eddyem/stm32samples/F0:F030,F042,F072/usbcan_ringbuffer/kicad/stm32.kicad_pcb

## KiCad design F0:F030,F042,F072/usbcan_ringbuffer/kicad/stm32.kicad_pcb (2026-03-06)

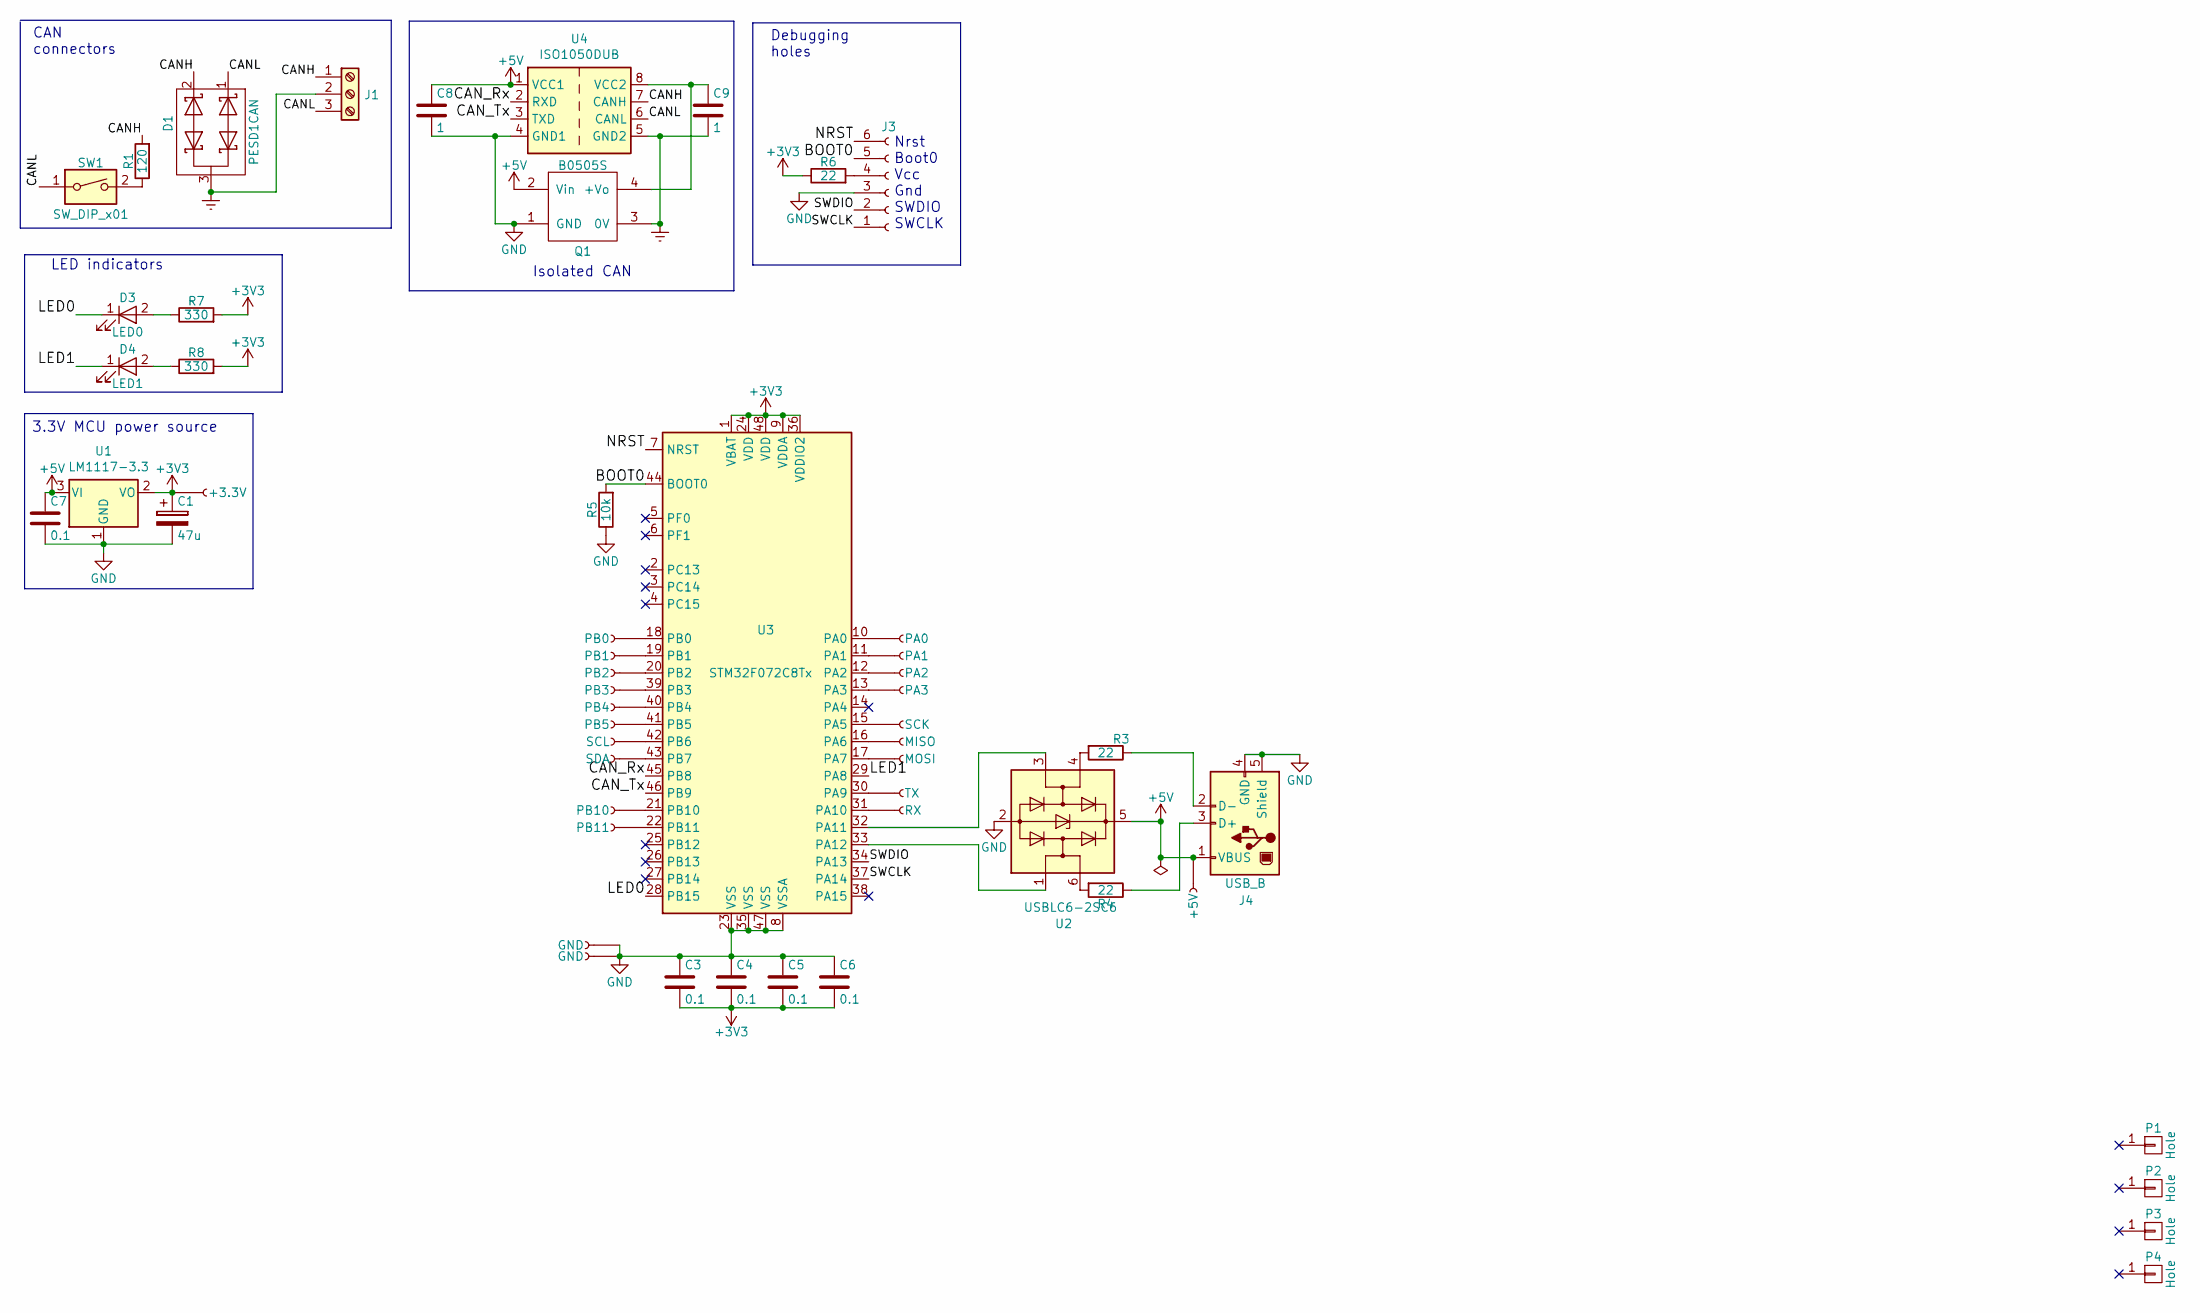
[picture p3: schematic stm32.kicad_sch, STM32F0x2 based USB<>CAN converter (isolated)]

Parts:
C1: 47u; CP_EIA-3216-18_Kemet-A_Pad1.58x1.35mm_HandSolder
C3, C4, C5, C6, C7: 0.1; C_0603_1608Metric_Pad1.05x0.95mm_HandSolder
C8, C9: 1; C_0805_2012Metric_Pad1.15x1.40mm_HandSolder
D1: PESD1CAN; SOT-23
D3: LED0; LED_0805_2012Metric_Pad1.15x1.40mm_HandSolder
D4: LED1; LED_0805_2012Metric_Pad1.15x1.40mm_HandSolder
J1: Screw_Terminal_01x03; TerminalBlock_Phoenix_MKDS-1,5-3_1x03_P5.00mm_Horizontal
J2: SCK; TestPoint_THTPad_1.5x1.5mm_Drill0.7mm
J3: SWDetc; PinHeader_1x06_P1.27mm_Vertical
J4: USB_B; USB_B_Lumberg_2411_02_Horizontal
J5: MISO; TestPoint_THTPad_1.5x1.5mm_Drill0.7mm
J6: MOSI; TestPoint_THTPad_1.5x1.5mm_Drill0.7mm
J7: TX; TestPoint_THTPad_1.5x1.5mm_Drill0.7mm
J8: RX; TestPoint_THTPad_1.5x1.5mm_Drill0.7mm
J9: SCL; TestPoint_THTPad_1.5x1.5mm_Drill0.7mm
J10: SDA; TestPoint_THTPad_1.5x1.5mm_Drill0.7mm
J11: PB0; TestPoint_THTPad_1.5x1.5mm_Drill0.7mm
J12: PB1; TestPoint_THTPad_1.5x1.5mm_Drill0.7mm
J13: PB4; TestPoint_THTPad_1.5x1.5mm_Drill0.7mm
J14: PB5; TestPoint_THTPad_1.5x1.5mm_Drill0.7mm
J15: PB2; TestPoint_THTPad_1.5x1.5mm_Drill0.7mm
J16: PB3; TestPoint_THTPad_1.5x1.5mm_Drill0.7mm
J17, J18: GND; TestPoint_THTPad_1.5x1.5mm_Drill0.7mm
J19: +3.3V; TestPoint_THTPad_1.5x1.5mm_Drill0.7mm
J20: +5V; TestPoint_THTPad_1.5x1.5mm_Drill0.7mm
J21: PA0; TestPoint_THTPad_1.0x1.0mm_Drill0.5mm
J22: PA1; TestPoint_THTPad_1.0x1.0mm_Drill0.5mm
J23: PA2; TestPoint_THTPad_1.0x1.0mm_Drill0.5mm
J24: PA3; TestPoint_THTPad_1.0x1.0mm_Drill0.5mm
J25: PB10; TestPoint_THTPad_1.5x1.5mm_Drill0.7mm
J26: PB11; TestPoint_THTPad_1.5x1.5mm_Drill0.7mm
P1, P2, P3, P4: Hole; Hole_3mm
Q1: B0505S; B0x0xS
R1: 120; R_1210_3225Metric_Pad1.42x2.65mm_HandSolder
R3, R4, R6: 22; R_0603_1608Metric_Pad1.05x0.95mm_HandSolder
R5: 10k; R_0603_1608Metric_Pad1.05x0.95mm_HandSolder
R7, R8: 330; R_0603_1608Metric_Pad1.05x0.95mm_HandSolder
SW1: SW_DIP_x01; SW_DIP_SPSTx01_Slide_6.7x4.1mm_W7.62mm_P2.54mm_LowProfile
U1: LM1117-3.3; SOT-223-3_TabPin2
U2: USBLC6-2SC6; SOT-23-6_Handsoldering
U3: STM32F072C8Tx; LQFP-48_7x7mm_P0.5mm
U4: ISO1050DUB; SOP-8_6.62x9.15mm_P2.54mm

Connections:
+3V3: C1.1, C3.2, C4.2, C5.2, C6.2, J19.1, R6.1, R7.2, R8.2, U1.2 (VO), U3.1 (VBAT), U3.9 (VDDA), U3.24 (VDD), U3.36 (VDDIO2), U3.48 (VDD)
+5V: C7.1, C8.1, J4.1 (VBUS), J20.1, Q1.2 (Vin), U1.3 (VI), U2.5 (VBUS), U4.1 (VCC1)
/BOOT0: J3.5, R5.2, U3.44 (BOOT0)
/CANH: D1.2 (K), J1.1, R1.2, U4.7 (CANH)
/CANL: D1.1 (K), J1.3, SW1.1, U4.6 (CANL)
/CAN_Rx: U3.45 (PB8), U4.2 (RXD)
/CAN_Tx: U3.46 (PB9), U4.3 (TXD)
/LED0: D3.1 (K), U3.28 (PB15)
/LED1: D4.1 (K), U3.29 (PA8)
/NRST: J3.6, U3.7 (NRST)
/SWCLK: J3.1, U3.37 (PA14)
/SWDIO: J3.2, U3.34 (PA13)
Earth: C9.2, D1.3 (O), J1.2, Q1.3 (0V), U4.5 (GND2)
GND: C1.2, C3.1, C4.1, C5.1, C6.1, C7.2, C8.2, J3.3, J4.4 (GND), J4.5 (Shield), J17.1, J18.1, Q1.1 (GND), R5.1, U1.1 (GND), U2.2 (GND), U3.8 (VSSA), U3.23 (VSS), U3.35 (VSS), U3.47 (VSS), U4.4 (GND1)
unnamed: C9.1, Q1.4 (+Vo), U4.8 (VCC2)
unnamed: D3.2 (A), R7.1
unnamed: D4.2 (A), R8.1
unnamed: J2.1, U3.15 (PA5)
unnamed: J3.4, R6.2
unnamed: J4.2 (D-), R3.1
unnamed: J4.3 (D+), R4.1
unnamed: J5.1, U3.16 (PA6)
unnamed: J6.1, U3.17 (PA7)
unnamed: J7.1, U3.30 (PA9)
unnamed: J8.1, U3.31 (PA10)
unnamed: J9.1, U3.42 (PB6)
unnamed: J10.1, U3.43 (PB7)
unnamed: J11.1, U3.18 (PB0)
unnamed: J12.1, U3.19 (PB1)
unnamed: J13.1, U3.40 (PB4)
unnamed: J14.1, U3.41 (PB5)
unnamed: J15.1, U3.20 (PB2)
unnamed: J16.1, U3.39 (PB3)
unnamed: J21.1, U3.10 (PA0)
unnamed: J22.1, U3.11 (PA1)
unnamed: J23.1, U3.12 (PA2)
unnamed: J24.1, U3.13 (PA3)
unnamed: J25.1, U3.21 (PB10)
unnamed: J26.1, U3.22 (PB11)
unnamed: R1.1, SW1.2
unnamed: R3.2, U2.4 (I/O2)
unnamed: R4.2, U2.6 (I/O1)
unnamed: U2.1 (I/O1), U3.33 (PA12)
unnamed: U2.3 (I/O2), U3.32 (PA11)

Notes on the sheet:
LED indicators
Isolated CAN
Debugging holes
3.3V MCU power source
Nrst Boot0 Vcc Gnd SWDIO SWCLK
CAN connectors

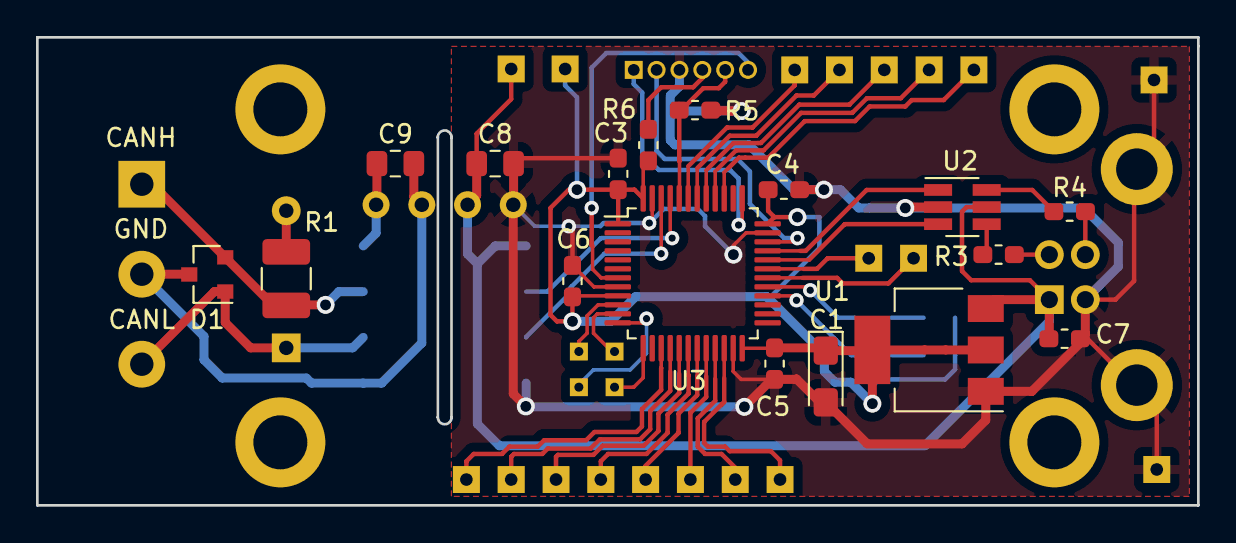
[picture p4: board F0:F030,F042,F072/usbcan_ringbuffer/kicad/stm32.kicad_pcb from above]

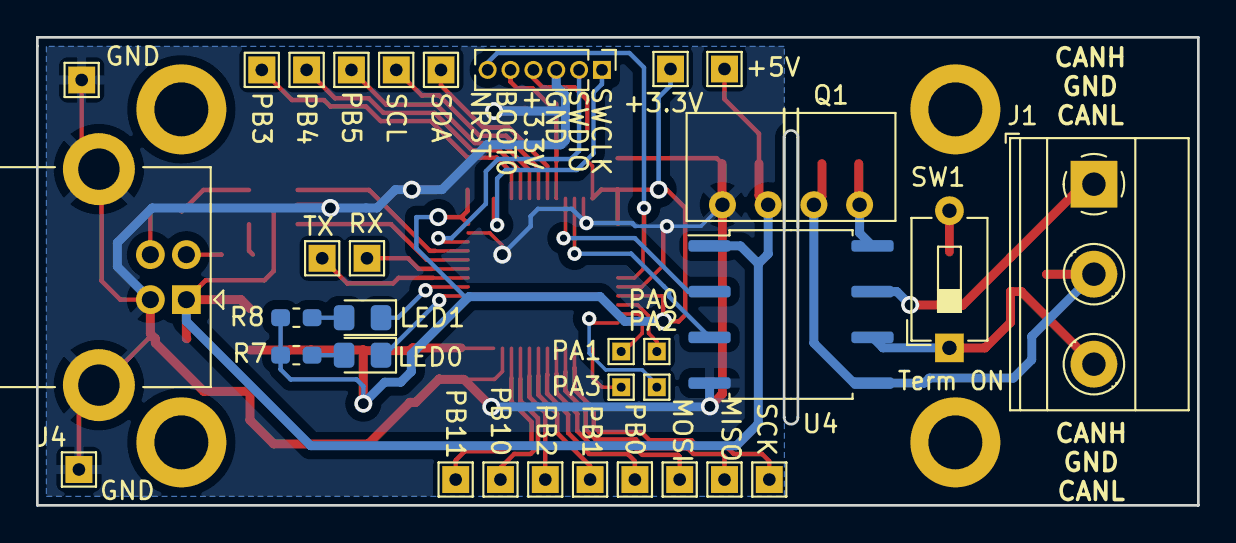
[picture p5: board F0:F030,F042,F072/usbcan_ringbuffer/kicad/stm32.kicad_pcb from below]

Board: 2 copper layers, 64.5 x 26.0 mm, 54 parts (33 on the bottom side), 44 nets.
