eddyem/stm32samples/F3:F303/MLX90640-allsky/kicad/mainboard.kicad_pcb

## KiCad design F3:F303/MLX90640-allsky/kicad/mainboard.kicad_pcb (2025-11-13)

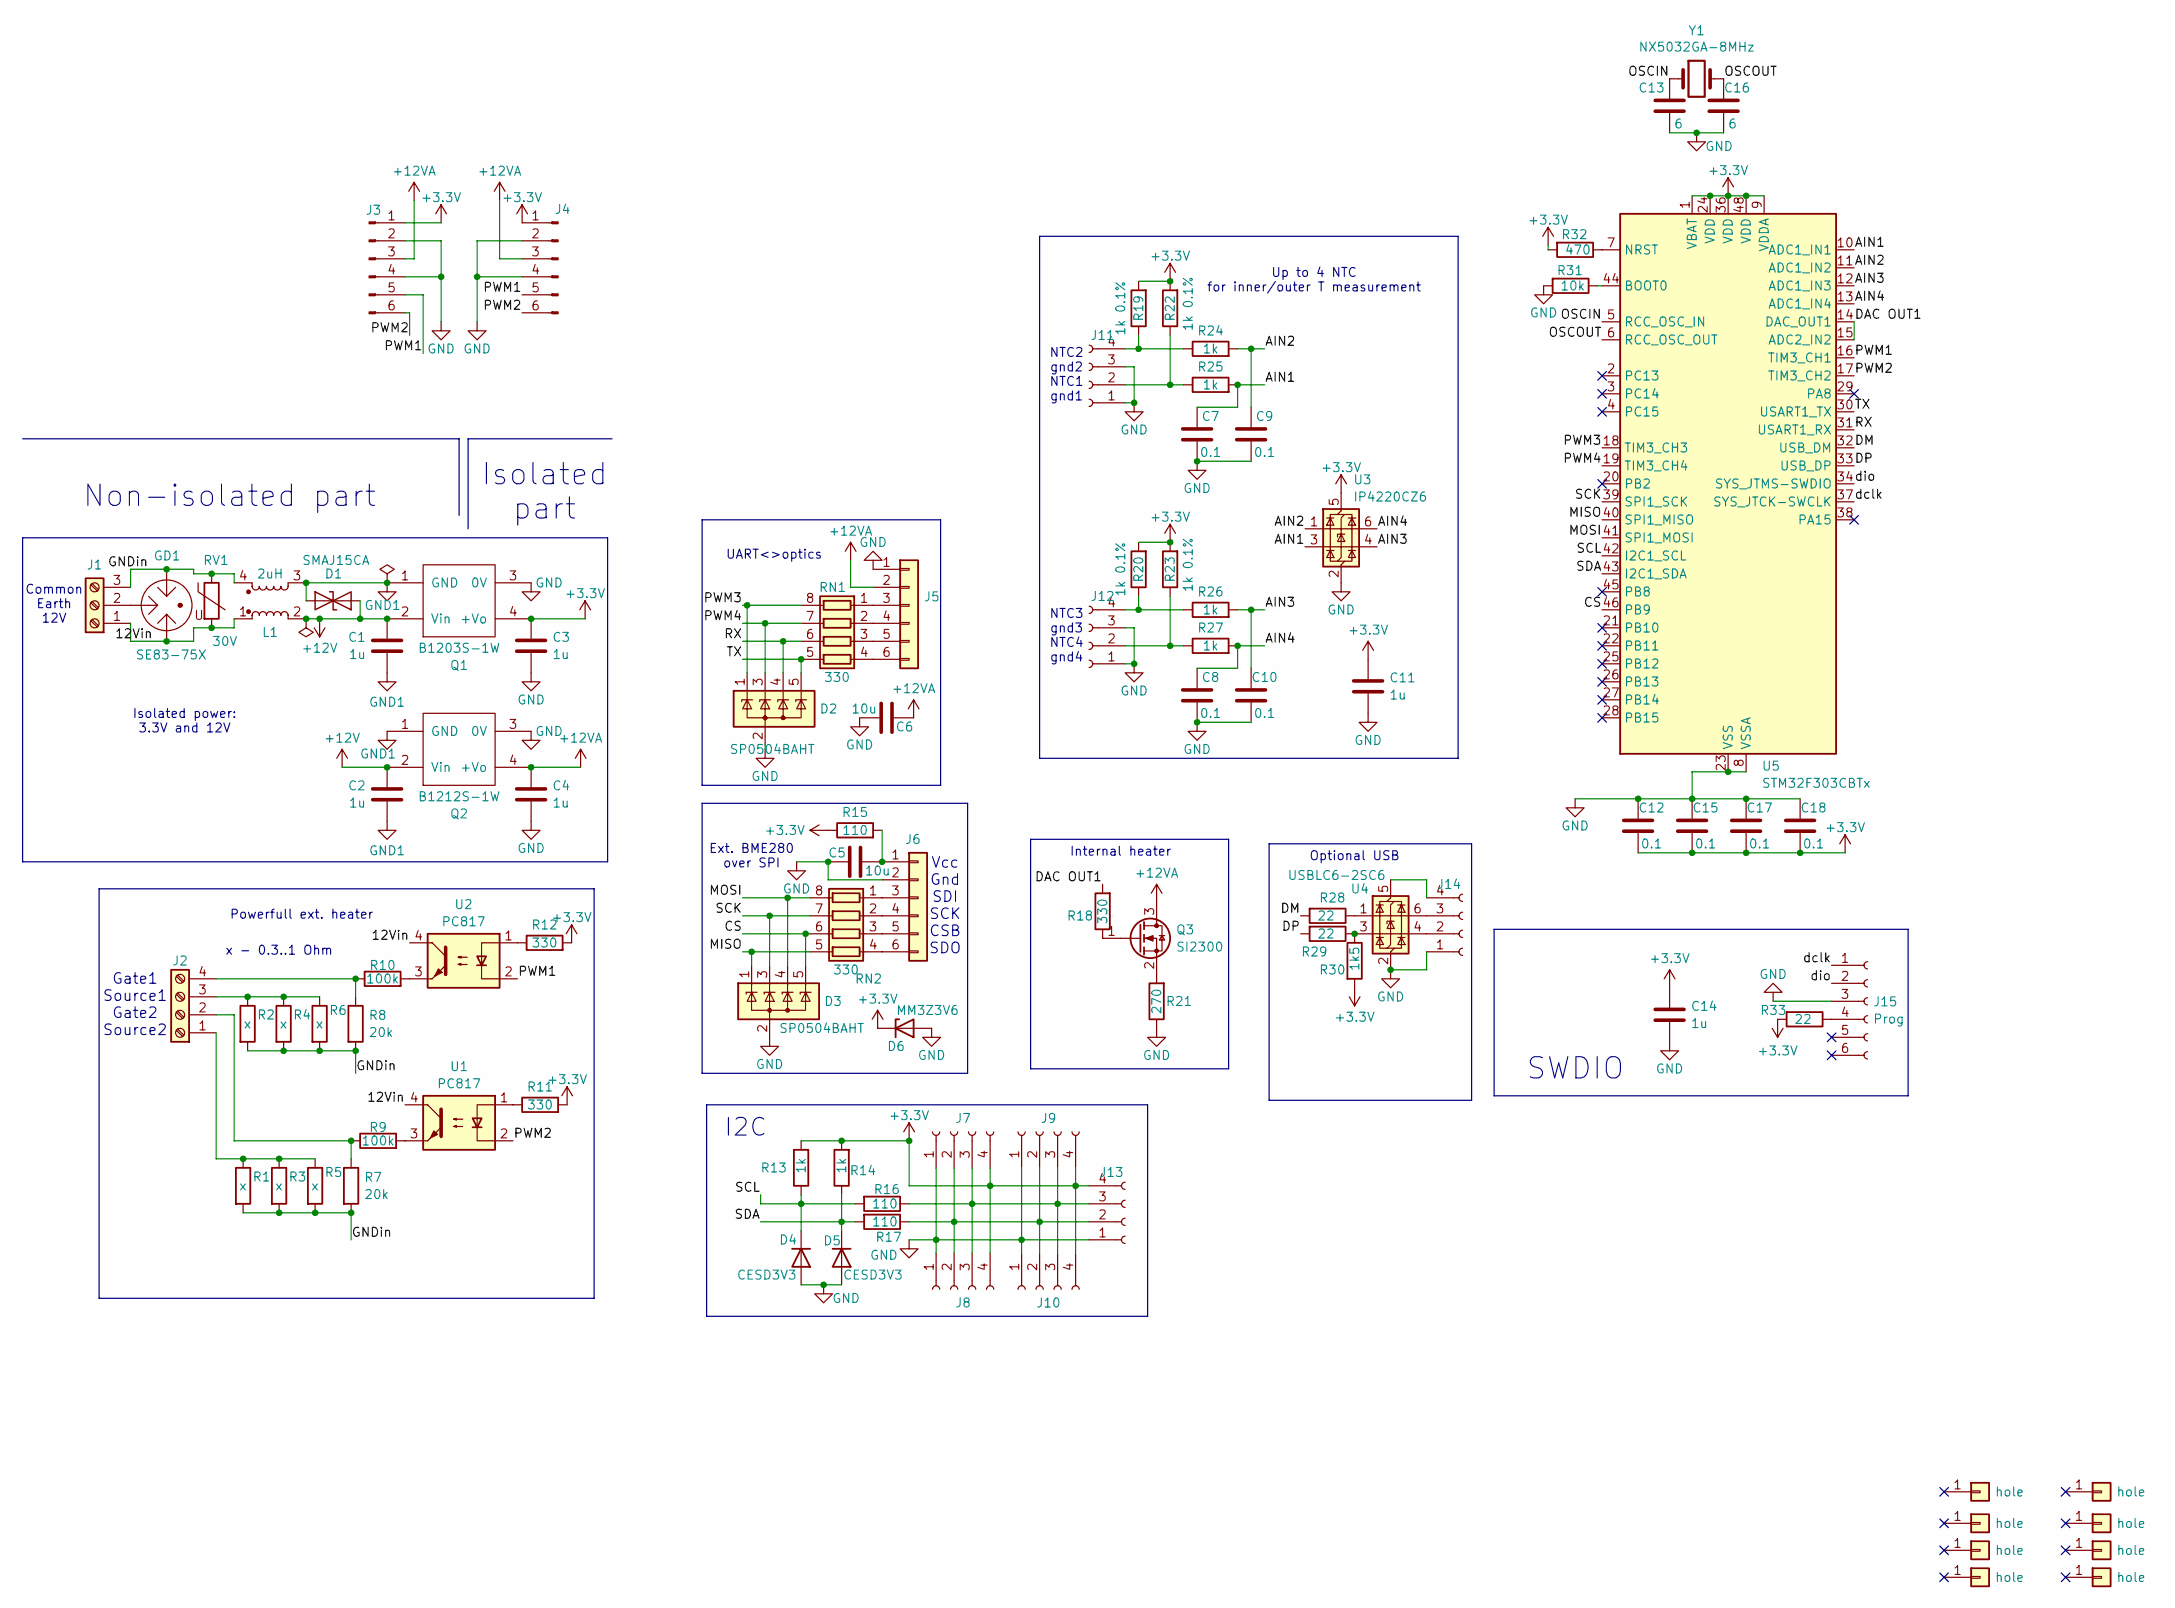
[picture p6: schematic mainboard.kicad_sch]

Parts:
C1, C2, C3, C4, C11, C14: 1u; C_0805_2012Metric_Pad1.18x1.45mm_HandSolder
C5, C6: 10u; C_0805_2012Metric_Pad1.18x1.45mm_HandSolder
C7, C8, C9, C10, C12, C15, C17, C18: 0.1; C_0603_1608Metric_Pad1.08x0.95mm_HandSolder
C13, C16: 6; C_0603_1608Metric_Pad1.08x0.95mm_HandSolder
D1: SMAJ15CA; D_SMA
D2, D3: SP0504BAHT; SOT-23-5
D4, D5: CESD3V3; D_0805_2012Metric_Pad1.15x1.40mm_HandSolder
D6: MM3Z3V6; D_SOD-323F
GD1: SE83-75X; SE83-GDS
J1: Conn_01x03_Pin; TerminalBlock_Phoenix_MKDS-1,5-3_1x03_P5.00mm_Horizontal
J2: Conn_01x03_Pin; TerminalBlock_Phoenix_MKDS-1,5-4_1x04_P5.00mm_Horizontal
J3: Conn_01x04_Pin; PinHeader_1x06_P2.54mm_Vertical
J4: Conn_01x04_Socket; PinHeader_1x06_P2.54mm_Vertical
J5, J6: JST_PH_B6B-PH-K_1x06_P2.00mm_Vertical
J7, J8, J9, J10, J11, J12, J13, J14: Conn_01x04_Socket; JST_PH_B4B-PH-K_1x04_P2.00mm_Vertical
J15: Prog; PinSocket_1x06_P1.27mm_Vertical
J16, J17, J18, J19, J20, J21, J22, J23: hole; MountingHole_3.2mm_M3_ISO14580_Pad_TopBottom
L1: 2uH; L_CommonMode_Wuerth_WE-CMB-S
Q1: B1203S-1W; B0x0xS
Q2: B1212S-1W; B0x0xS
Q3: SI2300; SOT-23_Handsoldering
R1, R2, R3, R4, R5, R6: x; R_2010_5025Metric_Pad1.40x2.65mm_HandSolder
R7, R8: 20k; R_0805_2012Metric_Pad1.20x1.40mm_HandSolder
R9, R10: 100k; R_0805_2012Metric_Pad1.20x1.40mm_HandSolder
R11, R12, R18: 330; R_0603_1608Metric_Pad0.98x0.95mm_HandSolder
R13, R14, R24, R25, R26, R27: 1k; R_0603_1608Metric_Pad0.98x0.95mm_HandSolder
R15, R16, R17: 110; R_0603_1608Metric_Pad0.98x0.95mm_HandSolder
R19, R20, R22, R23: 1k 0.1%; R_0805_2012Metric_Pad1.20x1.40mm_HandSolder
R21: 270; R_0603_1608Metric_Pad0.98x0.95mm_HandSolder
R28, R29, R33: 22; R_0603_1608Metric_Pad0.98x0.95mm_HandSolder
R30: 1k5; R_0603_1608Metric_Pad0.98x0.95mm_HandSolder
R31: 10k; R_0603_1608Metric_Pad0.98x0.95mm_HandSolder
R32: 470; R_0603_1608Metric_Pad0.98x0.95mm_HandSolder
RN1, RN2: 330; R_Array_Convex_4x0603
RV1: 30V; S10K30
U1, U2: PC817; DIP-4_W7.62mm
U3: IP4220CZ6; SOT-23-6
U4: USBLC6-2SC6; SOT-23-6
U5: STM32F303CBTx; LQFP-48_7x7mm_P0.5mm
Y1: NX5032GA-8MHz; Crystal_SMD_5032-2Pin_5.0x3.2mm

Connections:
+3.3V: C3.1, C11.1, C12.1, C14.1, C15.1, C17.1, C18.1, D6.1 (K), J3.1, J4.1, J7.4, J8.4, J9.4, J10.4, J13.4, Q1.4 (+Vo), R11.2, R12.2, R13.2, R14.2, R15.1, R19.2, R20.2, R22.2, R23.2, R30.2, R32.2, R33.2, U3.5 (VBUS), U5.1 (VBAT), U5.9 (VDDA), U5.24 (VDD), U5.36 (VDD), U5.48 (VDD)
+12V: C1.1, C2.1, D1.1 (A1), L1.2, Q1.2 (Vin), Q2.2 (Vin)
+12VA: C4.1, C6.1, J3.3, J4.3, J5.2, Q2.4 (+Vo), Q3.3 (D)
/12Vin: GD1.1, J1.1, L1.1, RV1.2, U1.4, U2.4
/AIN1: C7.2, R25.2, U3.3 (I/O2), U5.10 (ADC1_IN1)
/AIN2: C9.2, R24.2, U3.1 (I/O1), U5.11 (ADC1_IN2)
/AIN3: C10.2, R26.2, U3.4 (I/O2), U5.12 (ADC1_IN3)
/AIN4: C8.2, R27.2, U3.6 (I/O1), U5.13 (ADC1_IN4)
/CS: D3.5 (K), RN2.6 (R3.2), U5.46 (PB9)
/DAC OUT1: R18.2, U5.14 (DAC_OUT1), U5.15 (ADC2_IN2)
/DM: R28.2, U5.32 (USB_DM)
/DP: R29.2, U5.33 (USB_DP)
/GNDin: GD1.3, J1.3, L1.4, R1.2, R2.2, R3.2, R4.2, R5.2, R6.2, R7.2, R8.2, RV1.1
/MISO: D3.1 (K), RN2.5 (R4.2), U5.40 (SPI1_MISO)
/MOSI: D3.4 (K), RN2.8 (R1.2), U5.41 (SPI1_MOSI)
/OSCIN: C13.1, U5.5 (RCC_OSC_IN), Y1.1
/OSCOUT: C16.1, U5.6 (RCC_OSC_OUT), Y1.2
/PWM1: J3.5, J4.5, U2.2, U5.16 (TIM3_CH1)
/PWM2: J3.6, J4.6, U1.2, U5.17 (TIM3_CH2)
/PWM3: D2.1 (K), RN1.8 (R1.2), U5.18 (TIM3_CH3)
/PWM4: D2.3 (K), RN1.7 (R2.2), U5.19 (TIM3_CH4)
/RX: D2.4 (K), RN1.6 (R3.2), U5.31 (USART1_RX)
/SCK: D3.3 (K), RN2.7 (R2.2), U5.39 (SPI1_SCK)
/SCL: D4.1 (K), R13.1, R16.2, U5.42 (I2C1_SCL)
/SDA: D5.1 (K), R14.1, R17.2, U5.43 (I2C1_SDA)
/TX: D2.5 (K), RN1.5 (R4.2), U5.30 (USART1_TX)
/dclk: J15.1, U5.37 (SYS_JTCK-SWCLK)
/dio: J15.2, U5.34 (SYS_JTMS-SWDIO)
GND: C3.2, C4.2, C5.1, C6.2, C7.1, C8.1, C9.1, C10.1, C11.2, C12.2, C13.2, C14.2, C15.2, C16.2, C17.2, C18.2, D2.2 (A), D3.2 (A), D4.2 (A), D5.2 (A), D6.2 (A), J3.2, J3.4, J4.2, J4.4, J5.1, J6.2, J7.1, J8.1, J9.1, J10.1, J11.1, J11.3, J12.1, J12.3, J13.1, J14.1, J15.3, Q1.3 (0V), Q2.3 (0V), R21.1, R31.2, U3.2 (GND), U4.2 (GND), U5.8 (VSSA), U5.23 (VSS), U5.35 (VSS), U5.47 (VSS)
GND1: C1.2, C2.2, D1.2 (A2), L1.3, Q1.1 (GND), Q2.1 (GND)
unnamed: GD1.2, J1.2
unnamed: J2.1, R1.1, R3.1, R5.1
unnamed: J2.2, R7.1, R9.1
unnamed: J2.3, R2.1, R4.1, R6.1
unnamed: J2.4, R8.1, R10.1
unnamed: J5.3, RN1.1 (R1.1)
unnamed: J5.4, RN1.2 (R2.1)
unnamed: J5.5, RN1.3 (R3.1)
unnamed: J5.6, RN1.4 (R4.1)
unnamed: C5.2, J6.1, R15.2
unnamed: J6.3, RN2.1 (R1.1)
unnamed: J6.4, RN2.2 (R2.1)
unnamed: J6.5, RN2.3 (R3.1)
unnamed: J6.6, RN2.4 (R4.1)
unnamed: J7.2, J8.2, J9.2, J10.2, J13.2, R17.1
unnamed: J7.3, J8.3, J9.3, J10.3, J13.3, R16.1
unnamed: J11.2, R22.1, R25.1
unnamed: J11.4, R19.1, R24.1
unnamed: J12.2, R23.1, R27.1
unnamed: J12.4, R20.1, R26.1
unnamed: J14.2, U4.4 (I/O2)
unnamed: J14.3, U4.6 (I/O1)
unnamed: J14.4, U4.5 (VBUS)
unnamed: J15.4, R33.1
unnamed: Q3.1 (G), R18.1
unnamed: Q3.2 (S), R21.2
unnamed: R9.2, U1.3
unnamed: R10.2, U2.3
unnamed: R11.1, U1.1
unnamed: R12.1, U2.1
unnamed: R28.1, U4.1 (I/O1)
unnamed: R29.1, R30.1, U4.3 (I/O2)
unnamed: R31.1, U5.44 (BOOT0)
unnamed: R32.1, U5.7 (NRST)

Notes on the sheet:
Isolated power: 3.3V and 12V
x - 0.3..1 Ohm
NTC2 gnd2 NTC1 gnd1
Ext. BME280 over SPI
Powerfull ext. heater
Optional USB
Up to 4 NTC for inner/outer T measurement
Isolated part
I2C
Non-isolated part
Internal heater
Common Earth 12V
NTC3 gnd3 NTC4 gnd4
SWDIO
UART<>optics
Gate1 Source1 Gate2 Source2
Vcc Gnd SDI SCK CSB SDO

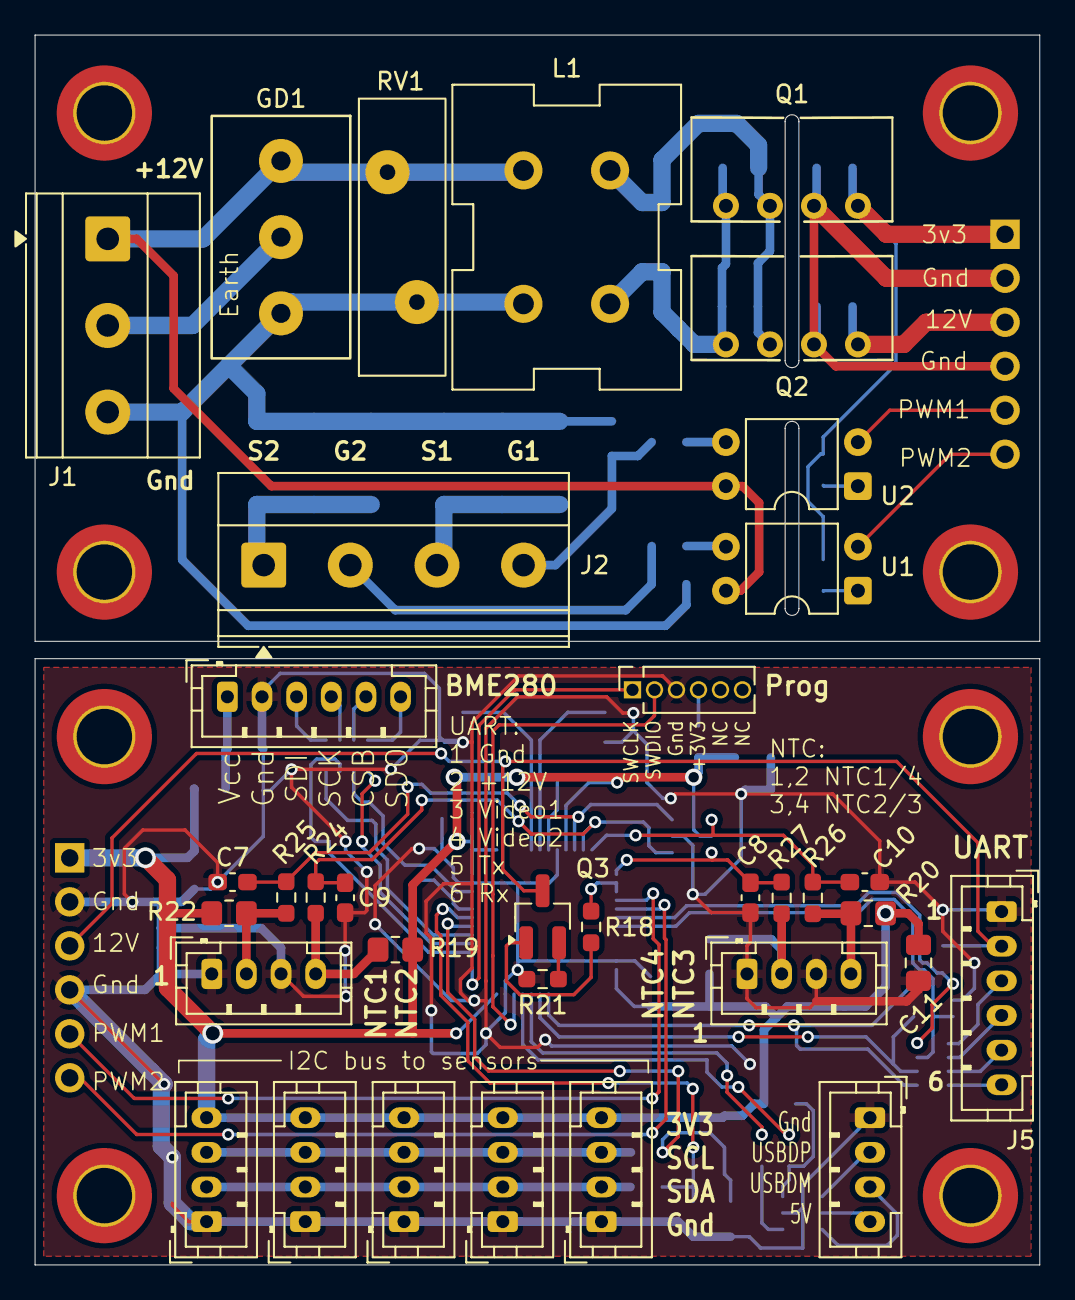
[picture p7: board mainboard.kicad_pcb from above]

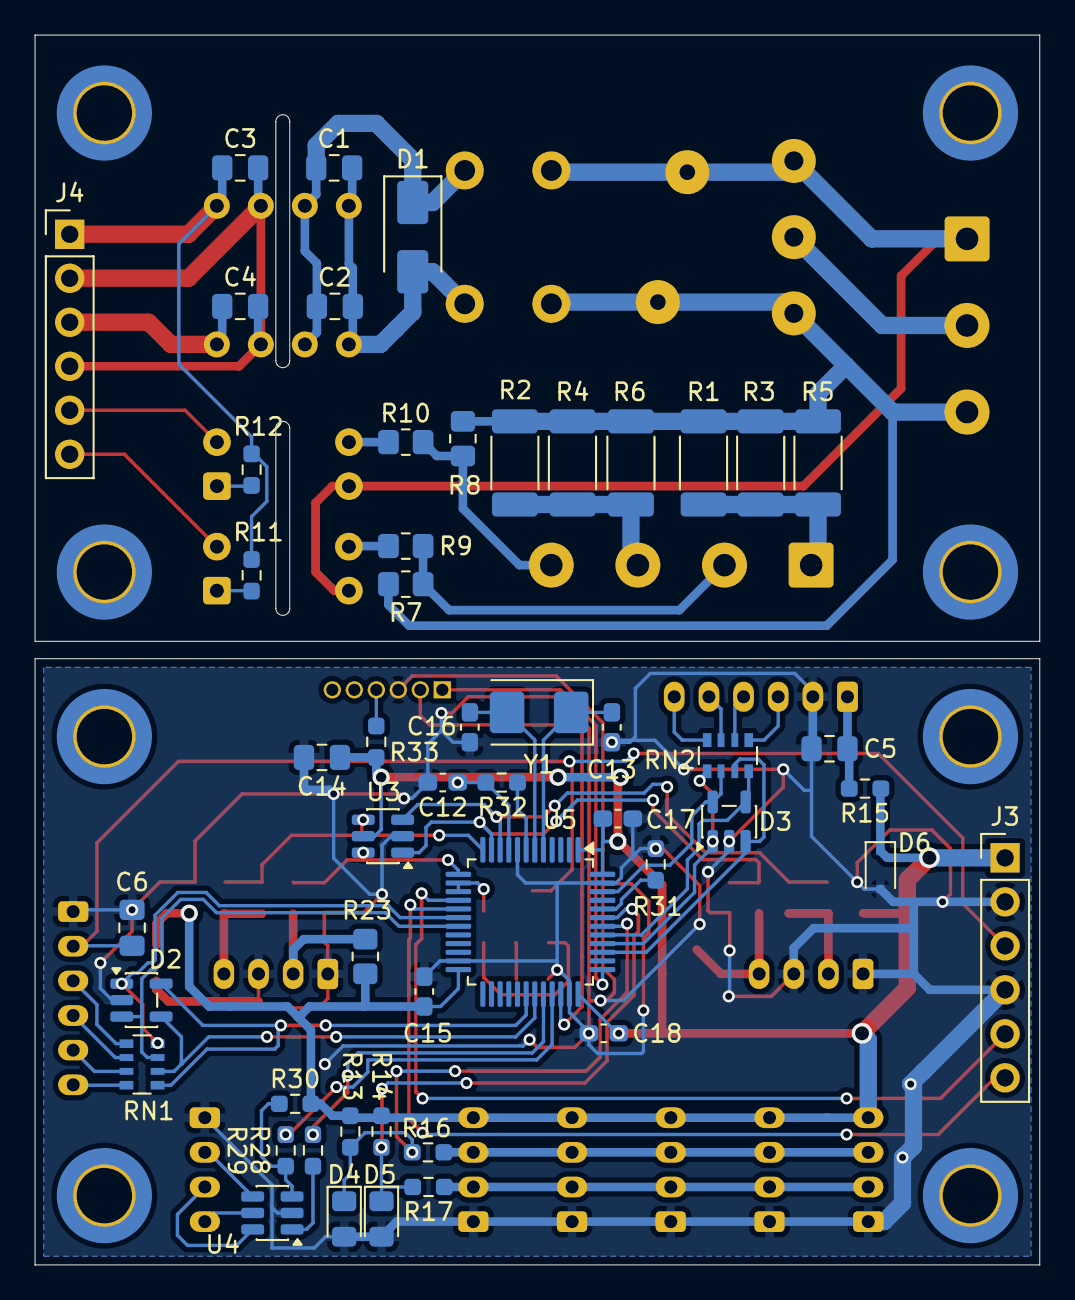
[picture p8: board mainboard.kicad_pcb from below]

Board: 2 copper layers, 58.0 x 71.0 mm, 94 parts (51 on the bottom side), 64 nets.
