eddyem/stm32samples/F1:F103/BISS_C_encoders/kicad/encoder.kicad_pcb

## KiCad design F1:F103/BISS_C_encoders/kicad/encoder.kicad_pcb (2025-04-04)

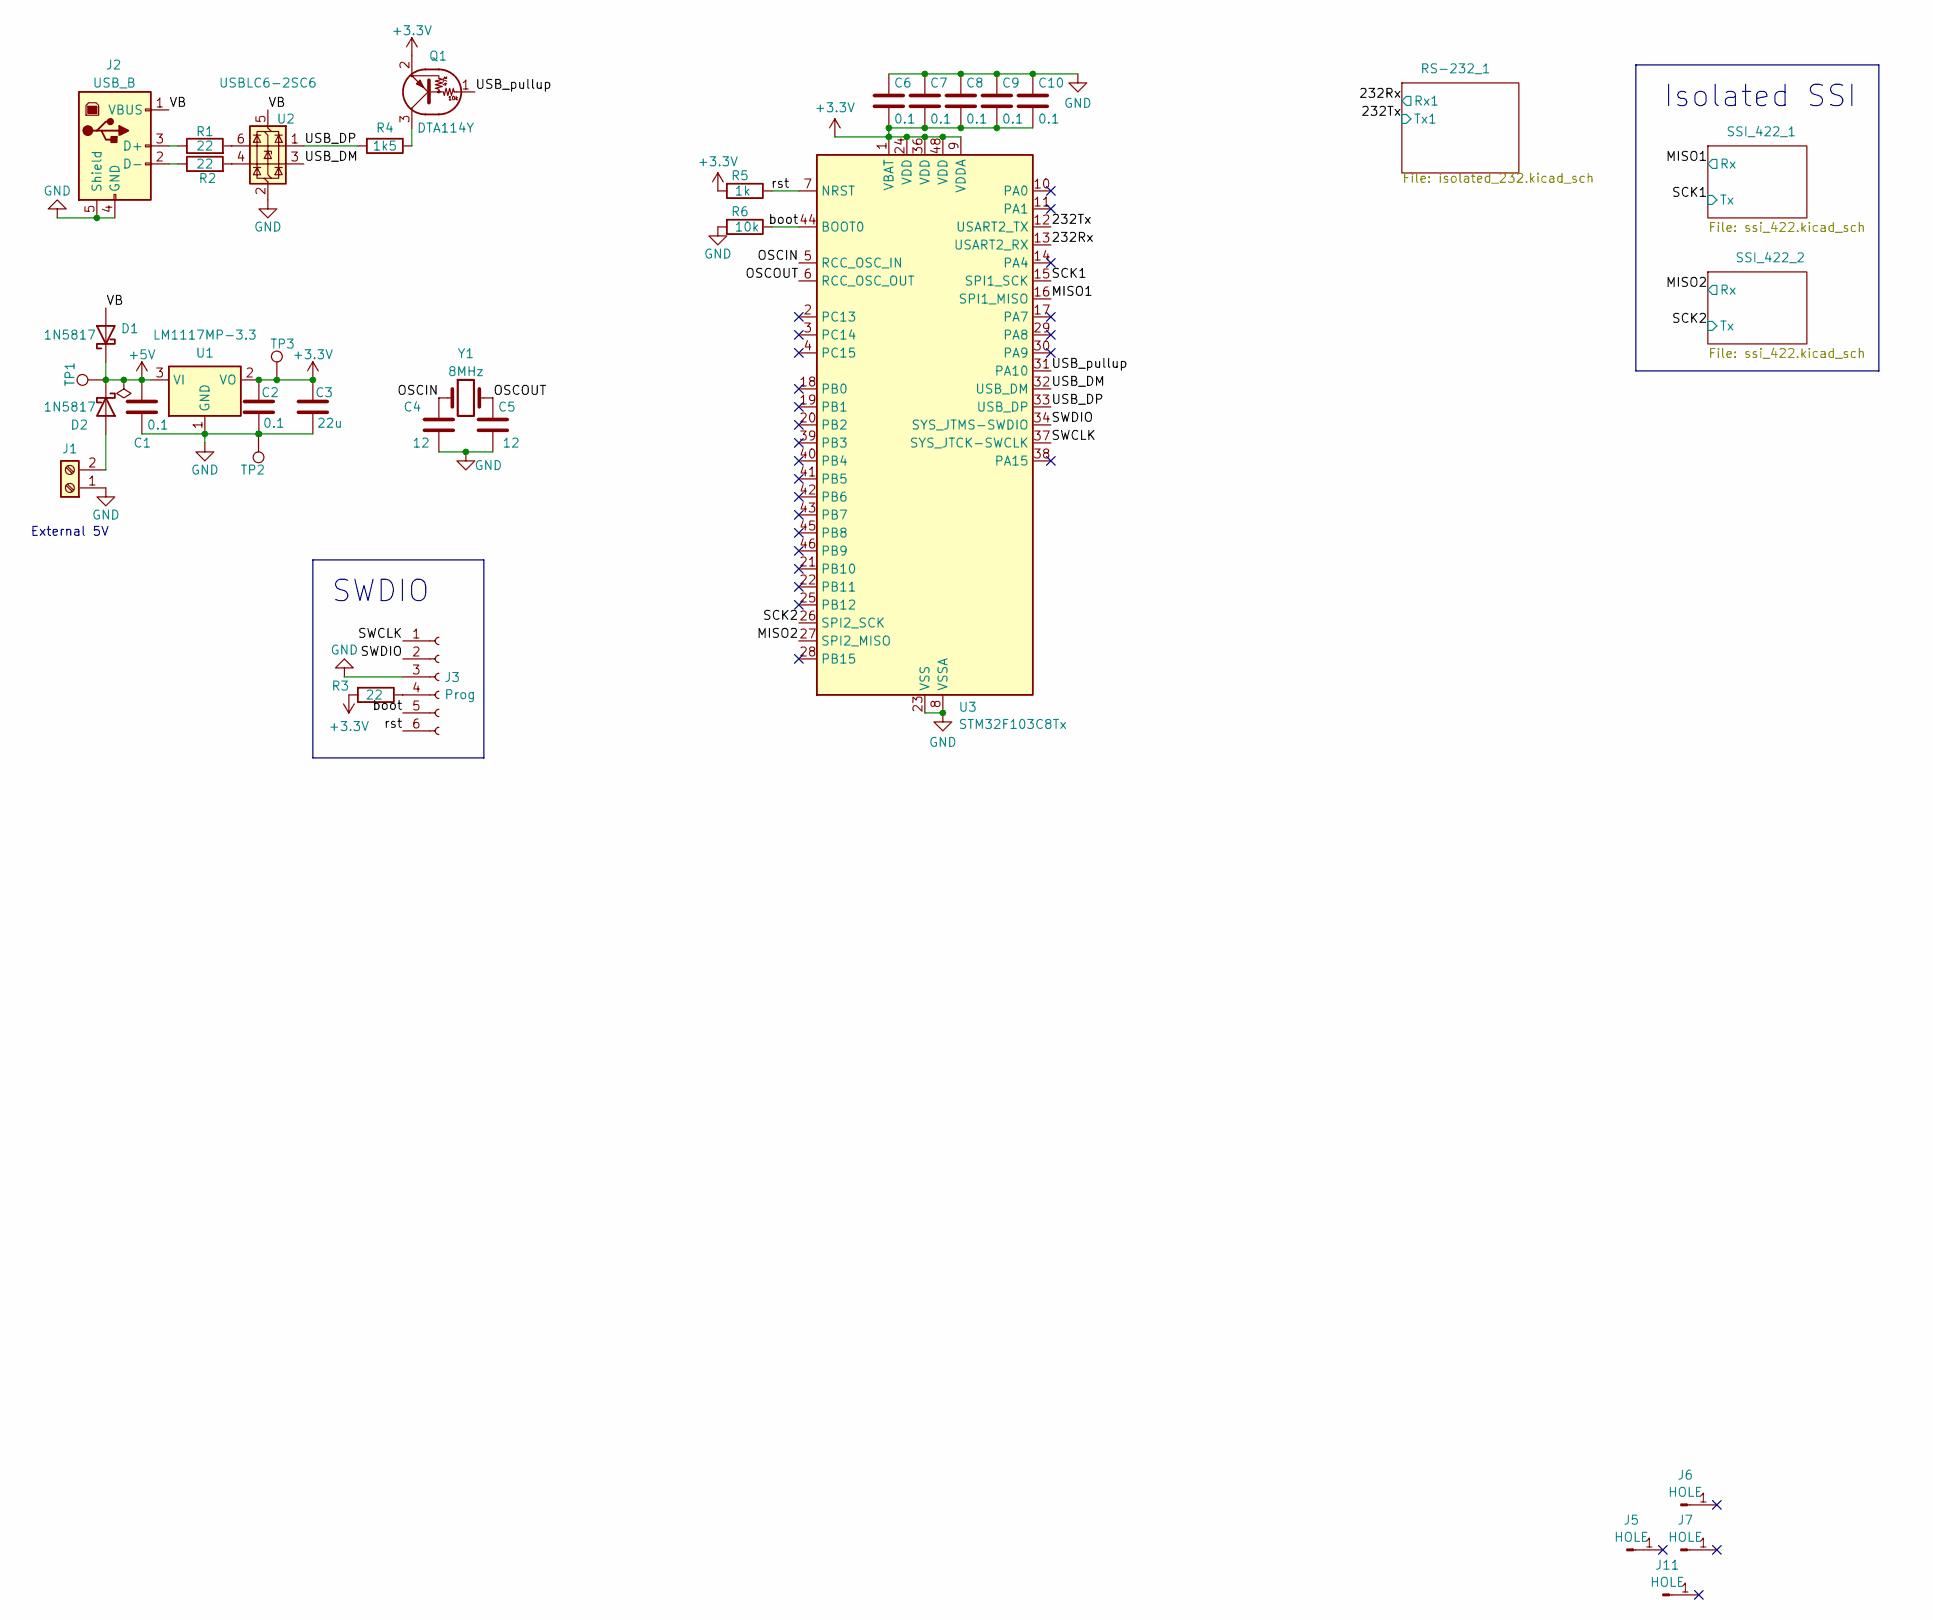
[picture p9: schematic encoder.kicad_sch]

Parts:
C1, C2, C6, C7, C8, C9, C10: 0.1; C_0603_1608Metric_Pad1.08x0.95mm_HandSolder
C3: 22u; C_0805_2012Metric_Pad1.18x1.45mm_HandSolder
C4, C5: 12; C_0603_1608Metric_Pad1.08x0.95mm_HandSolder
D1, D2: 1N5817; D_SMA-SMB_Universal_Handsoldering
J1: Screw_Terminal_01x02; TerminalBlock_Phoenix_MKDS-1,5-2_1x02_P5.00mm_Horizontal
J2: USB_B; USB_B_OST_USB-B1HSxx_Horizontal
J3: Prog; PinSocket_1x06_P1.27mm_Vertical
J5, J6, J7, J11: HOLE; MountingHole_3.2mm_M3
Q1: DTA114Y; SOT-323_SC-70_Handsoldering
R1, R2, R3: 22; R_0603_1608Metric_Pad0.98x0.95mm_HandSolder
R4: 1k5; R_0603_1608Metric_Pad0.98x0.95mm_HandSolder
R5: 1k; R_0603_1608Metric_Pad0.98x0.95mm_HandSolder
R6: 10k; R_0603_1608Metric_Pad0.98x0.95mm_HandSolder
TP1, TP2, TP3: 3.3V; TestPoint_Loop_D2.54mm_Drill1.5mm_Beaded
U1: LM1117MP-3.3; SOT-223-3_TabPin2
U2: USBLC6-2SC6; SOT-23-6
U3: STM32F103C8Tx; LQFP-48_7x7mm_P0.5mm
Y1: 8MHz; Crystal_HC49-U_Vertical

Connections:
+3.3V: C2.1, C3.1, C6.2, C7.2, C8.2, C9.2, C10.2, Q1.2 (E), R3.2, R5.2, TP3.1, U1.2 (VO), U3.1 (VBAT), U3.9 (VDDA), U3.24 (VDD), U3.36 (VDD), U3.48 (VDD)
+5V: C1.1, D1.1 (K), D2.1 (K), TP1.1, U1.3 (VI); also elsewhere on the board
/232Rx: U3.13 (USART2_RX); also elsewhere on the board
/232Tx: U3.12 (USART2_TX); also elsewhere on the board
/MISO1: U3.16 (SPI1_MISO); also elsewhere on the board
/MISO2: U3.27 (SPI2_MISO); also elsewhere on the board
/OSCIN: C4.1, U3.5 (RCC_OSC_IN), Y1.1
/OSCOUT: C5.1, U3.6 (RCC_OSC_OUT), Y1.2
/SCK1: U3.15 (SPI1_SCK); also elsewhere on the board
/SCK2: U3.26 (SPI2_SCK); also elsewhere on the board
/SWCLK: J3.1, U3.37 (SYS_JTCK-SWCLK)
/SWDIO: J3.2, U3.34 (SYS_JTMS-SWDIO)
/USB_DM: U2.3 (I/O2), U3.32 (USB_DM)
/USB_DP: R4.2, U2.1 (I/O1), U3.33 (USB_DP)
/USB_pullup: Q1.1 (B), U3.31 (PA10)
/VB: D1.2 (A), J2.1 (VBUS), U2.5 (VBUS)
/boot: J3.5, R6.1, U3.44 (BOOT0)
/rst: J3.6, R5.1, U3.7 (NRST)
GND: C1.2, C2.2, C3.2, C4.2, C5.2, C6.1, C7.1, C8.1, C9.1, C10.1, J1.1, J2.4 (GND), J2.5 (Shield), J3.3, R6.2, TP2.1, U1.1 (GND), U2.2 (GND), U3.8 (VSSA), U3.23 (VSS), U3.35 (VSS), U3.47 (VSS); also elsewhere on the board
unnamed: D2.2 (A), J1.2
unnamed: J2.3 (D+), R1.1
unnamed: J2.2 (D-), R2.1
unnamed: J3.4, R3.1
unnamed: Q1.3 (C), R4.1
unnamed: R1.2, U2.6 (I/O1)
unnamed: R2.2, U2.4 (I/O2)

Notes on the sheet:
SWDIO
Isolated SSI
External 5V

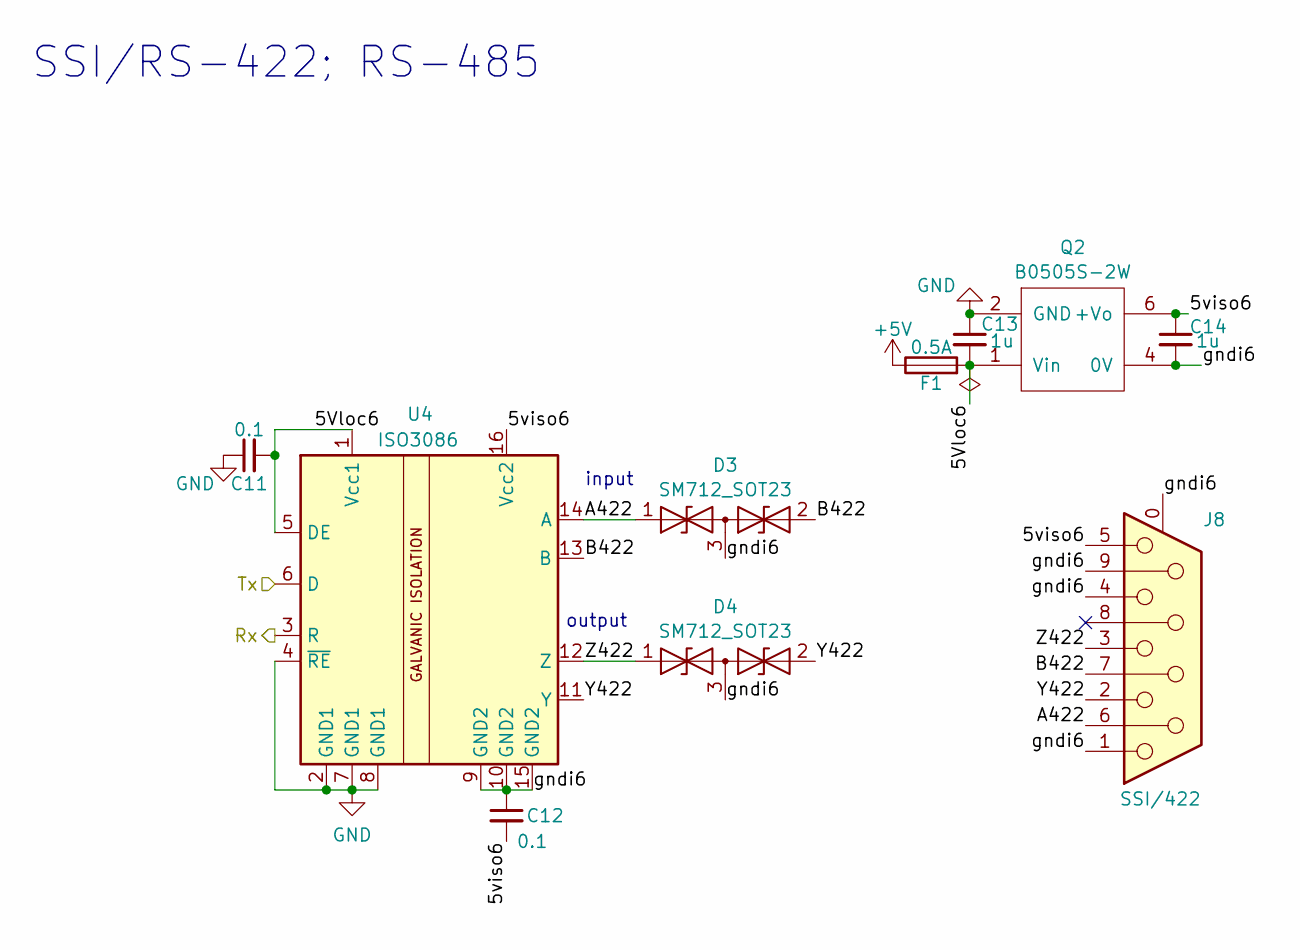
[picture p10: schematic ssi_422.kicad_sch]

Parts:
C11, C12: 0.1; C_0603_1608Metric_Pad1.08x0.95mm_HandSolder
C13, C14: 1u; C_0805_2012Metric_Pad1.18x1.45mm_HandSolder
D3, D4: SM712_SOT23; SOT-23
F1: 0.5A; Fuse_1206_3216Metric
J8: SSI/422; DSUB-9_Female_Horizontal_P2.77x2.84mm_EdgePinOffset4.94mm_H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
Q2: B0505S-2W
U4: ISO3086; SOIC-16W_7.5x10.3mm_P1.27mm

Connections:
+5V: F1.1; also elsewhere on the board
/MISO2: U4.3 (R); also elsewhere on the board
/SCK2: U4.6 (D); also elsewhere on the board
/SSI_422_2/5Vloc6: C11.2, C13.2, F1.2, Q2.1 (Vin), U4.1 (Vcc1), U4.5 (DE)
/SSI_422_2/5viso6: C12.2, C14.1, J8.5, Q2.6 (+Vo), U4.16 (Vcc2)
/SSI_422_2/A422: D3.1 (A1), J8.6, U4.14 (A)
/SSI_422_2/B422: D3.2 (A2), J8.7, U4.13 (B)
/SSI_422_2/Y422: D4.2 (A2), J8.2, U4.11 (Y)
/SSI_422_2/Z422: D4.1 (A1), J8.3, U4.12 (Z)
/SSI_422_2/gndi6: C12.1, C14.2, D3.3 (common), D4.3 (common), J8.0 (PAD), J8.1, J8.4, J8.9, Q2.4 (0V), U4.9 (GND2), U4.10 (GND2), U4.15 (GND2)
GND: C11.1, C13.1, Q2.2 (GND), U4.2 (GND1), U4.4 (~RE), U4.7 (GND1), U4.8 (GND1); also elsewhere on the board

Parts of its further copies:
C20, C21: 0.1; C_0603_1608Metric_Pad1.08x0.95mm_HandSolder
C22, C23: 1u; C_0805_2012Metric_Pad1.18x1.45mm_HandSolder
D8, D9: SM712_SOT23; SOT-23
F2: 0.5A; Fuse_1206_3216Metric
J10: SSI/422; DSUB-9_Female_Horizontal_P2.77x2.84mm_EdgePinOffset4.94mm_H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
Q3: B0505S-2W
U6: ISO3086; SOIC-16W_7.5x10.3mm_P1.27mm

Connections of its further copies:
+5V: F2.1; also elsewhere on the board
/MISO1: U6.3 (R); also elsewhere on the board
/SCK1: U6.6 (D); also elsewhere on the board
/SSI_422_1/5Vloc6: C20.2, C22.2, F2.2, Q3.1 (Vin), U6.1 (Vcc1), U6.5 (DE)
/SSI_422_1/5viso6: C21.2, C23.1, J10.5, Q3.6 (+Vo), U6.16 (Vcc2)
/SSI_422_1/A422: D8.1 (A1), J10.6, U6.14 (A)
/SSI_422_1/B422: D8.2 (A2), J10.7, U6.13 (B)
/SSI_422_1/Y422: D9.2 (A2), J10.2, U6.11 (Y)
/SSI_422_1/Z422: D9.1 (A1), J10.3, U6.12 (Z)
/SSI_422_1/gndi6: C21.1, C23.2, D8.3 (common), D9.3 (common), J10.0 (PAD), J10.1, J10.4, J10.9, Q3.4 (0V), U6.9 (GND2), U6.10 (GND2), U6.15 (GND2)
GND: C20.1, C22.1, Q3.2 (GND), U6.2 (GND1), U6.4 (~RE), U6.7 (GND1), U6.8 (GND1); also elsewhere on the board

Notes on the sheet:
SSI/RS-422; RS-485
input
output

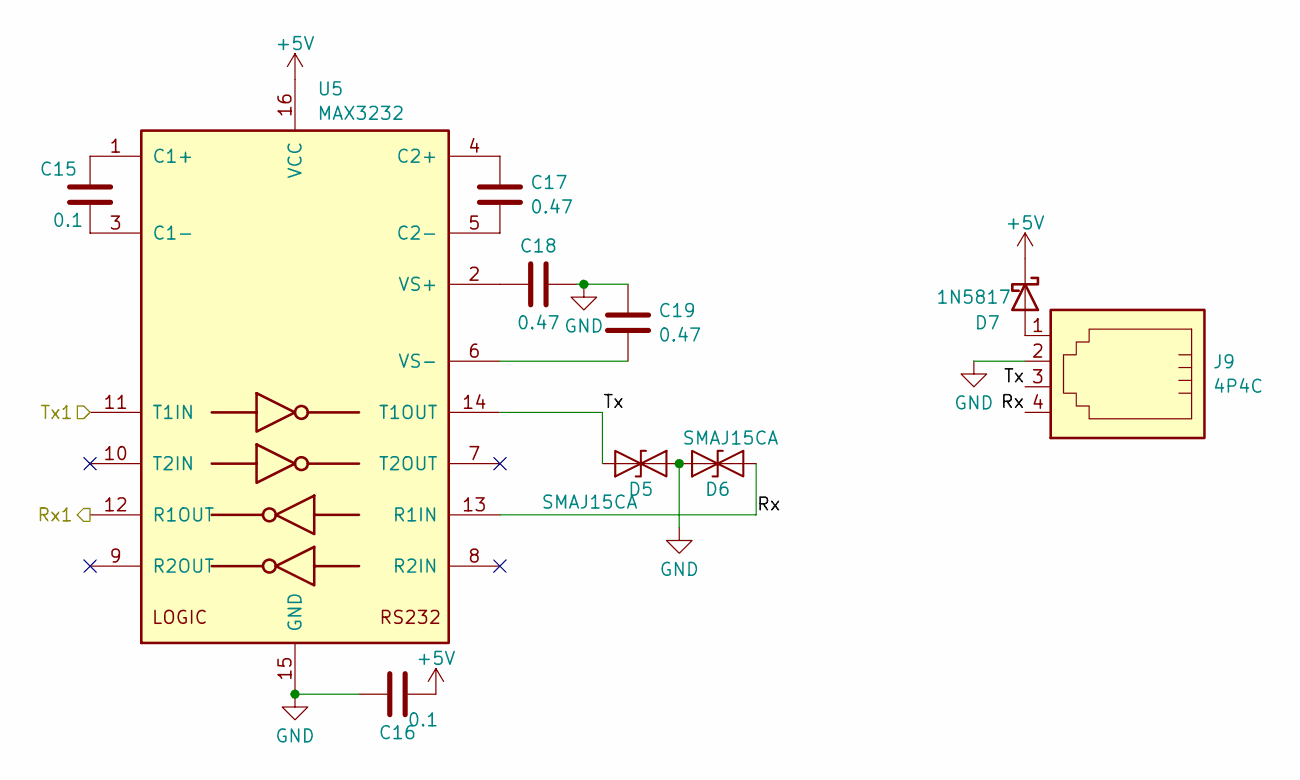
[picture p11: schematic isolated_232.kicad_sch]

Parts:
C15, C16: 0.1; C_0603_1608Metric_Pad1.08x0.95mm_HandSolder
C17, C18, C19: 0.47; C_0805_2012Metric_Pad1.18x1.45mm_HandSolder
D5, D6: SMAJ15CA; D_SMA
D7: 1N5817; D_SMA-SMB_Universal_Handsoldering
J9: 4P4C; RJ9_Evercom_5301-440xxx_Horizontal
U5: MAX3232; SOIC-16_3.9x9.9mm_P1.27mm

Connections:
+5V: C16.1, D7.1 (K), U5.16 (VCC); also elsewhere on the board
/232Rx: U5.12 (R1OUT); also elsewhere on the board
/232Tx: U5.11 (T1IN); also elsewhere on the board
/RS-232_1/Rx: D6.1 (A1), J9.4, U5.13 (R1IN)
/RS-232_1/Tx: D5.2 (A2), J9.3, U5.14 (T1OUT)
GND: C16.2, C18.2, C19.1, D5.1 (A1), D6.2 (A2), J9.2, U5.15 (GND); also elsewhere on the board
unnamed: D7.2 (A), J9.1
unnamed: C15.1, U5.1 (C1+)
unnamed: C15.2, U5.3 (C1-)
unnamed: C17.1, U5.4 (C2+)
unnamed: C17.2, U5.5 (C2-)
unnamed: C18.1, U5.2 (VS+)
unnamed: C19.2, U5.6 (VS-)

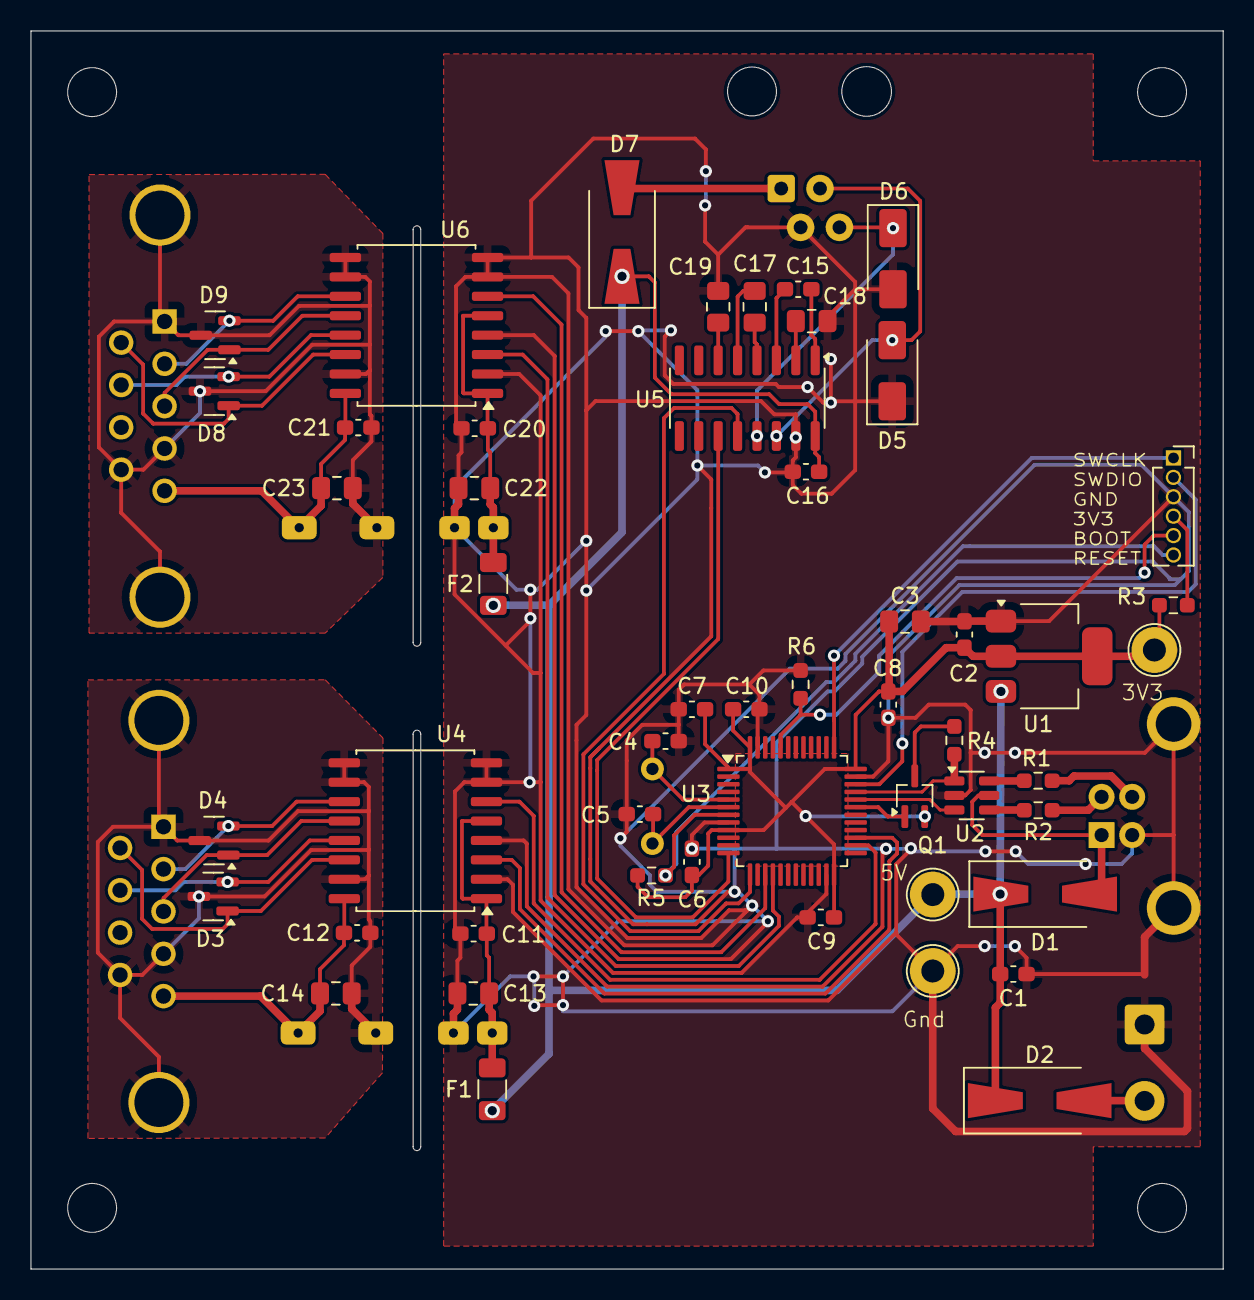
[picture p12: board encoder.kicad_pcb from above]

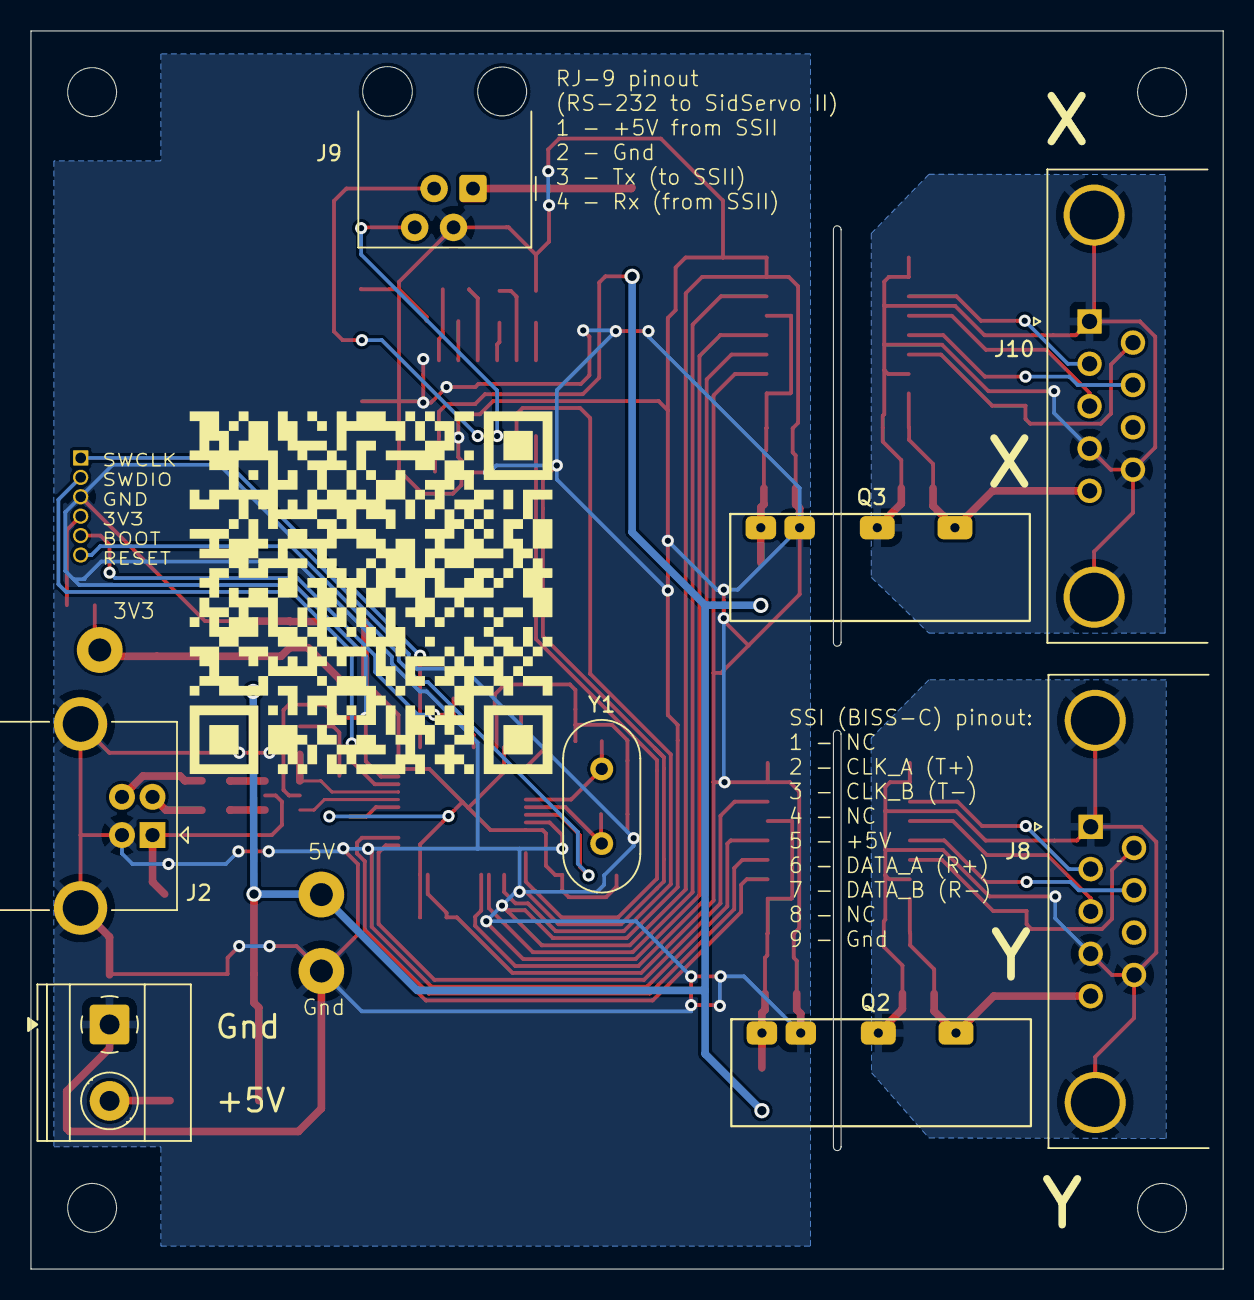
[picture p13: board encoder.kicad_pcb from below]

Board: 2 copper layers, 78.0 x 81.0 mm, 63 parts (8 on the bottom side), 49 nets.
