eddyem/stm32samples/F3:F303/InterfaceBoard/kicad/many485.kicad_pcb

## KiCad design F3:F303/InterfaceBoard/kicad/many485.kicad_pcb (2025-03-21)

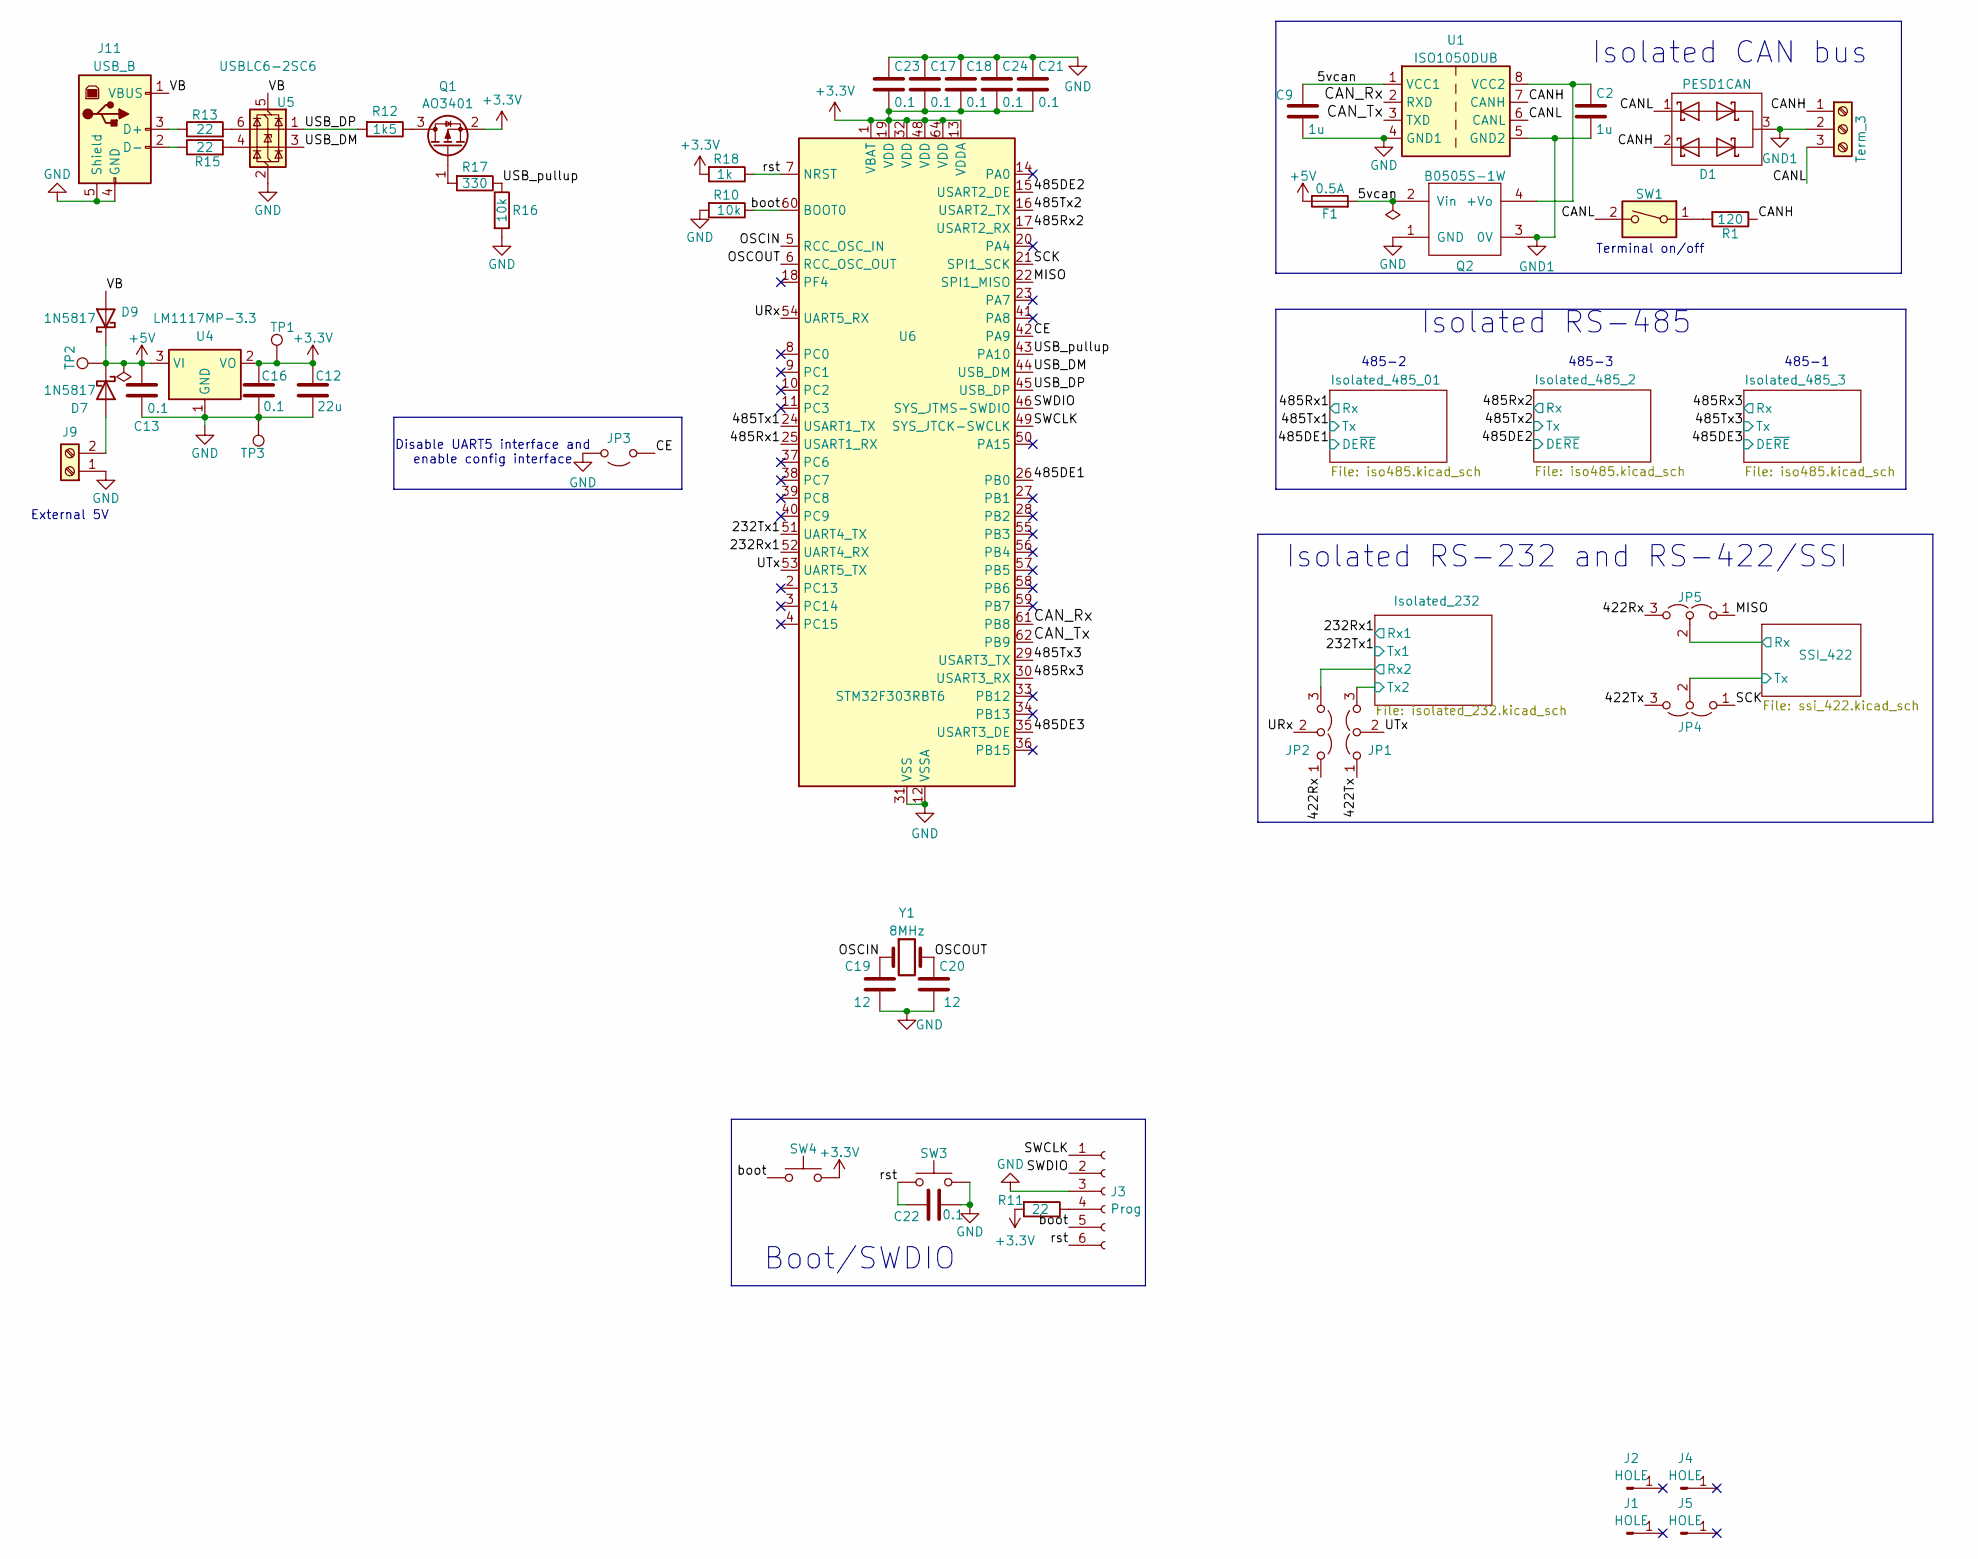
[picture p14: schematic many485.kicad_sch]

Parts:
C2, C9: 1u; C_0805_2012Metric_Pad1.18x1.45mm_HandSolder
C12: 22u; C_0805_2012Metric_Pad1.18x1.45mm_HandSolder
C13, C16, C17, C18, C21, C22, C23, C24: 0.1; C_0603_1608Metric_Pad1.08x0.95mm_HandSolder
C19, C20: 12; C_0603_1608Metric_Pad1.08x0.95mm_HandSolder
D1: PESD1CAN; SOT-23
D7, D9: 1N5817; D_SMA-SMB_Universal_Handsoldering
F1: 0.5A; Fuse_1206_3216Metric
J1, J2, J4, J5: HOLE; MountingHole_3.2mm_M3
J3: Prog; PinSocket_1x06_P1.27mm_Vertical
J8: Term_3; TerminalBlock_Phoenix_MKDS-1,5-3_1x03_P5.00mm_Horizontal
J9: Screw_Terminal_01x02; TerminalBlock_Phoenix_MKDS-1,5-2_1x02_P5.00mm_Horizontal
J11: USB_B; USB_B_OST_USB-B1HSxx_Horizontal
JP1, JP2, JP4, JP5: Jumper_3_Open; PinHeader_1x03_P2.54mm_Vertical
JP3: Jumper_2_Open; PinHeader_1x02_P2.54mm_Vertical
Q1: AO3401; SOT-23_Handsoldering
Q2: B0505S-1W; B0x0xS
R1: 120; R_1210_3225Metric_Pad1.30x2.65mm_HandSolder
R10, R16: 10k; R_0603_1608Metric_Pad0.98x0.95mm_HandSolder
R11, R13, R15: 22; R_0603_1608Metric_Pad0.98x0.95mm_HandSolder
R12: 1k5; R_0603_1608Metric_Pad0.98x0.95mm_HandSolder
R17: 330; R_0603_1608Metric_Pad0.98x0.95mm_HandSolder
R18: 1k; R_0603_1608Metric_Pad0.98x0.95mm_HandSolder
SW1: SW_DIP_x01; SW_DIP_SPSTx01_Slide_6.7x4.1mm_W7.62mm_P2.54mm_LowProfile
SW3, SW4: SW_Push; SW_SPST_FSMSM
TP1, TP2, TP3: 3.3V; TestPoint_Loop_D2.54mm_Drill1.5mm_Beaded
U1: ISO1050DUB; SOP-8_6.62x9.15mm_P2.54mm
U4: LM1117MP-3.3; SOT-223-3_TabPin2
U5: USBLC6-2SC6; SOT-23-6
U6: STM32F303RBT6; LQFP-64_10x10mm_P0.5mm
Y1: 8MHz; Crystal_HC49-U_Vertical

Connections:
+3.3V: C12.1, C16.1, C17.2, C18.2, C21.2, C23.2, C24.2, Q1.2 (S), R11.2, R18.2, SW4.2, TP1.1, U4.2 (VO), U6.1 (VBAT), U6.13 (VDDA), U6.19 (VDD), U6.32 (VDD), U6.48 (VDD), U6.64 (VDD)
+5V: C13.1, D7.1 (K), D9.1 (K), F1.1, TP2.1, U4.3 (VI); also elsewhere on the board
/5vcan: C9.1, F1.2, Q2.2 (Vin), U1.1 (VCC1)
/232Rx1: U6.52 (UART4_RX); also elsewhere on the board
/232Tx1: U6.51 (UART4_TX); also elsewhere on the board
/422Rx: JP2.1 (A), JP5.3 (B)
/422Tx: JP1.1 (A), JP4.3 (B)
/485DE1: U6.26 (PB0); also elsewhere on the board
/485DE2: U6.15 (USART2_DE); also elsewhere on the board
/485DE3: U6.35 (USART3_DE); also elsewhere on the board
/485Rx1: U6.25 (USART1_RX); also elsewhere on the board
/485Rx2: U6.17 (USART2_RX); also elsewhere on the board
/485Rx3: U6.30 (USART3_RX); also elsewhere on the board
/485Tx1: U6.24 (USART1_TX); also elsewhere on the board
/485Tx2: U6.16 (USART2_TX); also elsewhere on the board
/485Tx3: U6.29 (USART3_TX); also elsewhere on the board
/CANH: D1.2 (K), J8.1, R1.1, U1.7 (CANH)
/CANL: D1.1 (K), J8.3, SW1.2, U1.6 (CANL)
/CAN_Rx: U1.2 (RXD), U6.61 (PB8)
/CAN_Tx: U1.3 (TXD), U6.62 (PB9)
/CE: JP3.1 (A), U6.42 (PA9)
/Isolated_232/Rx2: JP2.3 (B); also elsewhere on the board
/Isolated_232/Tx2: JP1.3 (B); also elsewhere on the board
/MISO: JP5.1 (A), U6.22 (SPI1_MISO)
/OSCIN: C19.1, U6.5 (RCC_OSC_IN), Y1.1
/OSCOUT: C20.1, U6.6 (RCC_OSC_OUT), Y1.2
/SCK: JP4.1 (A), U6.21 (SPI1_SCK)
/SSI_422/Rx: JP5.2 (C); also elsewhere on the board
/SSI_422/Tx: JP4.2 (C); also elsewhere on the board
/SWCLK: J3.1, U6.49 (SYS_JTCK-SWCLK)
/SWDIO: J3.2, U6.46 (SYS_JTMS-SWDIO)
/URx: JP2.2 (C), U6.54 (UART5_RX)
/USB_DM: U5.3 (I/O2), U6.44 (USB_DM)
/USB_DP: R12.2, U5.1 (I/O1), U6.45 (USB_DP)
/USB_pullup: R16.1, R17.1, U6.43 (PA10)
/UTx: JP1.2 (C), U6.53 (UART5_TX)
/VB: D9.2 (A), J11.1 (VBUS), U5.5 (VBUS)
/boot: J3.5, R10.1, SW4.1, U6.60 (BOOT0)
/rst: C22.1, J3.6, R18.1, SW3.1, U6.7 (NRST)
GND: C9.2, C12.2, C13.2, C16.2, C17.1, C18.1, C19.2, C20.2, C21.1, C22.2, C23.1, C24.1, J3.3, J9.1, J11.4 (GND), J11.5 (Shield), JP3.2 (B), Q2.1 (GND), R10.2, R16.2, SW3.2, TP3.1, U1.4 (GND1), U4.1 (GND), U5.2 (GND), U6.12 (VSSA), U6.31 (VSS), U6.47 (VSS), U6.63 (VSS); also elsewhere on the board
GND1: C2.2, D1.3 (O), J8.2, Q2.3 (0V), U1.5 (GND2)
unnamed: D7.2 (A), J9.2
unnamed: J3.4, R11.1
unnamed: J11.3 (D+), R13.1
unnamed: J11.2 (D-), R15.1
unnamed: Q1.3 (D), R12.1
unnamed: Q1.1 (G), R17.2
unnamed: C2.1, Q2.4 (+Vo), U1.8 (VCC2)
unnamed: R1.2, SW1.1
unnamed: R13.2, U5.6 (I/O1)
unnamed: R15.2, U5.4 (I/O2)

Notes on the sheet:
Isolated RS-485
Terminal on/off
Boot/SWDIO
485-3
Disable UART5 interface and enable config interface
485-2
Isolated RS-232 and RS-422/SSI
Isolated CAN bus
485-1
External 5V

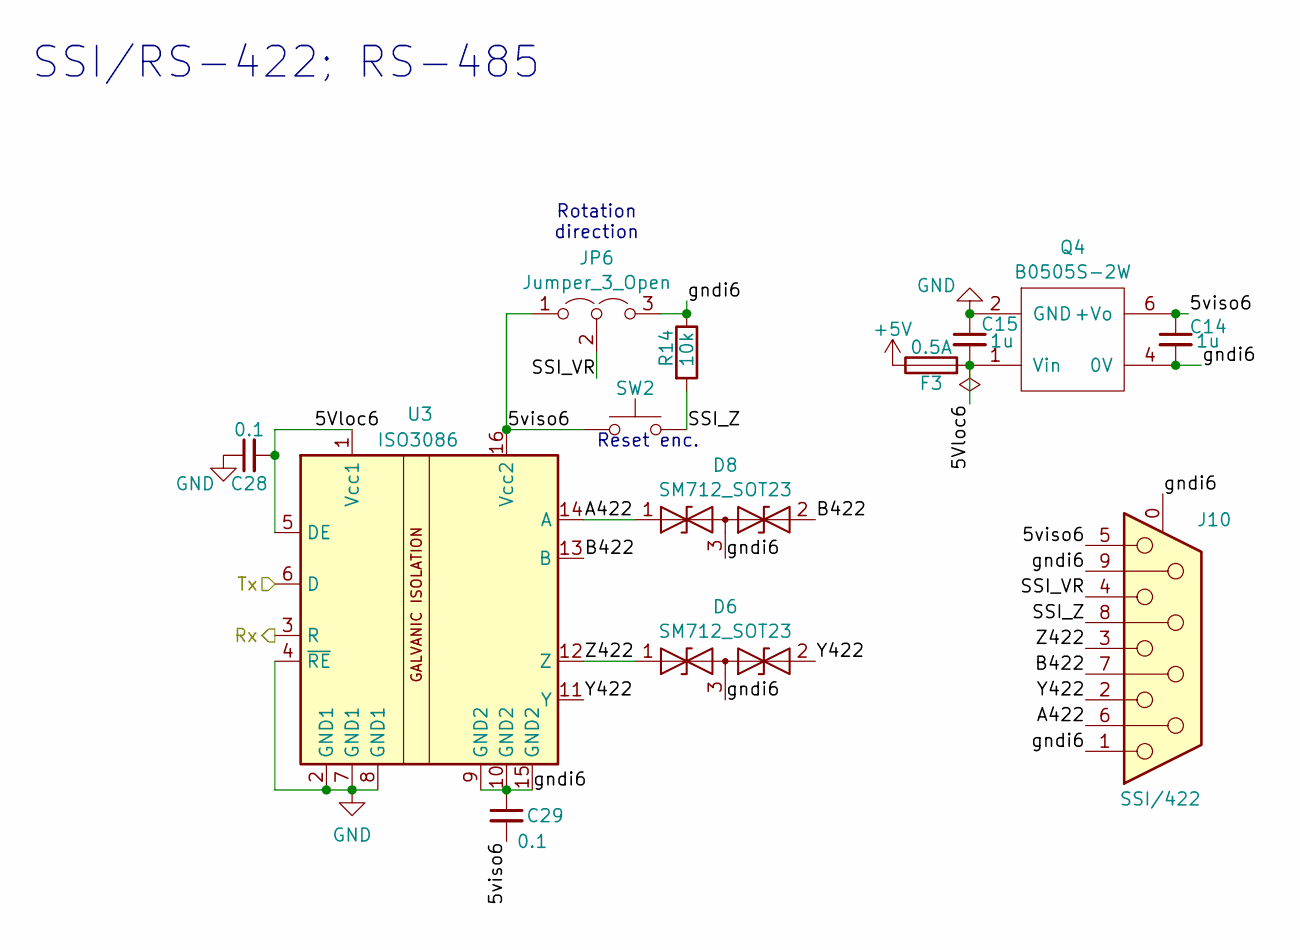
[picture p15: schematic ssi_422.kicad_sch]

Parts:
C14, C15: 1u; C_0805_2012Metric_Pad1.18x1.45mm_HandSolder
C28, C29: 0.1; C_0603_1608Metric_Pad1.08x0.95mm_HandSolder
D6, D8: SM712_SOT23; SOT-23
F3: 0.5A; Fuse_1206_3216Metric
J10: SSI/422; DSUB-9_Female_Horizontal_P2.77x2.84mm_EdgePinOffset4.94mm_H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
JP6: Jumper_3_Open; PinHeader_1x03_P2.54mm_Vertical
Q4: B0505S-2W
R14: 10k; R_0603_1608Metric_Pad0.98x0.95mm_HandSolder
SW2: SW_Push; SW_SPST_FSMSM
U3: ISO3086; SOIC-16W_7.5x10.3mm_P1.27mm

Connections:
+5V: F3.1; also elsewhere on the board
/SSI_422/5Vloc6: C15.2, C28.2, F3.2, Q4.1 (Vin), U3.1 (Vcc1), U3.5 (DE)
/SSI_422/5viso6: C14.1, C29.2, J10.5, JP6.1 (A), Q4.6 (+Vo), SW2.1, U3.16 (Vcc2)
/SSI_422/A422: D8.1 (A1), J10.6, U3.14 (A)
/SSI_422/B422: D8.2 (A2), J10.7, U3.13 (B)
/SSI_422/Rx: U3.3 (R); also elsewhere on the board
/SSI_422/SSI_VR: J10.4, JP6.2 (C)
/SSI_422/SSI_Z: J10.8, R14.2, SW2.2
/SSI_422/Tx: U3.6 (D); also elsewhere on the board
/SSI_422/Y422: D6.2 (A2), J10.2, U3.11 (Y)
/SSI_422/Z422: D6.1 (A1), J10.3, U3.12 (Z)
/SSI_422/gndi6: C14.2, C29.1, D6.3 (common), D8.3 (common), J10.0 (PAD), J10.1, J10.9, JP6.3 (B), Q4.4 (0V), R14.1, U3.9 (GND2), U3.10 (GND2), U3.15 (GND2)
GND: C15.1, C28.1, Q4.2 (GND), U3.2 (GND1), U3.4 (~RE), U3.7 (GND1), U3.8 (GND1); also elsewhere on the board

Notes on the sheet:
Reset enc.
Rotation direction
SSI/RS-422; RS-485

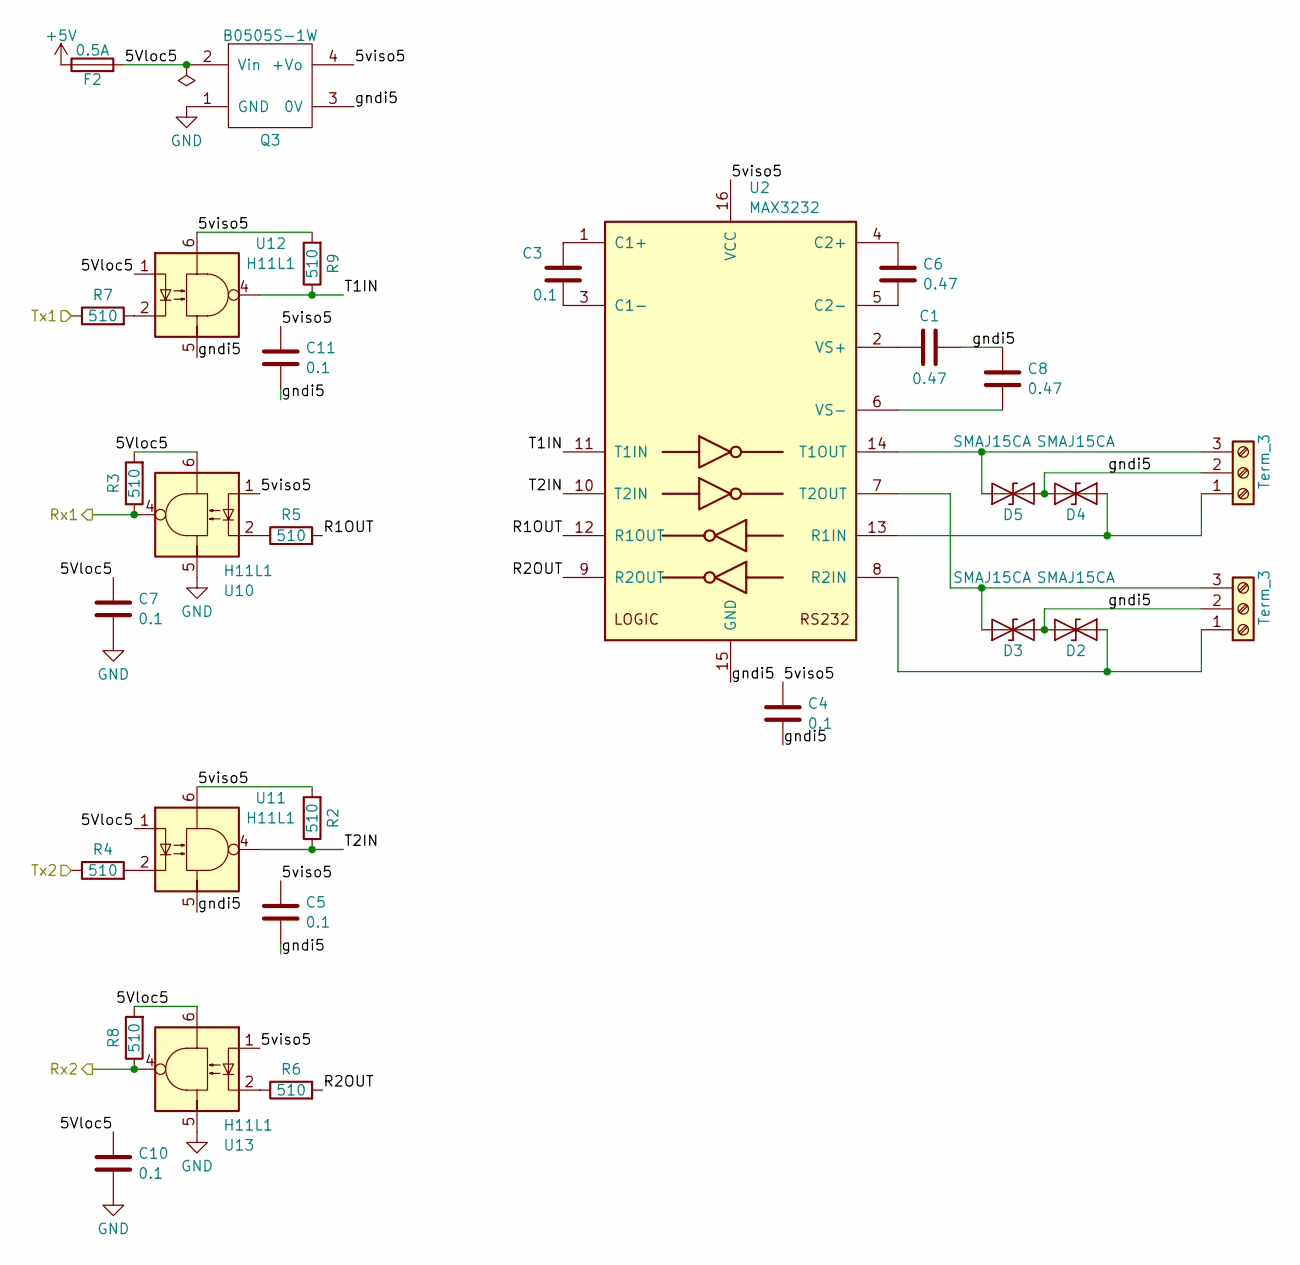
[picture p16: schematic isolated_232.kicad_sch]

Parts:
C1, C6, C8: 0.47; C_0805_2012Metric_Pad1.18x1.45mm_HandSolder
C3, C4, C5, C7, C10, C11: 0.1; C_0603_1608Metric_Pad1.08x0.95mm_HandSolder
D2, D3, D4, D5: SMAJ15CA; D_SMA
F2: 0.5A; Fuse_1206_3216Metric
J6, J7: Term_3; TerminalBlock_Phoenix_MKDS-1,5-3_1x03_P5.00mm_Horizontal
Q3: B0505S-1W; B0x0xS
R2, R3, R4, R5, R6, R7, R8, R9: 510; R_0603_1608Metric_Pad0.98x0.95mm_HandSolder
U2: MAX3232; SOIC-16_3.9x9.9mm_P1.27mm
U10, U11, U12, U13: H11L1; DIP-6_W7.62mm

Connections:
+5V: F2.1; also elsewhere on the board
/232Rx1: R3.1, U10.4; also elsewhere on the board
/232Tx1: R7.1; also elsewhere on the board
/Isolated_232/5Vloc5: C7.1, C10.1, F2.2, Q3.2 (Vin), R3.2, R8.2, U10.6, U11.1, U12.1, U13.6
/Isolated_232/5viso5: C4.1, C5.1, C11.1, Q3.4 (+Vo), R2.2, R9.2, U2.16 (VCC), U10.1, U11.6, U12.6, U13.1
/Isolated_232/R1OUT: R5.2, U2.12 (R1OUT)
/Isolated_232/R2OUT: R6.2, U2.9 (R2OUT)
/Isolated_232/Rx2: R8.1, U13.4; also elsewhere on the board
/Isolated_232/T1IN: R9.1, U2.11 (T1IN), U12.4
/Isolated_232/T2IN: R2.1, U2.10 (T2IN), U11.4
/Isolated_232/Tx2: R4.1; also elsewhere on the board
/Isolated_232/gndi5: C1.2, C4.2, C5.2, C8.1, C11.2, D2.2 (A2), D3.1 (A1), D4.2 (A2), D5.1 (A1), J6.2, J7.2, Q3.3 (0V), U2.15 (GND), U11.5, U12.5
GND: C7.2, C10.2, Q3.1 (GND), U10.5, U13.5; also elsewhere on the board
unnamed: D2.1 (A1), J7.1, U2.8 (R2IN)
unnamed: D3.2 (A2), J7.3, U2.7 (T2OUT)
unnamed: D4.1 (A1), J6.1, U2.13 (R1IN)
unnamed: D5.2 (A2), J6.3, U2.14 (T1OUT)
unnamed: R4.2, U11.2
unnamed: R5.1, U10.2
unnamed: R6.1, U13.2
unnamed: R7.2, U12.2
unnamed: C3.1, U2.1 (C1+)
unnamed: C3.2, U2.3 (C1-)
unnamed: C6.1, U2.4 (C2+)
unnamed: C6.2, U2.5 (C2-)
unnamed: C1.1, U2.2 (VS+)
unnamed: C8.2, U2.6 (VS-)
