eddyem/stm32samples/F3:F303/InterfaceBoard/kicad/many485.kicad_pcb

## KiCad design F3:F303/InterfaceBoard/kicad/many485.kicad_pcb (continued)

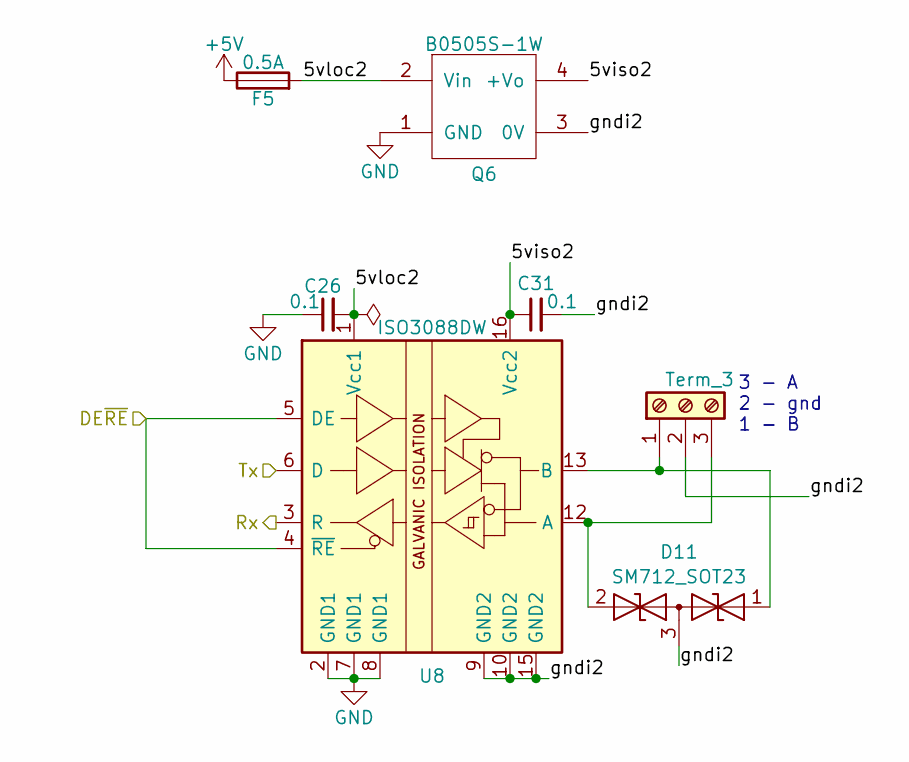
[picture p17: schematic iso485.kicad_sch]

Parts:
C26, C31: 0.1; C_0603_1608Metric_Pad1.08x0.95mm_HandSolder
D11: SM712_SOT23; SOT-23
F5: 0.5A; Fuse_1206_3216Metric
J13: Term_3; TerminalBlock_Phoenix_MKDS-1,5-3_1x03_P5.00mm_Horizontal
Q6: B0505S-1W; B0x0xS
U8: ISO3088DW; SOIC-16W_7.5x10.3mm_P1.27mm

Connections:
+5V: F5.1; also elsewhere on the board
/485DE1: U8.4 (~RE), U8.5 (DE); also elsewhere on the board
/485Rx1: U8.3 (R); also elsewhere on the board
/485Tx1: U8.6 (D); also elsewhere on the board
/Isolated_485_01/5viso2: C31.1, Q6.4 (+Vo), U8.16 (Vcc2)
/Isolated_485_01/5vloc2: C26.2, F5.2, Q6.2 (Vin), U8.1 (Vcc1)
/Isolated_485_01/gndi2: C31.2, D11.3 (common), J13.2, Q6.3 (0V), U8.9 (GND2), U8.10 (GND2), U8.15 (GND2)
GND: C26.1, Q6.1 (GND), U8.2 (GND1), U8.7 (GND1), U8.8 (GND1); also elsewhere on the board
unnamed: D11.1 (A1), J13.1, U8.13 (B)
unnamed: D11.2 (A2), J13.3, U8.12 (A)

Parts of its further copies:
C25, C27, C30, C32: 0.1; C_0603_1608Metric_Pad1.08x0.95mm_HandSolder
D10, D12: SM712_SOT23; SOT-23
F4, F6: 0.5A; Fuse_1206_3216Metric
J12, J14: Term_3; TerminalBlock_Phoenix_MKDS-1,5-3_1x03_P5.00mm_Horizontal
Q5, Q7: B0505S-1W; B0x0xS
U7, U9: ISO3088DW; SOIC-16W_7.5x10.3mm_P1.27mm

Connections of its further copies:
+5V: F4.1, F6.1; also elsewhere on the board
/485DE2: U7.4 (~RE), U7.5 (DE); also elsewhere on the board
/485DE3: U9.4 (~RE), U9.5 (DE); also elsewhere on the board
/485Rx2: U7.3 (R); also elsewhere on the board
/485Rx3: U9.3 (R); also elsewhere on the board
/485Tx2: U7.6 (D); also elsewhere on the board
/485Tx3: U9.6 (D); also elsewhere on the board
/Isolated_485_2/5viso2: C30.1, Q7.4 (+Vo), U7.16 (Vcc2)
/Isolated_485_2/5vloc2: C25.2, F6.2, Q7.2 (Vin), U7.1 (Vcc1)
/Isolated_485_2/gndi2: C30.2, D10.3 (common), J14.2, Q7.3 (0V), U7.9 (GND2), U7.10 (GND2), U7.15 (GND2)
/Isolated_485_3/5viso2: C32.1, Q5.4 (+Vo), U9.16 (Vcc2)
/Isolated_485_3/5vloc2: C27.2, F4.2, Q5.2 (Vin), U9.1 (Vcc1)
/Isolated_485_3/gndi2: C32.2, D12.3 (common), J12.2, Q5.3 (0V), U9.9 (GND2), U9.10 (GND2), U9.15 (GND2)
GND: C25.1, C27.1, Q5.1 (GND), Q7.1 (GND), U7.2 (GND1), U7.7 (GND1), U7.8 (GND1), U9.2 (GND1), U9.7 (GND1), U9.8 (GND1); also elsewhere on the board
unnamed: D10.1 (A1), J14.1, U7.13 (B)
unnamed: D10.2 (A2), J14.3, U7.12 (A)
unnamed: D12.1 (A1), J12.1, U9.13 (B)
unnamed: D12.2 (A2), J12.3, U9.12 (A)

Notes on the sheet:
3 - A 2 - gnd 1 - B

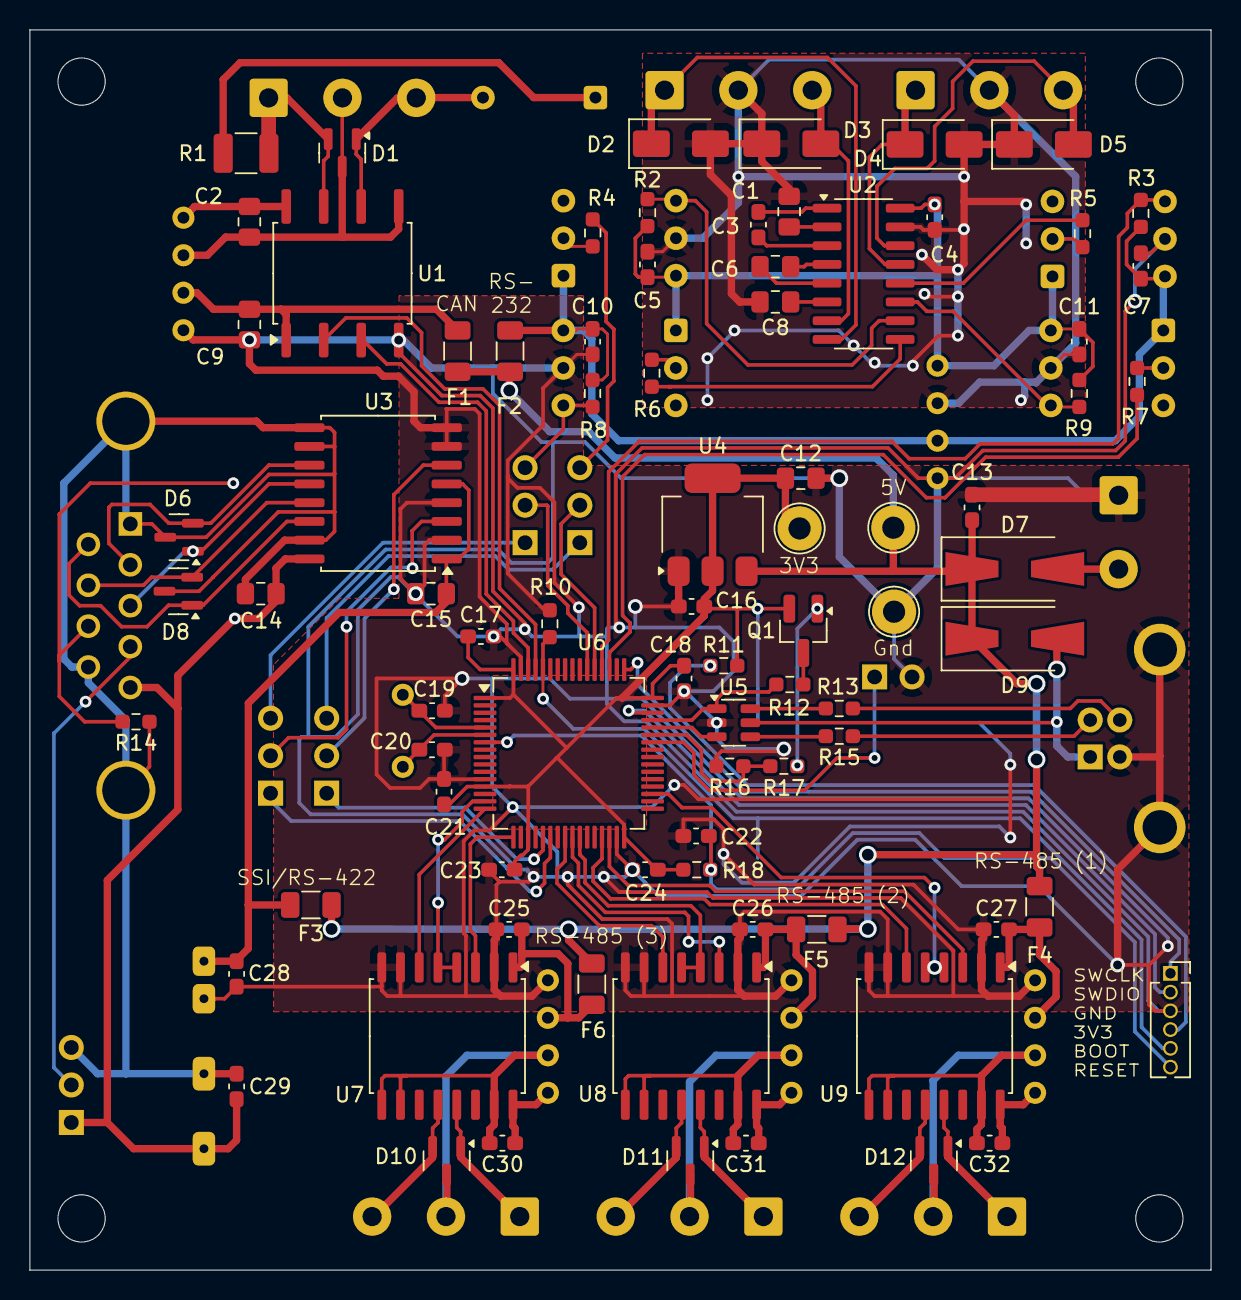
[picture p18: board many485.kicad_pcb from above]

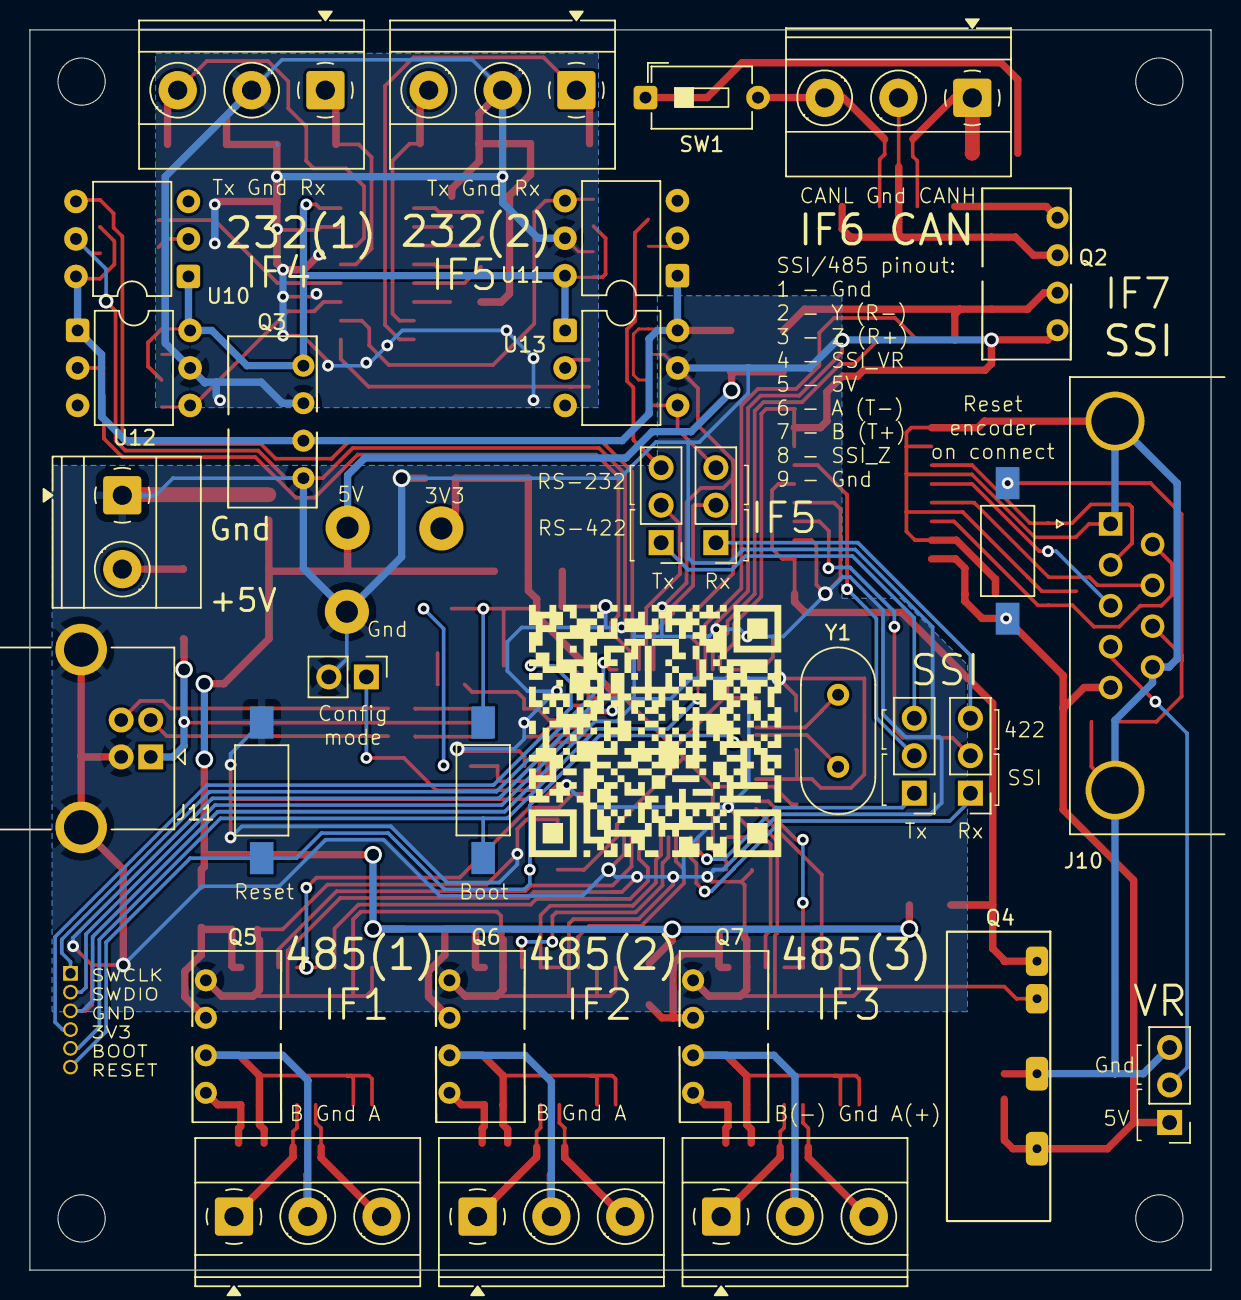
[picture p19: board many485.kicad_pcb from below]

Board: 2 copper layers, 80.0 x 84.0 mm, 116 parts (30 on the bottom side), 96 nets.
