eddyem/stm32samples/F1:F103/Hall_linear/kicad/Hall.kicad_pcb

## KiCad design F1:F103/Hall_linear/kicad/Hall.kicad_pcb (2024-12-26)

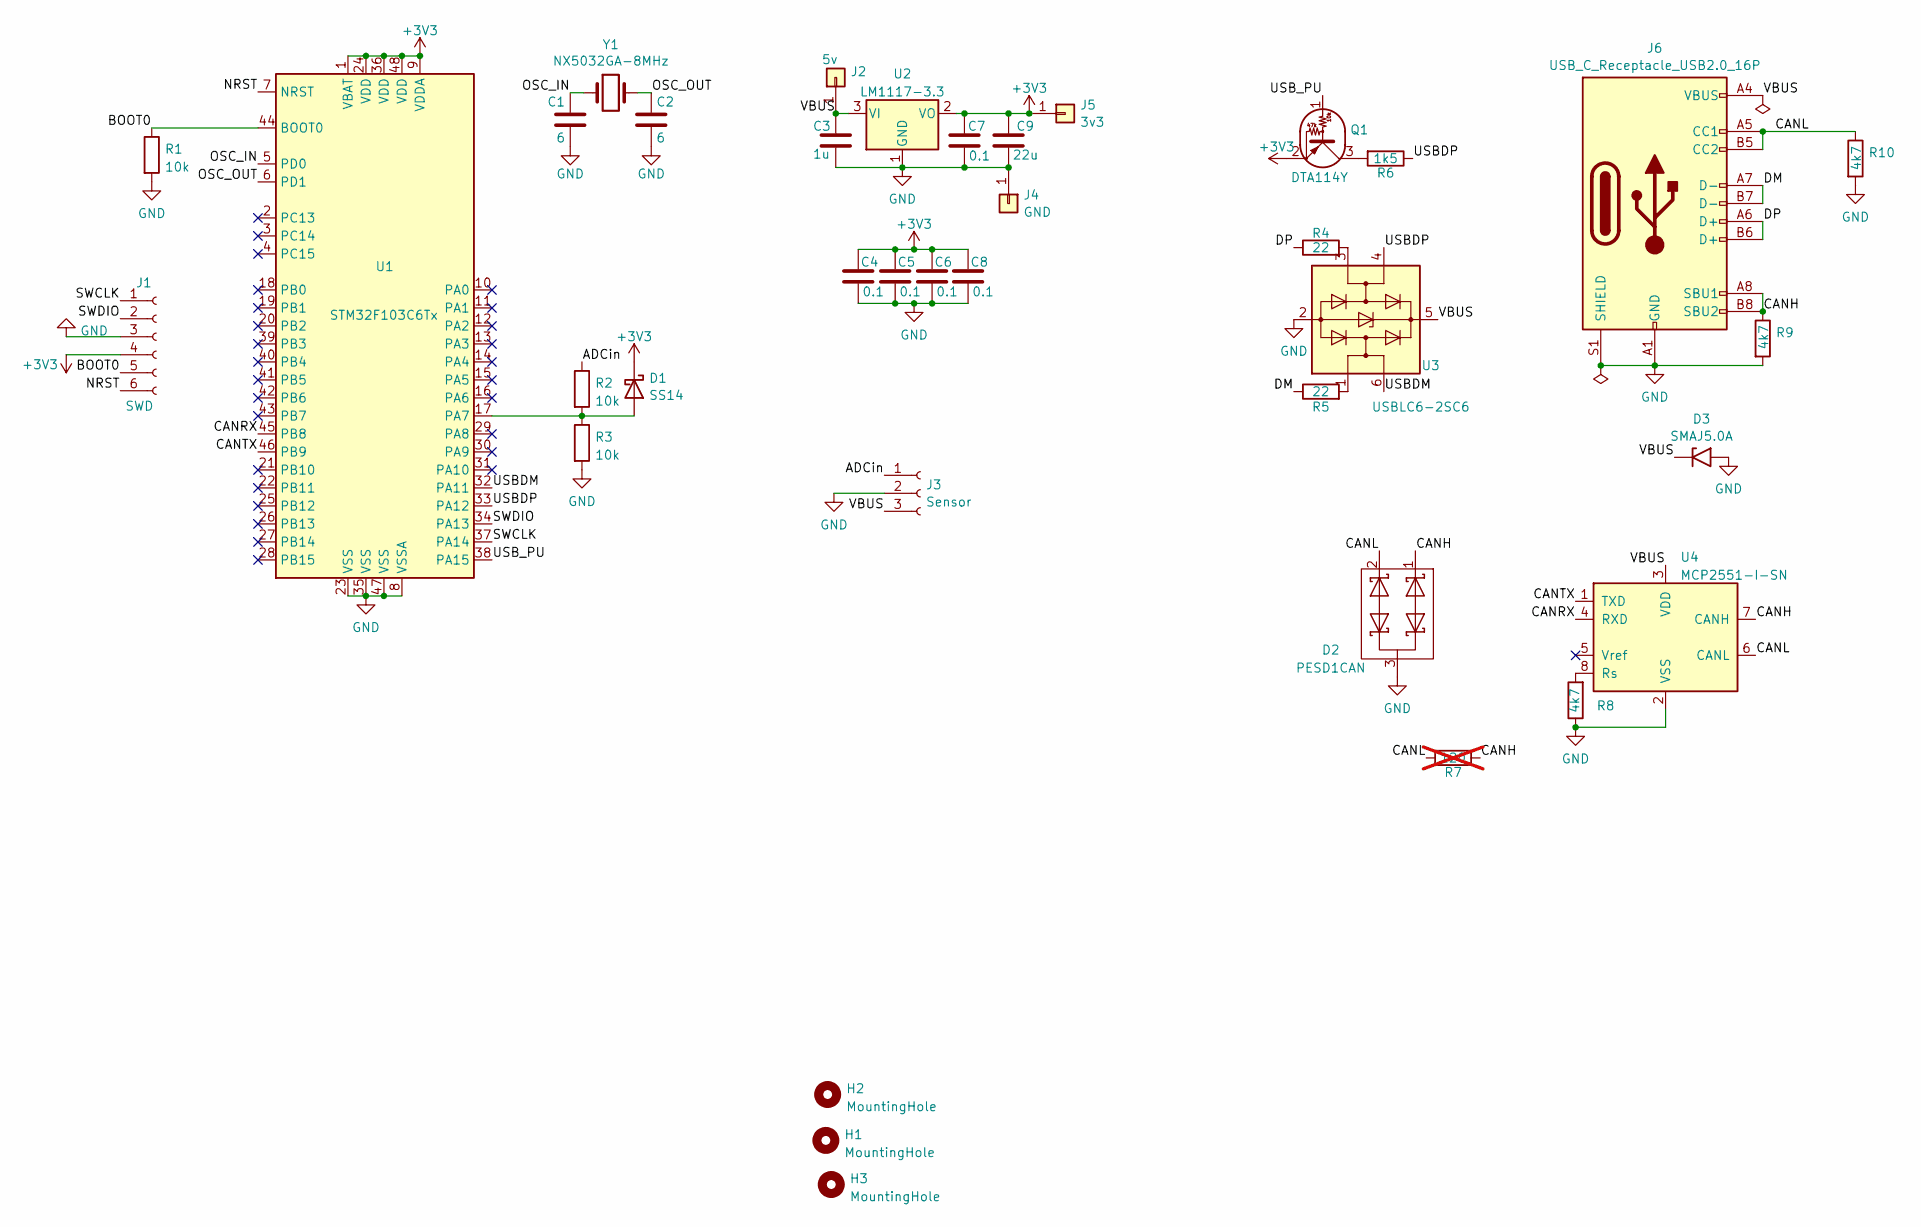
[picture p20: schematic Hall.kicad_sch]

Parts:
C1, C2: 6; C_0603_1608Metric_Pad1.08x0.95mm_HandSolder
C3: 1u; C_0805_2012Metric_Pad1.18x1.45mm_HandSolder
C4, C5, C6, C7, C8: 0.1; C_0603_1608Metric_Pad1.08x0.95mm_HandSolder
C9: 22u; C_1206_3216Metric_Pad1.33x1.80mm_HandSolder
D1: SS14; D_SOD-323_HandSoldering
D2: PESD1CAN; SOT-23
D3: SMAJ5.0A; D_SMA
H1, H2, H3: MountingHole; MountingHole_3.2mm_M3
J1: SWD; PinHeader_1x06_P1.27mm_Vertical
J2: 5v; SolderWire-0.5sqmm_1x01_D0.9mm_OD2.1mm
J3: Sensor; PinHeader_1x03_P2.54mm_Vertical
J4: GND; SolderWire-0.5sqmm_1x01_D0.9mm_OD2.1mm
J5: 3v3; SolderWire-0.5sqmm_1x01_D0.9mm_OD2.1mm
J6: USB_C_Receptacle_USB2.0_16P; USB_C_Receptacle_HRO_TYPE-C-31-M-12
Q1: DTA114Y; SOT-323_SC-70_Handsoldering
R1, R2, R3: 10k; R_0603_1608Metric_Pad0.98x0.95mm_HandSolder
R4, R5: 22; R_0603_1608Metric_Pad0.98x0.95mm_HandSolder
R6: 1k5; R_0603_1608Metric_Pad0.98x0.95mm_HandSolder
R7: 120; R_1210_3225Metric_Pad1.30x2.65mm_HandSolder; not fitted
R8, R9, R10: 4k7; R_0603_1608Metric_Pad0.98x0.95mm_HandSolder
U1: STM32F103C6Tx; LQFP-48_7x7mm_P0.5mm
U2: LM1117-3.3; SOT-223-3_TabPin2
U3: USBLC6-2SC6; SOT-23-6_Handsoldering
U4: MCP2551-I-SN; SOIC-8_3.9x4.9mm_P1.27mm
Y1: NX5032GA-8MHz; Crystal_SMD_5032-2Pin_5.0x3.2mm

Connections:
+3V3: C4.1, C5.1, C6.1, C7.1, C8.1, C9.1, D1.1 (K), J1.4, J5.1, Q1.2 (E), U1.1 (VBAT), U1.9 (VDDA), U1.24 (VDD), U1.36 (VDD), U1.48 (VDD), U2.2 (VO)
/ADCin: J3.1, R2.1
/BOOT0: J1.5, R1.1, U1.44 (BOOT0)
/CANH: D2.1 (K), J6.A8 (SBU1), J6.B8 (SBU2), R7.1, R9.1, U4.7 (CANH)
/CANL: D2.2 (K), J6.A5 (CC1), J6.B5 (CC2), R7.2, R10.1, U4.6 (CANL)
/CANRX: U1.45 (PB8), U4.4 (RXD)
/CANTX: U1.46 (PB9), U4.1 (TXD)
/DM: J6.A7 (D-), J6.B7 (D-), R5.1
/DP: J6.A6 (D+), J6.B6 (D+), R4.1
/NRST: J1.6, U1.7 (NRST)
/OSC_IN: C1.1, U1.5 (PD0), Y1.1
/OSC_OUT: C2.1, U1.6 (PD1), Y1.2
/SWCLK: J1.1, U1.37 (PA14)
/SWDIO: J1.2, U1.34 (PA13)
/USBDM: U1.32 (PA11), U3.6 (I/O1)
/USBDP: R6.1, U1.33 (PA12), U3.4 (I/O2)
/USB_PU: Q1.1 (B), U1.38 (PA15)
/VBUS: C3.1, D3.1 (A1), J2.1, J3.3, J6.A4 (VBUS), J6.A9 (VBUS), J6.B4 (VBUS), J6.B9 (VBUS), U2.3 (VI), U3.5 (VBUS), U4.3 (VDD)
GND: C1.2, C2.2, C3.2, C4.2, C5.2, C6.2, C7.2, C8.2, C9.2, D2.3 (O), D3.2 (A2), J1.3, J3.2, J4.1, J6.A1 (GND), J6.A12 (GND), J6.B1 (GND), J6.B12 (GND), J6.S1 (SHIELD), R1.2, R3.2, R8.1, R9.2, R10.2, U1.8 (VSSA), U1.23 (VSS), U1.35 (VSS), U1.47 (VSS), U2.1 (GND), U3.2 (GND), U4.2 (VSS)
unnamed: D1.2 (A), R2.2, R3.1, U1.17 (PA7)
unnamed: Q1.3 (C), R6.2
unnamed: R4.2, U3.3 (I/O2)
unnamed: R5.2, U3.1 (I/O1)
unnamed: R8.2, U4.8 (Rs)

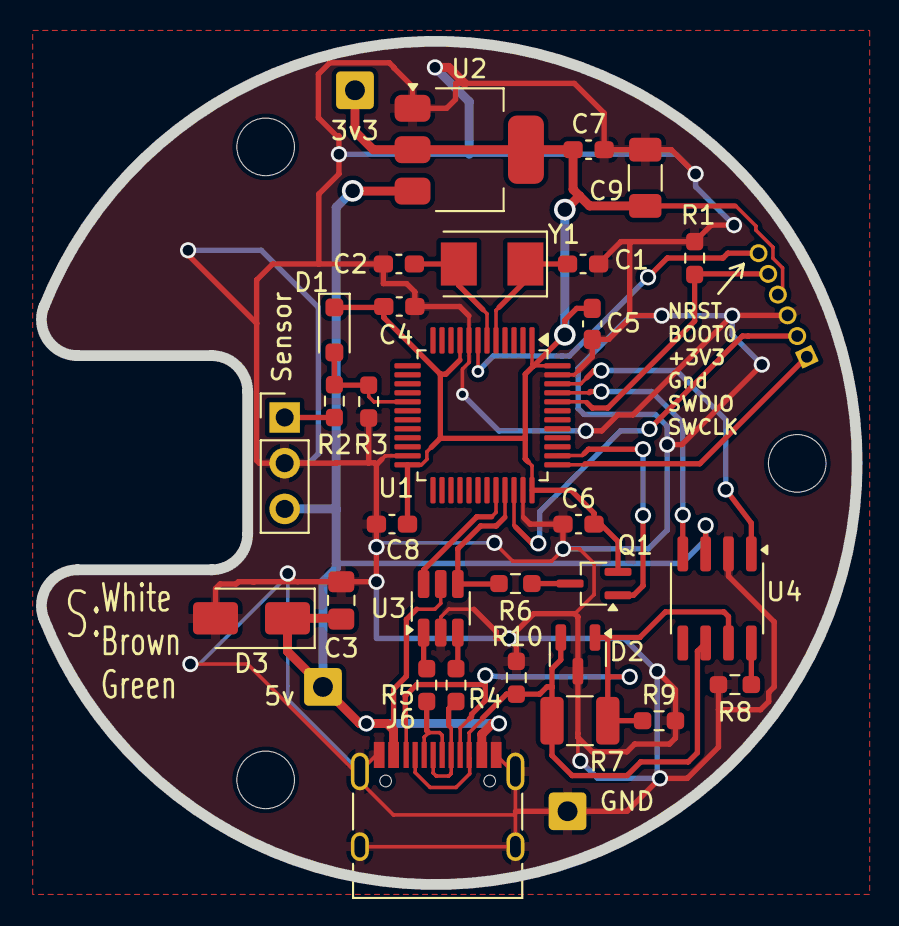
[picture p21: board Hall.kicad_pcb from above]

Board: 2 copper layers, 45.3 x 46.8 mm, 37 parts (1 on the bottom side), 24 nets.
