eddyem/stm32samples/F1:F103/shutter/UNISTABLE/kicad/shutter.kicad_pcb

## KiCad design F1:F103/shutter/UNISTABLE/kicad/shutter.kicad_pcb (2024-10-07)

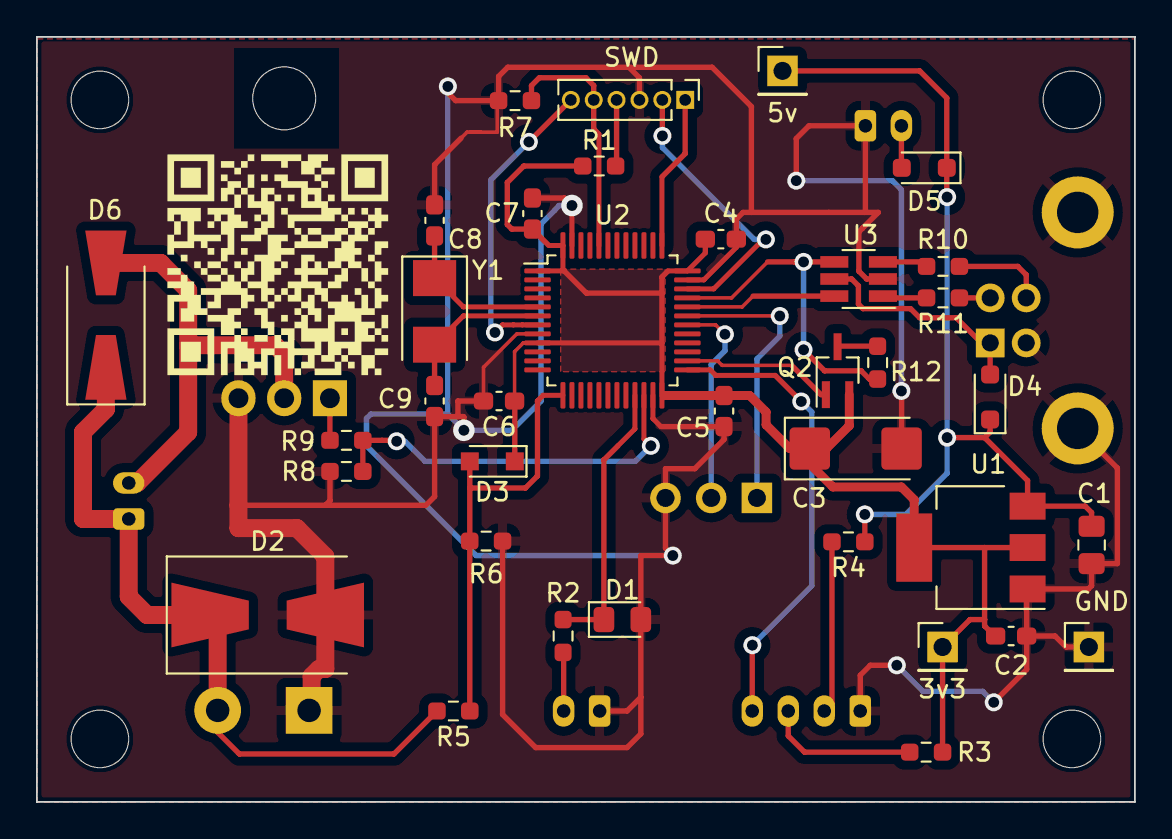
[picture p22: board F1:F103/shutter/UNISTABLE/kicad/shutter.kicad_pcb from above]

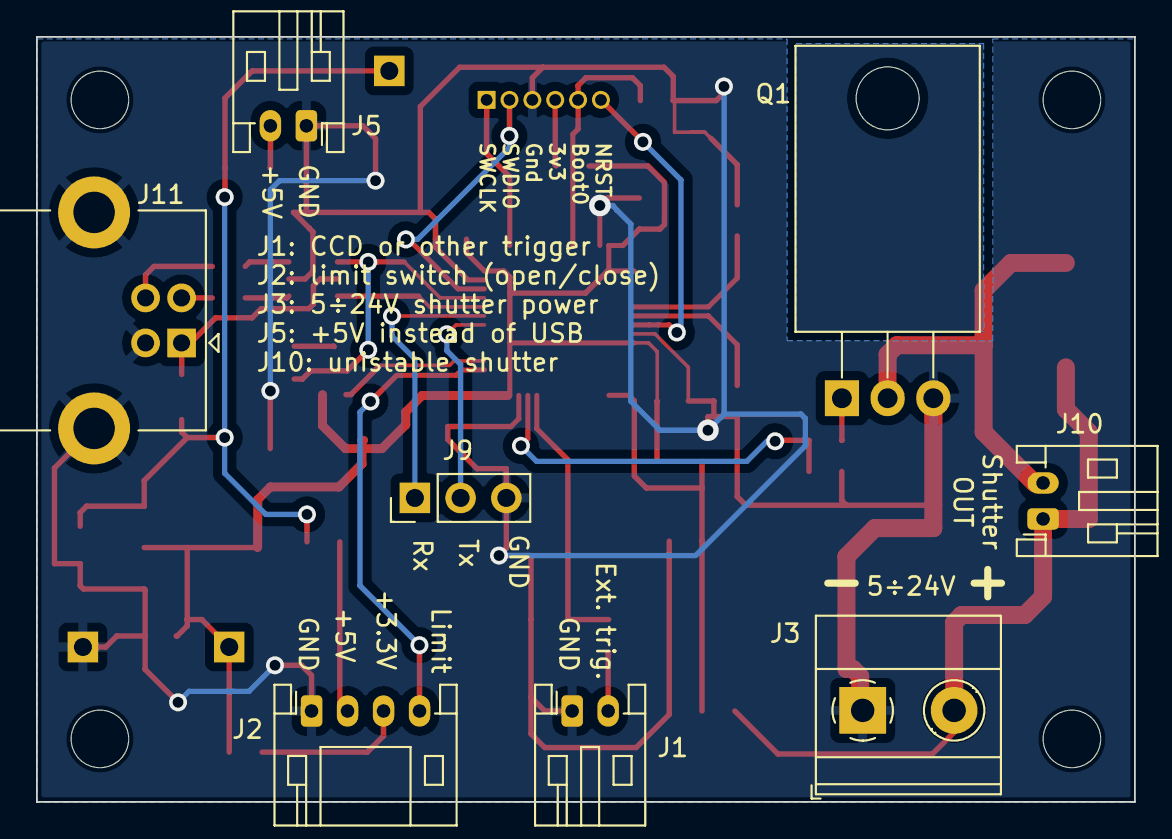
[picture p23: board F1:F103/shutter/UNISTABLE/kicad/shutter.kicad_pcb from below]

Board: 2 copper layers, 61.0 x 42.5 mm, 48 parts (8 on the bottom side), 32 nets.

Parts:
C1: 1u; C_0805_2012Metric_Pad1.18x1.45mm_HandSolder
C2, C4, C5, C6, C7: 0.1; C_0603_1608Metric_Pad1.08x0.95mm_HandSolder
C3: 47u; CP_EIA-6032-28_Kemet-C_Pad2.25x2.35mm_HandSolder
C8, C9: 6; C_0603_1608Metric_Pad1.08x0.95mm_HandSolder
D1: CESD3V3; D_0805_2012Metric_Pad1.15x1.40mm_HandSolder
D2: SMBJ30A; D_SMB-SMC_Universal_Handsoldering
D3, D4, D5: SS14; D_SOD-323_HandSoldering
D6: SS14; D_SMA-SMB_Universal_Handsoldering
H1, H2, H3, H4: MountingHole; MountingHole_3.2mm_M3_ISO7380
J1: ccd; JST_PH_S2B-PH-K_1x02_P2.00mm_Horizontal
J2: hall; JST_PH_S4B-PH-K_1x04_P2.00mm_Horizontal
J3: ShtrPower; TerminalBlock_Phoenix_MKDS-1,5-2-5.08_1x02_P5.08mm_Horizont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
J4: SWD; PinHeader_1x06_P1.27mm_Vertical
J5: 5Vext; JST_PH_S2B-PH-K_1x02_P2.00mm_Horizontal
J6: 5v; PinHeader_1x01_P2.54mm_Vertical
J7: GND; PinHeader_1x01_P2.54mm_Vertical
J8: 3v3; PinHeader_1x01_P2.54mm_Vertical
J9: USART1; PinHeader_1x03_P2.54mm_Vertical
J10: shutter; JST_PH_S2B-PH-K_1x02_P2.00mm_Horizontal
J11: USB_B; USB_B_Lumberg_2411_02_Horizontal
Q1: IRL3303; TO-220-3_Horizontal_TabDown
Q2: DTA114Y; SOT-323_SC-70_Handsoldering
R1: 6.9; R_0603_1608Metric_Pad0.98x0.95mm_HandSolder
R2, R9: 100; R_0603_1608Metric_Pad0.98x0.95mm_HandSolder
R3, R4: 33; R_0603_1608Metric_Pad0.98x0.95mm_HandSolder
R5: 56k; R_0603_1608Metric_Pad0.98x0.95mm_HandSolder
R6, R8: 4k7; R_0603_1608Metric_Pad0.98x0.95mm_HandSolder
R7: 10k; R_0603_1608Metric_Pad0.98x0.95mm_HandSolder
R10, R11: 22; R_0603_1608Metric_Pad0.98x0.95mm_HandSolder
R12: 1k5; R_0603_1608Metric_Pad0.98x0.95mm_HandSolder
U1: LM1117-3.3; SOT-223-3_TabPin2
U2: STM32F103C6Tx; LQFP-48_7x7mm_P0.5mm
U3: USBLC6-2SC6; SOT-23-6_Handsoldering
Y1: NX5032GA-8MHz; Crystal_SMD_5032-2Pin_5.0x3.2mm

Connections:
+3V3: C2.1, C3.1, C4.1, C5.1, C6.1, C7.1, D3.1 (K), J8.1, Q2.2 (E), R1.1, R3.1, U1.2 (VO), U2.1 (VBAT), U2.9 (VDDA), U2.24 (VDD), U2.36 (VDD), U2.48 (VDD)
/5V: C1.1, D4.1 (K), D5.1 (K), J6.1, R4.1, U1.3 (VI)
/BOOT0: J4.5, R7.1, U2.44 (BOOT0)
/CCD: D1.1 (K), R2.1, U2.21 (PB10)
/DR: D6.2 (A), J10.2, Q1.2 (D)
/LimSW: J2.4, U2.25 (PB12)
/NRST: J4.6, U2.7 (NRST)
/OSC_IN: C8.1, U2.5 (PD0), Y1.1
/OSC_OUT: C9.1, U2.6 (PD1), Y1.2
/PWM: R8.1, R9.2, U2.22 (PB11)
/Rx: J9.1, U2.31 (PA10)
/SHTR_V: D3.2 (A), R5.2, R6.1, U2.13 (PA3)
/SHTRpow: D2.1 (A1), D6.1 (K), J3.2, J10.1, R5.1
/SWCLK: J4.1, U2.37 (PA14)
/SWDIO: J4.2, U2.34 (PA13)
/Tx: J9.2, U2.30 (PA9)
/USBDM: U2.32 (PA11), U3.6 (I/O1)
/USBDP: R12.1, U2.33 (PA12), U3.4 (I/O2)
/USB_PU: Q2.1 (B), U2.26 (PB13)
/VBUS: D4.2 (A), J11.1 (VBUS), U3.5 (VBUS)
GND: C1.2, C2.2, C3.2, C4.2, C5.2, C6.2, C7.2, C8.2, C9.2, D1.2 (A), D2.2 (A2), J1.1, J2.1, J3.1, J4.3, J5.1, J7.1, J9.3, J11.4 (GND), J11.5 (Shield), Q1.3 (S), R6.2, R7.2, R8.2, U1.1 (GND), U2.8 (VSSA), U2.23 (VSS), U2.35 (VSS), U2.47 (VSS), U3.2 (GND)
unnamed: D5.2 (A), J5.2
unnamed: J1.2, R2.2
unnamed: J2.2, R4.2
unnamed: J2.3, R3.2
unnamed: J4.4, R1.2
unnamed: J11.3 (D+), R10.1
unnamed: J11.2 (D-), R11.1
unnamed: Q1.1 (G), R9.1
unnamed: Q2.3 (C), R12.2
unnamed: R10.2, U3.3 (I/O2)
unnamed: R11.2, U3.1 (I/O1)
