eddyem/stm32samples/F1:F103/shutter/kicad/shutter.kicad_pcb

## KiCad design F1:F103/shutter/kicad/shutter.kicad_pcb (2024-10-01, an earlier design)

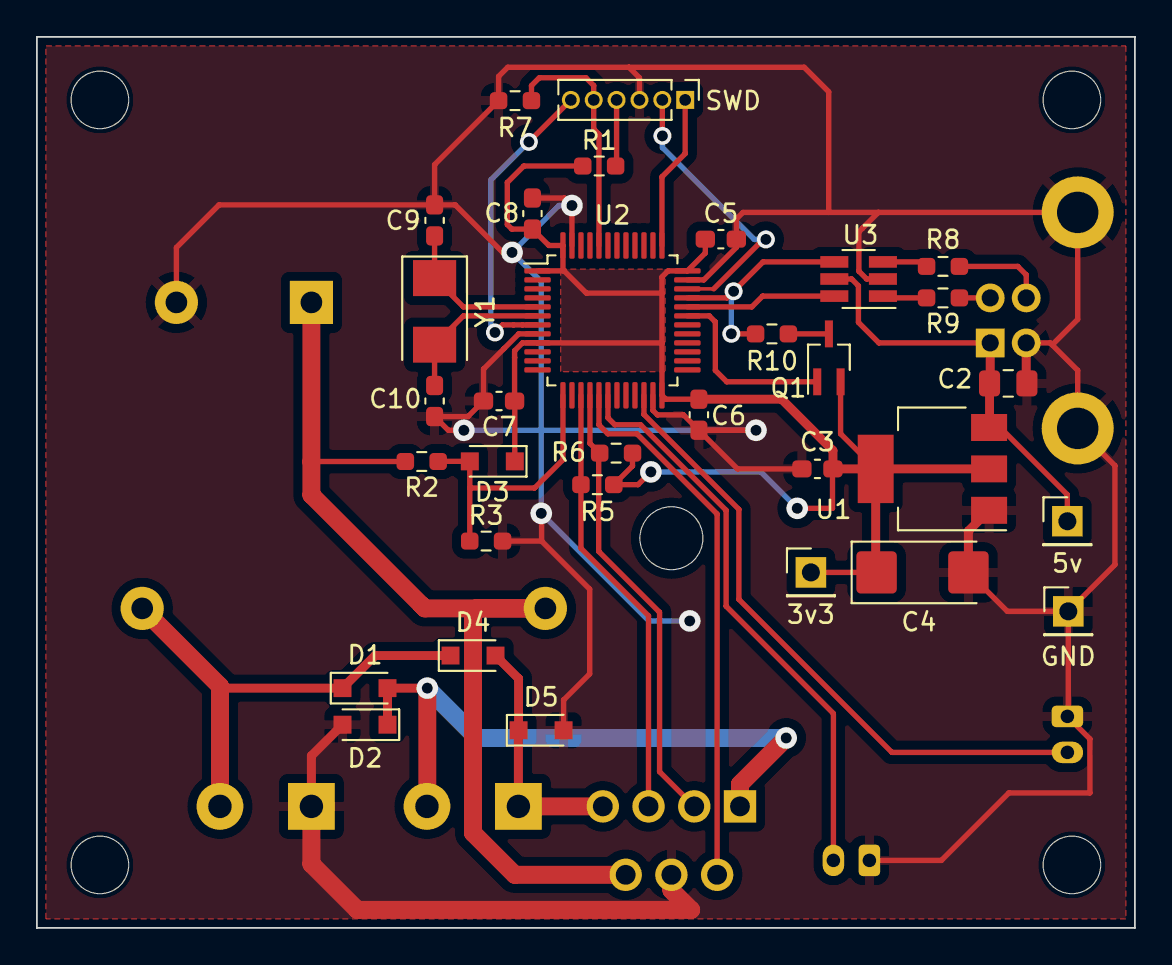
[picture p24: board F1:F103/shutter/kicad/shutter.kicad_pcb from above]

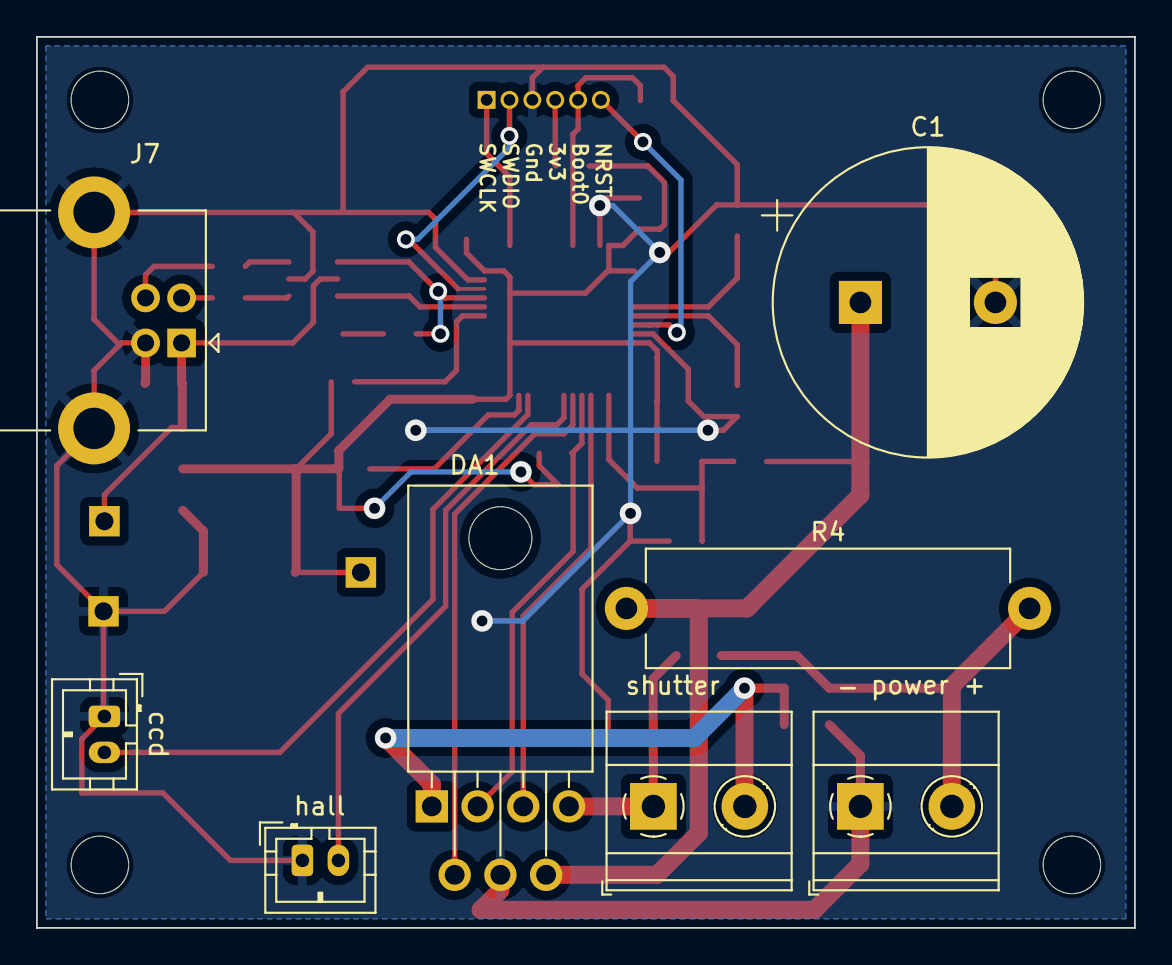
[picture p25: board F1:F103/shutter/kicad/shutter.kicad_pcb from below]

Board: 2 copper layers, 61.0 x 49.5 mm, 44 parts (8 on the bottom side), 28 nets.

Parts:
C1: 2200u, 40V; CP_Radial_D17.0mm_P7.50mm
C2: 1u; C_0805_2012Metric_Pad1.18x1.45mm_HandSolder
C3, C5, C6, C7, C8: 0.1; C_0603_1608Metric_Pad1.08x0.95mm_HandSolder
C4: 47u; CP_EIA-6032-28_Kemet-C_Pad2.25x2.35mm_HandSolder
C9, C10: 6; C_0603_1608Metric_Pad1.08x0.95mm_HandSolder
D1, D2, D3, D4, D5: 1N5819; D_SOD-323_HandSoldering
DA1: TLE5205; TO-220-7_P2.54x3.8mm_StaggerEven_Lead5.85mm_TabDown
H1, H2, H3, H4: MountingHole; MountingHole_3.2mm_M3
J1: shutter; TerminalBlock_Phoenix_MKDS-1,5-2-5.08_1x02_P5.08mm_Horizont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
J2: power; TerminalBlock_Phoenix_MKDS-1,5-2-5.08_1x02_P5.08mm_Horizont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
J3: SWD; PinHeader_1x06_P1.27mm_Vertical
J4: 5v; PinHeader_1x01_P2.54mm_Vertical
J5: GND; PinHeader_1x01_P2.54mm_Vertical
J6: 3v3; PinHeader_1x01_P2.54mm_Vertical
J7: USB_B; USB_B_Lumberg_2411_02_Horizontal
J8: hall; JST_PH_B2B-PH-K_1x02_P2.00mm_Vertical
J9: ccd; JST_PH_B2B-PH-K_1x02_P2.00mm_Vertical
Q1: DTA114Y; SOT-323_SC-70_Handsoldering
R1: 6.9; R_0603_1608Metric_Pad0.98x0.95mm_HandSolder
R2: 56k; R_0603_1608Metric_Pad0.98x0.95mm_HandSolder
R3, R5, R6: 4k7; R_0603_1608Metric_Pad0.98x0.95mm_HandSolder
R4: 300 II; R_Axial_Power_L20.0mm_W6.4mm_P22.40mm
R7: 10k; R_0603_1608Metric_Pad0.98x0.95mm_HandSolder
R8, R9: 22; R_0603_1608Metric_Pad0.98x0.95mm_HandSolder
R10: 1k5; R_0603_1608Metric_Pad0.98x0.95mm_HandSolder
U1: LM1117-3.3; SOT-223-3_TabPin2
U2: STM32F103C6Tx; LQFP-48_7x7mm_P0.5mm
U3: USBLC6-2SC6; SOT-23-6_Handsoldering
Y1: NX5032GA-8MHz; Crystal_SMD_5032-2Pin_5.0x3.2mm

Connections:
+3V3: C3.1, C4.1, C5.1, C6.1, C7.1, C8.1, D3.1 (K), J6.1, Q1.2 (E), R1.1, R5.2, R6.2, U1.2 (VO), U2.1 (VBAT), U2.9 (VDDA), U2.24 (VDD), U2.36 (VDD), U2.48 (VDD)
/BOOT0: J3.5, R7.1, U2.44 (BOOT0)
/NRST: J3.6, U2.7 (NRST)
/OSC_IN: C9.1, U2.5 (PD0), Y1.1
/OSC_OUT: C10.1, U2.6 (PD1), Y1.2
/SHTR_A: DA1.3 (IN1), R6.1, U2.16 (PA6)
/SHTR_B: DA1.5 (IN2), R5.1, U2.15 (PA5)
/SHTR_FB: DA1.2 (EF), U2.17 (PA7)
/SHTR_V: D3.2 (A), R2.2, R3.1, U2.13 (PA3)
/SWCLK: J3.1, U2.37 (PA14)
/SWDIO: J3.2, U2.34 (PA13)
/USBDM: U2.32 (PA11), U3.6 (I/O1)
/USBDP: R10.1, U2.33 (PA12), U3.4 (I/O2)
/USB_PU: Q1.1 (B), U2.31 (PA10)
/Uin: D1.1 (K), D4.1 (K), J2.2, R4.1
/VBUS: C2.1, J4.1, J7.1 (VBUS), U1.3 (VI), U3.5 (VBUS)
GND: C1.2, C2.2, C3.2, C4.2, C5.2, C6.2, C7.2, C8.2, C9.2, C10.2, D2.2 (A), D5.2 (A), DA1.4 (GND), J2.1, J3.3, J5.1, J7.4 (GND), J7.5 (Shield), J8.1, J9.1, R3.2, R7.2, U1.1 (GND), U2.8 (VSSA), U2.23 (VSS), U2.35 (VSS), U2.47 (VSS), U3.2 (GND)
unnamed: D1.2 (A), D2.1 (K), DA1.1 (OUT1), J1.2
unnamed: D4.2 (A), D5.1 (K), DA1.7 (OUT2), J1.1
unnamed: C1.1, DA1.6 (Vs), R2.1, R4.2
unnamed: J3.4, R1.2
unnamed: J7.3 (D+), R8.1
unnamed: J7.2 (D-), R9.1
unnamed: J8.2, U2.18 (PB0)
unnamed: J9.2, U2.22 (PB11)
unnamed: Q1.3 (C), R10.2
unnamed: R8.2, U3.3 (I/O2)
unnamed: R9.2, U3.1 (I/O1)
