eddyem/stm32samples/F3:F303/NitrogenFlooding/kicad/sensors/sensors.kicad_pcb

## KiCad design F3:F303/NitrogenFlooding/kicad/sensors/sensors.kicad_pcb (2024-05-06)

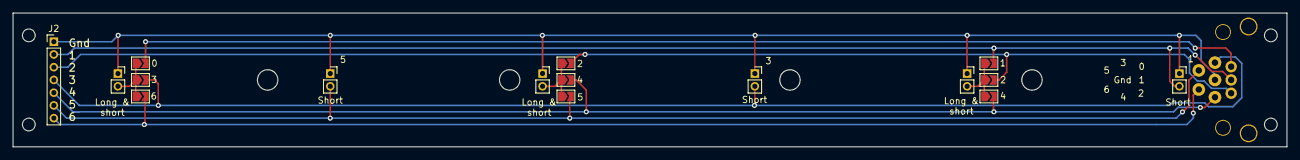
[picture p26: board sensors.kicad_pcb from above]

Board: 2 copper layers, 200.0 x 21.0 mm, 25 parts (0 on the bottom side), 11 nets.

Parts:
H1, H2, H3, H4: MountingHole; MountingHole_2mm
H5, H6, H7, H8: MountingHole; MountingHole_3.2mm_M3
J1: Conn_01x08; avia8
J2: Conn_01x08; PinHeader_1x07_P2.00mm_Vertical
JP1: 1; SolderJumper-2_P1.3mm_Open_TrianglePad1.0x1.5mm
JP2, JP4: 2; SolderJumper-2_P1.3mm_Open_TrianglePad1.0x1.5mm
JP3, JP5: 4; SolderJumper-2_P1.3mm_Open_TrianglePad1.0x1.5mm
JP6: 5; SolderJumper-2_P1.3mm_Open_TrianglePad1.0x1.5mm
JP7: 0; SolderJumper-2_P1.3mm_Open_TrianglePad1.0x1.5mm
JP8: 3; SolderJumper-2_P1.3mm_Open_TrianglePad1.0x1.5mm
JP9: 6; SolderJumper-2_P1.3mm_Open_TrianglePad1.0x1.5mm
TH1, TH2, TH3, TH4, TH5, TH6: PT1000; PinSocket_1x02_P2.00mm_Vertical

Connections:
/S1: JP1.1 (A), JP2.1 (A), JP3.1 (A), TH2.2
/S3: JP4.1 (A), JP5.1 (A), JP6.1 (A), TH4.2
/S5: JP7.1 (A), JP8.1 (A), JP9.1 (A), TH6.2
/Sa0: J1.1, JP7.2 (B)
/Sa1: J1.2, J2.2, JP1.2 (B), TH1.2
/Sa2: J1.3, J2.3, JP2.2 (B), JP4.2 (B)
/Sa3: J1.4, J2.4, JP8.2 (B), TH3.2
/Sa4: J1.6, J2.5, JP3.2 (B), JP5.2 (B)
/Sa5: J1.7, J2.6, JP6.2 (B), TH5.2
/Sa6: J1.8, J2.7, JP9.2 (B)
GND: J1.5, J2.1, TH1.1, TH2.1, TH3.1, TH4.1, TH5.1, TH6.1
