eddyem/stm32samples/F0:F030,F042,F072/CANbus4BTA/kicad/stm32.kicad_pcb

## KiCad design F0:F030,F042,F072/CANbus4BTA/kicad/stm32.kicad_pcb (2024-05-06)

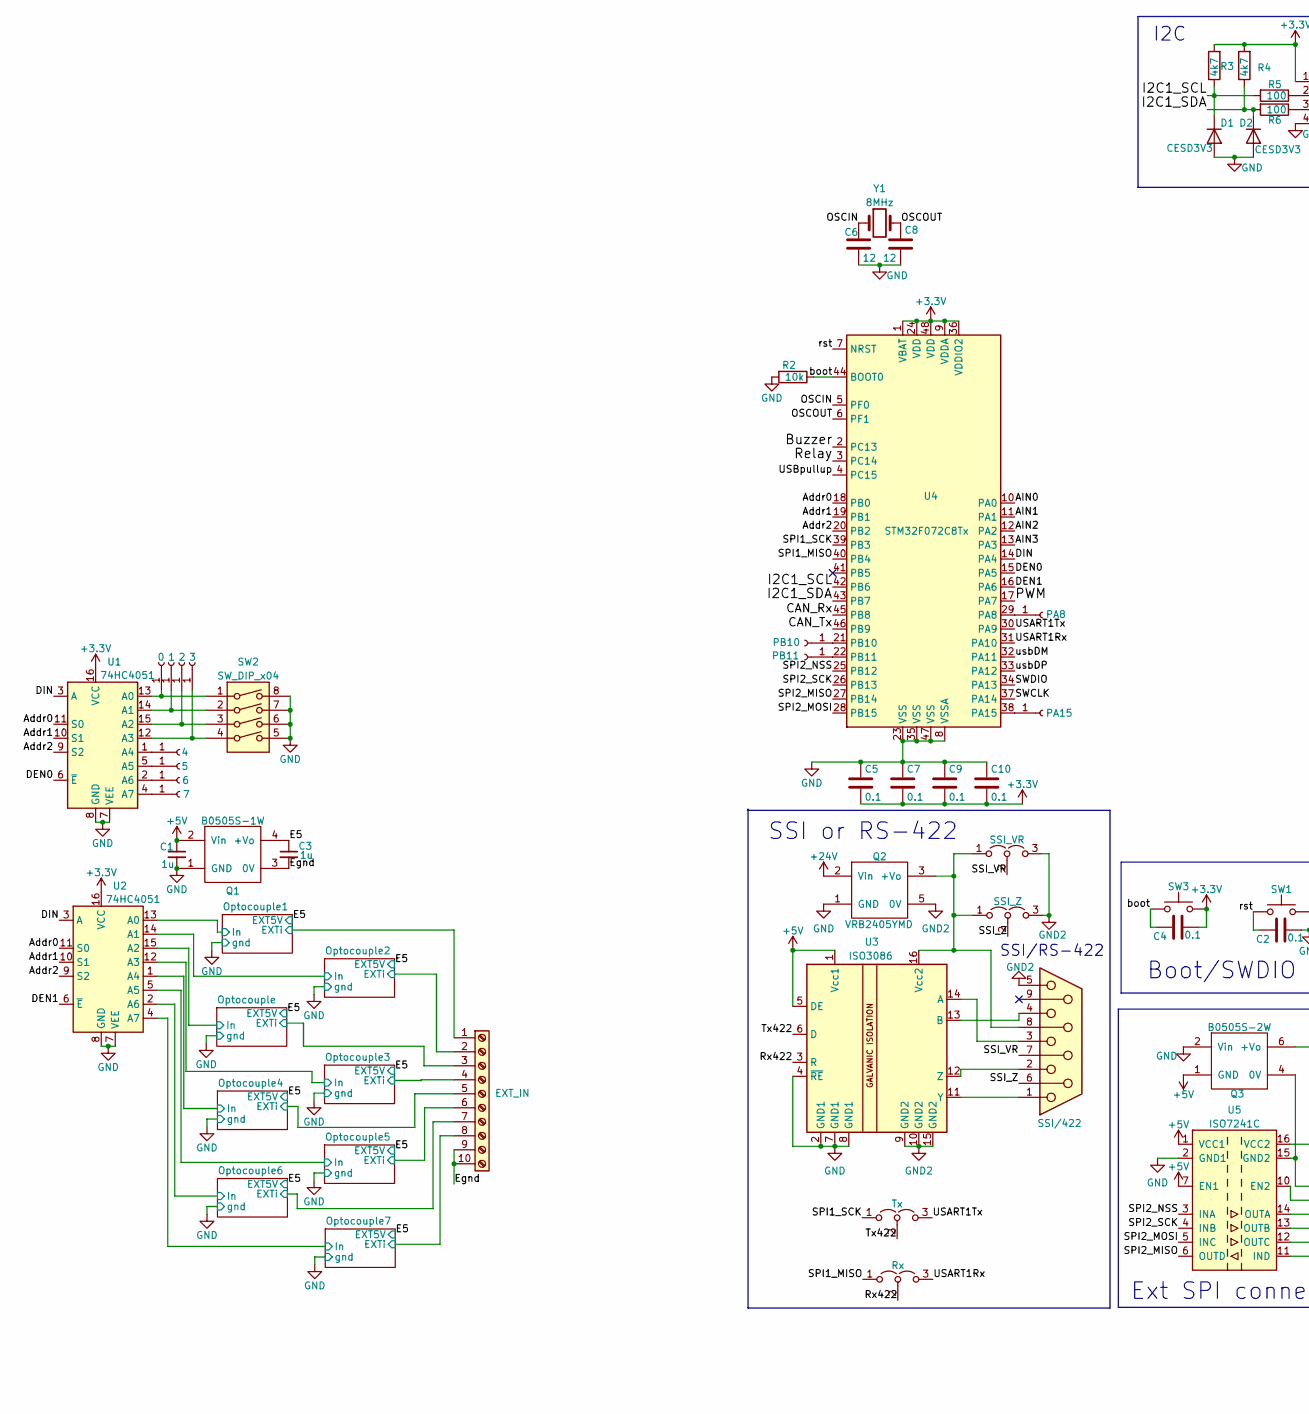
[picture p27: schematic stm32.kicad_sch, STM32F0x2 based USB<>CAN converter (isolated), part in row 1, column 1]

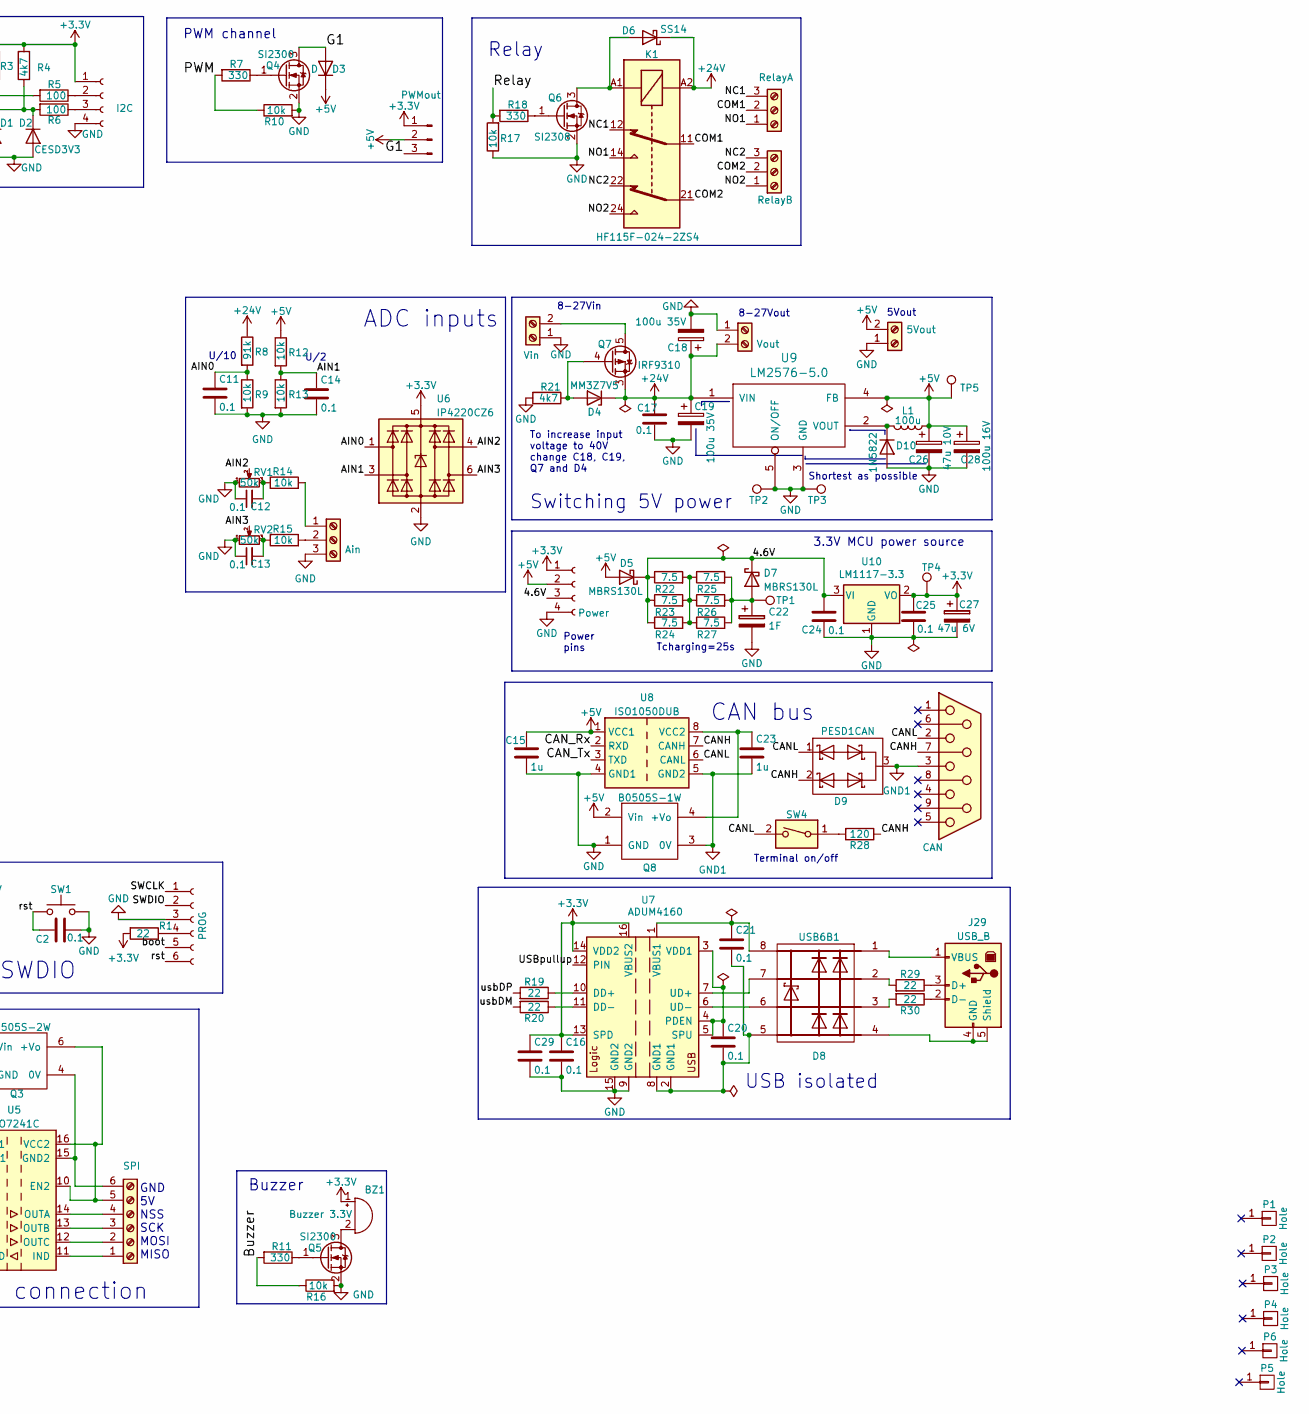
[picture p28: schematic stm32.kicad_sch, STM32F0x2 based USB<>CAN converter (isolated), part in row 1, column 2]

Parts:
BZ1: Buzzer 3.3V; Buzzer_12x9.5RM7.6
C1, C3, C15, C23: 1u; C_0805_2012Metric_Pad1.18x1.45mm_HandSolder
C2, C4, C5, C7, C9, C10, C11, C12, C13, C14, C16, C17, C20, C21, C24, C25, C29: 0.1; C_0603_1608Metric_Pad1.08x0.95mm_HandSolder
C6, C8: 12; C_0603_1608Metric_Pad1.08x0.95mm_HandSolder
C18, C19: 100u 35V; CP_Radial_D8.0mm_P3.50mm
C22: 1F; C_Rect_L18.0mm_W8.0mm_P15.00mm_FKS3_FKP3
C26: 47u 10V; CP_EIA-6032-28_Kemet-C_Pad2.25x2.35mm_HandSolder
C27: 47u 6V; CP_EIA-3216-18_Kemet-A_Pad1.58x1.35mm_HandSolder
C28: 100u 16V; CP_Radial_D8.0mm_P3.50mm
D1, D2: CESD3V3; D_0805_2012Metric_Pad1.15x1.40mm_HandSolder
D3: D; D_0805_2012Metric_Pad1.15x1.40mm_HandSolder
D4: MM3Z7V5; D_0805_2012Metric_Pad1.15x1.40mm_HandSolder
D5, D7: MBRS130L; D_SMB_Handsoldering
D6: SS14; D_SMA-SMB_Universal_Handsoldering
D8: USB6B1; SOIC-8_3.9x4.9mm_P1.27mm
D9: PESD1CAN; SOT-23
D10: 1N5822; D_DO-201_P3.81mm_Vertical_AnodeUp
J1: 0; PinSocket_1x01_P2.54mm_Vertical
J2: 1; PinSocket_1x01_P2.54mm_Vertical
J3: 4; PinSocket_1x01_P2.54mm_Vertical
J4: 5; PinSocket_1x01_P2.54mm_Vertical
J5: 6; PinSocket_1x01_P2.54mm_Vertical
J6: 7; PinSocket_1x01_P2.54mm_Vertical
J7: 2; PinSocket_1x01_P2.54mm_Vertical
J8: 3; PinSocket_1x01_P2.54mm_Vertical
J9: PROG; PinSocket_1x06_P1.27mm_Vertical
J10: RelayB; TerminalBlock_Phoenix_MKDS-1,5-3_1x03_P5.00mm_Horizontal
J15: PB10; PinSocket_1x01_P2.54mm_Vertical
J16: PB11; PinSocket_1x01_P2.54mm_Vertical
J17: PA15; PinSocket_1x01_P2.54mm_Vertical
J18: SSI/422; DSUB-9_Female_Horizontal_P2.77x2.84mm_EdgePinOffset4.94mm_H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
J19: I2C; JST_PH_B4B-PH-K_1x04_P2.00mm_Vertical
J20: SPI; TerminalBlock_Phoenix_MKDS-1,5-6_1x06_P5.00mm_Horizontal
J21: Ain; TerminalBlock_Phoenix_MKDS-1,5-3_1x03_P5.00mm_Horizontal
J22: PWMout; JST_PH_B3B-PH-K_1x03_P2.00mm_Vertical
J23: Vin; TerminalBlock_Phoenix_MKDS-1,5-2_1x02_P5.00mm_Horizontal
J24: Power; JST_PH_B4B-PH-K_1x04_P2.00mm_Vertical
J25: RelayA; TerminalBlock_Phoenix_MKDS-1,5-3_1x03_P5.00mm_Horizontal
J26: Vout; TerminalBlock_Phoenix_MKDS-1,5-2_1x02_P5.00mm_Horizontal
J27: 5Vout; TerminalBlock_Phoenix_MKDS-1,5-2_1x02_P5.00mm_Horizontal
J28: CAN; DSUB-9_Female_Horizontal_P2.77x2.84mm_EdgePinOffset4.94mm_H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
J29: USB_B; USB_B_OST_USB-B1HSxx_Horizontal
J30: EXT_IN; PhoenixContact_MC_1,5_10-GF-5.08_1x10_P5.08mm_Horizontal_Th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
J38: PA8; PinSocket_1x01_P2.54mm_Vertical
JP1: Tx; PinHeader_1x03_P2.54mm_Vertical
JP2: Rx; PinHeader_1x03_P2.54mm_Vertical
JP3: SSI_VR; PinHeader_1x03_P2.54mm_Vertical
JP4: SSI_Z; PinHeader_1x03_P2.54mm_Vertical
K1: HF115F-024-2ZS4; Relay_DPDT_Finder_40.52
L1: 100u; L_Toroid_Horizontal_D6.5mm_P10.00mm_Diameter7-5mm_Amidon-T25
P1, P2, P3, P4, P5, P6: Hole; Hole_3mm
Q1, Q8: B0505S-1W; B0x0xS
Q2: VRB2405YMD; VRB2405
Q3: B0505S-2W
Q4, Q5: SI2300; SOT-23_Handsoldering
Q6: SI2308; SOT-23_Handsoldering
Q7: IRF9310; SO-8_3.9x4.9mm_P1.27mm
R1, R19, R20, R29, R30: 22; R_0603_1608Metric_Pad0.98x0.95mm_HandSolder
R2, R9, R10, R12, R13, R14, R15, R16, R17: 10k; R_0603_1608Metric_Pad0.98x0.95mm_HandSolder
R3, R4, R21: 4k7; R_0603_1608Metric_Pad0.98x0.95mm_HandSolder
R5, R6: 100; R_0603_1608Metric_Pad0.98x0.95mm_HandSolder
R7, R11, R18: 330; R_0603_1608Metric_Pad0.98x0.95mm_HandSolder
R8: 91k; R_0603_1608Metric_Pad0.98x0.95mm_HandSolder
R22, R23, R24, R25, R26, R27: 7.5; R_2010_5025Metric_Pad1.40x2.65mm_HandSolder
R28: 120; R_1210_3225Metric_Pad1.30x2.65mm_HandSolder
RV1, RV2: 50k; Potentiometer_Bourns_3296W_Vertical
SW1, SW3: SW_Push; SW_SPST_FSMSM
SW2: SW_DIP_x04; SW_DIP_SPSTx04_Slide_9.78x12.34mm_W7.62mm_P2.54mm
SW4: SW_DIP_x01; SW_DIP_SPSTx01_Slide_6.7x4.1mm_W7.62mm_P2.54mm_LowProfile
TP1: 4.6V; PinSocket_1x01_P2.54mm_Vertical
TP2, TP3: Gnd; PinSocket_1x01_P2.54mm_Vertical
TP4: 3.3V; PinSocket_1x01_P2.54mm_Vertical
TP5: 5V; PinSocket_1x01_P2.54mm_Vertical
U1, U2: 74HC4051; SOIC-16_3.9x9.9mm_P1.27mm
U3: ISO3086; SOIC-16W_7.5x10.3mm_P1.27mm
U4: STM32F072C8Tx; LQFP-48_7x7mm_P0.5mm
U5: ISO7241C; SOIC-16W_7.5x10.3mm_P1.27mm
U6: IP4220CZ6; SOT-23-6
U7: ADUM4160; SOIC-16W_7.5x10.3mm_P1.27mm
U8: ISO1050DUB; SOP-8_6.62x9.15mm_P2.54mm
U9: LM2576-5.0; TO-220-5_P3.4x3.7mm_StaggerEven_Lead3.8mm_Vertical
U10: LM1117-3.3; SOT-223-3_TabPin2
Y1: 8MHz; Crystal_HC49-U_Vertical

Connections:
+3.3V: BZ1.1 (-), C4.2, C5.2, C7.2, C9.2, C10.2, C16.1, C25.1, C27.1, C29.1, J19.1, J22.1, J24.1, R1.2, R3.2, R4.2, SW3.2, TP4.1, U1.16 (VCC), U2.16 (VCC), U4.1 (VBAT), U4.9 (VDDA), U4.24 (VDD), U4.36 (VDDIO2), U4.48 (VDD), U6.5 (VBUS), U7.13 (SPD), U7.14 (VDD2), U7.16 (VBUS2), U10.2 (VO)
+5V: C1.1, C15.1, C26.1, C28.1, D3.1 (K), D5.2 (A), J22.2, J24.2, J27.2, L1.1, Q1.2 (Vin), Q3.1 (GND), Q8.2 (Vin), R12.1, TP5.1, U3.1 (Vcc1), U3.5 (DE), U5.1 (VCC1), U5.7 (EN1), U8.1 (VCC1), U9.4 (FB)
+24V: C17.1, C18.1, C19.1, D4.1 (K), D6.1 (K), J26.2, K1.A2, Q2.2 (Vin), Q7.1 (S), Q7.2 (S), Q7.3 (S), R8.1, U9.1 (VIN)
/4.6V: C24.1, D5.1 (K), D7.1 (K), J24.3, R22.1, R23.1, R24.1, U10.3 (VI)
/AIN0: C11.1, R8.2, R9.1, U4.10 (PA0), U6.1 (I/O1)
/AIN1: C14.1, R12.2, R13.1, U4.11 (PA1), U6.3 (I/O2)
/AIN2: RV1.2, U4.12 (PA2), U6.4 (I/O3)
/AIN3: RV2.2, U4.13 (PA3), U6.6 (I/O4)
/Addr0: U1.11 (S0), U2.11 (S0), U4.18 (PB0)
/Addr1: U1.10 (S1), U2.10 (S1), U4.19 (PB1)
/Addr2: U1.9 (S2), U2.9 (S2), U4.20 (PB2)
/Buzzer: R11.2, R16.1, U4.2 (PC13)
/CANH: D9.2 (K), J28.7, R28.1, U8.7 (CANH)
/CANL: D9.1 (K), J28.2, SW4.2, U8.6 (CANL)
/CAN_Rx: U4.45 (PB8), U8.2 (RXD)
/CAN_Tx: U4.46 (PB9), U8.3 (TXD)
/COM1: J25.2, K1.11
/COM2: J10.2, K1.21
/DEN0: U1.6 (~E), U4.15 (PA5)
/DEN1: U2.6 (~E), U4.16 (PA6)
/DIN: U1.3 (A), U2.3 (A), U4.14 (PA4)
/E5: C3.1, Q1.4 (+Vo); also elsewhere on the board
/Egnd: C3.2, J30.9, J30.10, Q1.3 (0V)
/G1: D3.2 (A), J22.3, Q4.3 (D)
/I2C1_SCL: D1.1 (K), R3.1, R5.2, U4.42 (PB6)
/I2C1_SDA: D2.1 (K), R4.1, R6.2, U4.43 (PB7)
/NC1: J25.3, K1.12
/NC2: J10.3, K1.22
/NO1: J25.1, K1.14
/NO2: J10.1, K1.24
/OSCIN: C6.1, U4.5 (PF0), Y1.1
/OSCOUT: C8.1, U4.6 (PF1), Y1.2
/Optocouple1/EXTi: J30.1; also elsewhere on the board
/Optocouple1/In: U2.13 (A0); also elsewhere on the board
/Optocouple2/EXTi: J30.2; also elsewhere on the board
/Optocouple2/In: U2.14 (A1); also elsewhere on the board
/Optocouple3/EXTi: J30.4; also elsewhere on the board
/Optocouple3/In: U2.12 (A3); also elsewhere on the board
/Optocouple4/EXTi: J30.5; also elsewhere on the board
/Optocouple4/In: U2.1 (A4); also elsewhere on the board
/Optocouple5/EXTi: J30.6; also elsewhere on the board
/Optocouple5/In: U2.5 (A5); also elsewhere on the board
/Optocouple6/EXTi: J30.7; also elsewhere on the board
/Optocouple6/In: U2.2 (A6); also elsewhere on the board
/Optocouple7/EXTi: J30.8; also elsewhere on the board
/Optocouple7/In: U2.4 (A7); also elsewhere on the board
/Optocouple/EXTi: J30.3; also elsewhere on the board
/Optocouple/In: U2.15 (A2); also elsewhere on the board
/PWM: R7.2, R10.1, U4.17 (PA7)
/Relay: R17.2, R18.2, U4.3 (PC14)
/Rx422: JP2.2 (C), U3.3 (R)
/SPI1_MISO: JP2.1 (A), U4.40 (PB4)
/SPI1_SCK: JP1.1 (A), U4.39 (PB3)
/SPI2_MISO: U4.27 (PB14), U5.6 (OUTD)
/SPI2_MOSI: U4.28 (PB15), U5.5 (INC)
/SPI2_NSS: U4.25 (PB12), U5.3 (INA)
/SPI2_SCK: U4.26 (PB13), U5.4 (INB)
/SSI_VR: J18.7, JP3.2 (C)
/SSI_Z: J18.6, JP4.2 (C)
/SWCLK: J9.1, U4.37 (PA14)
/SWDIO: J9.2, U4.34 (PA13)
/Tx422: JP1.2 (C), U3.6 (D)
/USART1Rx: JP2.3 (B), U4.31 (PA10)
/USART1Tx: JP1.3 (B), U4.30 (PA9)
/USBpullup: U4.4 (PC15), U7.12 (PIN)
/boot: C4.1, J9.5, R2.1, SW3.1, U4.44 (BOOT0)
/rst: C2.1, J9.6, SW1.1, U4.7 (NRST)
/usbDM: R20.2, U4.32 (PA11)
/usbDP: R19.2, U4.33 (PA12)
GND: C1.2, C2.2, C5.1, C6.2, C7.1, C8.2, C9.1, C10.1, C11.2, C12.1, C13.1, C14.2, C15.2, C16.2, C17.2, C18.2, C19.2, C22.2, C24.2, C25.2, C26.2, C27.2, C28.2, C29.2, D1.2 (A), D2.2 (A), D10.2 (A), J9.3, J19.4, J21.3, J23.1, J24.4, J26.1, J27.1, Q1.1 (GND), Q2.1 (GND), Q3.2 (Vin), Q4.2 (S), Q5.2 (S), Q6.2 (S), Q8.1 (GND), R2.2, R9.2, R10.2, R13.2, R16.2, R17.1, R21.2, RV1.1, RV2.1, SW1.2, SW2.5, SW2.6, SW2.7, SW2.8, TP2.1, TP3.1, U1.7 (VEE), U1.8 (GND), U2.7 (VEE), U2.8 (GND), U3.2 (GND1), U3.4 (~RE), U3.7 (GND1), U3.8 (GND1), U4.8 (VSSA), U4.23 (VSS), U4.35 (VSS), U4.47 (VSS), U5.2 (GND1), U5.8 (GND1), U6.2 (GND), U7.9 (GND2), U7.15 (GND2), U8.4 (GND1), U9.3 (GND), U9.5 (ON/OFF), U10.1 (GND); also elsewhere on the board
GND1: C23.2, D9.3 (O), J28.3, Q8.3 (0V), U8.5 (GND2)
GND2: J18.5, JP3.3 (B), JP4.3 (B), Q2.5 (0V), U3.9 (GND2), U3.10 (GND2), U3.15 (GND2)
unnamed: BZ1.2 (+), Q5.3 (D)
unnamed: C12.2, R14.1, RV1.3
unnamed: C13.2, R15.1, RV2.3
unnamed: C20.1, U7.3 (VDD1), U7.4 (PDEN), U7.5 (SPU)
unnamed: C20.2, C21.2, D8.5 (GND), U7.2 (GND1), U7.8 (GND1)
unnamed: C21.1, D8.8 (VCC), U7.1 (VBUS1)
unnamed: C22.1, D7.2 (A), R25.2, R26.2, R27.2, TP1.1
unnamed: C23.1, Q8.4 (+Vo), U8.8 (VCC2)
unnamed: D4.2 (A), Q7.4 (G), R21.1
unnamed: D6.2 (A), K1.A1, Q6.3 (D)
unnamed: D8.1 (VCC), J29.1 (VBUS)
unnamed: D8.2 (I/O1), R29.2
unnamed: D8.3 (I/O2), R30.2
unnamed: D8.4 (GND), J29.4 (GND), J29.5 (Shield)
unnamed: D8.6 (I/O2), U7.6 (UD-)
unnamed: D8.7 (I/O1), U7.7 (UD+)
unnamed: D10.1 (K), L1.2, U9.2 (VOUT)
unnamed: J1.1, SW2.1, U1.13 (A0)
unnamed: J2.1, SW2.2, U1.14 (A1)
unnamed: J3.1, U1.1 (A4)
unnamed: J4.1, U1.5 (A5)
unnamed: J5.1, U1.2 (A6)
unnamed: J6.1, U1.4 (A7)
unnamed: J7.1, SW2.3, U1.15 (A2)
unnamed: J8.1, SW2.4, U1.12 (A3)
unnamed: J9.4, R1.1
unnamed: J15.1, U4.21 (PB10)
unnamed: J16.1, U4.22 (PB11)
unnamed: J17.1, U4.38 (PA15)
unnamed: J18.1, U3.11 (Y)
unnamed: J18.2, U3.12 (Z)
unnamed: J18.3, U3.14 (A)
unnamed: J18.4, U3.13 (B)
unnamed: J18.8, JP3.1 (A), JP4.1 (A), Q2.3 (+Vo), U3.16 (Vcc2)
unnamed: J19.2, R5.1
unnamed: J19.3, R6.1
unnamed: J20.1, U5.11 (IND)
unnamed: J20.2, U5.12 (OUTC)
unnamed: J20.3, U5.13 (OUTB)
unnamed: J20.4, U5.14 (OUTA)
unnamed: J20.5, Q3.6 (+Vo), U5.10 (EN2), U5.16 (VCC2)
unnamed: J20.6, Q3.4 (0V), U5.9 (GND2), U5.15 (GND2)
unnamed: J21.1, R14.2
unnamed: J21.2, R15.2
unnamed: J23.2, Q7.5 (D), Q7.6 (D), Q7.7 (D), Q7.8 (D)
unnamed: J29.2 (D-), R30.1
unnamed: J29.3 (D+), R29.1
unnamed: J38.1, U4.29 (PA8)
unnamed: Q4.1 (G), R7.1
unnamed: Q5.1 (G), R11.1
unnamed: Q6.1 (G), R18.1
unnamed: R19.1, U7.10 (DD+)
unnamed: R20.1, U7.11 (DD-)
unnamed: R22.2, R23.2, R24.2, R25.1, R26.1, R27.1
unnamed: R28.2, SW4.1

Notes on the sheet:
8-27Vout
U/2
Switching 5V power
PWM channel
Buzzer
Shortest as possible
CAN bus
U/10
USB isolated
To increase input voltage to 40V change C18, C19, Q7 and D4
GND 5V NSS SCK MOSI MISO
Boot/SWDIO
3.3V MCU power source
Ext SPI connection
8-27Vin
Tcharging=25s
I2C
ADC inputs
Power pins
5Vout
Terminal on/off
Relay
SSI/RS-422
SSI or RS-422

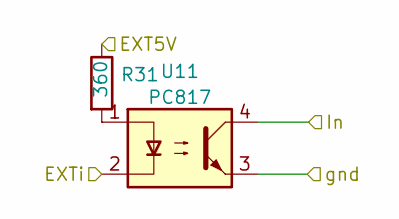
[picture p29: schematic optocouple.kicad_sch]

Parts:
R31: 360; R_0603_1608Metric_Pad0.98x0.95mm_HandSolder
U11: PC817; DIP-4_W7.62mm

Connections:
/E5: R31.1; also elsewhere on the board
/Optocouple/EXTi: U11.2; also elsewhere on the board
/Optocouple/In: U11.4; also elsewhere on the board
GND: U11.3; also elsewhere on the board
unnamed: R31.2, U11.1

Parts of its further copies:
R32, R33, R34, R35, R36, R37, R38: 360; R_0603_1608Metric_Pad0.98x0.95mm_HandSolder
U12, U13, U14, U15, U16, U17, U18: PC817; DIP-4_W7.62mm

Connections of its further copies:
/E5: R32.1, R33.1, R34.1, R35.1, R36.1, R37.1, R38.1; also elsewhere on the board
/Optocouple1/EXTi: U12.2; also elsewhere on the board
/Optocouple1/In: U12.4; also elsewhere on the board
/Optocouple2/EXTi: U13.2; also elsewhere on the board
/Optocouple2/In: U13.4; also elsewhere on the board
/Optocouple3/EXTi: U14.2; also elsewhere on the board
/Optocouple3/In: U14.4; also elsewhere on the board
/Optocouple4/EXTi: U15.2; also elsewhere on the board
/Optocouple4/In: U15.4; also elsewhere on the board
/Optocouple5/EXTi: U16.2; also elsewhere on the board
/Optocouple5/In: U16.4; also elsewhere on the board
/Optocouple6/EXTi: U17.2; also elsewhere on the board
/Optocouple6/In: U17.4; also elsewhere on the board
/Optocouple7/EXTi: U18.2; also elsewhere on the board
/Optocouple7/In: U18.4; also elsewhere on the board
GND: U12.3, U13.3, U14.3, U15.3, U16.3, U17.3, U18.3; also elsewhere on the board
unnamed: R32.2, U12.1
unnamed: R33.2, U13.1
unnamed: R34.2, U14.1
unnamed: R35.2, U15.1
unnamed: R36.2, U16.1
unnamed: R37.2, U17.1
unnamed: R38.2, U18.1

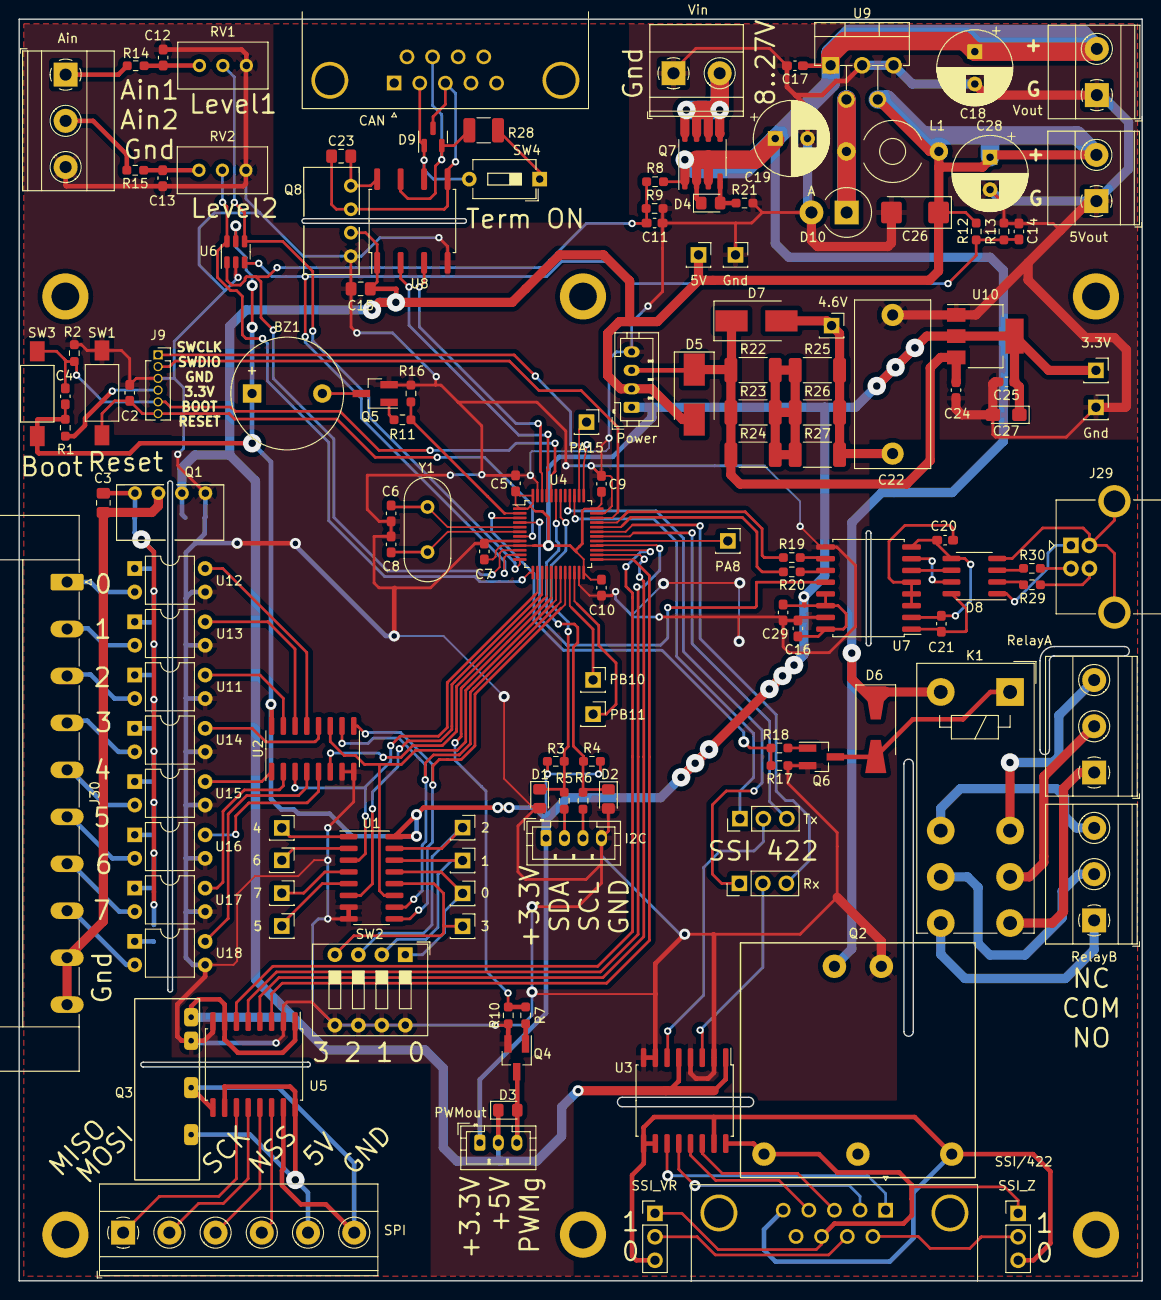
[picture p30: board F0:F030,F042,F072/CANbus4BTA/kicad/stm32.kicad_pcb from above]

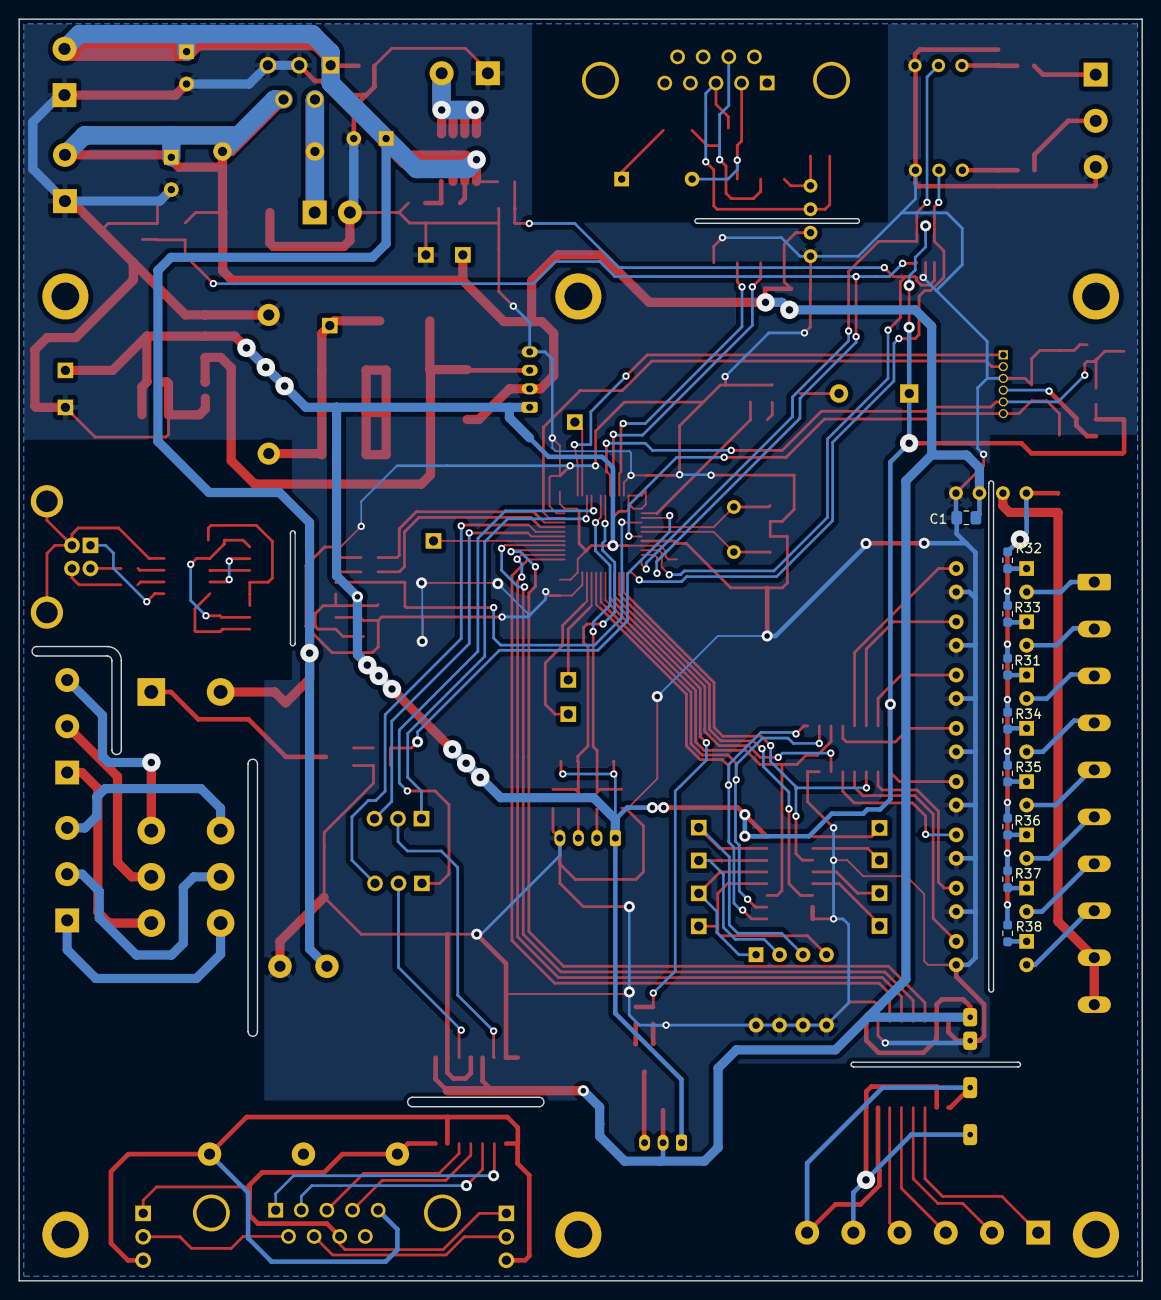
[picture p31: board F0:F030,F042,F072/CANbus4BTA/kicad/stm32.kicad_pcb from below]

Board: 2 copper layers, 121.5 x 136.5 mm, 155 parts (9 on the bottom side), 135 nets.
