eddyem/stm32samples/F1:F103/chronometer_v2/kicad/chrono.kicad_pcb

## KiCad design F1:F103/chronometer_v2/kicad/chrono.kicad_pcb (2024-05-06, an earlier design)

Schematic: chrono.kicad_sch

Parts:
BZ1: Buzzer 3v3; Buzzer_12x9.5RM7.6
C1, C2: 12; C_0603_1608Metric_Pad1.05x0.95mm_HandSolder
C3, C5, C6, C8, C9, C11, C12, C14, C15, C16, C17: 0.1; C_0603_1608Metric_Pad1.05x0.95mm_HandSolder
C4, C10: 10u; C_1206_3216Metric_Pad1.42x1.75mm_HandSolder
C7: 100u; CP_Radial_D8.0mm_P3.50mm
C13: 47u; CP_EIA-3216-18_Kemet-A_Pad1.58x1.35mm_HandSolder
D1: MM3Z7V5; D_0805_2012Metric_Pad1.15x1.40mm_HandSolder
D2, D3, D4, D5, D6, D10, D11: 1N5819; D_SOD-323_HandSoldering
D7: B340A; D_SMA_Handsoldering
D8: LED0; LED_D5.0mm
D9: LED1; LED_D5.0mm
J1: Power 12V; TerminalBlock_Phoenix_MKDS-1,5-2-5.08_1x02_P5.08mm_Horizont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
J2: GPS_ext; JST_PH_B5B-PH-K_1x05_P2.00mm_Vertical
J3: PPS; PinSocket_1x02_P2.54mm_Vertical
J4: Ext_trig1; TerminalBlock_Phoenix_MKDS-1,5-2-5.08_1x02_P5.08mm_Horizont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
J5: Ext_trig0; TerminalBlock_Phoenix_MKDS-1,5-2-5.08_1x02_P5.08mm_Horizont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
J6: USB_B_Mini; USB_Mini-B_Lumberg_2486_01_Horizontal
J7: Ext_trig2; TerminalBlock_Phoenix_MKDS-1,5-2-5.08_1x02_P5.08mm_Horizont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
J8: SPI; PinSocket_1x05_P2.54mm_Vertical
J9: I2C1; PinSocket_1x04_P2.54mm_Vertical
J10: LIDAR; PinSocket_1x04_P2.54mm_Vertical
J11: Bluetooth; PinSocket_1x06_P2.54mm_Vertical
J12: SWD; PinSocket_1x04_P2.54mm_Vertical
JP1, JP2, JP3, JP4: Jumper; PinHeader_1x02_P2.54mm_Vertical
L1: 100u; L_12x12mm_H4.5mm
P1: USB_B; USB_B_OST_USB-B1HSxx_Horizontal
Q1: MMBTA42; SOT-23_Handsoldering
Q2: AO3407; SOT-23_Handsoldering
Q3: SI2305; SOT-23_Handsoldering
Q4: IRML2502; SOT-23_Handsoldering
R1, R5, R8, R19, R23: 10k; R_0603_1608Metric_Pad1.05x0.95mm_HandSolder
R2: 2k2; R_0603_1608Metric_Pad1.05x0.95mm_HandSolder
R3, R4: 22; R_0603_1608Metric_Pad1.05x0.95mm_HandSolder
R6, R10, R11, R12, R20: 1k; R_0603_1608Metric_Pad1.05x0.95mm_HandSolder
R7, R18: 510; R_0603_1608Metric_Pad1.05x0.95mm_HandSolder
R9: 1k5; R_0603_1608Metric_Pad1.05x0.95mm_HandSolder
R13, R21: 100; R_0603_1608Metric_Pad1.05x0.95mm_HandSolder
R14, R24: 47k; R_0603_1608Metric_Pad1.05x0.95mm_HandSolder
R15, R16, R17: 220; R_0603_1608Metric_Pad1.05x0.95mm_HandSolder
R22: 100k; R_0603_1608Metric_Pad1.05x0.95mm_HandSolder
U1: USBLC6-2SC6; SOT-23-6_Handsoldering
U2: LM2576-5.0; TO-220-5_P3.4x3.7mm_StaggerEven_Lead3.8mm_Vertical
U3: 4N25; DIP-6_W7.62mm
U4: LM1117-3.3; SOT-223
U5: L80-R
U6: STM32F103C6Tx; LQFP-48_7x7mm_P0.5mm
U7: PC817; DIP-4_W7.62mm
Y1: 8MHz; Crystal_HC49-U_Vertical

Connections:
+5V: C7.1, C9.1, D2.1 (K), D6.1 (K), J8.5, J9.1, J10.4, J11.5, L1.1, Q1.3 (C), R24.1, U1.5 (VBUS), U2.4 (FB), U4.3 (VI)
/DM: J6.2 (D-), P1.2 (D-), U1.4 (I/O2)
/DP: J6.3 (D+), P1.3 (D+), R9.2, U1.6 (I/O1)
/LED0: D8.1 (K), U6.46 (PB9)
/LED1: D9.1 (K), U6.45 (PB8)
/MISO: J8.3, U6.16 (PA6)
/MOSI: J8.2, U6.17 (PA7)
/OSC_IN: C1.1, U6.5 (PD0), Y1.1
/OSC_OUT: C2.1, U6.6 (PD1), Y1.2
/PPS: J2.4, JP2.1, R1.1, R2.2, U6.11 (PA1)
/SCK: J8.4, U6.15 (PA5)
/SCL: J9.2, U6.42 (PB6)
/SDA: J9.3, U6.43 (PB7)
/SWCLK: J12.2, U6.37 (PA14)
/SWDIO: J12.3, U6.34 (PA13)
/TRIG0: R13.2, U6.18 (PB0)
/TRIG1: C8.1, R15.2, U3.5, U6.19 (PB1), U7.4
/TRIG2: R21.2, U6.39 (PB3)
/U1Rx: J11.3, U6.31 (PA10)
/U1Tx: J11.2, U6.30 (PA9)
/U2Rx: J10.2, U6.22 (PB11)
/U2Tx: J10.1, U6.21 (PB10)
/U3Rx: J2.3, JP4.1, U6.13 (PA3)
/U3Tx: J2.2, JP3.1, U6.12 (PA2)
/USBDM: R4.2, U6.32 (PA11)
/USBDP: R3.2, U6.33 (PA12)
/USB_PU: R7.2, R8.1, U6.38 (PA15)
/buzzer: R18.2, R19.1, U6.2 (PC13)
GND: C1.2, C2.2, C3.2, C4.2, C6.2, C7.2, C8.2, C9.2, C10.1, C11.1, C12.2, C13.2, C14.1, C15.1, C16.1, C17.1, D5.2 (A), D7.2 (A), D11.2 (A), J1.1, J2.1, J3.1, J5.1, J6.4 (ID), J6.5 (GND), J6.6 (Shield), J7.1, J8.1, J9.4, J10.3, J11.4, J12.4, P1.4 (GND), P1.5 (shield), Q4.2 (S), R1.2, R5.1, R6.1, R14.1, R19.2, R22.2, R23.2, U1.2 (GND), U2.3 (GND), U2.5 (ON/OFF), U3.4, U4.1 (GND/ADJ), U5.3 (Gnd), U5.12 (Gnd), U6.8 (VSSA), U6.23 (VSS), U6.35 (VSS), U6.47 (VSS), U7.3
unnamed: BZ1.2 (-), Q4.3 (D)
unnamed: C3.1, C4.1, D1.1 (K), Q2.2 (S), U2.1 (VIN)
unnamed: C5.1, D3.2 (A), R10.2, R11.2, U3.2, U7.2
unnamed: C5.2, D3.1 (K), J4.1, R11.1, U3.1, U7.1
unnamed: C6.1, D4.2 (A), D5.1 (K), J5.2, R12.1, R13.1
unnamed: C10.2, C11.2, JP1.2, U5.4 (Vcc), U5.5 (V_BKP)
unnamed: C12.1, D10.2 (A), D11.1 (K), J7.2, R20.1, R21.1
unnamed: D1.2 (A), Q2.1 (G), R5.2
unnamed: D2.2 (A), P1.1 (VBUS)
unnamed: D6.2 (A), J6.1 (VBUS)
unnamed: D7.1 (K), L1.2, U2.2 (VOUT)
unnamed: D8.2 (A), R16.1
unnamed: D9.2 (A), R17.1
unnamed: J1.2, Q2.3 (D)
unnamed: J3.2, Q1.2 (E), R6.2
unnamed: J4.2, R10.1
unnamed: J11.1, U6.29 (PA8)
unnamed: J11.6, R24.2
unnamed: JP2.2, U5.6 (PPS)
unnamed: JP3.2, U5.1 (RXD)
unnamed: JP4.2, U5.2 (TXD)
unnamed: Q1.1 (B), R2.1
unnamed: Q3.1 (G), R7.1
unnamed: Q3.3 (D), R9.1
unnamed: Q4.1 (G), R18.1
unnamed: R3.1, U1.1 (I/O1)
unnamed: R4.1, U1.3 (I/O2)
unnamed: R14.2, U3.6
unnamed: R22.1, U6.20 (PB2)
unnamed: R23.1, U6.44 (BOOT0)

Notes on the sheet:
5V power source
LED indicators
(opt)
GPS module
UART/Bluetooth: State Tx Rx Gnd Vcc Key/En
LIDAR: Rx Tx Gnd +5V
SWD: GND IO CLK VCC
USB
3.3V MCU power source
PA5 - SCK PA6 - MISO PA7 - MOSI
PPS proxy
Crystal
1.5A!
Optocouples
Solder U3 OR U7

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
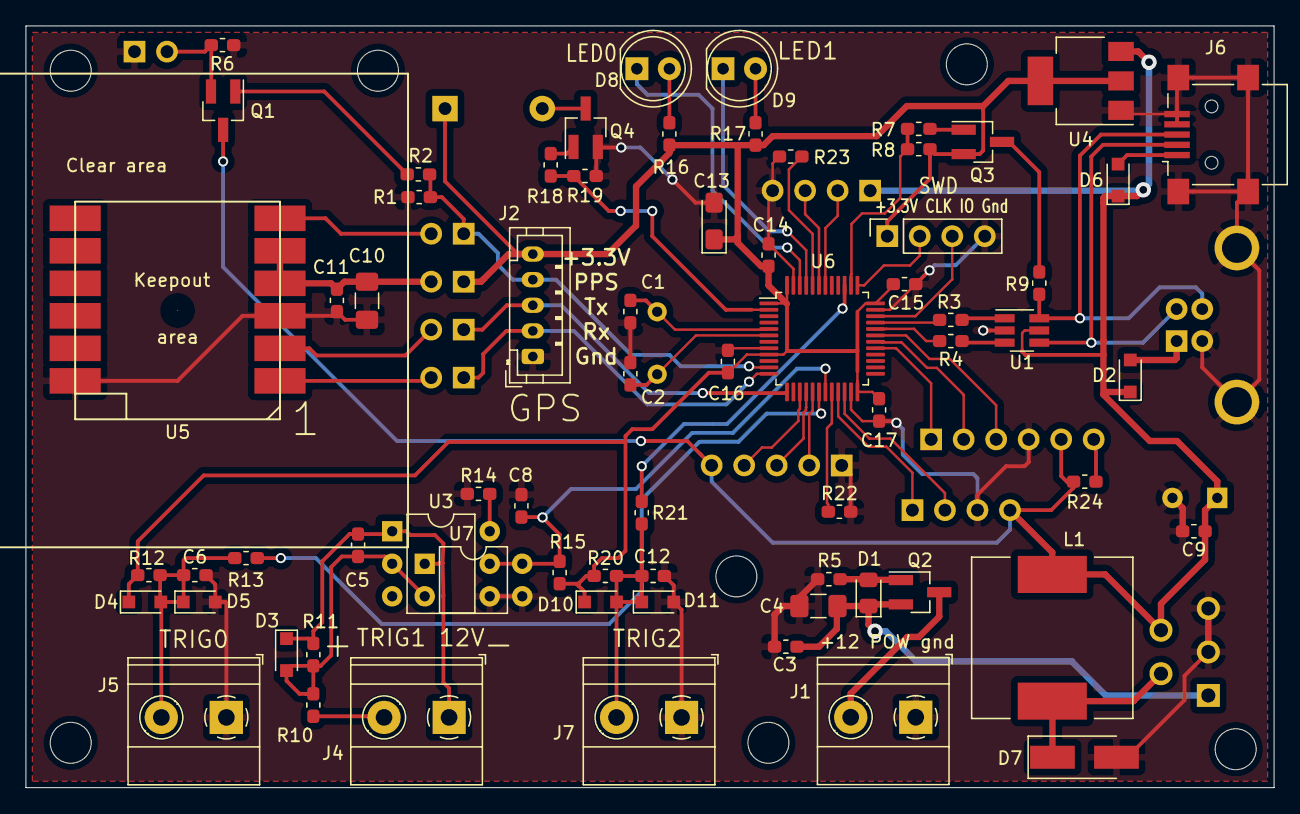
[picture p32: board chrono.kicad_pcb from above]

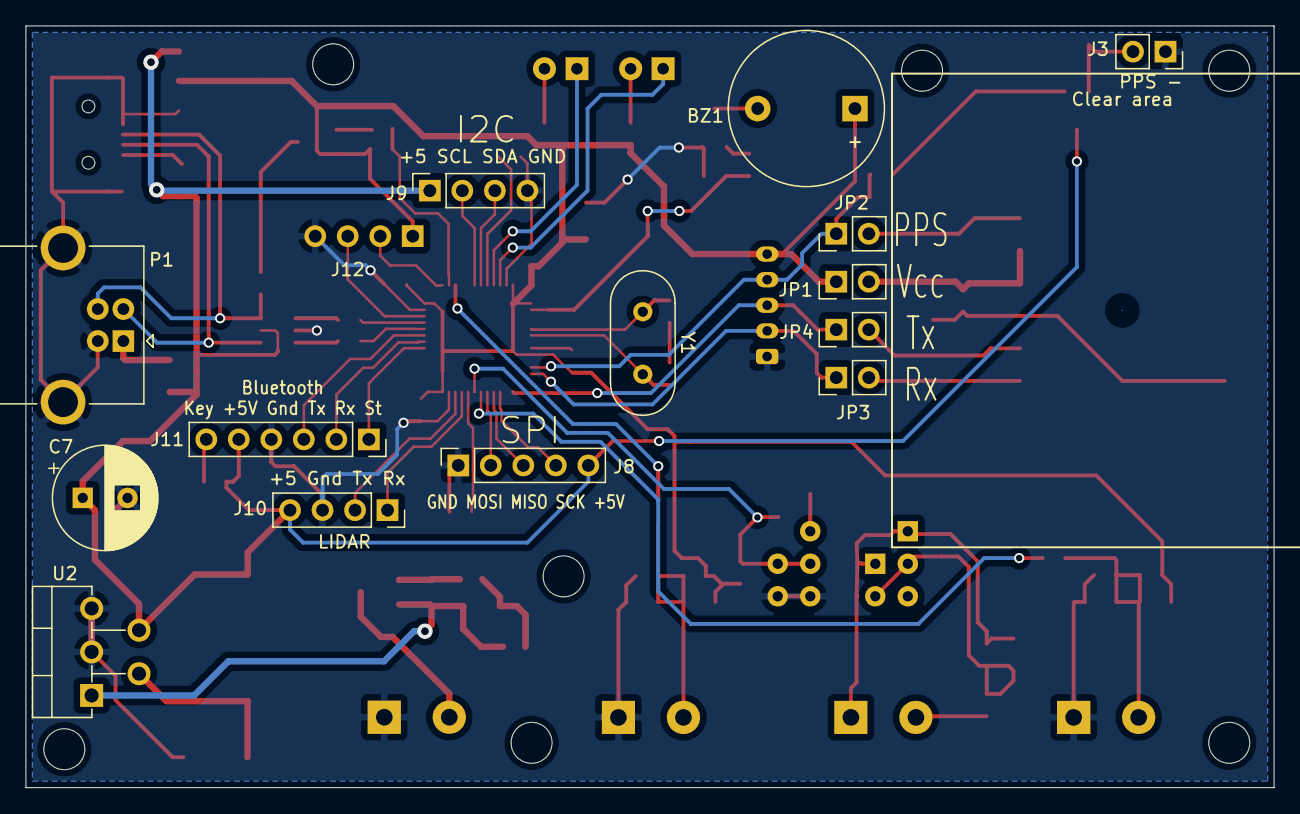
[picture p33: board chrono.kicad_pcb from below]

Board: 2 copper layers, 97.5 x 59.5 mm, 83 parts (14 on the bottom side), 60 nets.
