eddyem/stm32samples/F0:F030,F042,F072/Chiller/kicad/Chiller_control.kicad_pcb

## KiCad design F0:F030,F042,F072/Chiller/kicad/Chiller_control.kicad_pcb (2024-05-06)

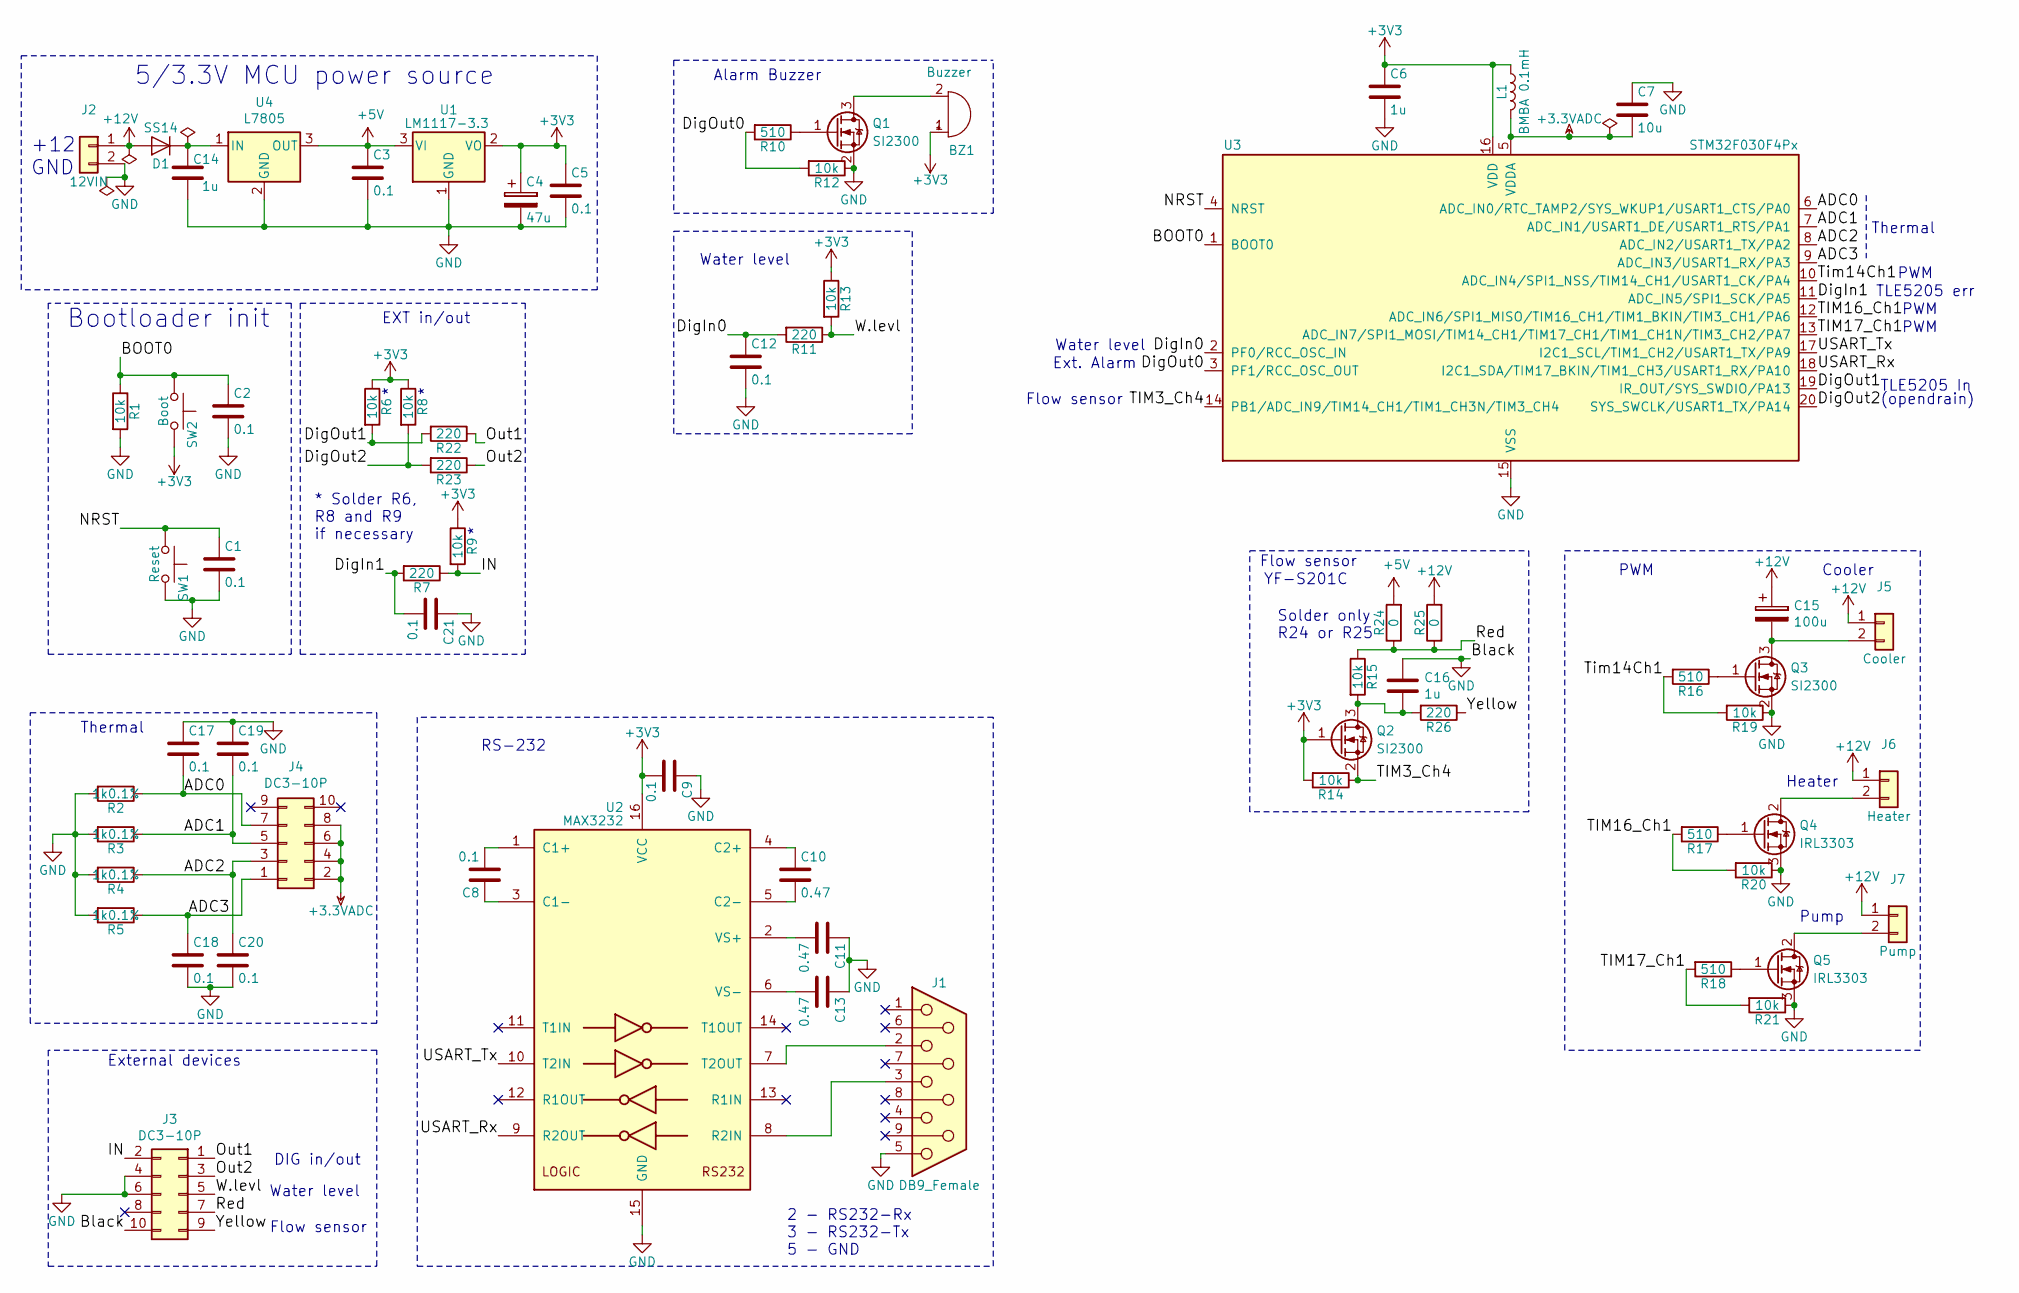
[picture p34: schematic Chiller_control.kicad_sch]

Parts:
BZ1: Buzzer; Buzzer_12x9.5RM7.6
C1, C2, C3, C5, C8, C9, C12, C17, C18, C19, C20, C21: 0.1; C_0603_1608Metric_Pad0.99x1.00mm_HandSolder
C4: 47u; CP_Tantalum_Case-A_EIA-3216-18_Hand
C6: 1u; C_0805_HandSoldering
C7: 10u; C_1206_HandSoldering
C10, C11, C13: 0.47; C_0805_HandSoldering
C14, C16: 1u; C_0805_2012Metric_Pad1.29x1.40mm_HandSolder
C15: 100u; CP_Radial_D8.0mm_P3.50mm
D1: SS14; D_SMA_Handsoldering
J1: DB9_Female; DB9-F
J2: 12VIN; TerminalBlock_Pheonix_MKDS1.5-2pol
J3, J4: DC3-10P; IDC-Header_2x05_P2.54mm_Vertical
J5: Cooler; TerminalBlock_Pheonix_MKDS1.5-2pol
J6: Heater; TerminalBlock_Pheonix_MKDS1.5-2pol
J7: Pump; TerminalBlock_Pheonix_MKDS1.5-2pol
L1: BMBA 0.1mH; R_0805_HandSoldering
Q1, Q2, Q3: SI2300; SOT-23_Handsoldering
Q4, Q5: IRL3303; TO-220-3_Vertical
R1, R6, R8, R9, R12, R13, R14, R15, R19, R20, R21: 10k; R_0603_HandSoldering
R2, R3, R4, R5: 1k0.1%; R_0805_HandSoldering
R7, R22, R23, R26: 220; R_0805_2012Metric_Pad1.29x1.40mm_HandSolder
R10, R16, R17, R18: 510; R_0603_HandSoldering
R11: 220; R_0805_HandSoldering
R24, R25: 0; R_0805_2012Metric_Pad1.29x1.40mm_HandSolder
SW1: Reset; SW_SPST_FSMSM
SW2: Boot; SW_SPST_FSMSM
U1: LM1117-3.3; SOT-223
U2: MAX3232; SOIC-16_3.9x9.9mm_Pitch1.27mm
U3: STM32F030F4Px; TSSOP-20_4.4x6.5mm_Pitch0.65mm
U4: L7805; TO-220-3_Vertical

Connections:
+3.3VADC: C7.2, J4.2, J4.4, J4.6, J4.8, L1.2, U3.5 (VDDA)
+3V3: BZ1.1 (+), C4.1, C5.1, C6.1, C9.2, L1.1, Q2.1 (G), R6.1, R8.1, R9.1, R13.1, R14.2, SW2.2, U1.2 (VO), U2.16 (VCC), U3.16 (VDD)
+5V: C3.1, R24.2, U1.3 (VI), U4.3 (OUT)
+12V: C15.1, D1.2 (A), J2.1, J5.1, J6.1, J7.1, R25.2
/ADC0: C17.2, J4.7, R2.1, U3.6 (ADC_IN0/RTC_TAMP2/SYS_WKUP1/USART1_CTS/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)
/ADC1: C19.2, J4.5, R3.1, U3.7 (ADC_IN1/USART1_DE/USART1_RTS/PA1)
/ADC2: C20.1, J4.3, R4.1, U3.8 (ADC_IN2/USART1_TX/PA2)
/ADC3: C18.1, J4.1, R5.1, U3.9 (ADC_IN3/USART1_RX/PA3)
/BOOT0: C2.1, R1.1, SW2.1, U3.1 (BOOT0)
/DigIn0: C12.1, R11.2, U3.2 (PF0/RCC_OSC_IN)
/DigIn1: C21.2, R7.2, U3.11 (ADC_IN5/SPI1_SCK/PA5)
/DigOut0: R10.2, R12.2, U3.3 (PF1/RCC_OSC_OUT)
/DigOut1: R6.2, R22.2, U3.19 (IR_OUT/SYS_SWDIO/PA13)
/DigOut2: R8.2, R23.2, U3.20 (SYS_SWCLK/USART1_TX/PA14)
/IN: J3.2, R7.1, R9.2
/NRST: C1.1, SW1.1, U3.4 (NRST)
/Out1: J3.1, R22.1
/Out2: J3.3, R23.1
/Red: J3.7, R15.1, R24.1, R25.1
/TIM3_Ch4: Q2.2 (S), R14.1, U3.14 (PB1/ADC_IN9/TIM14_CH1/TIM1_CH3N/TIM3_CH4)
/TIM16_Ch1: R17.2, R20.2, U3.12 (ADC_IN6/SPI1_MISO/TIM16_CH1/TIM1_BKIN/T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)
/TIM17_Ch1: R18.2, R21.2, U3.13 (ADC_IN7/SPI1_MOSI/TIM14_CH1/TIM17_CH1/T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)
/Tim14Ch1: R16.2, R19.2, U3.10 (ADC_IN4/SPI1_NSS/TIM14_CH1/USART1_CK/PA4)
/USART_Rx: U2.9 (R2OUT), U3.18 (I2C1_SDA/TIM17_BKIN/TIM1_CH3/USART1_RX/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)
/USART_Tx: U2.10 (T2IN), U3.17 (I2C1_SCL/TIM1_CH2/USART1_TX/PA9)
/W.levl: J3.5, R11.1, R13.2
/Yellow: J3.9, R26.1
GND: C1.2, C2.2, C3.2, C4.2, C5.2, C6.2, C7.1, C9.1, C11.1, C12.2, C13.1, C14.2, C16.1, C17.1, C18.2, C19.1, C20.2, C21.1, J1.5, J2.2, J3.4, J3.6, J3.10, Q1.2 (S), Q3.2 (S), Q4.3 (S), Q5.3 (S), R1.2, R2.2, R3.2, R4.2, R5.2, R12.1, R19.1, R20.1, R21.1, SW1.2, U1.1 (GND), U2.15 (GND), U3.15 (VSS), U4.2 (GND)
unnamed: BZ1.2 (-), Q1.3 (D)
unnamed: C8.1, U2.3 (C1-)
unnamed: C8.2, U2.1 (C1+)
unnamed: C10.1, U2.4 (C2+)
unnamed: C10.2, U2.5 (C2-)
unnamed: C11.2, U2.2 (VS+)
unnamed: C13.2, U2.6 (VS-)
unnamed: C14.1, D1.1 (K), U4.1 (IN)
unnamed: C15.2, J5.2, Q3.3 (D)
unnamed: C16.2, Q2.3 (D), R15.2, R26.2
unnamed: J1.2, U2.7 (T2OUT)
unnamed: J1.3, U2.8 (R2IN)
unnamed: J6.2, Q4.2 (D)
unnamed: J7.2, Q5.2 (D)
unnamed: Q1.1 (G), R10.1
unnamed: Q3.1 (G), R16.1
unnamed: Q4.1 (G), R17.1
unnamed: Q5.1 (G), R18.1

Notes on the sheet:
Thermal
Solder only R24 or R25
Alarm Buzzer
Water level
PWM
+12 GND
Ext. Alarm
Bootloader init
RS-232
EXT in/out
5/3.3V MCU power source
* Solder R6, R8 and R9 if necessary
Cooler
Flow sensor
(opendrain)
DIG in/out
External devices
TLE5205 In
Pump
TLE5205 err
2 - RS232-Rx 3 - RS232-Tx 5 - GND
YF-S201C
Heater

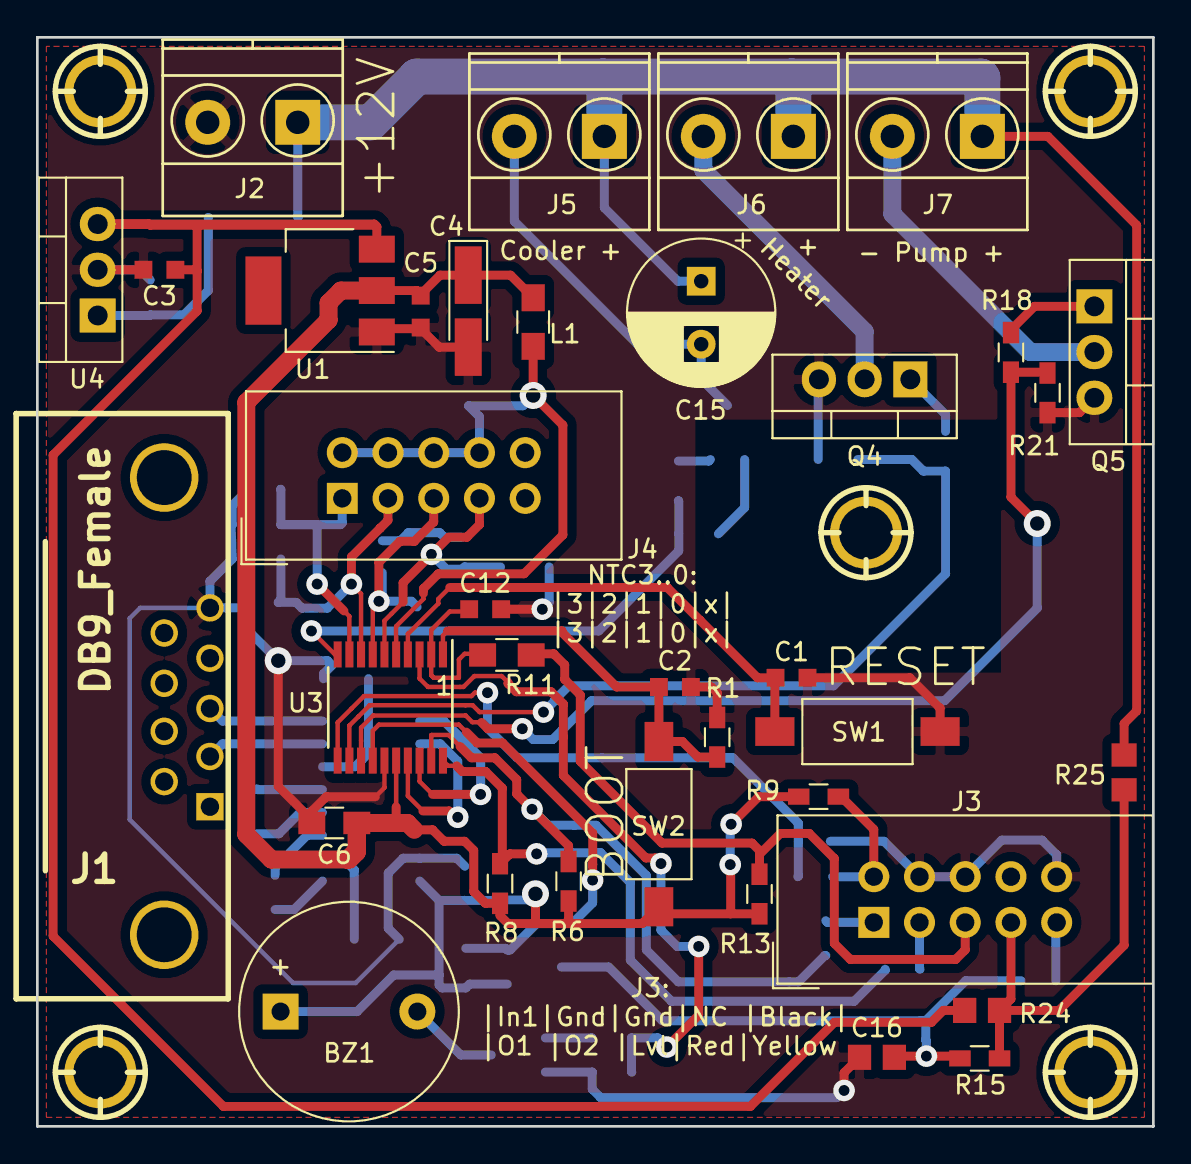
[picture p35: board Chiller_control.kicad_pcb from above]

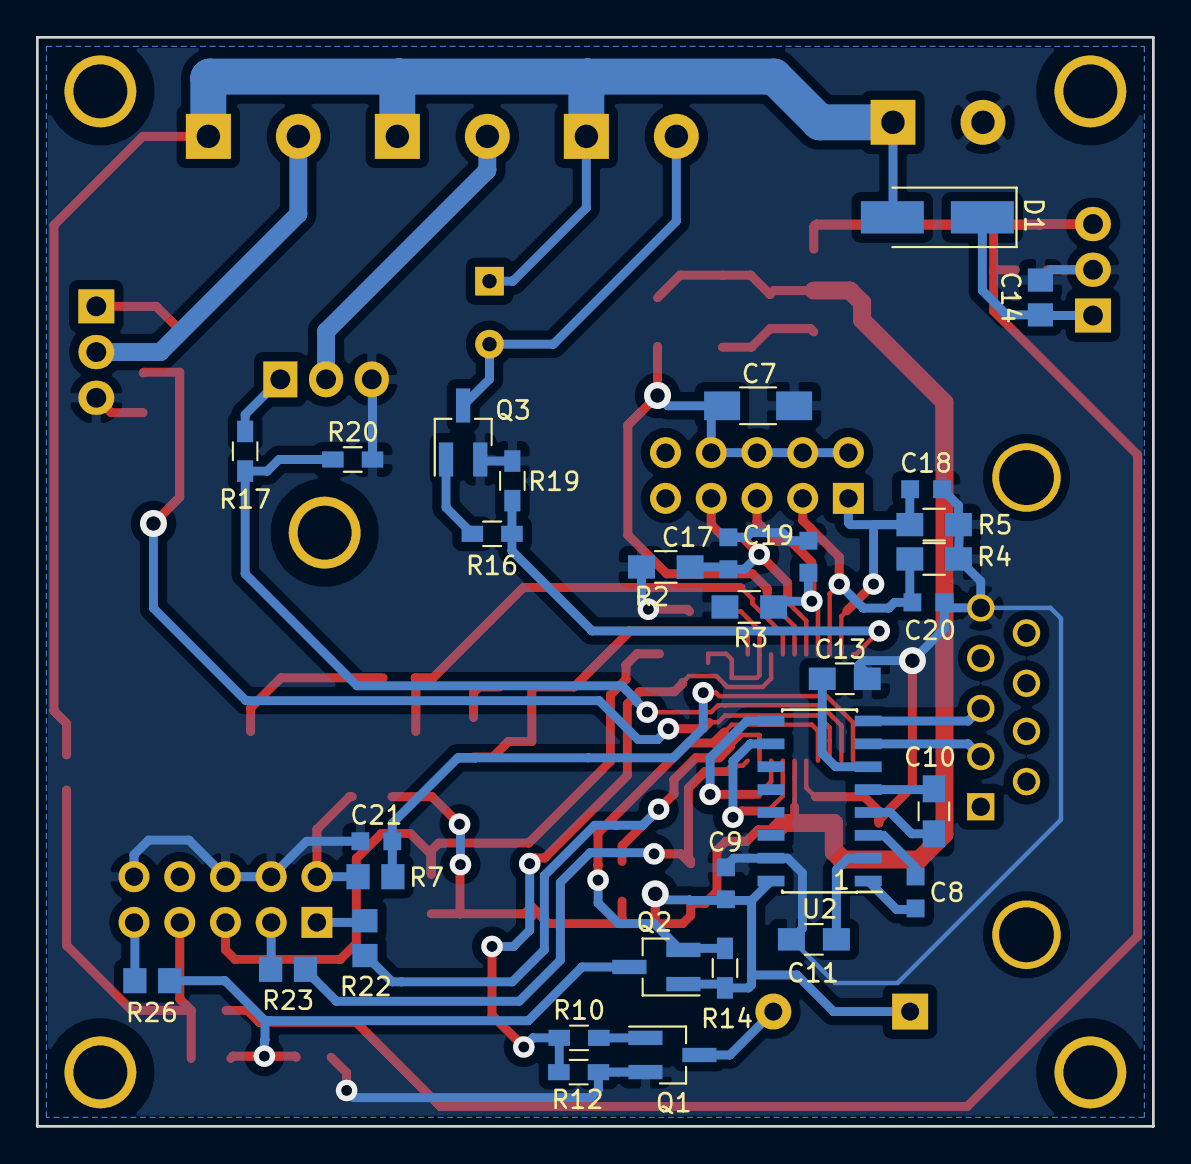
[picture p36: board Chiller_control.kicad_pcb from below]

Board: 2 copper layers, 62.0 x 60.5 mm, 73 parts (32 on the bottom side), 46 nets.

Other parts of the board:
hole_3mm, hole_3mm#2, hole_3mm#3, hole_3mm#4, hole_3mm#5: Val**; hole_3mm
