eddyem/stm32samples/F0:F030,F042,F072/usbcan_relay/kicad/stm32.kicad_pcb

## KiCad design F0:F030,F042,F072/usbcan_relay/kicad/stm32.kicad_pcb (2024-05-06)

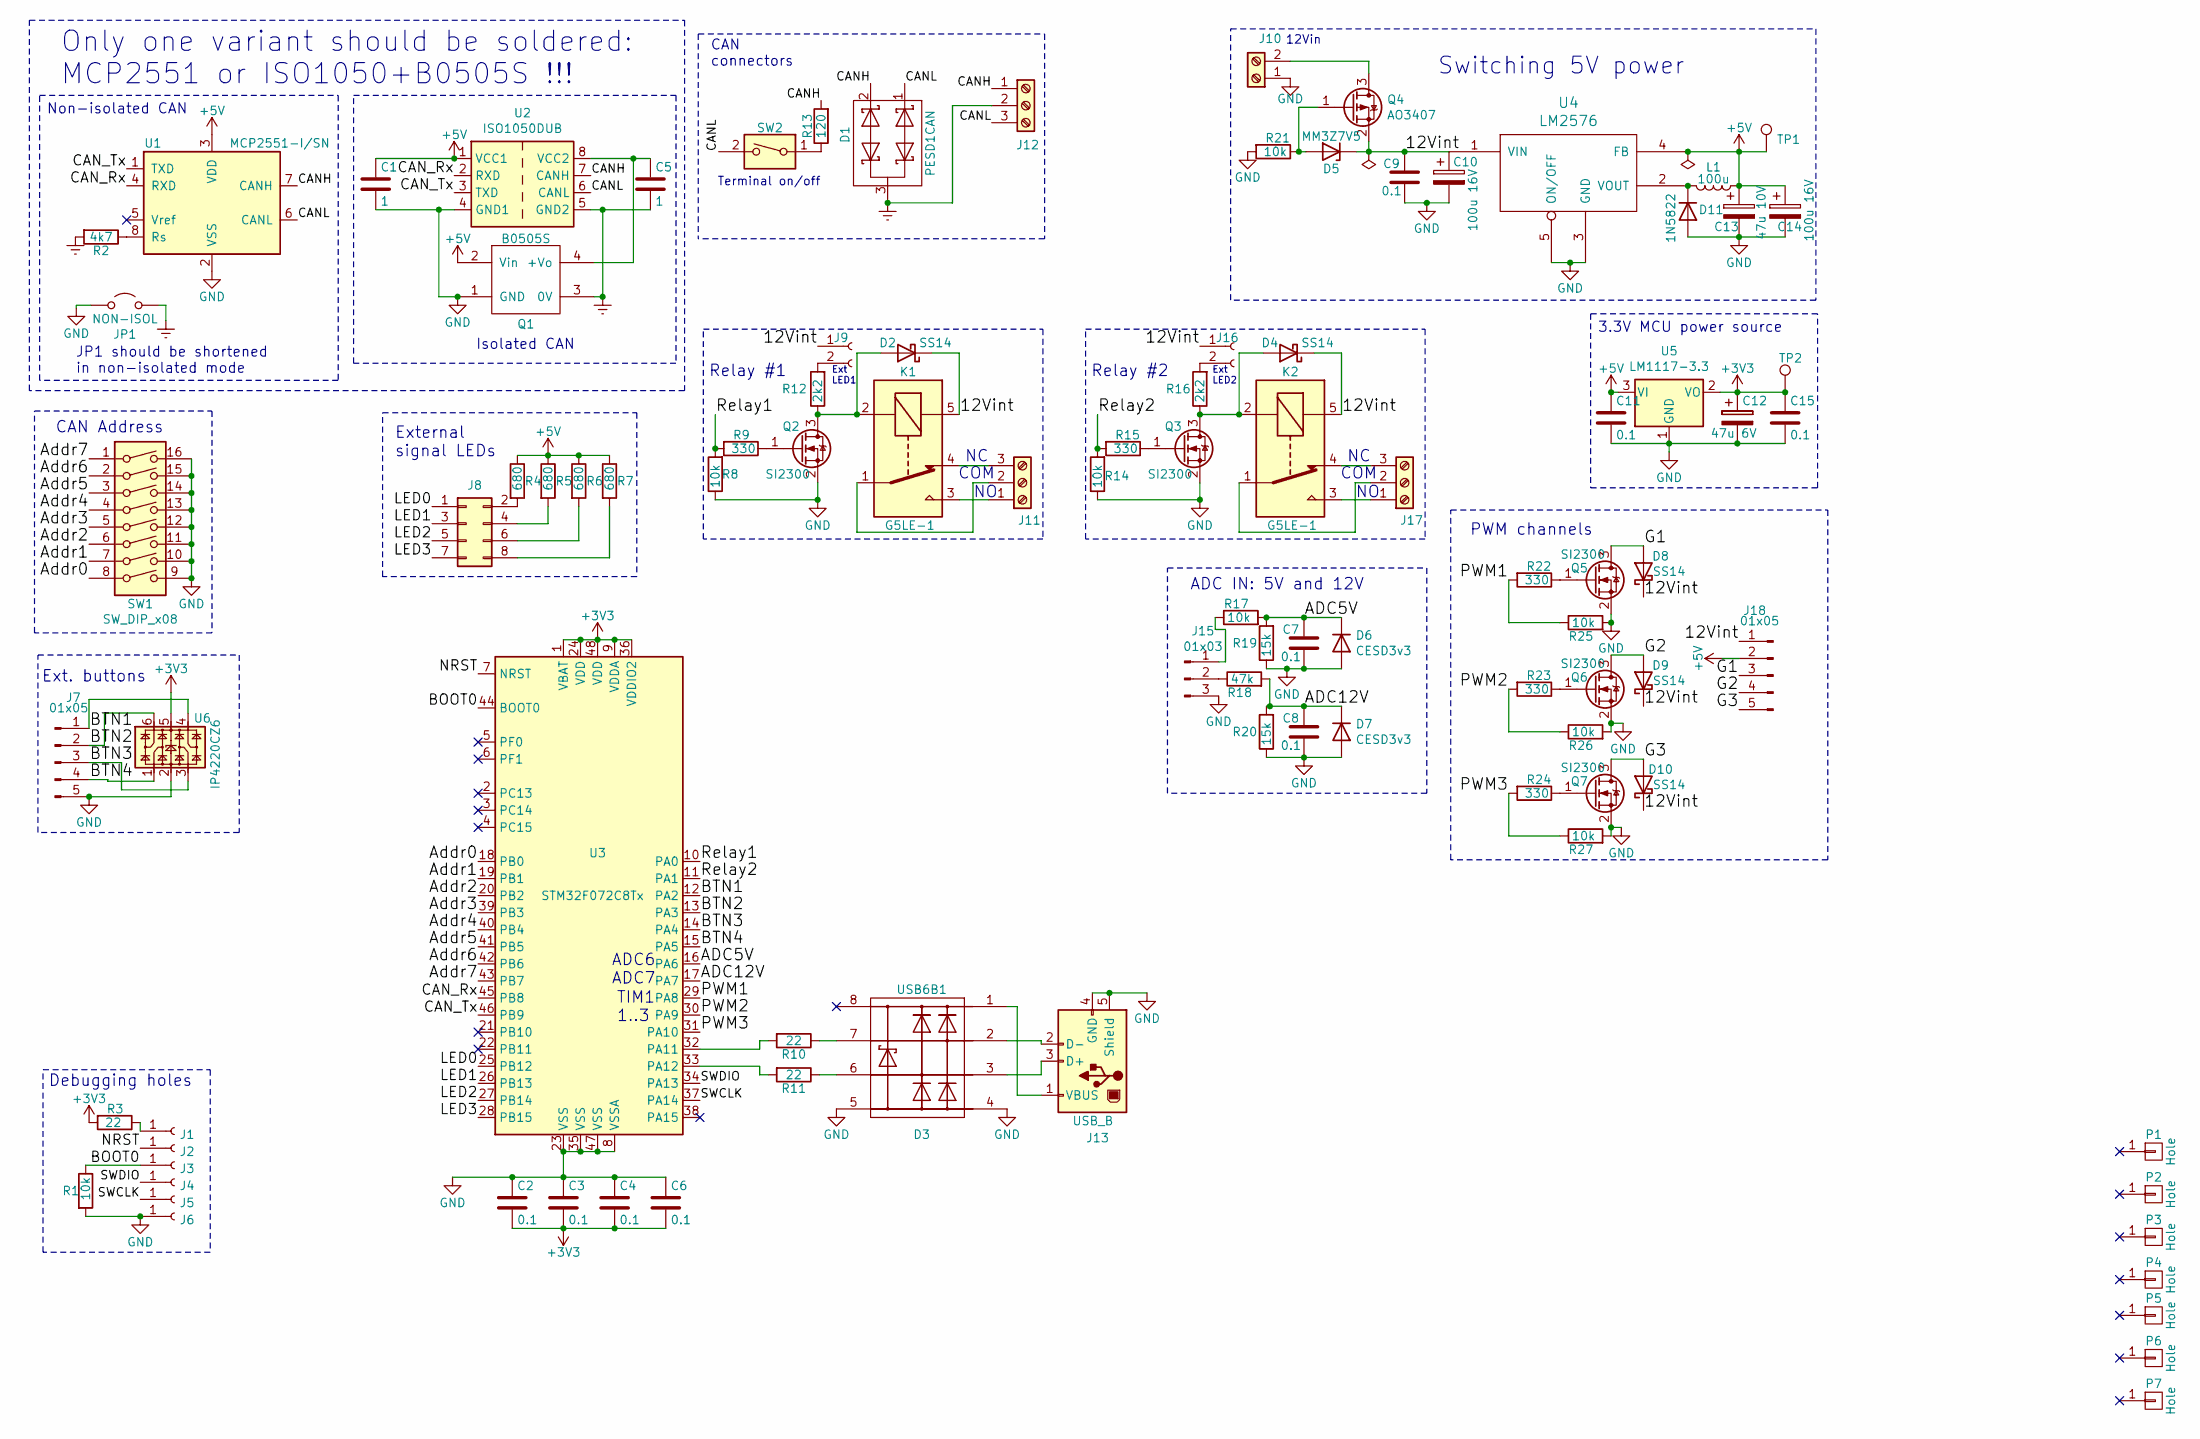
[picture p37: schematic stm32.kicad_sch, STM32F0x2 based USB<>CAN converter (isolated)]

Parts:
C1, C5: 1; C_0805_2012Metric_Pad1.15x1.40mm_HandSolder
C2, C3, C4, C6, C7, C8, C9, C11, C15: 0.1; C_0603_1608Metric_Pad1.05x0.95mm_HandSolder
C10, C14: 100u 16V; CP_Radial_D8.0mm_P3.50mm
C12: 47u 6V; CP_EIA-3216-18_Kemet-A_Pad1.58x1.35mm_HandSolder
C13: 47u 10V; CP_EIA-6032-28_Kemet-C_Pad2.25x2.35mm_HandSolder
D1: PESD1CAN; SOT-23
D2, D4, D8, D9, D10: SS14; D_SMA-SMB_Universal_Handsoldering
D3: USB6B1; SOIC-8_3.9x4.9mm_P1.27mm
D5: MM3Z7V5; D_0805_2012Metric_Pad1.15x1.40mm_HandSolder
D6, D7: CESD3v3; D_SOD-523
D11: 1N5822; D_DO-201_P3.81mm_Vertical_AnodeUp
J1: +3.3V; PinHeader_1x01_P2.54mm_Vertical
J2: NRST; PinHeader_1x01_P2.54mm_Vertical
J3: BOOT0; PinHeader_1x01_P2.54mm_Vertical
J4: SWDIO; PinHeader_1x01_P2.54mm_Vertical
J5: SWCLK; PinHeader_1x01_P2.54mm_Vertical
J6: GND; PinHeader_1x01_P2.54mm_Vertical
J7: 01x05; PinHeader_1x05_P2.54mm_Vertical
J8: Connector_Generic:Conn_02x04_Odd_Even; PinHeader_2x04_P2.54mm_Vertical
J9, J16: Conn_01x02_Female; PinSocket_1x02_P2.54mm_Vertical
J10: Screw_Terminal_01x02; TerminalBlock_Phoenix_MKDS-1,5-2_1x02_P5.00mm_Horizontal
J11, J12, J17: Screw_Terminal_01x03; TerminalBlock_Phoenix_MKDS-1,5-3_1x03_P5.00mm_Horizontal
J13: USB_B; USB_B_OST_USB-B1HSxx_Horizontal
J15: 01x03; PinSocket_1x03_P2.54mm_Vertical
J18: 01x05; PinSocket_1x05_P2.54mm_Vertical
JP1: NON-ISOL; R_Axial_DIN0207_L6.3mm_D2.5mm_P5.08mm_Vertical
K1, K2: G5LE-1; Relay_SPDT_SANYOU_SRD_Series_Form_C
L1: 100u; L_12x12mm_H4.5mm
P1, P2, P3, P4, P5, P6, P7: Hole; Hole_3mm
Q1: B0505S; B0x0xS
Q2, Q3, Q5, Q6, Q7: SI2300; SOT-23_Handsoldering
Q4: AO3407; SOT-23_Handsoldering
R1, R8, R14, R17, R21, R25, R26, R27: 10k; R_0603_1608Metric_Pad1.05x0.95mm_HandSolder
R2: 4k7; R_0603_1608Metric_Pad1.05x0.95mm_HandSolder
R3, R10, R11: 22; R_0603_1608Metric_Pad1.05x0.95mm_HandSolder
R4, R5, R6, R7: 680; R_0603_1608Metric_Pad1.05x0.95mm_HandSolder
R9, R15, R22, R23, R24: 330; R_0603_1608Metric_Pad1.05x0.95mm_HandSolder
R12, R16: 2k2; R_0603_1608Metric_Pad1.05x0.95mm_HandSolder
R13: 120; R_1210_3225Metric_Pad1.42x2.65mm_HandSolder
R18: 47k; R_0603_1608Metric_Pad1.05x0.95mm_HandSolder
R19, R20: 15k; R_0603_1608Metric_Pad1.05x0.95mm_HandSolder
SW1: SW_DIP_x08; SW_DIP_SPSTx08_Slide_9.78x22.5mm_W7.62mm_P2.54mm
SW2: SW_DIP_x01; SW_DIP_SPSTx01_Slide_6.7x4.1mm_W7.62mm_P2.54mm_LowProfile
TP1: 5V; PinSocket_1x01_P2.54mm_Vertical
TP2: 3.3V; PinSocket_1x01_P2.54mm_Vertical
U1: MCP2551-I/SN; SOIC-8_3.9x4.9mm_P1.27mm
U2: ISO1050DUB; SOP-8_6.62x9.15mm_P2.54mm
U3: STM32F072C8Tx; LQFP-48_7x7mm_P0.5mm
U4: LM2576; TO-220-5_P3.4x3.7mm_StaggerEven_Lead3.8mm_Vertical
U5: LM1117-3.3; SOT-223-3_TabPin2
U6: IP4220CZ6; TSOP-6_1.65x3.05mm_P0.95mm

Connections:
+3V3: C2.2, C3.2, C4.2, C6.2, C12.1, C15.1, R3.2, TP2.1, U3.1 (VBAT), U3.9 (VDDA), U3.24 (VDD), U3.36 (VDDIO2), U3.48 (VDD), U5.2 (VO), U6.5
+5V: C1.1, C11.1, C13.1, C14.1, J18.2, L1.1, Q1.2 (Vin), R4.1, R5.1, R6.1, R7.1, TP1.1, U1.3 (VDD), U2.1 (VCC1), U4.4 (FB), U5.3 (VI)
/12Vint: C9.1, C10.1, D2.1 (K), D4.1 (K), D5.1 (K), D8.1 (K), D9.1 (K), D10.1 (K), J9.1, J16.1, J18.1, K1.5, K2.5, Q4.2 (S), U4.1 (VIN)
/ADC5V: C7.1, D6.1 (K), R17.2, R19.2, U3.16 (PA6)
/ADC12V: C8.1, D7.1 (K), R18.2, R20.2, U3.17 (PA7)
/Addr0: SW1.8, U3.18 (PB0)
/Addr1: SW1.7, U3.19 (PB1)
/Addr2: SW1.6, U3.20 (PB2)
/Addr3: SW1.5, U3.39 (PB3)
/Addr4: SW1.4, U3.40 (PB4)
/Addr5: SW1.3, U3.41 (PB5)
/Addr6: SW1.2, U3.42 (PB6)
/Addr7: SW1.1, U3.43 (PB7)
/BOOT0: J3.1, R1.1, U3.44 (BOOT0)
/BTN1: J7.1, U3.12 (PA2), U6.4
/BTN2: J7.2, U3.13 (PA3), U6.6
/BTN3: J7.3, U3.14 (PA4), U6.3
/BTN4: J7.4, U3.15 (PA5), U6.1
/CANH: D1.2 (K), J12.1, R13.2, U1.7 (CANH), U2.7 (CANH)
/CANL: D1.1 (K), J12.3, SW2.2, U1.6 (CANL), U2.6 (CANL)
/CAN_Rx: U1.4 (RXD), U2.2 (RXD), U3.45 (PB8)
/CAN_Tx: U1.1 (TXD), U2.3 (TXD), U3.46 (PB9)
/G1: D8.2 (A), J18.3, Q5.3 (D)
/G2: D9.2 (A), J18.4, Q6.3 (D)
/G3: D10.2 (A), J18.5, Q7.3 (D)
/LED0: J8.1, U3.25 (PB12)
/LED1: J8.3, U3.26 (PB13)
/LED2: J8.5, U3.27 (PB14)
/LED3: J8.7, U3.28 (PB15)
/NRST: J2.1, U3.7 (NRST)
/PWM1: R22.2, R25.1, U3.29 (PA8)
/PWM2: R23.2, R26.1, U3.30 (PA9)
/PWM3: R24.2, R27.1, U3.31 (PA10)
/Relay1: R8.2, R9.2, U3.10 (PA0)
/Relay2: R14.2, R15.2, U3.11 (PA1)
/SWCLK: J5.1, U3.37 (PA14)
/SWDIO: J4.1, U3.34 (PA13)
Earth: C5.2, D1.3 (O), J12.2, JP1.2 (B), Q1.3 (0V), R2.2, U2.5 (GND2)
GND: C1.2, C2.1, C3.1, C4.1, C6.1, C7.2, C8.2, C9.2, C10.2, C11.2, C12.2, C13.2, C14.2, C15.2, D3.4 (GND), D3.5 (GND), D6.2 (A), D7.2 (A), D11.2 (A), J6.1, J7.5, J10.1, J13.4 (GND), J13.5 (Shield), J15.3, JP1.1 (A), Q1.1 (GND), Q2.2 (S), Q3.2 (S), Q5.2 (S), Q6.2 (S), Q7.2 (S), R1.2, R8.1, R14.1, R19.1, R20.1, R21.2, R25.2, R26.2, R27.2, SW1.9, SW1.10, SW1.11, SW1.12, SW1.13, SW1.14, SW1.15, SW1.16, U1.2 (VSS), U2.4 (GND1), U3.8 (VSSA), U3.23 (VSS), U3.35 (VSS), U3.47 (VSS), U4.3 (GND), U4.5 (ON/OFF), U5.1 (GND), U6.2
unnamed: C5.1, Q1.4 (+Vo), U2.8 (VCC2)
unnamed: D2.2 (A), K1.2, Q2.3 (D), R12.1
unnamed: D3.1 (VCC), J13.1 (VBUS)
unnamed: D3.2 (I/O1), J13.2 (D-)
unnamed: D3.3 (I/O2), J13.3 (D+)
unnamed: D3.6 (I/O2), R11.1
unnamed: D3.7 (I/O1), R10.1
unnamed: D4.2 (A), K2.2, Q3.3 (D), R16.1
unnamed: D5.2 (A), Q4.1 (G), R21.1
unnamed: D11.1 (K), L1.2, U4.2 (VOUT)
unnamed: J1.1, R3.1
unnamed: J8.2, R4.2
unnamed: J8.4, R5.2
unnamed: J8.6, R6.2
unnamed: J8.8, R7.2
unnamed: J9.2, R12.2
unnamed: J10.2, Q4.3 (D)
unnamed: J11.1, K1.3
unnamed: J11.2, K1.1
unnamed: J11.3, K1.4
unnamed: J15.1, R17.1
unnamed: J15.2, R18.1
unnamed: J16.2, R16.2
unnamed: J17.1, K2.3
unnamed: J17.2, K2.1
unnamed: J17.3, K2.4
unnamed: Q2.1 (G), R9.1
unnamed: Q3.1 (G), R15.1
unnamed: Q5.1 (G), R22.1
unnamed: Q6.1 (G), R23.1
unnamed: Q7.1 (G), R24.1
unnamed: R2.1, U1.8 (Rs)
unnamed: R10.2, U3.32 (PA11)
unnamed: R11.2, U3.33 (PA12)
unnamed: R13.1, SW2.1

Notes on the sheet:
3.3V MCU power source
Ext LED2
Relay #1
Ext LED1
Isolated CAN
ADC6 ADC7
External signal LEDs
CAN connectors
Ext. buttons
TIM1 1..3
CAN Address
Relay #2
Non-isolated CAN
Debugging holes
COM
ADC IN: 5V and 12V
Only one variant should be soldered: MCP2551 or ISO1050+B0505S !!!
PWM channels
JP1 should be shortened in non-isolated mode
Switching 5V power
12Vin
Terminal on/off

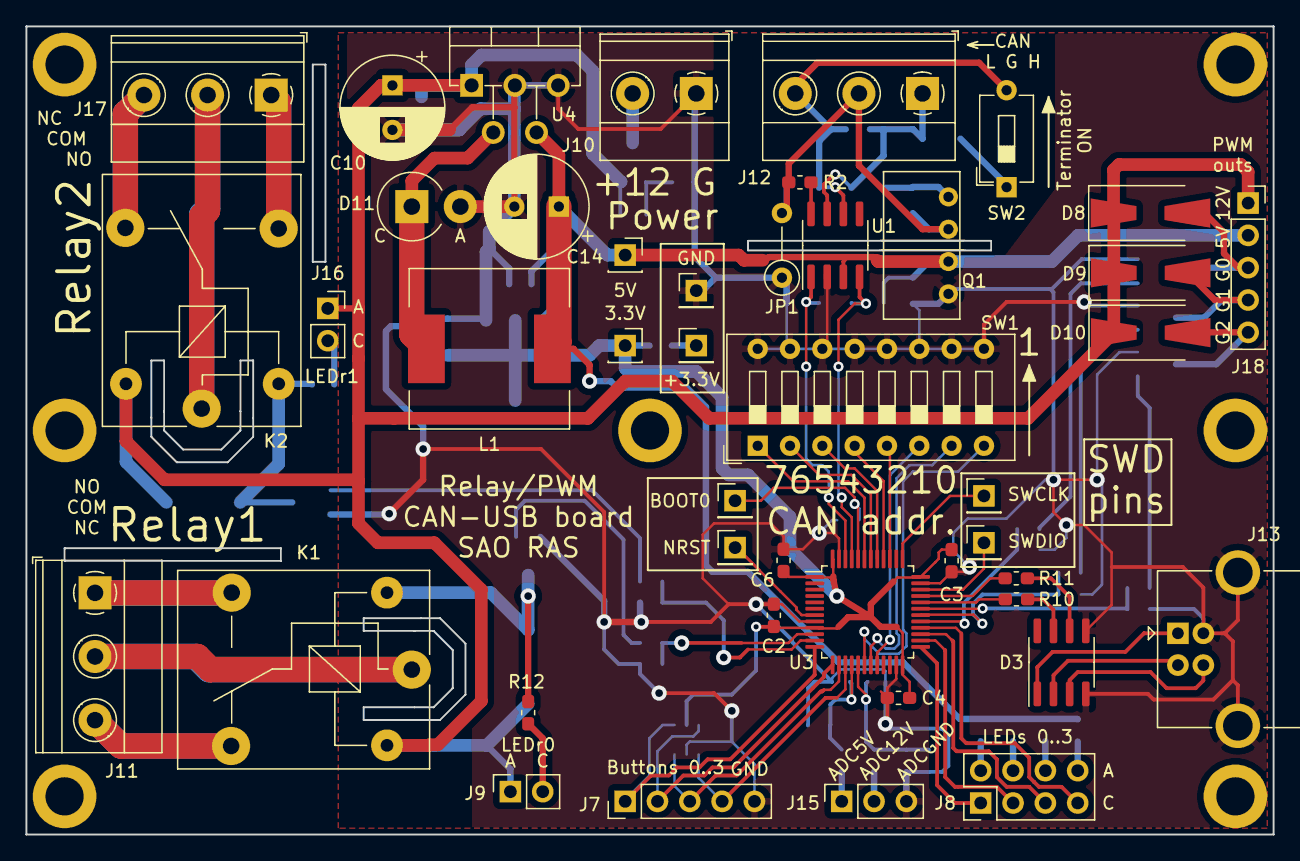
[picture p38: board F0:F030,F042,F072/usbcan_relay/kicad/stm32.kicad_pcb from above]

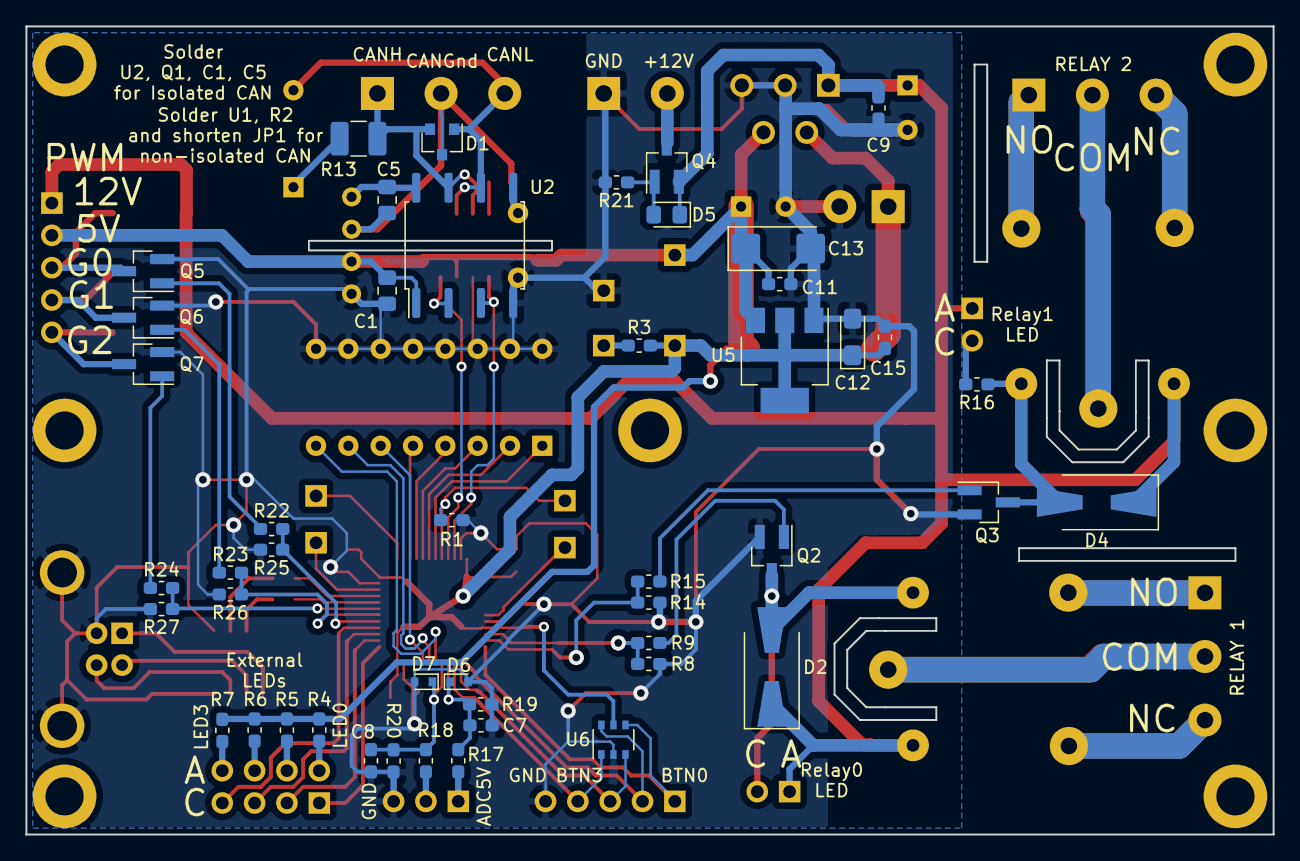
[picture p39: board F0:F030,F042,F072/usbcan_relay/kicad/stm32.kicad_pcb from below]

Board: 2 copper layers, 98.0 x 63.5 mm, 98 parts (47 on the bottom side), 74 nets.
