eddyem/stm32samples/F0:F030,F042,F072/canbus/kicad/stm32.kicad_pcb

## KiCad design F0:F030,F042,F072/canbus/kicad/stm32.kicad_pcb (2024-05-06)

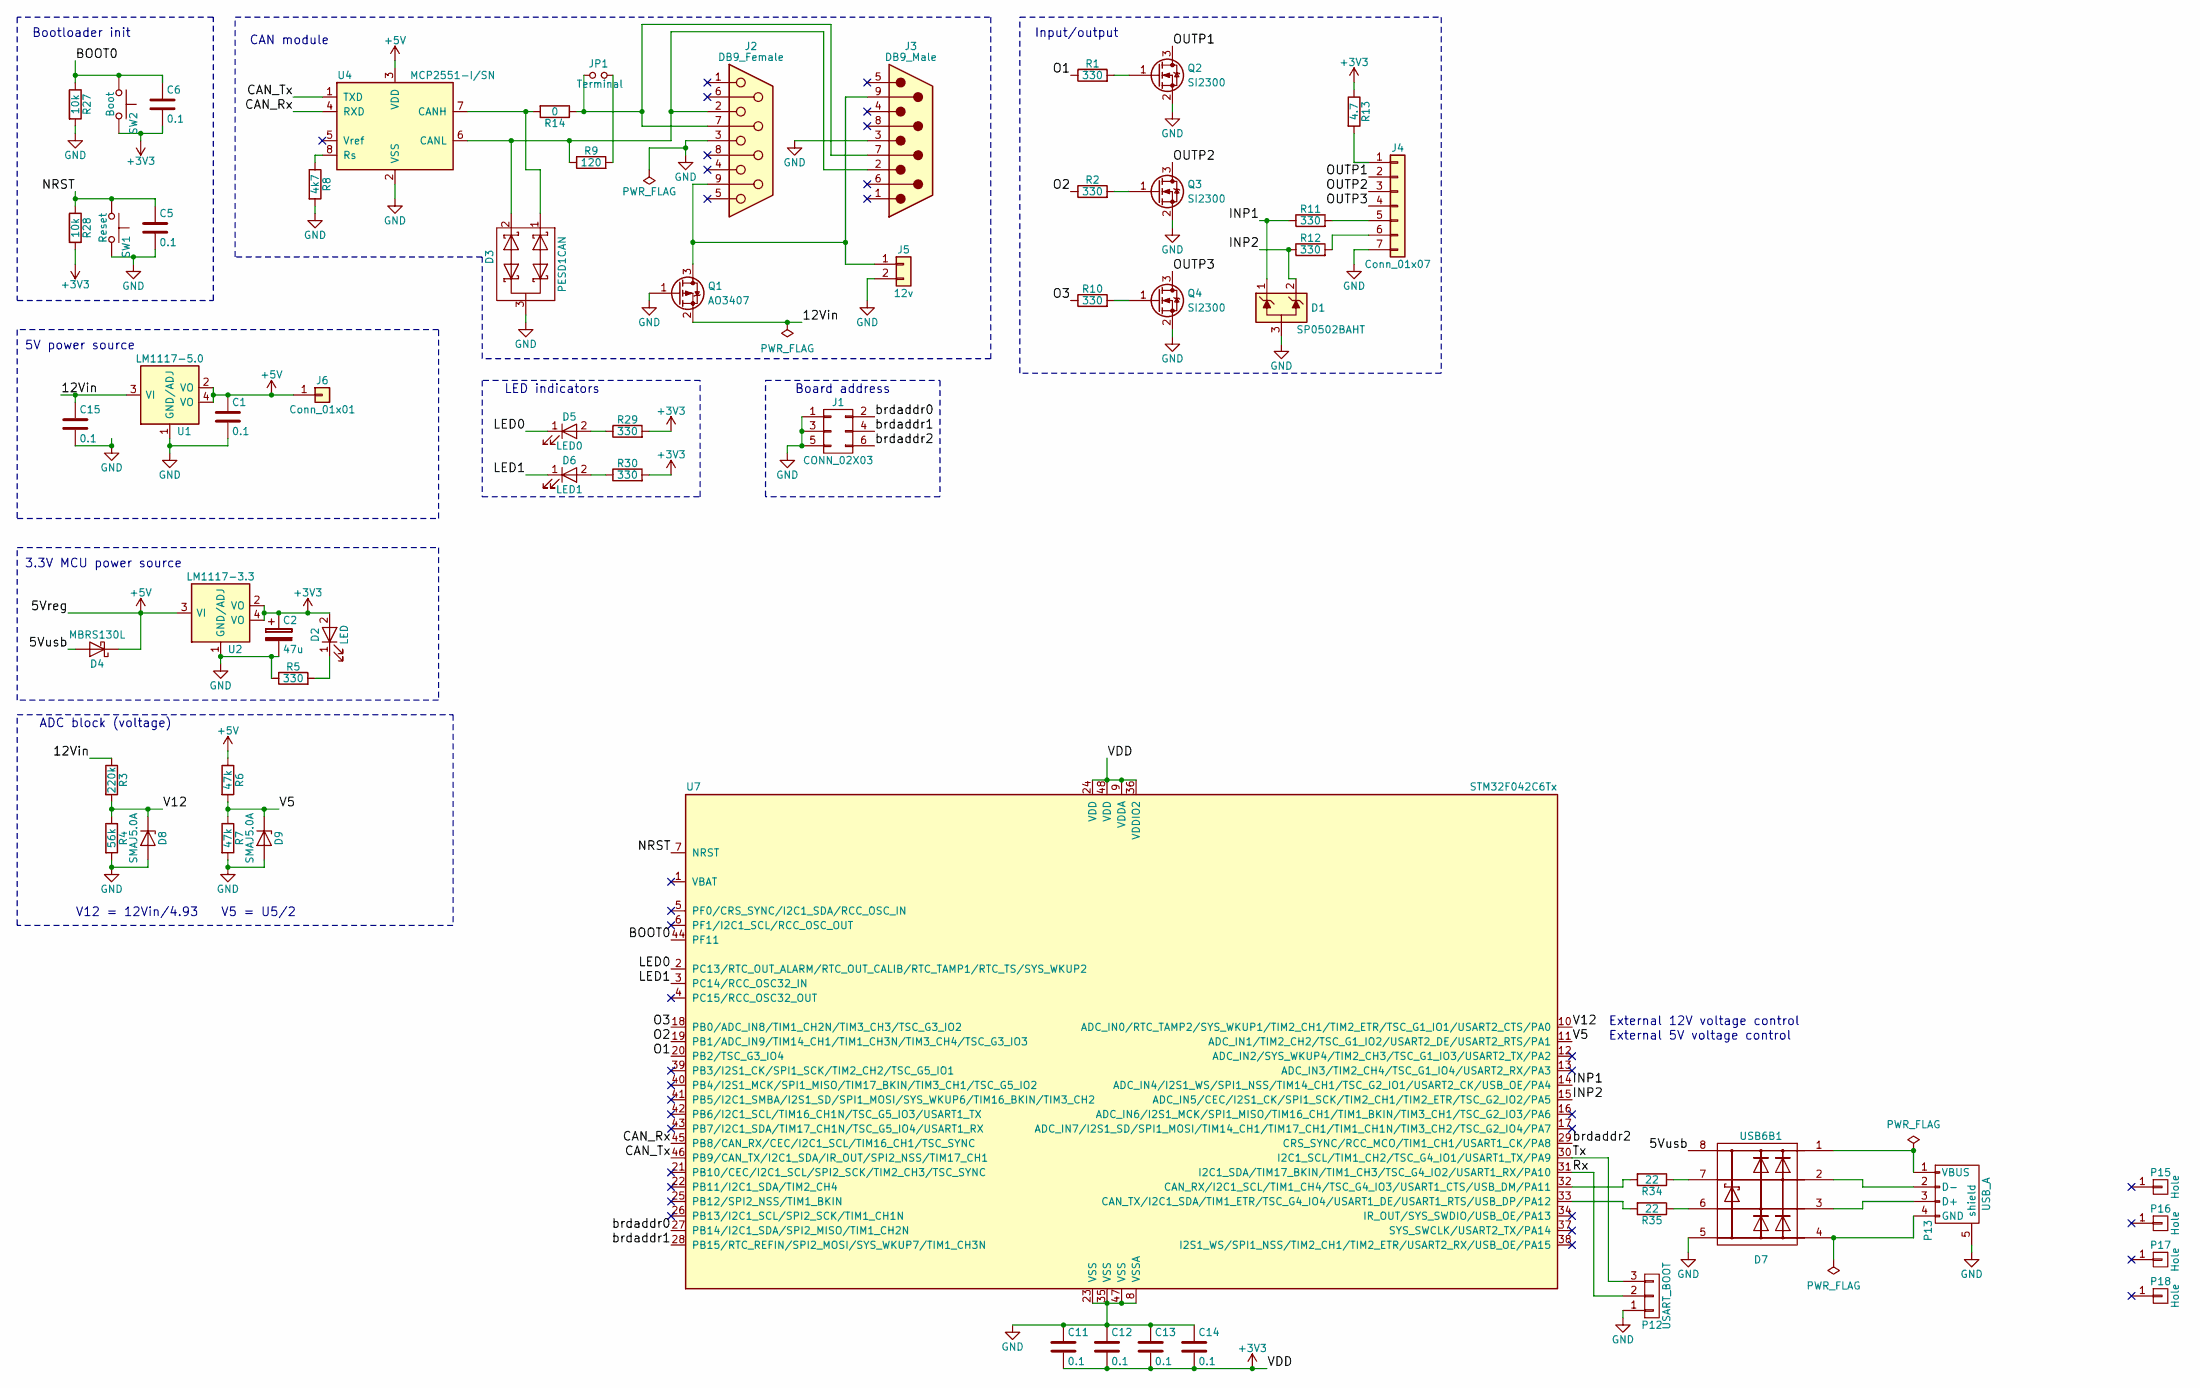
[picture p40: schematic stm32.kicad_sch]

Parts:
C1, C5, C6, C11, C12, C13, C14, C15: 0.1; C_0603_HandSoldering
C2: 47u; Tantalum_Case-A_EIA-3216-18_Hand
D1: SP0502BAHT; SOT-23
D2: LED; LED_0805
D3: PESD1CAN; SOT-23
D4: MBRS130L; D_SMB_Handsoldering
D5: LED0; LED_0805
D6: LED1; LED_0805
D7: USB6B1; SOIC-8_3.9x4.9mm_Pitch1.27mm
D8, D9: SMAJ5.0A; D_SMA
J1: CONN_02X03; Pin_Header_Straight_2x03_Pitch2.54mm
J2: DB9_Female; DB9FC
J3: DB9_Male; DB9MC
J4: Conn_01x07; Pin_Header_Straight_1x07_Pitch2.54mm
J5: 12v; TerminalBlock_Pheonix_MKDS1.5-2pol
J6: Conn_01x01; Pin_Header_Straight_1x01_Pitch2.54mm
JP1: Terminal; Pin_Header_Straight_1x02
P12: USART_BOOT; Pin_Header_Straight_1x03
P13: USB_A; USB_Mini-B
P15, P16, P17, P18: Hole; Hole_3mm
Q1: AO3407; SOT-23_Handsoldering
Q2, Q3, Q4: SI2300; SOT-23_Handsoldering
R1, R2, R5, R10, R11, R12, R29, R30: 330; R_0603_HandSoldering
R3: 220k; R_0603_HandSoldering
R4: 56k; R_0603_HandSoldering
R6, R7: 47k; R_0603_HandSoldering
R8: 4k7; R_0603_HandSoldering
R9: 120; R_0603_HandSoldering
R13: 4.7; R_0603_HandSoldering
R14: 0; R_0805_HandSoldering
R27, R28: 10k; R_0603_HandSoldering
R34, R35: 22; R_0603_HandSoldering
SW1: Reset; SW_SPST_FSMSM
SW2: Boot; SW_SPST_FSMSM
U1: LM1117-5.0; SOT-223
U2: LM1117-3.3; SOT-223
U4: MCP2551-I/SN; SOIC-8_3.9x4.9mm_Pitch1.27mm
U7: STM32F042C6Tx; LQFP-48_7x7mm_Pitch0.5mm

Connections:
+3V3: C2.1, C6.2, C11.2, C12.2, C13.2, C14.2, D2.2 (A), R13.1, R28.2, R29.2, R30.2, SW2.2, U2.2 (VO), U2.4 (VO), U7.9 (VDDA), U7.24 (VDD), U7.36 (VDDIO2), U7.48 (VDD)
+5V: C1.1, D4.1 (K), J6.1, R6.1, U1.2 (VO), U1.4 (VO), U2.3 (VI), U4.3 (VDD)
/5Vusb: D4.2 (A), D7.8 (VCC)
/12Vin: C15.1, Q1.2 (S), R3.1, U1.3 (VI)
/BOOT0: C6.1, R27.1, SW2.1, U7.44 (PF11)
/CAN_Rx: U4.4 (RXD), U7.45 (PB8/CAN_RX/CEC/I2C1_SCL/TIM16_CH1/TSC_S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)
/CAN_Tx: U4.1 (TXD), U7.46 (PB9/CAN_TX/I2C1_SDA/IR_OUT/SPI2_NSS/TIM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)
/INP1: D1.1 (K), R11.1, U7.14 (ADC_IN4/I2S1_WS/SPI1_NSS/TIM14_CH1/TSC_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)
/INP2: D1.2 (K), R12.1, U7.15 (ADC_IN5/CEC/I2S1_CK/SPI1_SCK/TIM2_CH1/T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)
/LED0: D5.1 (K), U7.2 (PC13/RTC_OUT_ALARM/RTC_OUT_CALIB/RTC_TA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)
/LED1: D6.1 (K), U7.3 (PC14/RCC_OSC32_IN)
/NRST: C5.1, R28.1, SW1.1, U7.7 (NRST)
/O1: R1.1, U7.20 (PB2/TSC_G3_IO4)
/O2: R2.1, U7.19 (PB1/ADC_IN9/TIM14_CH1/TIM1_CH3N/TIM3_CH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)
/O3: R10.1, U7.18 (PB0/ADC_IN8/TIM1_CH2N/TIM3_CH3/TSC_G3_I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)
/OUTP1: J4.2, Q2.3 (D)
/OUTP2: J4.3, Q3.3 (D)
/OUTP3: J4.4, Q4.3 (D)
/Rx: P12.2, U7.31 (I2C1_SDA/TIM17_BKIN/TIM1_CH3/TSC_G4_IO2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)
/Tx: P12.3, U7.30 (I2C1_SCL/TIM1_CH2/TSC_G4_IO1/USART1_TX/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)
/V5: D9.1 (K), R6.2, R7.1, U7.11 (ADC_IN1/TIM2_CH2/TSC_G1_IO2/USART2_DE/U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)
/V12: D8.1 (K), R3.2, R4.1, U7.10 (ADC_IN0/RTC_TAMP2/SYS_WKUP1/TIM2_CH1/TI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)
/brdaddr0: J1.2, U7.27 (PB14/I2C1_SDA/SPI2_MISO/TIM1_CH2N)
/brdaddr1: J1.4, U7.28 (PB15/RTC_REFIN/SPI2_MOSI/SYS_WKUP7/TIM1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)
/brdaddr2: J1.6, U7.29 (CRS_SYNC/RCC_MCO/TIM1_CH1/USART1_CK/PA8)
GND: C1.2, C2.2, C5.2, C11.1, C12.1, C13.1, C14.1, C15.2, D1.3 (A), D3.3 (O), D7.5 (GND), D8.2 (A), D9.2 (A), J1.1, J1.3, J1.5, J2.3, J3.3, J4.7, J5.2, P12.1, P13.5 (shield), Q1.1 (G), Q2.2 (S), Q3.2 (S), Q4.2 (S), R4.2, R5.1, R7.2, R8.2, R27.2, SW1.2, U1.1 (GND/ADJ), U2.1 (GND/ADJ), U4.2 (VSS), U7.8 (VSSA), U7.23 (VSS), U7.35 (VSS), U7.47 (VSS)
unnamed: D2.1 (K), R5.2
unnamed: D3.1 (K), R14.2, U4.7 (CANH)
unnamed: D3.2 (K), J2.2, J3.2, R9.1, U4.6 (CANL)
unnamed: D5.2 (A), R29.1
unnamed: D6.2 (A), R30.1
unnamed: D7.1 (VCC), P13.1 (VBUS)
unnamed: D7.2 (I/O1), P13.2 (D-)
unnamed: D7.3 (I/O2), P13.3 (D+)
unnamed: D7.4 (GND), P13.4 (GND)
unnamed: D7.6 (I/O2), R35.1
unnamed: D7.7 (I/O1), R34.1
unnamed: J2.7, J3.7, JP1.1, R14.1
unnamed: J2.9, J3.9, J5.1, Q1.3 (D)
unnamed: J4.1, R13.2
unnamed: J4.5, R11.2
unnamed: J4.6, R12.2
unnamed: JP1.2, R9.2
unnamed: Q2.1 (G), R1.2
unnamed: Q3.1 (G), R2.2
unnamed: Q4.1 (G), R10.2
unnamed: R8.1, U4.8 (Rs)
unnamed: R34.2, U7.32 (CAN_RX/I2C1_SCL/TIM1_CH4/TSC_G4_IO3/USA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)
unnamed: R35.2, U7.33 (CAN_TX/I2C1_SDA/TIM1_ETR/TSC_G4_IO4/USA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)

Notes on the sheet:
External 5V voltage control
Board address
Bootloader init
V12 = 12Vin/4.93
ADC block (voltage)
3.3V MCU power source
Input/output
LED indicators
External 12V voltage control
CAN module
5V power source
V5 = U5/2
