eddyem/stm32samples/F0:F030,F042,F072/canbus/kicad/stm32.kicad_pcb

## KiCad design F0:F030,F042,F072/canbus/kicad/stm32.kicad_pcb (continued)

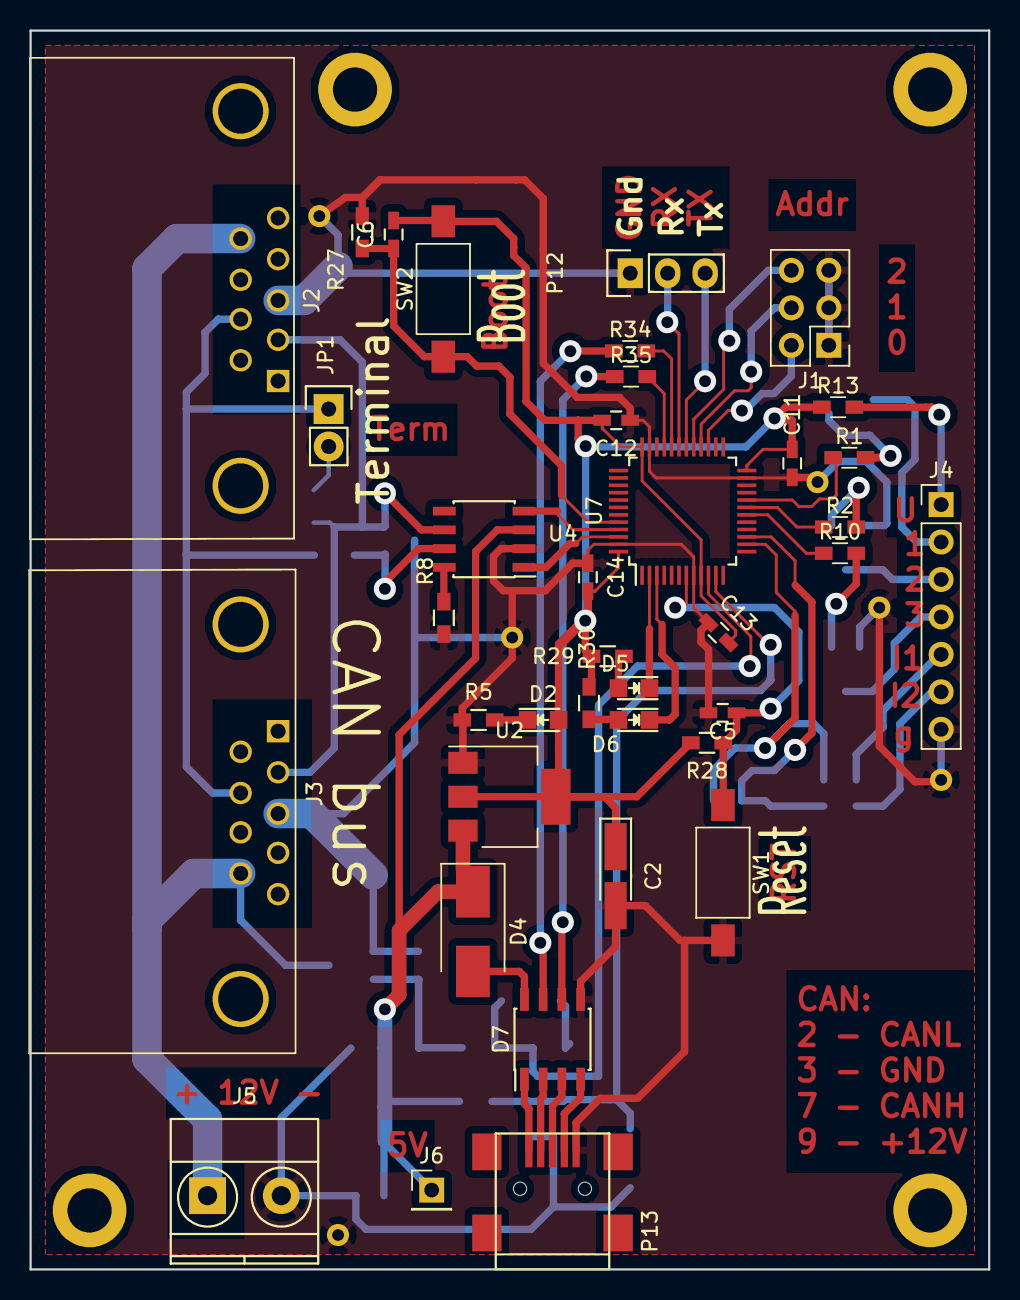
[picture p41: board F0:F030,F042,F072/canbus/kicad/stm32.kicad_pcb from above]

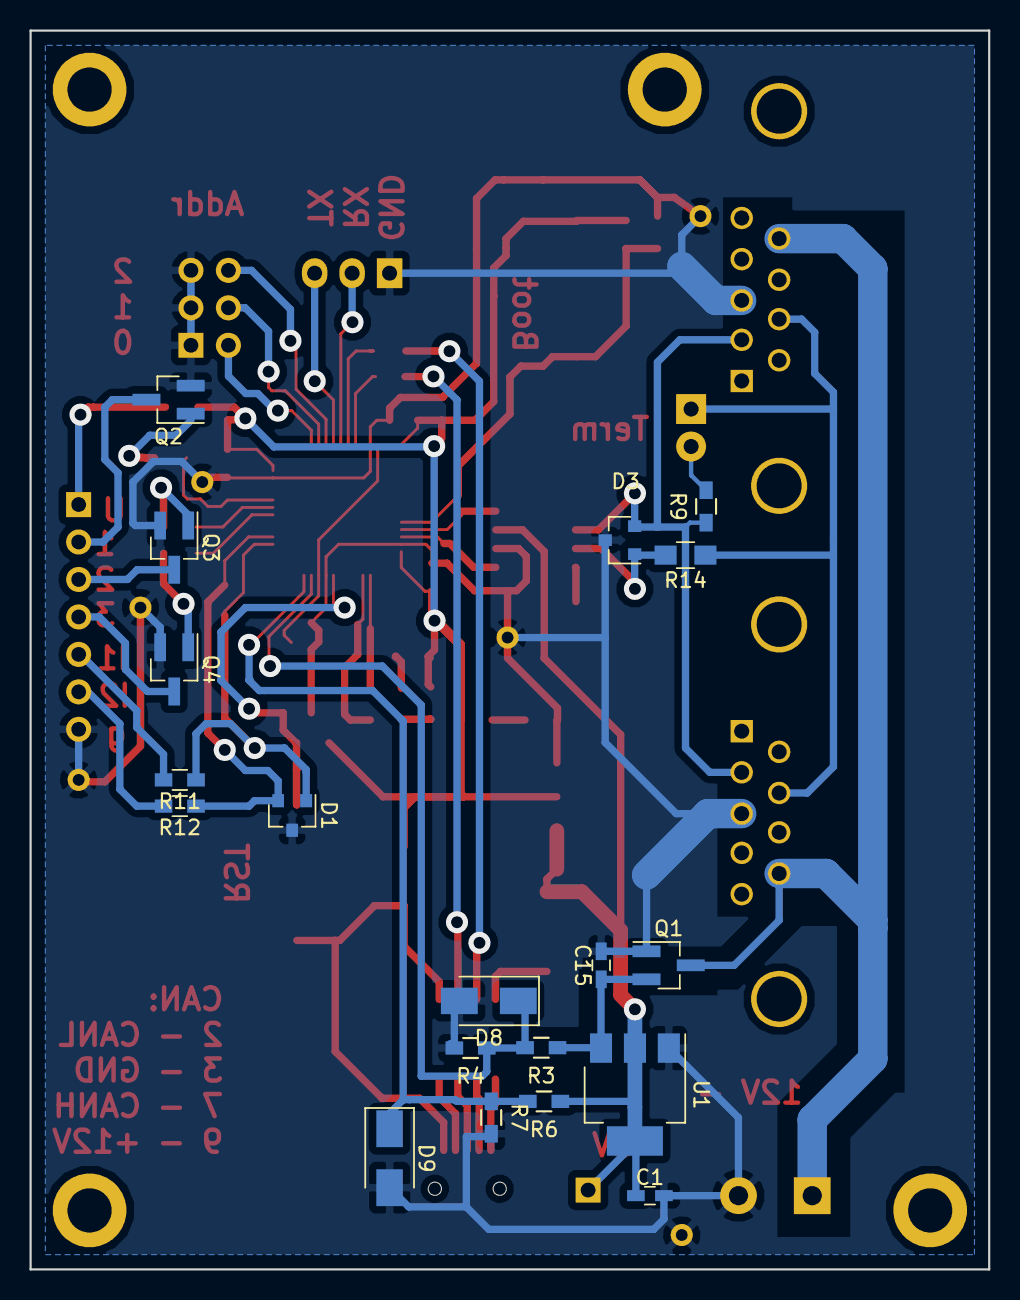
[picture p42: board F0:F030,F042,F072/canbus/kicad/stm32.kicad_pcb from below]

Board: 2 copper layers, 65.0 x 84.0 mm, 61 parts (19 on the bottom side), 49 nets.
