eddyem/stm32samples/F0:F030,F042,F072/Socket_fans/kicad/stm32.kicad_pcb

## KiCad design F0:F030,F042,F072/Socket_fans/kicad/stm32.kicad_pcb (2024-05-06)

Schematic: stm32.kicad_sch

Parts:
C1, C2, C3, C4, C5, C6, C8, C13, C14, C15, C16, C17, C18, C19, C20: 0.1; C_0603_1608Metric_Pad1.05x0.95mm_HandSolder
C7: 47uF, 10V; CP_EIA-6032-28_Kemet-C_Pad2.25x2.35mm_HandSolder
C9: 10uF, 10V; C_1206_3216Metric_Pad1.42x1.75mm_HandSolder
C10: 47u, 25V; CP_Radial_D8.0mm_P3.50mm
D1, D2, D4, D5, D6, D9: 1N5819; D_SOD-323_HandSoldering
D3: MM3Z7V5; D_0805_2012Metric_Pad1.15x1.40mm_HandSolder
D7: MM3Z4V3; D_0805_2012Metric_Pad1.15x1.40mm_HandSolder
D8, D10: MM3Z3V6; D_0805_2012Metric_Pad1.15x1.40mm_HandSolder
J1: 12VIN; TerminalBlock_Phoenix_MKDS-1,5-2_1x02_P5.00mm_Horizontal
J2: thermal; PinSocket_2x04_P2.54mm_Vertical
J3: Buzzer; JST_EH_B2B-EH-A_1x02_P2.50mm_Vertical
J4: cooler3; JST_EH_B2B-EH-A_1x02_P2.50mm_Vertical
J5, J6: FAN; FanPinHeader_1x04_P2.54mm_Vertical
J7, J10: Conn_01x02_Female; PinSocket_1x02_P2.54mm_Vertical
J8: MKDS; TerminalBlock_Phoenix_MKDS-1,5-2_1x02_P5.00mm_Horizontal
K1: SRD-12VDC; Relay_SPDT_SANYOU_SRD_Series_Form_C
L1: BMBA 0.1mH; L_0805_2012Metric_Pad1.15x1.40mm_HandSolder
P1: USB_A; USB_B_OST_USB-B1HSxx_Horizontal
P2, P3, P4, P5: Hole; MountingHole_3.2mm_M3
Q1: AO3401; SOT-23_Handsoldering
Q2, Q3, Q4, Q5, Q6: IRLML2502; SOT-23_Handsoldering
R1, R2, R4, R6, R8, R13, R14, R16, R17, R34: 10k; R_0603_1608Metric_Pad1.05x0.95mm_HandSolder
R3, R5, R7, R9: 4k7, 1%; R_0805_2012Metric_Pad1.15x1.40mm_HandSolder
R10, R11, R12, R15, R18, R19, R20, R21, R24, R25, R32: 510; R_0603_1608Metric_Pad1.05x0.95mm_HandSolder
R22: 47k; R_0603_1608Metric_Pad1.05x0.95mm_HandSolder
R23, R30, R31: 22; R_0603_1608Metric_Pad1.05x0.95mm_HandSolder
R26: 3.3k; R_0603_1608Metric_Pad1.05x0.95mm_HandSolder
R27: 1k; R_0603_1608Metric_Pad1.05x0.95mm_HandSolder
R28, R29: 4.7k; R_0603_1608Metric_Pad1.05x0.95mm_HandSolder
SW1, SW2: SW_Push; PinSocket_1x02_P2.54mm_Vertical
U1: LM1117-3.3; SOT-223-3_TabPin2
U2: L7805; TO-220-3_Vertical
U3: STM32F072CBTx; LQFP-48_7x7mm_P0.5mm
U4: USBLC6-2SC6; SOT-23-6

Connections:
+5V: D1.1 (K), D2.1 (K), R28.1, U1.3
+12V: C3.1, C10.1, D3.1 (K), D4.1 (K), D5.1 (K), D6.1 (K), D9.1 (K), J3.2, J4.1, J5.2, J6.2, K1.2, Q1.2 (S), R26.1, U2.1 (IN)
/5Vin: C8.1, C9.1, D1.2 (A), U2.3 (OUT)
/5Vusb: D2.2 (A), P1.1 (VBUS), U4.5 (VBUS)
/ADC0: C1.2, R2.2, U3.10 (PA0)
/ADC1: C2.2, R4.2, U3.11 (PA1)
/ADC2: C4.2, R6.2, U3.12 (PA2)
/ADC3: C5.2, R8.2, U3.13 (PA3)
/AIN0: C16.1, D7.1 (K), R26.2, R27.1, U3.14 (PA4)
/AIN1: C18.1, R28.2, R29.1, U3.15 (PA5)
/BOOT0: J7.2, R22.1, U3.44 (BOOT0)
/Btn0: R24.1, U3.27 (PB14)
/Btn1: R25.1, U3.28 (PB15)
/Buzzer: R12.2, R16.2, U3.37 (PA14)
/Cooler0: R11.2, R14.2, U3.40 (PB4)
/Cooler1: R10.2, R13.2, U3.41 (PB5)
/NRST: J10.1, U3.7 (NRST)
/Relay: R32.2, R34.1, U3.2 (PC13)
/TIM1_CH1: R21.1, U3.29 (PA8)
/TIM1_CH2: R20.1, U3.30 (PA9)
/TIM1_CH3: R15.2, R17.2, U3.31 (PA10)
/TIM3_CH1: D10.1 (K), R19.1, U3.16 (PA6)
/TIM14_CH1: D8.1 (K), R18.1, U3.17 (PA7)
GND: C1.1, C2.1, C3.2, C4.1, C5.1, C6.2, C7.2, C8.2, C9.2, C10.2, C13.2, C14.2, C15.1, C16.2, C17.1, C18.2, C19.1, C20.2, D7.2 (A), D8.2 (A), D10.2 (A), J1.2, J10.2, P1.4 (GND), P1.5 (Shield), Q2.2 (S), Q3.2 (S), Q4.2 (S), Q5.2 (S), Q6.2 (S), R1.2, R3.1, R5.1, R7.1, R9.1, R13.1, R14.1, R16.1, R17.1, R22.2, R27.2, R29.2, R34.2, SW1.1, SW2.1, U1.1, U2.2 (GND), U3.8 (VSSA), U3.23 (VSS), U3.35 (VSS), U3.47 (VSS), U4.2 (GND)
unnamed: C13.1, R24.2, SW1.2
unnamed: C14.1, R25.2, SW2.2
unnamed: D3.2 (A), Q1.1 (G), R1.1
unnamed: D4.2 (A), J5.1, Q2.3 (D)
unnamed: D5.2 (A), J6.1, Q3.3 (D)
unnamed: D6.2 (A), J4.2, Q5.3 (D)
unnamed: D9.2 (A), K1.5, Q6.3 (D)
unnamed: J1.1, Q1.3 (D)
unnamed: J2.1, R8.1, R9.2
unnamed: J2.3, R6.1, R7.2
unnamed: J2.5, R4.1, R5.2
unnamed: J2.7, R2.1, R3.2
unnamed: J3.1, Q4.3 (D)
unnamed: J5.3, R18.2
unnamed: J5.4, R20.2
unnamed: J6.3, R19.2
unnamed: J6.4, R21.2
unnamed: J7.1, R23.1
unnamed: J8.1, K1.1
unnamed: J8.2, K1.3
unnamed: P1.2 (D-), U4.4 (I/O2)
unnamed: P1.3 (D+), U4.6 (I/O1)
unnamed: Q2.1 (G), R10.1
unnamed: Q3.1 (G), R11.1
unnamed: Q4.1 (G), R12.1
unnamed: Q5.1 (G), R15.1
unnamed: Q6.1 (G), R32.1
unnamed: R30.1, U4.3 (I/O2)
unnamed: R30.2, U3.32 (PA11)
unnamed: R31.1, U4.1 (I/O1)
unnamed: R31.2, U3.33 (PA12)

Notes on the sheet:
Cooler channels
ADC block (voltage)
V12 = 12Vin/4.3
+12 GND
3.3V MCU power source
External 12V voltage control
External 5V voltage control
Boot, reset
VCC BOOT0 NRST GND
5V power source
Alarm Buzzer
Thermal
V5 = U5/2

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
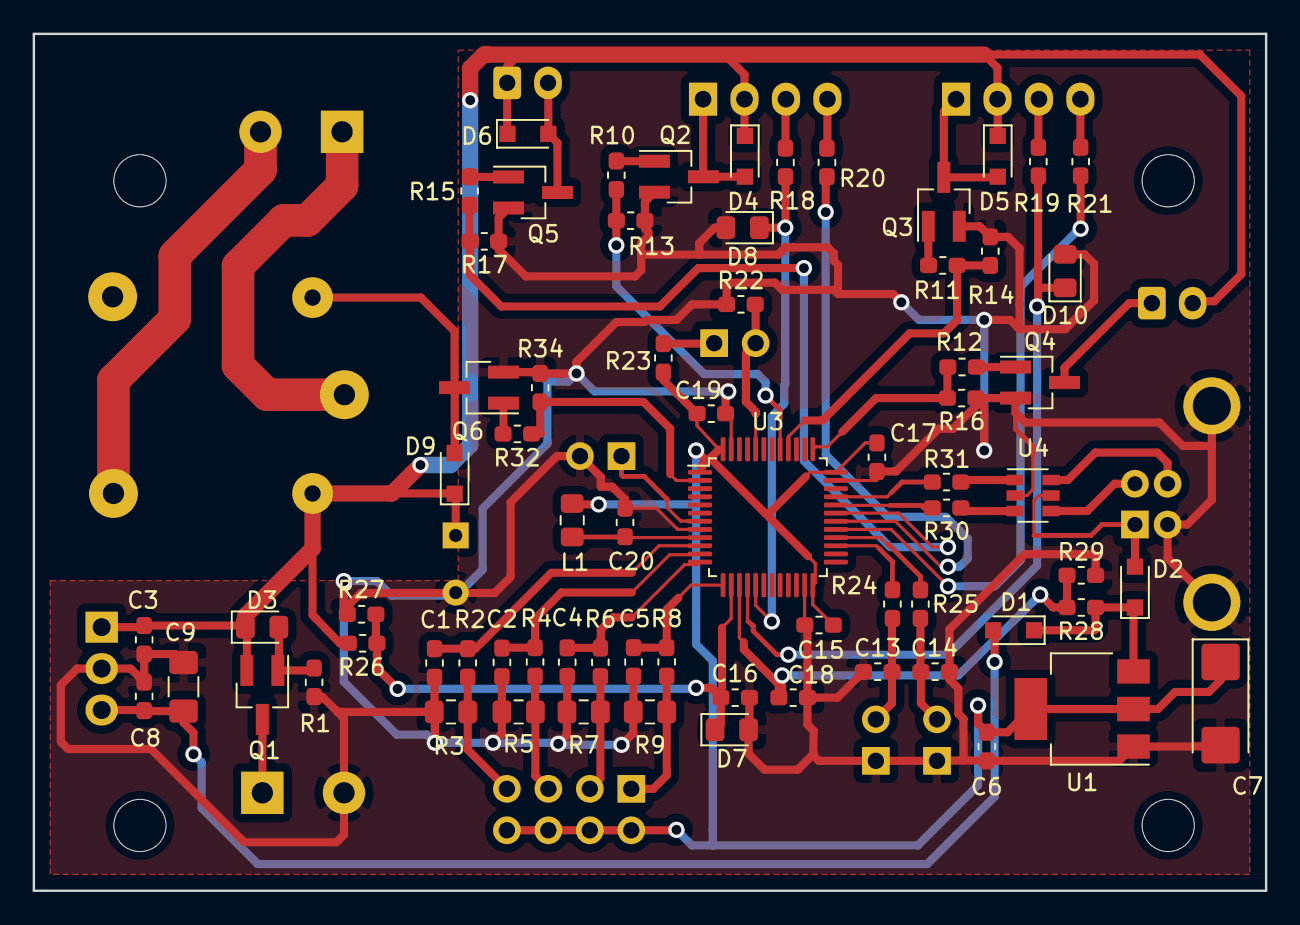
[picture p43: board F0:F030,F042,F072/Socket_fans/kicad/stm32.kicad_pcb from above]

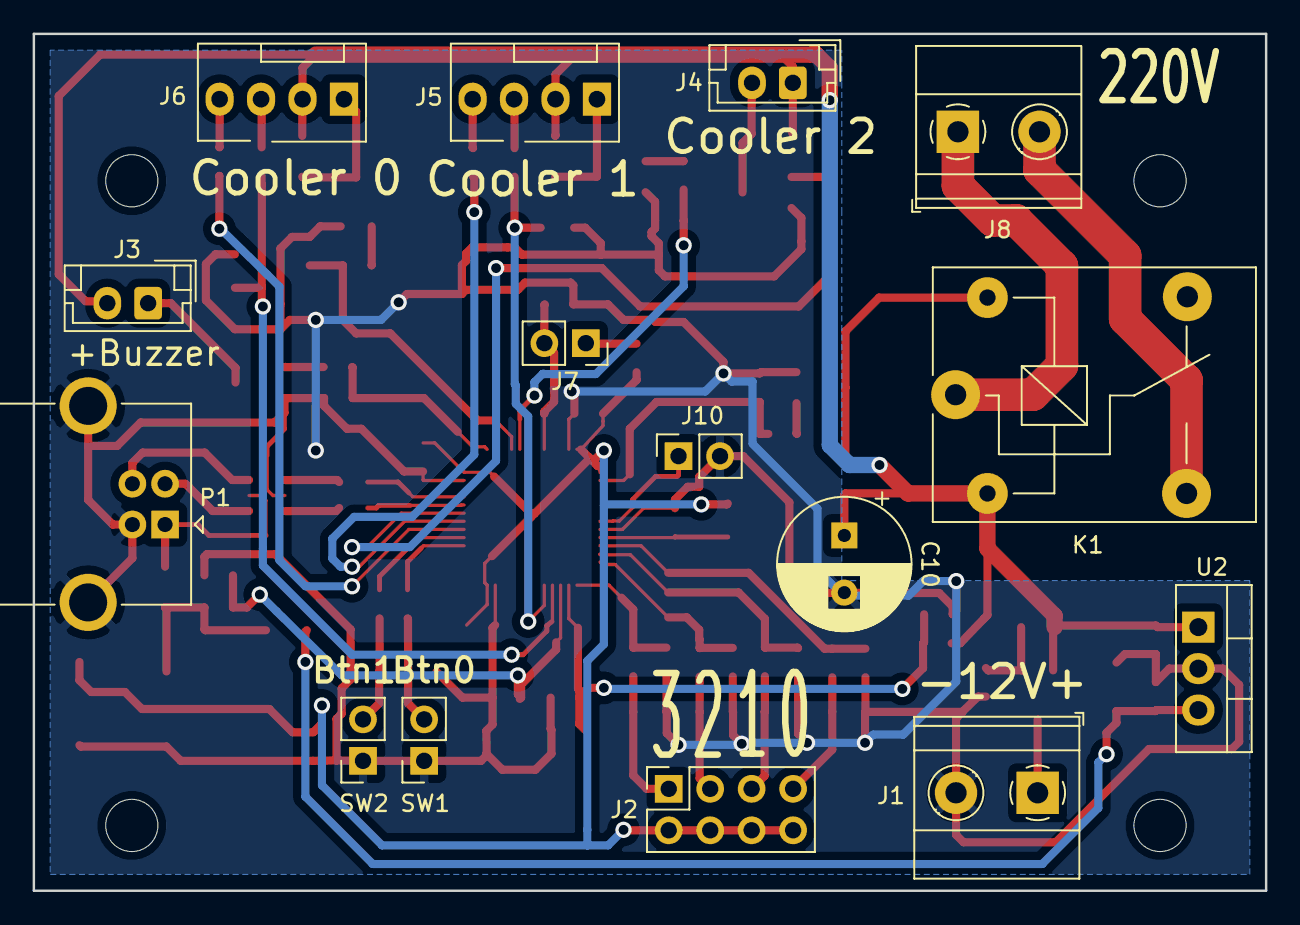
[picture p44: board F0:F030,F042,F072/Socket_fans/kicad/stm32.kicad_pcb from below]

Board: 2 copper layers, 75.5 x 52.5 mm, 89 parts (15 on the bottom side), 57 nets.
