eddyem/stm32samples/F3:F303/NitrogenFlooding/kicad/sensors/heaters.kicad_pcb

## KiCad design F3:F303/NitrogenFlooding/kicad/sensors/heaters.kicad_pcb (2024-05-06)

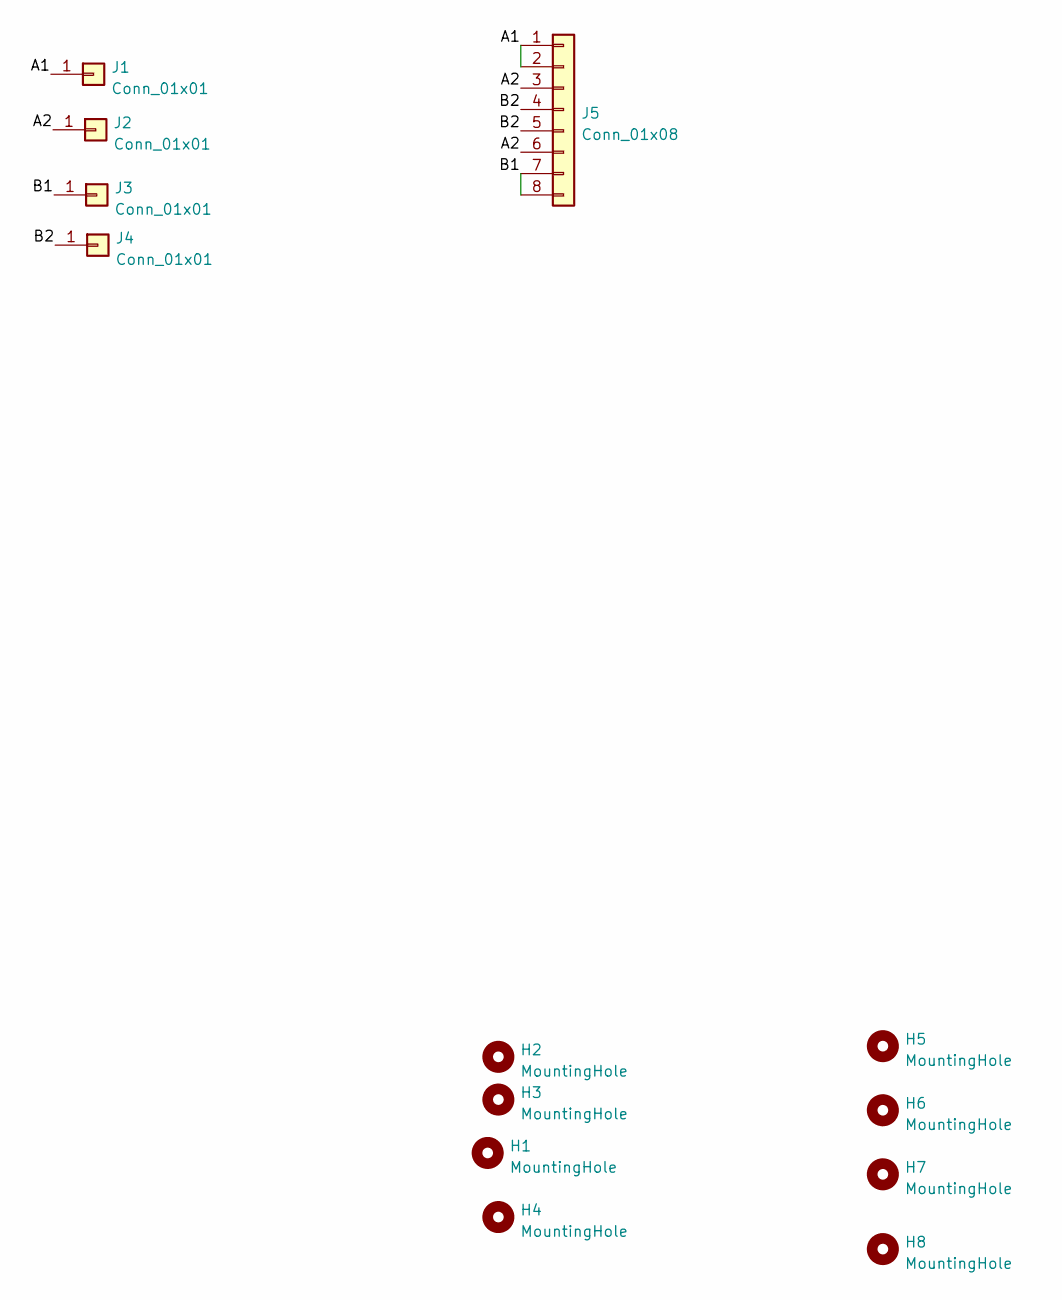
[picture p45: schematic heaters.kicad_sch]

Parts:
H1, H2, H3, H4: MountingHole; MountingHole_2mm
H5, H6, H7, H8: MountingHole; MountingHole_3.2mm_M3
J1, J2, J3, J4: Conn_01x01; PinSocket_1x01_P2.54mm_Vertical
J5: Conn_01x08; avia8

Connections:
/A1: J1.1, J5.1, J5.2
/A2: J2.1, J5.3, J5.6
/B1: J3.1, J5.7, J5.8
/B2: J4.1, J5.4, J5.5

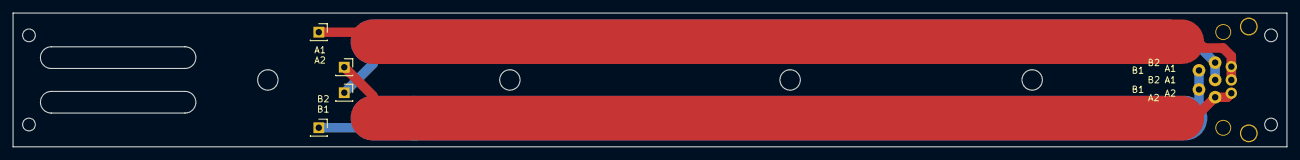
[picture p46: board heaters.kicad_pcb from above]

Board: 2 copper layers, 200.0 x 21.0 mm, 13 parts (0 on the bottom side), 4 nets.
