eddyem/stm32samples/testboard/F0_F1_F3-LQFP48_testboard/stm32.kicad_pcb

## KiCad design testboard/F0_F1_F3-LQFP48_testboard/stm32.kicad_pcb (2024-05-06)

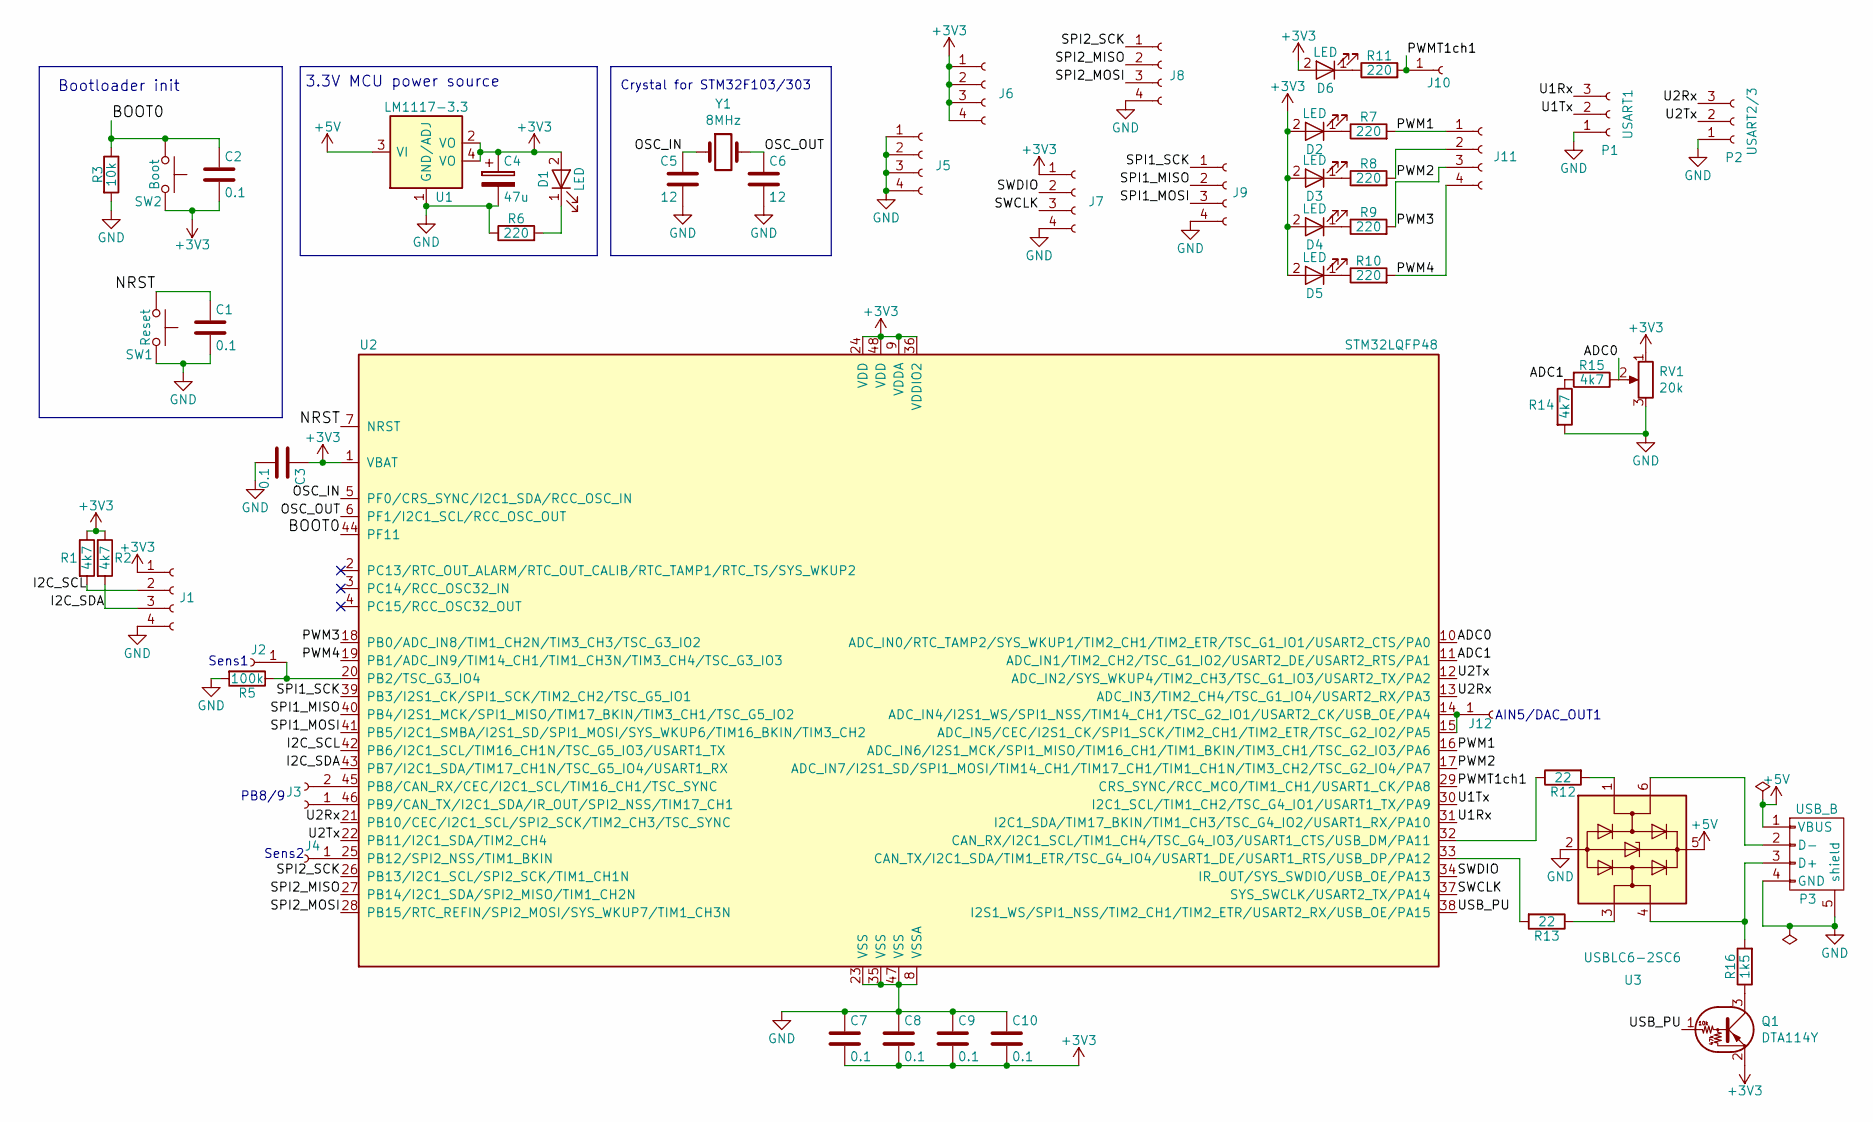
[picture p47: schematic stm32.kicad_sch]

Parts:
C1, C2, C3, C7, C8, C9, C10: 0.1; C_0603_1608Metric_Pad1.05x0.95mm_HandSolder
C4: 47u; CP_EIA-6032-28_Kemet-C_Pad2.25x2.35mm_HandSolder
C5, C6: 12; C_0603_1608Metric_Pad1.05x0.95mm_HandSolder
D1, D2, D3, D4, D5, D6: LED; LED_D3.0mm
J1, J5, J6, J7, J8, J9, J11: Conn_01x04_Female; PinSocket_1x04_P2.54mm_Vertical
J2, J4, J10, J12: Conn_01x01_Female; PinSocket_1x01_P2.54mm_Vertical
J3: Conn_01x02_Female; PinSocket_1x02_P2.54mm_Vertical
P1: USART1; PinSocket_1x03_P2.54mm_Vertical
P2: USART2/3; PinSocket_1x03_P2.54mm_Vertical
P3: USB_B; USB_B_OST_USB-B1HSxx_Horizontal
Q1: DTA114Y; SOT-323_SC-70_Handsoldering
R1, R2, R14, R15: 4k7; R_0805_2012Metric_Pad1.15x1.40mm_HandSolder
R3: 10k; R_0603_1608Metric_Pad1.05x0.95mm_HandSolder
R5: 100k; R_0603_1608Metric_Pad1.05x0.95mm_HandSolder
R6, R7, R8, R9, R10, R11: 220; R_0805_2012Metric_Pad1.15x1.40mm_HandSolder
R12, R13: 22; R_0603_1608Metric_Pad1.05x0.95mm_HandSolder
R16: 1k5; R_0603_1608Metric_Pad1.05x0.95mm_HandSolder
RV1: 20k; Potentiometer
SW1: Reset; SW_PUSH_6mm
SW2: Boot; SW_PUSH_6mm
U1: LM1117-3.3; SOT-223
U2: STM32LQFP48; DIP-48_W15.24mm_Socket_LongPads
U3: USBLC6-2SC6; SOT-23-6_Handsoldering
Y1: 8MHz; Crystal_HC49-U_Vertical

Connections:
+3V3: C2.2, C3.1, C4.1, C7.2, C8.2, C9.2, C10.2, D1.2 (A), D2.2 (A), D3.2 (A), D4.2 (A), D5.2 (A), D6.2 (A), J1.1, J6.1, J6.2, J6.3, J6.4, J7.1, Q1.2 (E), R1.1, R2.1, RV1.1, SW2.2, U1.2 (VO), U1.4 (VO), U2.1 (VBAT), U2.9 (VDDA), U2.24 (VDD), U2.36 (VDDIO2), U2.48 (VDD)
+5V: P3.1 (VBUS), U1.3 (VI), U3.5 (VBUS)
/ADC0: R15.1, RV1.2, U2.10 (ADC_IN0/RTC_TAMP2/SYS_WKUP1/TIM2_CH1/TI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)
/ADC1: R14.1, R15.2, U2.11 (ADC_IN1/TIM2_CH2/TSC_G1_IO2/USART2_DE/U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)
/BOOT0: C2.1, R3.1, SW2.1, U2.44 (PF11)
/I2C_SCL: J1.2, R1.2, U2.42 (PB6/I2C1_SCL/TIM16_CH1N/TSC_G5_IO3/USAR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)
/I2C_SDA: J1.3, R2.2, U2.43 (PB7/I2C1_SDA/TIM17_CH1N/TSC_G5_IO4/USAR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)
/NRST: C1.1, SW1.1, U2.7 (NRST)
/OSC_IN: C5.1, U2.5 (PF0/CRS_SYNC/I2C1_SDA/RCC_OSC_IN), Y1.1
/OSC_OUT: C6.1, U2.6 (PF1/I2C1_SCL/RCC_OSC_OUT), Y1.2
/PWM1: J11.1, R7.2, U2.16 (ADC_IN6/I2S1_MCK/SPI1_MISO/TIM16_CH1/TI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)
/PWM2: J11.2, R8.2, U2.17 (ADC_IN7/I2S1_SD/SPI1_MOSI/TIM14_CH1/TIM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)
/PWM3: J11.3, R9.2, U2.18 (PB0/ADC_IN8/TIM1_CH2N/TIM3_CH3/TSC_G3_I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)
/PWM4: J11.4, R10.2, U2.19 (PB1/ADC_IN9/TIM14_CH1/TIM1_CH3N/TIM3_CH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)
/PWMT1ch1: J10.1, R11.2, U2.29 (CRS_SYNC/RCC_MCO/TIM1_CH1/USART1_CK/PA8)
/SPI1_MISO: J9.2, U2.40 (PB4/I2S1_MCK/SPI1_MISO/TIM17_BKIN/TIM3_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)
/SPI1_MOSI: J9.3, U2.41 (PB5/I2C1_SMBA/I2S1_SD/SPI1_MOSI/SYS_WKU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)
/SPI1_SCK: J9.1, U2.39 (PB3/I2S1_CK/SPI1_SCK/TIM2_CH2/TSC_G5_IO1)
/SPI2_MISO: J8.2, U2.27 (PB14/I2C1_SDA/SPI2_MISO/TIM1_CH2N)
/SPI2_MOSI: J8.3, U2.28 (PB15/RTC_REFIN/SPI2_MOSI/SYS_WKUP7/TIM1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)
/SPI2_SCK: J8.1, U2.26 (PB13/I2C1_SCL/SPI2_SCK/TIM1_CH1N)
/SWCLK: J7.3, U2.37 (SYS_SWCLK/USART2_TX/PA14)
/SWDIO: J7.2, U2.34 (IR_OUT/SYS_SWDIO/USB_OE/PA13)
/U1Rx: P1.3, U2.31 (I2C1_SDA/TIM17_BKIN/TIM1_CH3/TSC_G4_IO2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)
/U1Tx: P1.2, U2.30 (I2C1_SCL/TIM1_CH2/TSC_G4_IO1/USART1_TX/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)
/U2Rx: P2.3, U2.13 (ADC_IN3/TIM2_CH4/TSC_G1_IO4/USART2_RX/P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), U2.21 (PB10/CEC/I2C1_SCL/SPI2_SCK/TIM2_CH3/TSC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)
/U2Tx: P2.2, U2.12 (ADC_IN2/SYS_WKUP4/TIM2_CH3/TSC_G1_IO3/U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), U2.22 (PB11/I2C1_SDA/TIM2_CH4)
/USB_PU: Q1.1 (B), U2.38 (I2S1_WS/SPI1_NSS/TIM2_CH1/TIM2_ETR/USAR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)
GND: C1.2, C3.2, C4.2, C5.2, C6.2, C7.1, C8.1, C9.1, C10.1, J1.4, J5.1, J5.2, J5.3, J5.4, J7.4, J8.4, J9.4, P1.1, P2.1, P3.4 (GND), P3.5 (shield), R3.2, R5.2, R6.1, R14.2, RV1.3, SW1.2, U1.1 (GND/ADJ), U2.8 (VSSA), U2.23 (VSS), U2.35 (VSS), U2.47 (VSS), U3.2 (GND)
unnamed: D1.1 (K), R6.2
unnamed: D2.1 (K), R7.1
unnamed: D3.1 (K), R8.1
unnamed: D4.1 (K), R9.1
unnamed: D5.1 (K), R10.1
unnamed: D6.1 (K), R11.1
unnamed: J2.1, R5.1, U2.20 (PB2/TSC_G3_IO4)
unnamed: J3.1, U2.46 (PB9/CAN_TX/I2C1_SDA/IR_OUT/SPI2_NSS/TIM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)
unnamed: J3.2, U2.45 (PB8/CAN_RX/CEC/I2C1_SCL/TIM16_CH1/TSC_S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)
unnamed: J4.1, U2.25 (PB12/SPI2_NSS/TIM1_BKIN)
unnamed: J12.1, U2.14 (ADC_IN4/I2S1_WS/SPI1_NSS/TIM14_CH1/TSC_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), U2.15 (ADC_IN5/CEC/I2S1_CK/SPI1_SCK/TIM2_CH1/T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)
unnamed: P3.2 (D-), U3.6 (I/O1)
unnamed: P3.3 (D+), R16.2, U3.4 (I/O2)
unnamed: Q1.3 (C), R16.1
unnamed: R13.1, U3.3 (I/O2)
unnamed: R13.2, U2.33 (CAN_TX/I2C1_SDA/TIM1_ETR/TSC_G4_IO4/USA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)

Notes on the sheet:
Sens1
3.3V MCU power source
Crystal for STM32F103/303
PB8/9
AIN5/DAC_OUT1
Bootloader init
Sens2

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
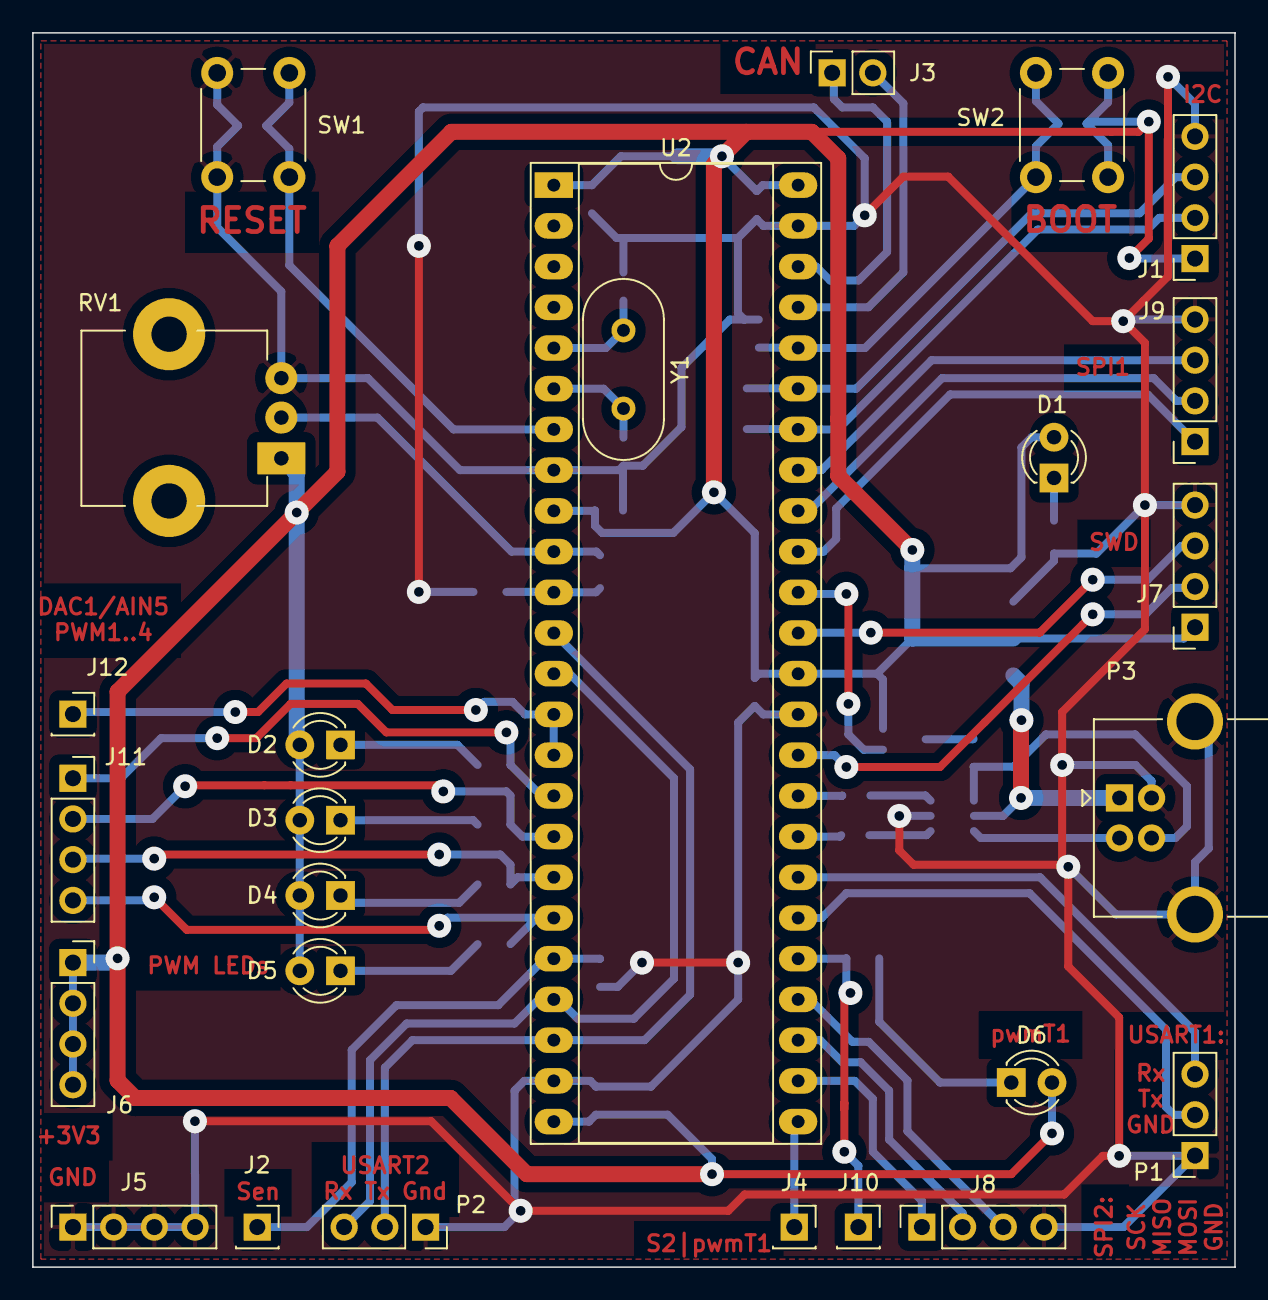
[picture p48: board testboard/F0_F1_F3-LQFP48_testboard/stm32.kicad_pcb from above]

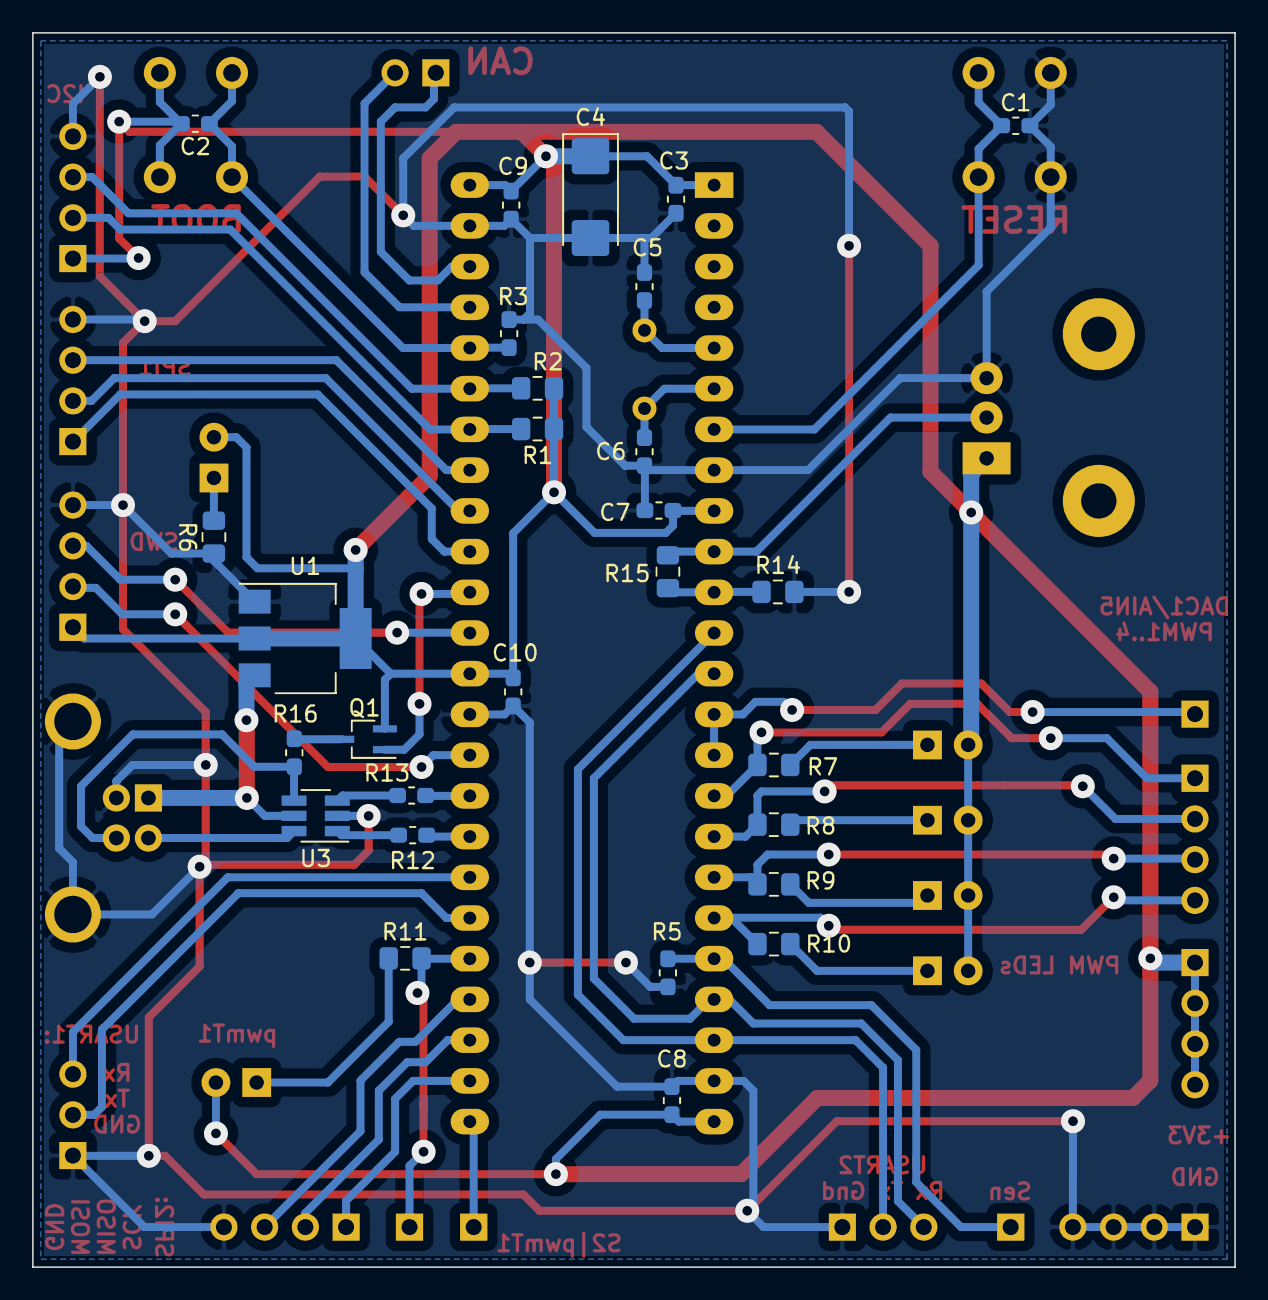
[picture p49: board testboard/F0_F1_F3-LQFP48_testboard/stm32.kicad_pcb from below]

Board: 2 copper layers, 75.0 x 77.0 mm, 54 parts (28 on the bottom side), 47 nets.
