eddyem/stm32samples/F3:F303/NitrogenFlooding/kicad/nitrogen/nitrogen.kicad_pcb

## KiCad design F3:F303/NitrogenFlooding/kicad/nitrogen/nitrogen.kicad_pcb (2024-05-06)

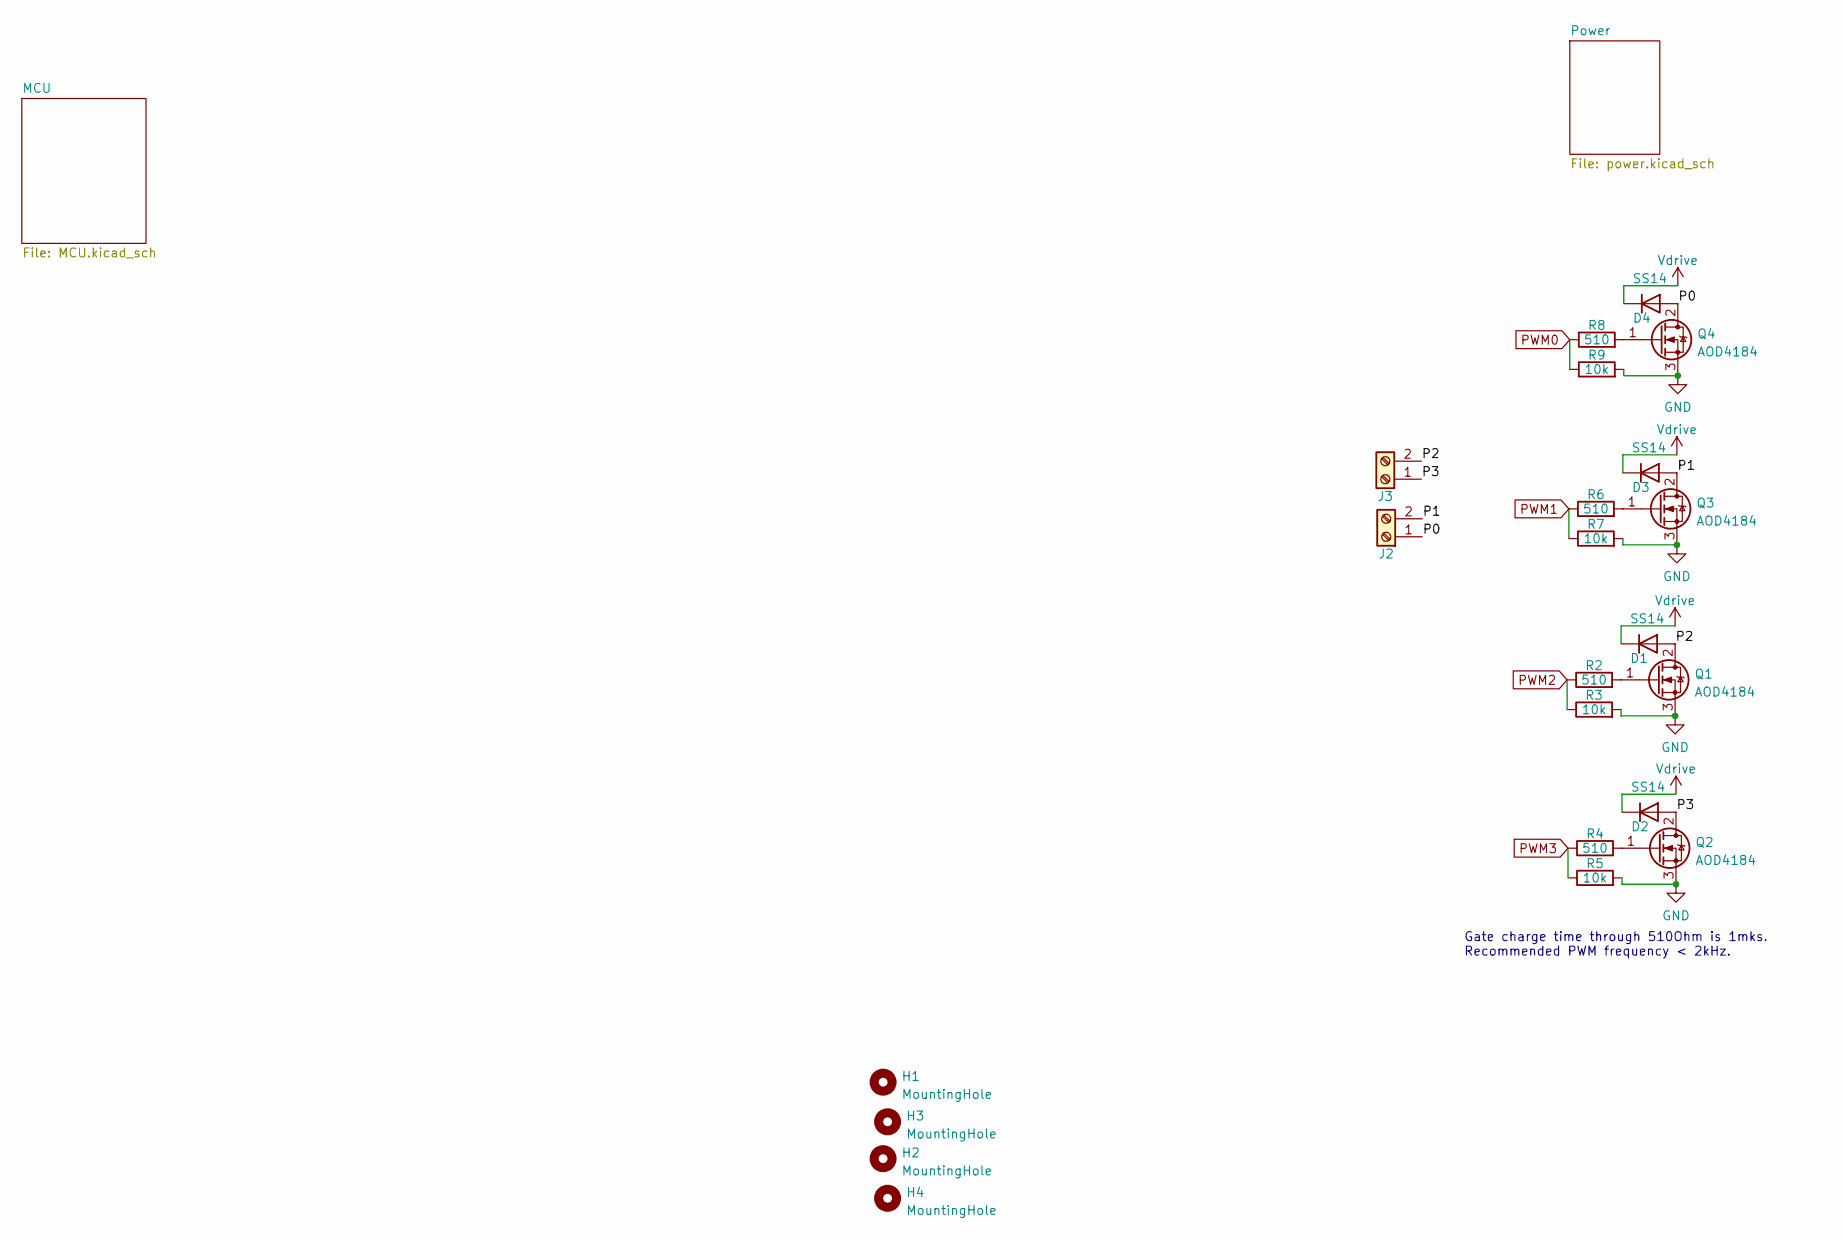
[picture p50: schematic nitrogen.kicad_sch]

Parts:
D1, D2, D3, D4: SS14; D_SMA_Handsoldering
H1, H2, H3, H4: MountingHole; MountingHole_3.2mm_M3_DIN965_Pad
J2, J3: Screw_Terminal_01x02; TerminalBlock_Phoenix_MKDS-1,5-2_1x02_P5.00mm_Horizontal
Q1, Q2, Q3, Q4: AOD4184; TO-252-2
R2, R4, R6, R8: 510; R_0603_1608Metric_Pad0.98x0.95mm_HandSolder
R3, R5, R7, R9: 10k; R_0603_1608Metric_Pad0.98x0.95mm_HandSolder

Connections:
/P0: D4.2 (A), J2.1, Q4.2 (D)
/P1: D3.2 (A), J2.2, Q3.2 (D)
/P2: D1.2 (A), J3.2, Q1.2 (D)
/P3: D2.2 (A), J3.1, Q2.2 (D)
GND: Q1.3 (S), Q2.3 (S), Q3.3 (S), Q4.3 (S), R3.2, R5.2, R7.2, R9.2; also elsewhere on the board
unnamed: Q1.1 (G), R2.2
unnamed: Q2.1 (G), R4.2
unnamed: Q3.1 (G), R6.2
unnamed: Q4.1 (G), R8.2
PWM0: R8.1, R9.1; also elsewhere on the board
PWM1: R6.1, R7.1; also elsewhere on the board
PWM2: R2.1, R3.1; also elsewhere on the board
PWM3: R4.1, R5.1; also elsewhere on the board
Vdrive: D1.1 (K), D2.1 (K), D3.1 (K), D4.1 (K); also elsewhere on the board

Notes on the sheet:
Gate charge time through 510Ohm is 1mks. Recommended PWM frequency < 2kHz.
