eddyem/stm32samples/F3:F303/NitrogenFlooding/kicad/nitrogen/nitrogen.kicad_pcb

## KiCad design F3:F303/NitrogenFlooding/kicad/nitrogen/nitrogen.kicad_pcb (continued)

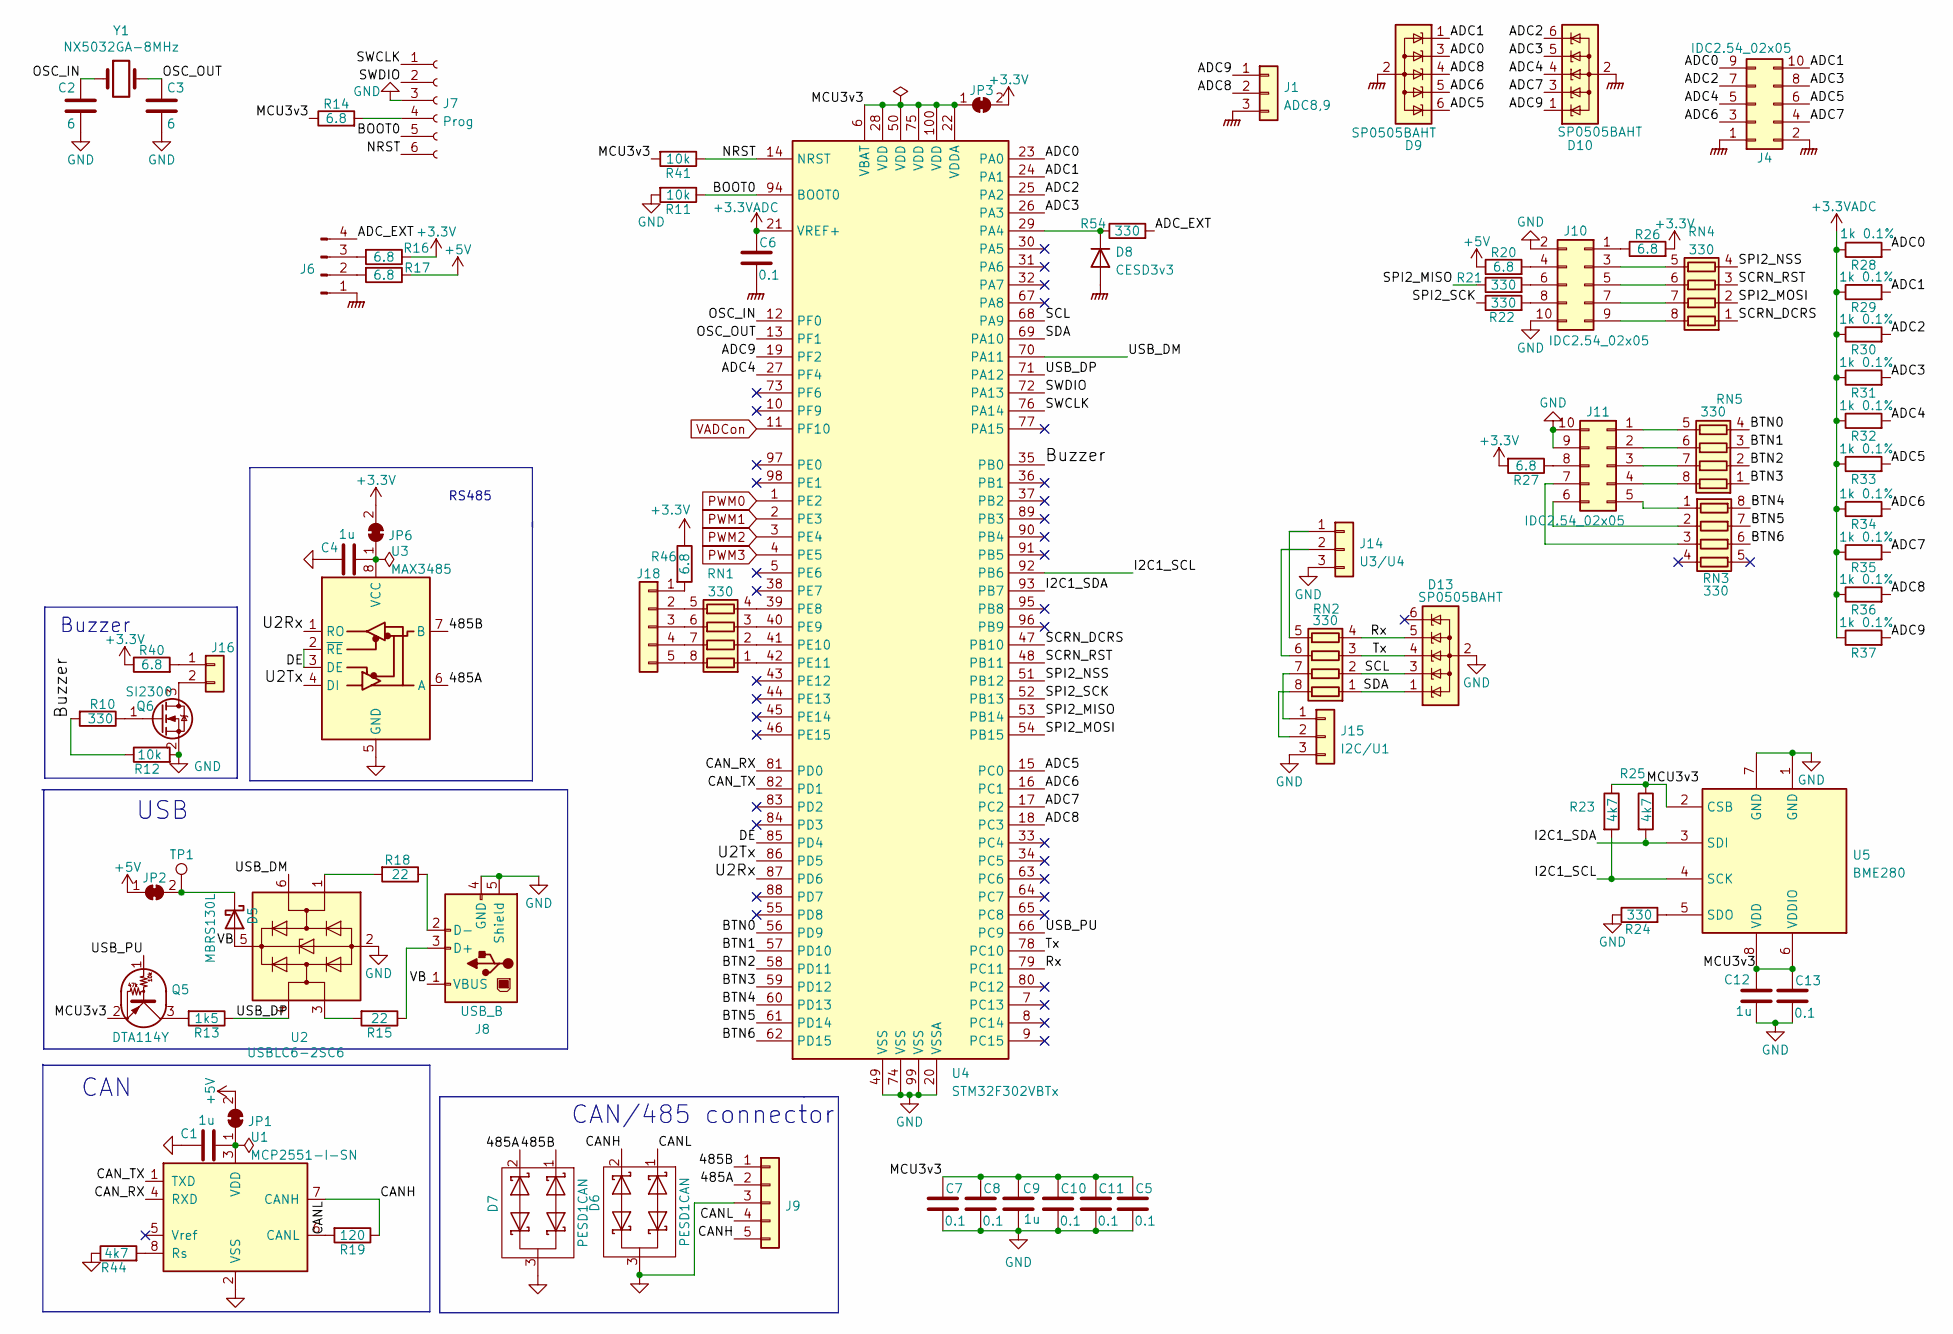
[picture p51: schematic MCU.kicad_sch]

Parts:
C1, C4, C9, C12: 1u; C_0603_1608Metric_Pad1.08x0.95mm_HandSolder
C2, C3: 6; C_0603_1608Metric_Pad1.08x0.95mm_HandSolder
C5, C6, C7, C8, C10, C11, C13: 0.1; C_0603_1608Metric_Pad1.08x0.95mm_HandSolder
D5: MBRS130L; D_SMB_Handsoldering
D6, D7: PESD1CAN; SOT-23
D8: CESD3v3; D_SOD-523
D9, D10, D13: SP0505BAHT; SOT-23-6
J1: ADC8,9; JST_EH_B3B-EH-A_1x03_P2.50mm_Vertical
J4, J10, J11: IDC2.54_02x05; IDC-Header_2x05_P2.54mm_Vertical
J6: ADCext; JST_EH_B4B-EH-A_1x04_P2.50mm_Vertical
J7: Prog; PinSocket_1x06_P1.27mm_Vertical
J8: USB_B; USB_B_TE_5787834_Vertical
J9: 485/CAN; JST_EH_B5B-EH-A_1x05_P2.50mm_Vertical
J14: U3/U4; JST_EH_B3B-EH-A_1x03_P2.50mm_Vertical
J15: I2C/U1; JST_EH_B3B-EH-A_1x03_P2.50mm_Vertical
J16: buzzer; PinSocket_1x02_P2.54mm_Vertical
J18: LEDs; JST_EH_B5B-EH-A_1x05_P2.50mm_Vertical
JP1: CAN; SolderJumper-2_P1.3mm_Open_TrianglePad1.0x1.5mm
JP2: USB5V; SolderJumper-2_P1.3mm_Open_TrianglePad1.0x1.5mm
JP3: MCU; SolderJumper-2_P1.3mm_Open_TrianglePad1.0x1.5mm
JP6: RS-485; SolderJumper-2_P1.3mm_Open_TrianglePad1.0x1.5mm
Q5: DTA114Y; SOT-323_SC-70_Handsoldering
Q6: SI2300; SOT-23_Handsoldering
R10, R21, R22, R24, R54: 330; R_0603_1608Metric_Pad0.98x0.95mm_HandSolder
R11, R12, R41: 10k; R_0603_1608Metric_Pad0.98x0.95mm_HandSolder
R13: 1k5; R_0603_1608Metric_Pad0.98x0.95mm_HandSolder
R14, R16, R17, R20, R26, R27, R40, R46: 6.8; R_0603_1608Metric_Pad0.98x0.95mm_HandSolder
R15, R18: 22; R_0603_1608Metric_Pad0.98x0.95mm_HandSolder
R19: 120; R_1210_3225Metric_Pad1.30x2.65mm_HandSolder
R23, R25, R44: 4k7; R_0603_1608Metric_Pad0.98x0.95mm_HandSolder
R28, R29, R30, R31, R32, R33, R34, R35, R36, R37: 1k 0.1%; R_0805_2012Metric_Pad1.20x1.40mm_HandSolder
RN1, RN2, RN3, RN4, RN5: 330; R_Array_Convex_4x0603
TP1: 5Vusb; TestPoint_THTPad_1.5x1.5mm_Drill0.7mm
U1: MCP2551-I-SN; SOIC-8_3.9x4.9mm_P1.27mm
U2: USBLC6-2SC6; SOT-23-6
U3: MAX3485; SO-8_3.9x4.9mm_P1.27mm
U4: STM32F302VBTx; LQFP-100_14x14mm_P0.5mm
U5: BME280; Bosch_LGA-8_2.5x2.5mm_P0.65mm_ClockwisePinNumbering
Y1: NX5032GA-8MHz; Crystal_SMD_5032-2Pin_5.0x3.2mm

Connections:
+3.3V: JP3.2 (B), JP6.2 (B), R16.1, R26.2, R27.2, R40.1, R46.1; also elsewhere on the board
+3.3VADC: C6.1, R28.1, R29.1, R30.1, R31.1, R32.1, R33.1, R34.1, R35.1, R36.1, R37.1, U4.21 (VREF+); also elsewhere on the board
+5V: JP1.2 (B), JP2.1 (A), R17.1, R20.1; also elsewhere on the board
/MCU/485A: D7.2 (K), J9.2, U3.6 (A)
/MCU/485B: D7.1 (K), J9.1, U3.7 (B)
/MCU/ADC0: D9.3 (K), J4.9, R28.2, U4.23 (PA0)
/MCU/ADC1: D9.1 (K), J4.10, R29.2, U4.24 (PA1)
/MCU/ADC2: D10.6 (K), J4.7, R30.2, U4.25 (PA2)
/MCU/ADC3: D10.5 (K), J4.8, R31.2, U4.26 (PA3)
/MCU/ADC4: D10.4 (K), J4.5, R32.2, U4.27 (PF4)
/MCU/ADC5: D9.6 (K), J4.6, R33.2, U4.15 (PC0)
/MCU/ADC6: D9.5 (K), J4.3, R34.2, U4.16 (PC1)
/MCU/ADC7: D10.3 (K), J4.4, R35.2, U4.17 (PC2)
/MCU/ADC8: D9.4 (K), J1.2, R36.2, U4.18 (PC3)
/MCU/ADC9: D10.1 (K), J1.1, R37.2, U4.19 (PF2)
/MCU/ADC_EXT: J6.4, R54.2
/MCU/BOOT0: J7.5, R11.1, U4.94 (BOOT0)
/MCU/BTN0: RN5.4 (R4.1), U4.56 (PD9)
/MCU/BTN1: RN5.3 (R3.1), U4.57 (PD10)
/MCU/BTN2: RN5.2 (R2.1), U4.58 (PD11)
/MCU/BTN3: RN5.1 (R1.1), U4.59 (PD12)
/MCU/BTN4: RN3.8 (R1.2), U4.60 (PD13)
/MCU/BTN5: RN3.7 (R2.2), U4.61 (PD14)
/MCU/BTN6: RN3.6 (R3.2), U4.62 (PD15)
/MCU/Buzzer: R10.2, R12.1, U4.35 (PB0)
/MCU/CANH: D6.2 (K), J9.5, R19.1, U1.7 (CANH)
/MCU/CANL: D6.1 (K), J9.4, R19.2, U1.6 (CANL)
/MCU/CAN_RX: U1.4 (RXD), U4.81 (PD0)
/MCU/CAN_TX: U1.1 (TXD), U4.82 (PD1)
/MCU/DE: U3.2 (~RE), U3.3 (DE), U4.85 (PD4)
/MCU/I2C1_SCL: R23.2, U4.92 (PB6), U5.4 (SCK)
/MCU/I2C1_SDA: R25.2, U4.93 (PB7), U5.3 (SDI)
/MCU/MCU3v3: C5.1, C7.1, C8.1, C9.1, C10.1, C11.1, C12.1, C13.1, JP3.1 (A), Q5.2 (E), R14.1, R23.1, R25.1, R41.2, U4.6 (VBAT), U4.22 (VDDA), U4.28 (VDD), U4.50 (VDD), U4.75 (VDD), U4.100 (VDD), U5.2 (CSB), U5.6 (VDDIO), U5.8 (VDD)
/MCU/NRST: J7.6, R41.1, U4.14 (NRST)
/MCU/OSC_IN: C2.1, U4.12 (PF0), Y1.1
/MCU/OSC_OUT: C3.1, U4.13 (PF1), Y1.2
/MCU/Rx: D13.5 (K), RN2.4 (R4.1), U4.79 (PC11)
/MCU/SCL: D13.3 (K), RN2.2 (R2.1), U4.68 (PA9)
/MCU/SCRN_DCRS: RN4.1 (R1.1), U4.47 (PB10)
/MCU/SCRN_RST: RN4.3 (R3.1), U4.48 (PB11)
/MCU/SDA: D13.1 (K), RN2.1 (R1.1), U4.69 (PA10)
/MCU/SPI2_MISO: R21.1, U4.53 (PB14)
/MCU/SPI2_MOSI: RN4.2 (R2.1), U4.54 (PB15)
/MCU/SPI2_NSS: RN4.4 (R4.1), U4.51 (PB12)
/MCU/SPI2_SCK: R22.1, U4.52 (PB13)
/MCU/SWCLK: J7.1, U4.76 (PA14)
/MCU/SWDIO: J7.2, U4.72 (PA13)
/MCU/Tx: D13.4 (K), RN2.3 (R3.1), U4.78 (PC10)
/MCU/U2Rx: U3.1 (RO), U4.87 (PD6)
/MCU/U2Tx: U3.4 (DI), U4.86 (PD5)
/MCU/USB_DM: U2.6 (I/O1), U4.70 (PA11)
/MCU/USB_DP: R13.1, U2.4 (I/O2), U4.71 (PA12)
/MCU/USB_PU: Q5.1 (B), U4.66 (PC9)
/MCU/VB: D5.2 (A), J8.1 (VBUS), U2.5 (VBUS)
GND: C1.1, C2.2, C3.2, C4.1, C5.2, C7.2, C8.2, C9.2, C10.2, C11.2, C12.2, C13.2, D6.3 (O), D7.3 (O), D13.2 (A), J7.3, J8.4 (GND), J8.5 (Shield), J9.3, J10.2, J10.10, J11.9, J11.10, J14.3, J15.3, Q6.2 (S), R11.2, R12.2, R24.1, R44.1, U1.2 (VSS), U2.2 (GND), U3.5 (GND), U4.20 (VSSA), U4.49 (VSS), U4.74 (VSS), U4.99 (VSS), U5.1 (GND), U5.7 (GND); also elsewhere on the board
GNDPWR: C6.2, D8.2 (A), D9.2 (A), D10.2 (A), J1.3, J4.1, J4.2, J6.1; also elsewhere on the board
unnamed: C1.2, JP1.1 (A), U1.3 (VDD)
unnamed: C4.2, JP6.1 (A), U3.8 (VCC)
unnamed: D5.1 (K), JP2.2 (B), TP1.1
unnamed: D8.1 (K), R54.1, U4.29 (PA4)
unnamed: J6.2, R17.2
unnamed: J6.3, R16.2
unnamed: J7.4, R14.2
unnamed: J8.2 (D-), R18.1
unnamed: J8.3 (D+), R15.1
unnamed: J10.1, R26.1
unnamed: J10.3, RN4.5 (R4.2)
unnamed: J10.4, R20.2
unnamed: J10.5, RN4.6 (R3.2)
unnamed: J10.6, R21.2
unnamed: J10.7, RN4.7 (R2.2)
unnamed: J10.8, R22.2
unnamed: J10.9, RN4.8 (R1.2)
unnamed: J11.1, RN5.5 (R4.2)
unnamed: J11.2, RN5.6 (R3.2)
unnamed: J11.3, RN5.7 (R2.2)
unnamed: J11.4, RN5.8 (R1.2)
unnamed: J11.5, RN3.1 (R1.1)
unnamed: J11.6, RN3.2 (R2.1)
unnamed: J11.7, RN3.3 (R3.1)
unnamed: J11.8, R27.1
unnamed: J14.1, RN2.5 (R4.2)
unnamed: J14.2, RN2.6 (R3.2)
unnamed: J15.1, RN2.7 (R2.2)
unnamed: J15.2, RN2.8 (R1.2)
unnamed: J16.1, R40.2
unnamed: J16.2, Q6.3 (D)
unnamed: J18.1, R46.2
unnamed: J18.2, RN1.5 (R4.2)
unnamed: J18.3, RN1.6 (R3.2)
unnamed: J18.4, RN1.7 (R2.2)
unnamed: J18.5, RN1.8 (R1.2)
unnamed: Q5.3 (C), R13.2
unnamed: Q6.1 (G), R10.1
unnamed: R15.2, U2.3 (I/O2)
unnamed: R18.2, U2.1 (I/O1)
unnamed: R24.2, U5.5 (SDO)
unnamed: R44.2, U1.8 (Rs)
unnamed: RN1.1 (R1.1), U4.42 (PE11)
unnamed: RN1.2 (R2.1), U4.41 (PE10)
unnamed: RN1.3 (R3.1), U4.40 (PE9)
unnamed: RN1.4 (R4.1), U4.39 (PE8)
PWM0: U4.1 (PE2); also elsewhere on the board
PWM1: U4.2 (PE3); also elsewhere on the board
PWM2: U4.3 (PE4); also elsewhere on the board
PWM3: U4.4 (PE5); also elsewhere on the board
VADCon: U4.11 (PF10); also elsewhere on the board

Notes on the sheet:
USB
RS485
Buzzer
CAN/485 connector
CAN

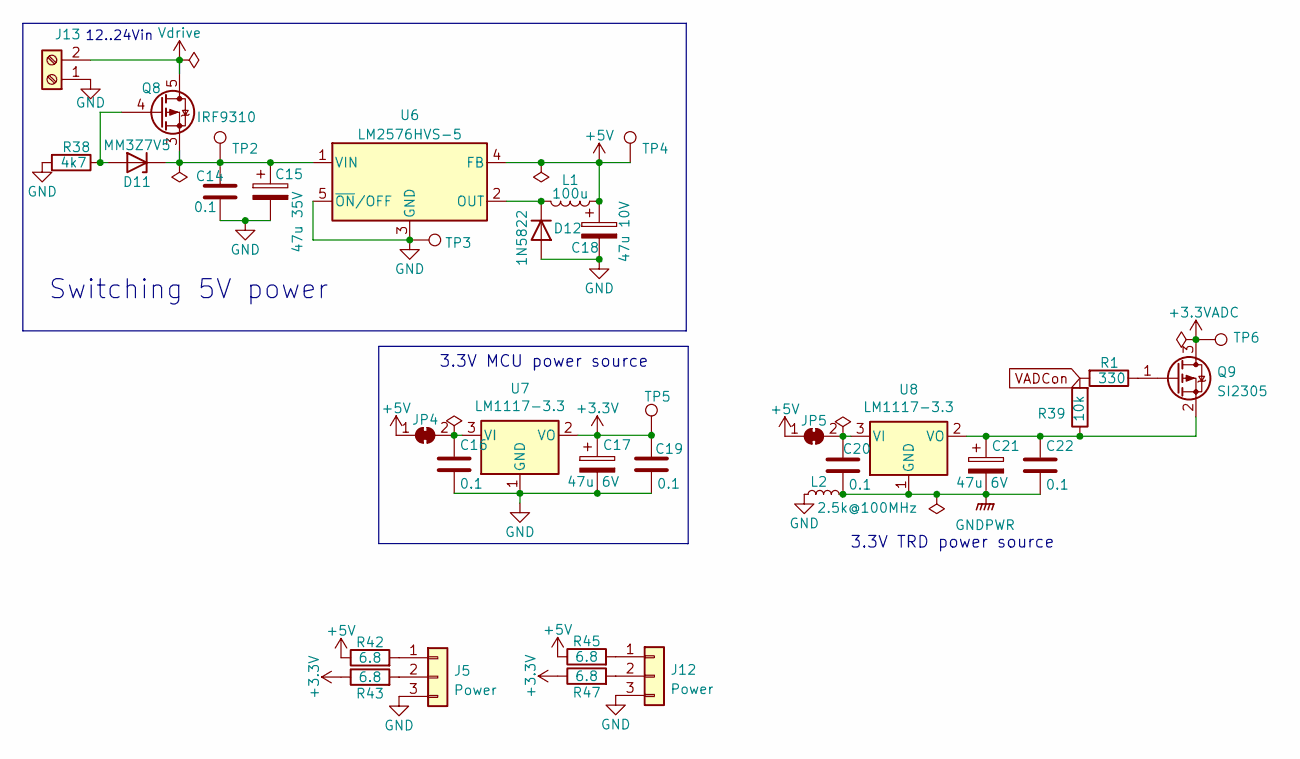
[picture p52: schematic power.kicad_sch]

Parts:
C14, C16, C19, C20, C22: 0.1; C_0603_1608Metric_Pad1.08x0.95mm_HandSolder
C15: 47u 35V; CP_EIA-6032-28_Kemet-C_Pad2.25x2.35mm_HandSolder
C17, C21: 47u 6V; CP_EIA-3216-18_Kemet-A_Pad1.58x1.35mm_HandSolder
C18: 47u 10V; CP_EIA-6032-28_Kemet-C_Pad2.25x2.35mm_HandSolder
D11: MM3Z7V5; D_0805_2012Metric_Pad1.15x1.40mm_HandSolder
D12: 1N5822; D_DO-201_P3.81mm_Vertical_AnodeUp
J5, J12: Power; JST_EH_B3B-EH-A_1x03_P2.50mm_Vertical
J13: Screw_Terminal_01x02; TerminalBlock_Phoenix_MKDS-1,5-2_1x02_P5.00mm_Horizontal
JP4: 3v3; SolderJumper-2_P1.3mm_Open_TrianglePad1.0x1.5mm
JP5: Vadc; SolderJumper-2_P1.3mm_Open_TrianglePad1.0x1.5mm
L1: 100u; L_Toroid_Horizontal_D6.5mm_P10.00mm_Diameter7-5mm_Amidon-T25
L2: 2.5k@100MHz; L_0805_2012Metric_Pad1.15x1.40mm_HandSolder
Q8: IRF9310; SO-8_3.9x4.9mm_P1.27mm
Q9: SI2305; SOT-23_Handsoldering
R1: 330; R_0603_1608Metric_Pad0.98x0.95mm_HandSolder
R38: 4k7; R_0603_1608Metric_Pad0.98x0.95mm_HandSolder
R39: 10k; R_0603_1608Metric_Pad0.98x0.95mm_HandSolder
R42, R43, R45, R47: 6.8; R_0603_1608Metric_Pad0.98x0.95mm_HandSolder
TP2: Vin; TestPoint_THTPad_1.5x1.5mm_Drill0.7mm
TP3: Gnd; TestPoint_THTPad_1.5x1.5mm_Drill0.7mm
TP4: 5V; TestPoint_THTPad_1.5x1.5mm_Drill0.7mm
TP5: 3.3V; TestPoint_THTPad_1.5x1.5mm_Drill0.7mm
TP6: Vadc; TestPoint_THTPad_1.5x1.5mm_Drill0.7mm
U6: LM2576HVS-5; TO-263-5_TabPin3
U7, U8: LM1117-3.3; SOT-223-3_TabPin2

Connections:
+3.3V: C17.1, C19.1, R43.1, R47.1, TP5.1, U7.2 (VO); also elsewhere on the board
+3.3VADC: Q9.3 (D), TP6.1; also elsewhere on the board
+5V: C18.1, JP4.1 (A), JP5.1 (A), L1.1, R42.1, R45.1, TP4.1, U6.4 (FB); also elsewhere on the board
GND: C14.2, C15.2, C16.2, C17.2, C18.2, C19.2, D12.2 (A), J5.3, J12.3, J13.1, L2.1, R38.2, TP3.1, U6.3 (GND), U6.5 (~ON/OFF), U7.1 (GND); also elsewhere on the board
GNDPWR: C20.2, C21.2, C22.2, L2.2, U8.1 (GND); also elsewhere on the board
unnamed: C14.1, C15.1, D11.1 (K), Q8.1 (S), Q8.2 (S), Q8.3 (S), TP2.1, U6.1 (VIN)
unnamed: C16.1, JP4.2 (B), U7.3 (VI)
unnamed: C20.1, JP5.2 (B), U8.3 (VI)
unnamed: C21.1, C22.1, Q9.2 (S), R39.1, U8.2 (VO)
unnamed: D11.2 (A), Q8.4 (G), R38.1
unnamed: D12.1 (K), L1.2, U6.2 (OUT)
unnamed: J5.1, R42.2
unnamed: J5.2, R43.2
unnamed: J12.1, R45.2
unnamed: J12.2, R47.2
unnamed: Q9.1 (G), R1.1
VADCon: R1.2, R39.2; also elsewhere on the board
Vdrive: J13.2, Q8.5 (D), Q8.6 (D), Q8.7 (D), Q8.8 (D); also elsewhere on the board

Notes on the sheet:
Switching 5V power
3.3V MCU power source
12..24Vin
3.3V TRD power source

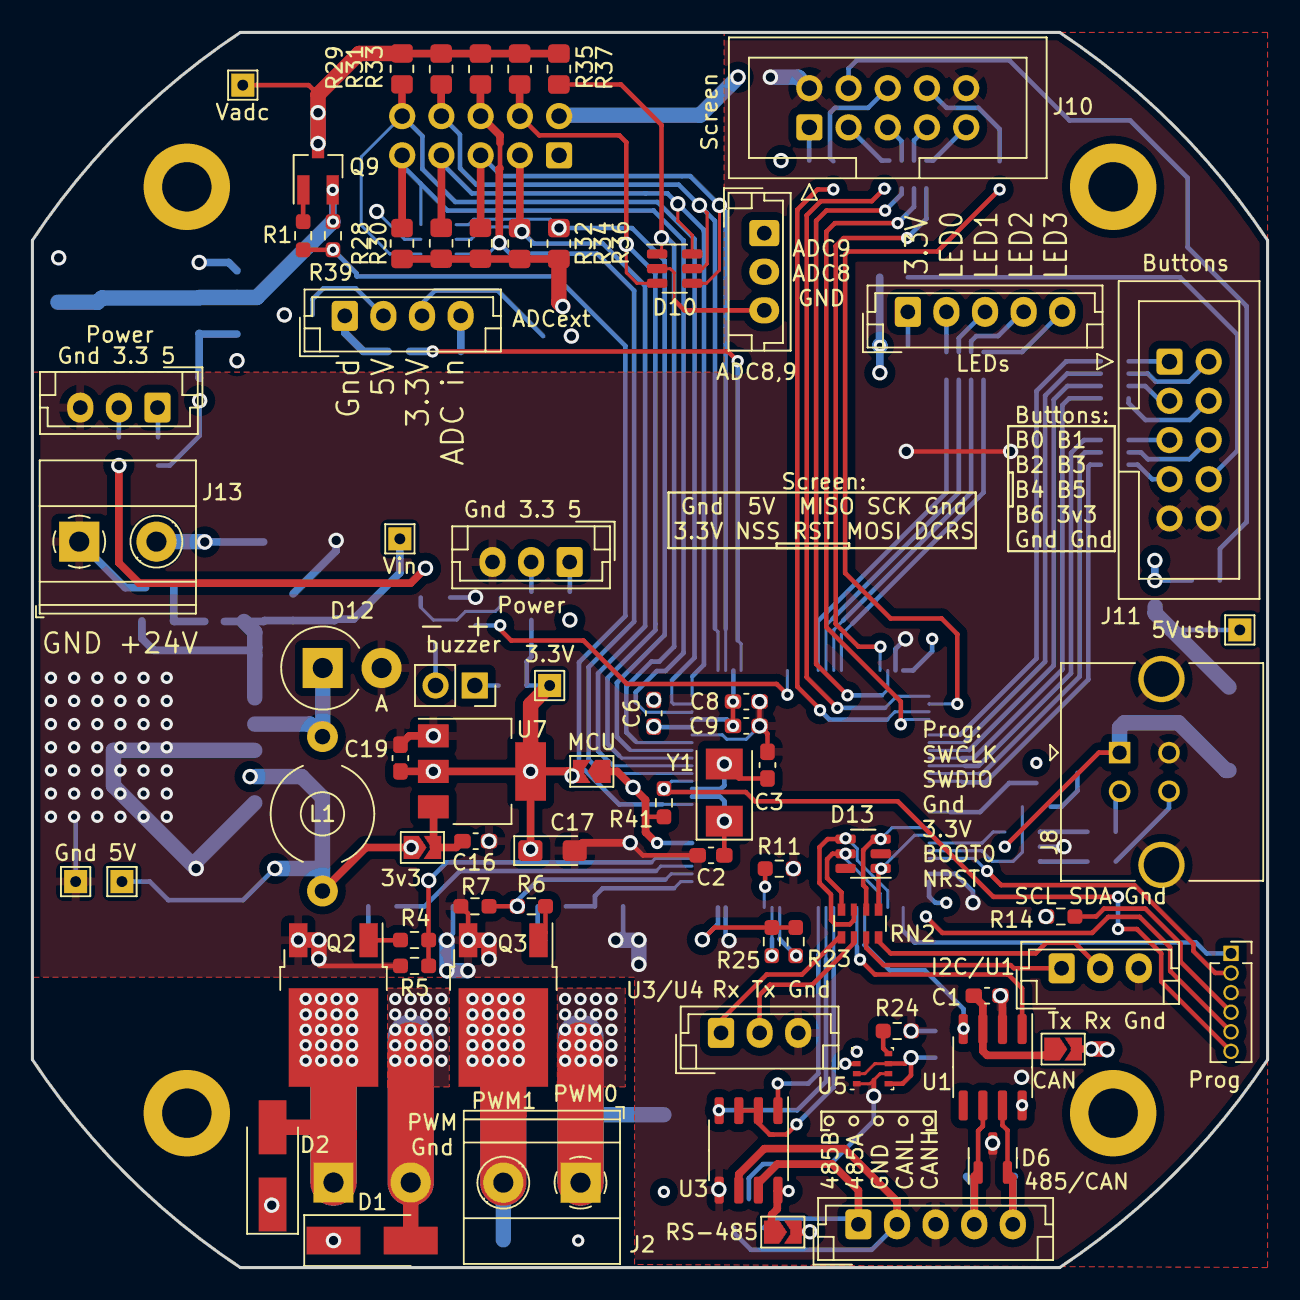
[picture p53: board nitrogen.kicad_pcb from above]

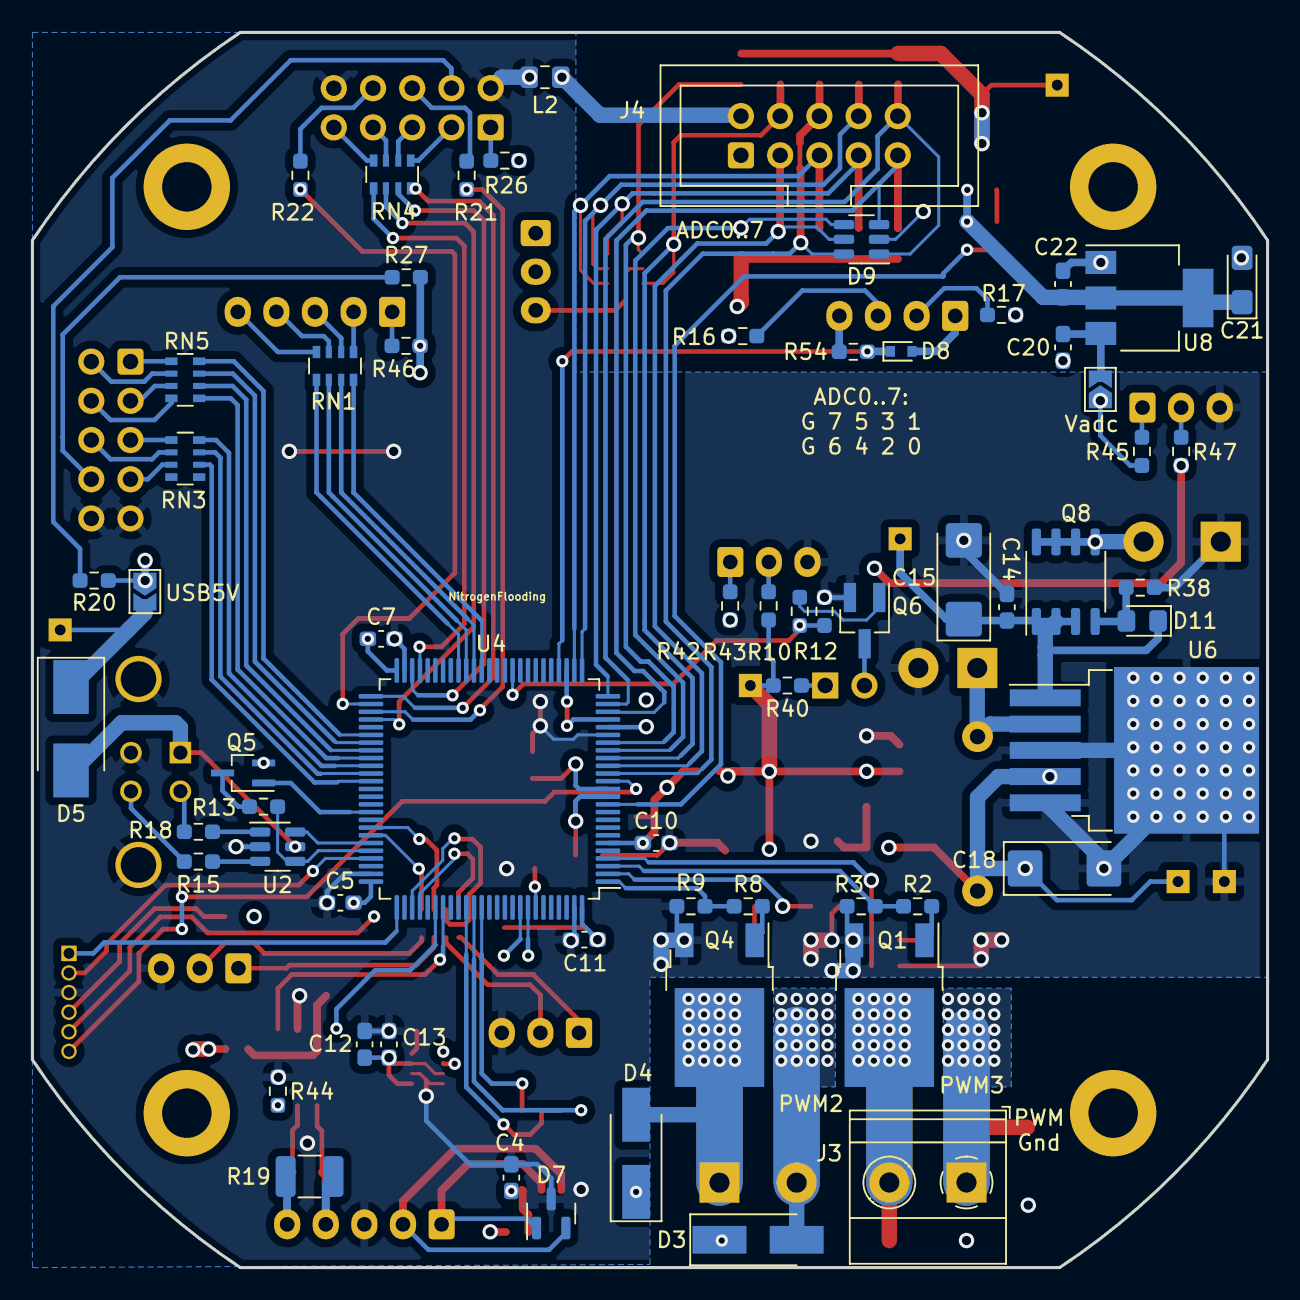
[picture p54: board nitrogen.kicad_pcb from below]

Board: 4 copper layers, 80.0 x 80.0 mm, 140 parts (64 on the bottom side), 127 nets.
