eddyem/stm32samples/F0:F030,F042,F072/Servo/kicad/Servo_control.kicad_pcb

## KiCad design F0:F030,F042,F072/Servo/kicad/Servo_control.kicad_pcb (2024-05-06)

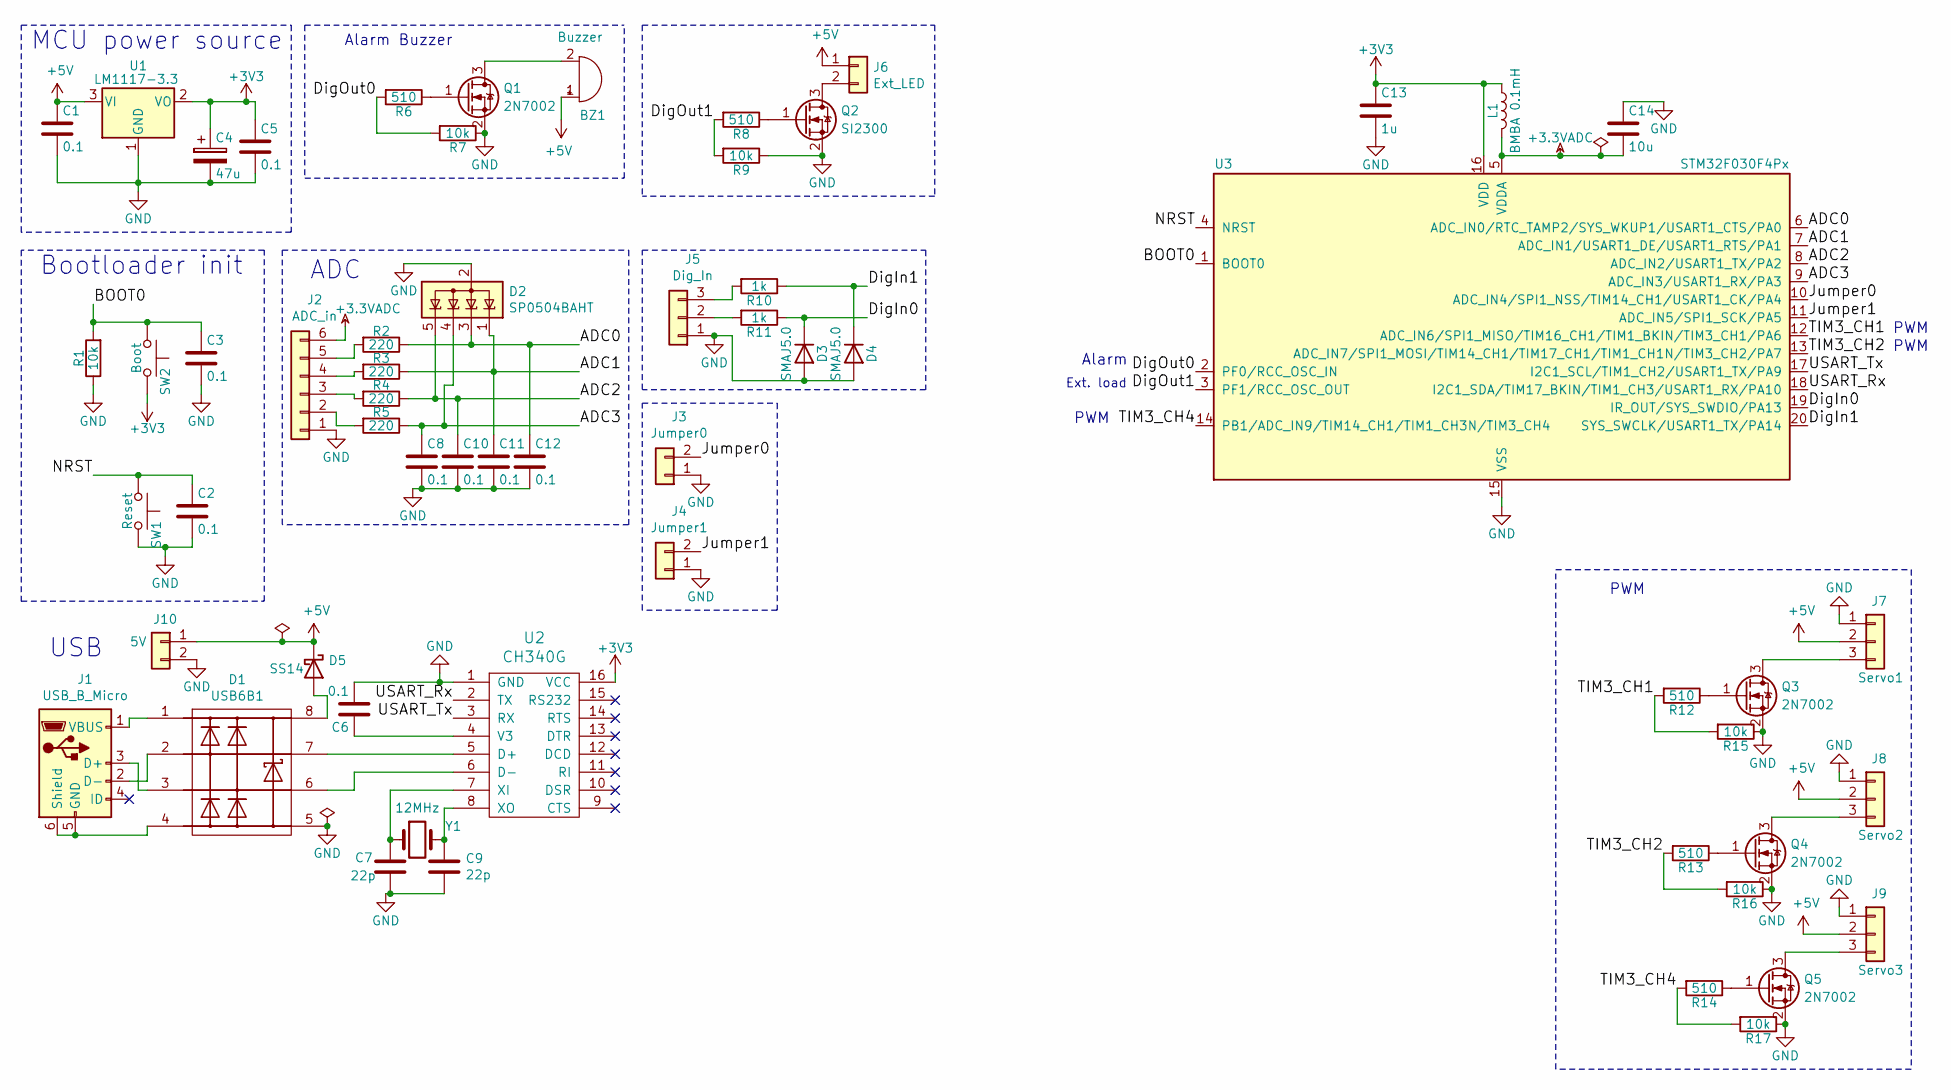
[picture p55: schematic Servo_control.kicad_sch]

Parts:
BZ1: Buzzer; Buzzer_12x9.5RM7.6
C1, C2, C3, C5, C6, C8, C10, C11, C12: 0.1; C_0603_1608Metric_Pad0.84x1.00mm_HandSolder
C4: 47u; CP_EIA-3216-18_Kemet-A_Pad1.53x1.40mm_HandSolder
C7, C9: 22p; C_0603_1608Metric_Pad0.84x1.00mm_HandSolder
C13: 1u; C_0805_2012Metric_Pad1.15x1.50mm_HandSolder
C14: 10u; C_1206_3216Metric_Pad1.24x1.80mm_HandSolder
D1: USB6B1; SOIC-8_3.9x4.9mm_P1.27mm
D2: SP0504BAHT; SOT-23-5
D3, D4: SMAJ5.0; D_SMA_Handsoldering
D5: SS14; D_SMA_Handsoldering
J1: USB_B_Micro; USB_Micro-B_Wuerth-629105150521
J2: ADC_in; PinHeader_1x06_P2.54mm_Vertical
J3: Jumper0; PinHeader_1x02_P2.54mm_Vertical
J4: Jumper1; PinHeader_1x02_P2.54mm_Vertical
J5: Dig_In; PinHeader_1x03_P2.54mm_Vertical
J6: Ext_LED; PinHeader_1x02_P2.54mm_Vertical
J7: Servo1; PinHeader_1x03_P2.54mm_Vertical
J8: Servo2; PinHeader_1x03_P2.54mm_Vertical
J9: Servo3; PinHeader_1x03_P2.54mm_Vertical
J10: 5V; PinHeader_1x02_P2.54mm_Vertical
L1: BMBA 0.1mH; L_0805_2012Metric_Pad1.15x1.50mm_HandSolder
Q1, Q3, Q4, Q5: 2N7002; SOT-23
Q2: SI2300; SOT-23
R1, R7, R9, R15, R16, R17: 10k; R_0805_2012Metric_Pad1.15x1.50mm_HandSolder
R2, R3, R4, R5: 220; R_0805_2012Metric_Pad1.15x1.50mm_HandSolder
R6, R8, R12, R13, R14: 510; R_0805_2012Metric_Pad1.15x1.50mm_HandSolder
R10, R11: 1k; R_0805_2012Metric_Pad1.15x1.50mm_HandSolder
SW1: Reset; SW_SPST_FSMSM
SW2: Boot; SW_SPST_FSMSM
U1: LM1117-3.3; SOT-223-3_TabPin2
U2: CH340G; SOIC-16_3.9x9.9mm_P1.27mm
U3: STM32F030F4Px; TSSOP-20_4.4x6.5mm_P0.65mm
Y1: 12MHz; Crystal_HC49-U_Vertical

Connections:
+3.3VADC: C14.2, J2.6, L1.2, U3.5 (VDDA)
+3V3: C4.1, C5.1, C13.1, L1.1, SW2.2, U1.2 (VO), U2.16 (VCC), U3.16 (VDD)
+5V: BZ1.1 (+), C1.1, D5.1 (K), J6.1, J7.2, J8.2, J9.2, J10.1, U1.3 (VI)
/ADC0: C12.1, D2.3 (K), R2.1, U3.6 (ADC_IN0/RTC_TAMP2/SYS_WKUP1/USART1_CTS/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)
/ADC1: C11.1, D2.1 (K), R3.1, U3.7 (ADC_IN1/USART1_DE/USART1_RTS/PA1)
/ADC2: C10.1, D2.5 (K), R4.1, U3.8 (ADC_IN2/USART1_TX/PA2)
/ADC3: C8.1, D2.4 (K), R5.1, U3.9 (ADC_IN3/USART1_RX/PA3)
/BOOT0: C3.1, R1.2, SW2.1, U3.1 (BOOT0)
/DigIn0: D3.1 (K), R11.1, U3.19 (IR_OUT/SYS_SWDIO/PA13)
/DigIn1: D4.1 (K), R10.1, U3.20 (SYS_SWCLK/USART1_TX/PA14)
/DigOut0: R6.2, R7.2, U3.2 (PF0/RCC_OSC_IN)
/DigOut1: R8.2, R9.2, U3.3 (PF1/RCC_OSC_OUT)
/Jumper0: J3.2, U3.10 (ADC_IN4/SPI1_NSS/TIM14_CH1/USART1_CK/PA4)
/Jumper1: J4.2, U3.11 (ADC_IN5/SPI1_SCK/PA5)
/NRST: C2.1, SW1.1, U3.4 (NRST)
/TIM3_CH1: R12.2, R15.2, U3.12 (ADC_IN6/SPI1_MISO/TIM16_CH1/TIM1_BKIN/T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)
/TIM3_CH2: R13.2, R16.2, U3.13 (ADC_IN7/SPI1_MOSI/TIM14_CH1/TIM17_CH1/T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)
/TIM3_CH4: R14.2, R17.2, U3.14 (PB1/ADC_IN9/TIM14_CH1/TIM1_CH3N/TIM3_CH4)
/USART_Rx: U2.2 (TX), U3.18 (I2C1_SDA/TIM17_BKIN/TIM1_CH3/USART1_RX/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)
/USART_Tx: U2.3 (RX), U3.17 (I2C1_SCL/TIM1_CH2/USART1_TX/PA9)
GND: C1.2, C2.2, C3.2, C4.2, C5.2, C6.2, C7.2, C8.2, C9.2, C10.2, C11.2, C12.2, C13.2, C14.1, D1.5 (GND), D2.2 (A), D3.2 (A), D4.2 (A), J2.1, J3.1, J4.1, J5.1, J7.1, J8.1, J9.1, J10.2, Q1.2 (S), Q2.2 (S), Q3.2 (S), Q4.2 (S), Q5.2 (S), R1.1, R7.1, R9.1, R15.1, R16.1, R17.1, SW1.2, U1.1 (GND), U2.1 (GND), U3.15 (VSS)
unnamed: BZ1.2 (-), Q1.3 (D)
unnamed: C6.1, U2.4 (V3)
unnamed: C7.1, U2.7 (XI), Y1.1
unnamed: C9.1, U2.8 (XO), Y1.2
unnamed: D1.1 (VCC), J1.1 (VBUS)
unnamed: D1.2 (I/O1), J1.2 (D-)
unnamed: D1.3 (I/O2), J1.3 (D+)
unnamed: D1.4 (GND), J1.5 (GND), J1.6 (Shield)
unnamed: D1.6 (I/O2), U2.6 (D-)
unnamed: D1.7 (I/O1), U2.5 (D+)
unnamed: D1.8 (VCC), D5.2 (A)
unnamed: J2.2, R5.2
unnamed: J2.3, R4.2
unnamed: J2.4, R3.2
unnamed: J2.5, R2.2
unnamed: J5.2, R11.2
unnamed: J5.3, R10.2
unnamed: J6.2, Q2.3 (D)
unnamed: J7.3, Q3.3 (D)
unnamed: J8.3, Q4.3 (D)
unnamed: J9.3, Q5.3 (D)
unnamed: Q1.1 (G), R6.1
unnamed: Q2.1 (G), R8.1
unnamed: Q3.1 (G), R12.1
unnamed: Q4.1 (G), R13.1
unnamed: Q5.1 (G), R14.1

Notes on the sheet:
Ext. load
PWM
ADC
USB
Alarm Buzzer
MCU power source
Bootloader init
Alarm

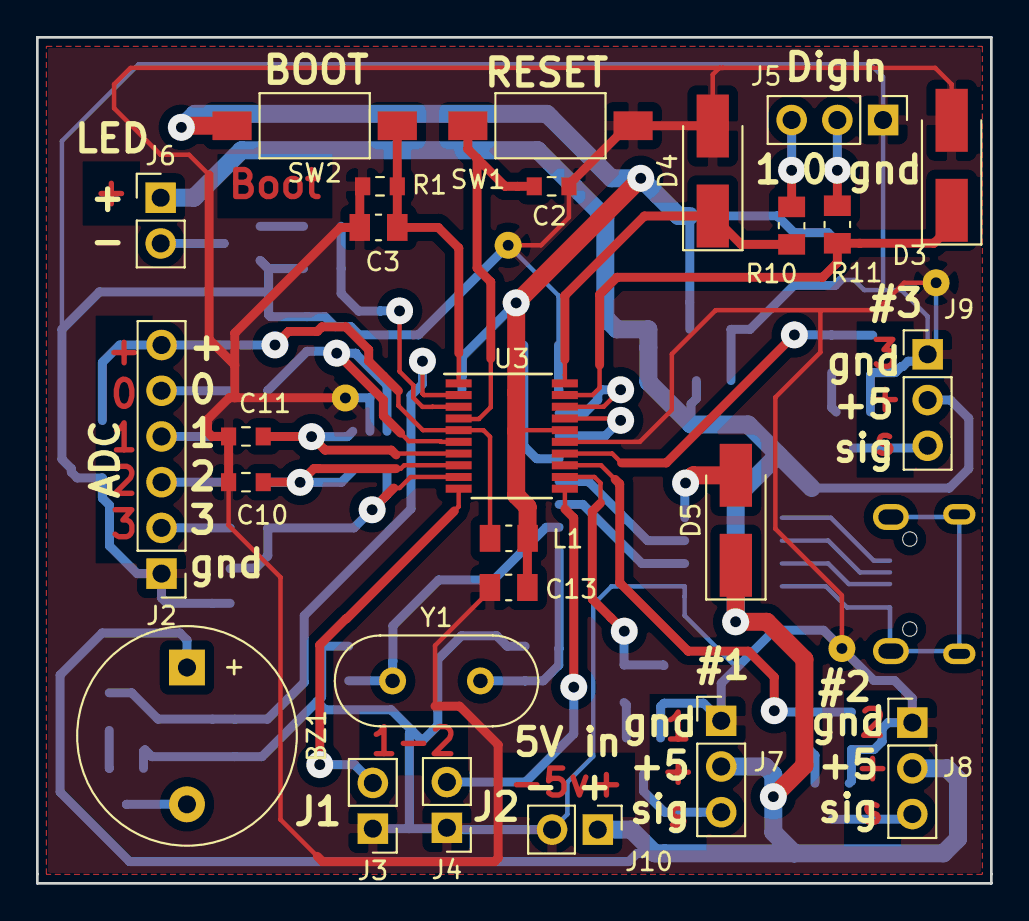
[picture p56: board Servo_control.kicad_pcb from above]

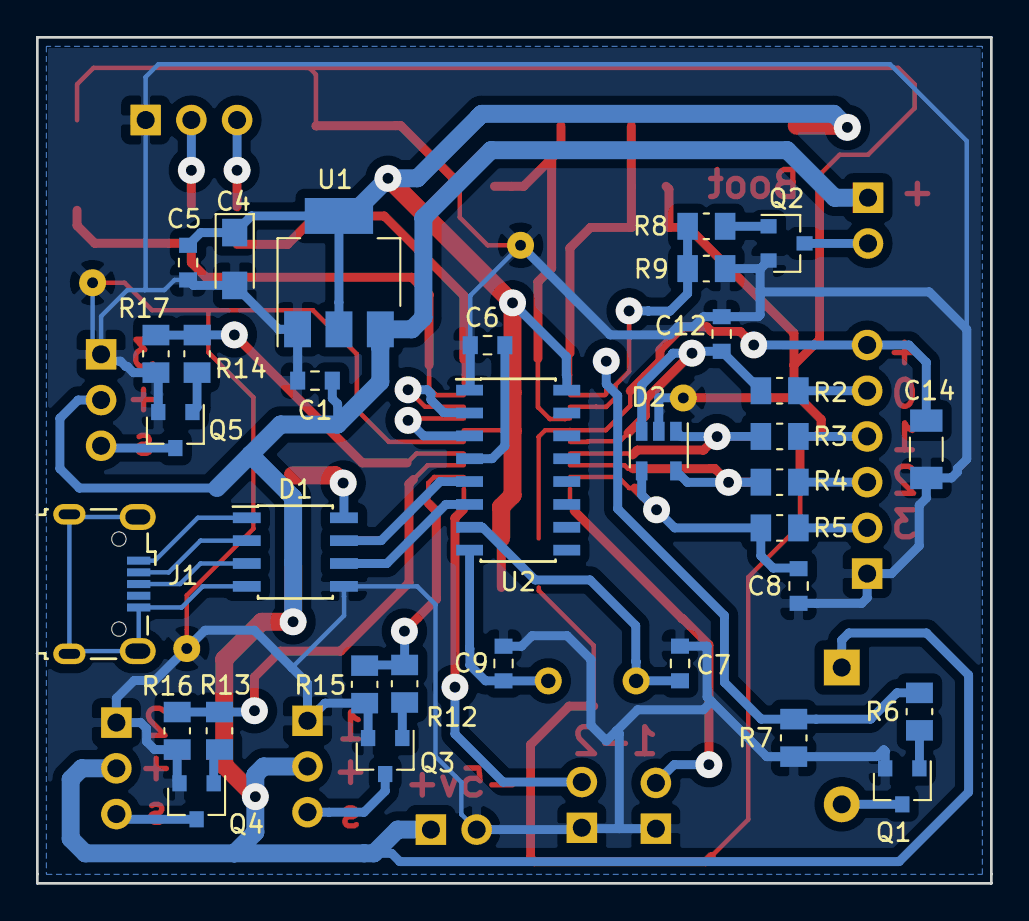
[picture p57: board Servo_control.kicad_pcb from below]

Board: 2 copper layers, 53.0 x 47.0 mm, 59 parts (33 on the bottom side), 47 nets.
