eddyem/stm32samples/F1:F103/CAR_CANbus/WindShield/kicad/windshield.kicad_pcb

## KiCad design F1:F103/CAR_CANbus/WindShield/kicad/windshield.kicad_pcb (2024-05-06)

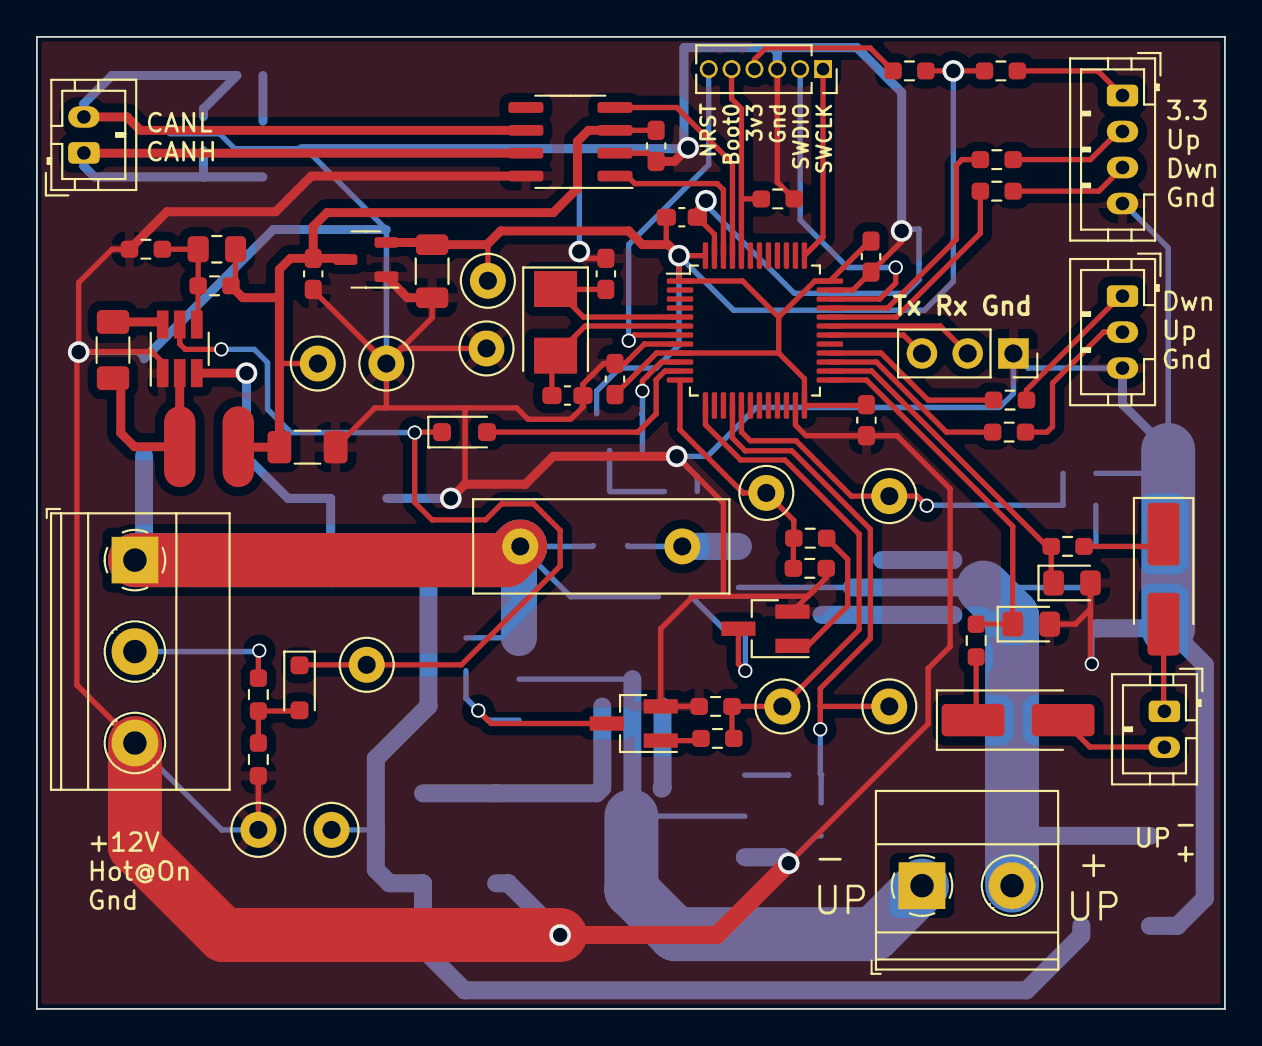
[picture p58: board windshield.kicad_pcb from above]

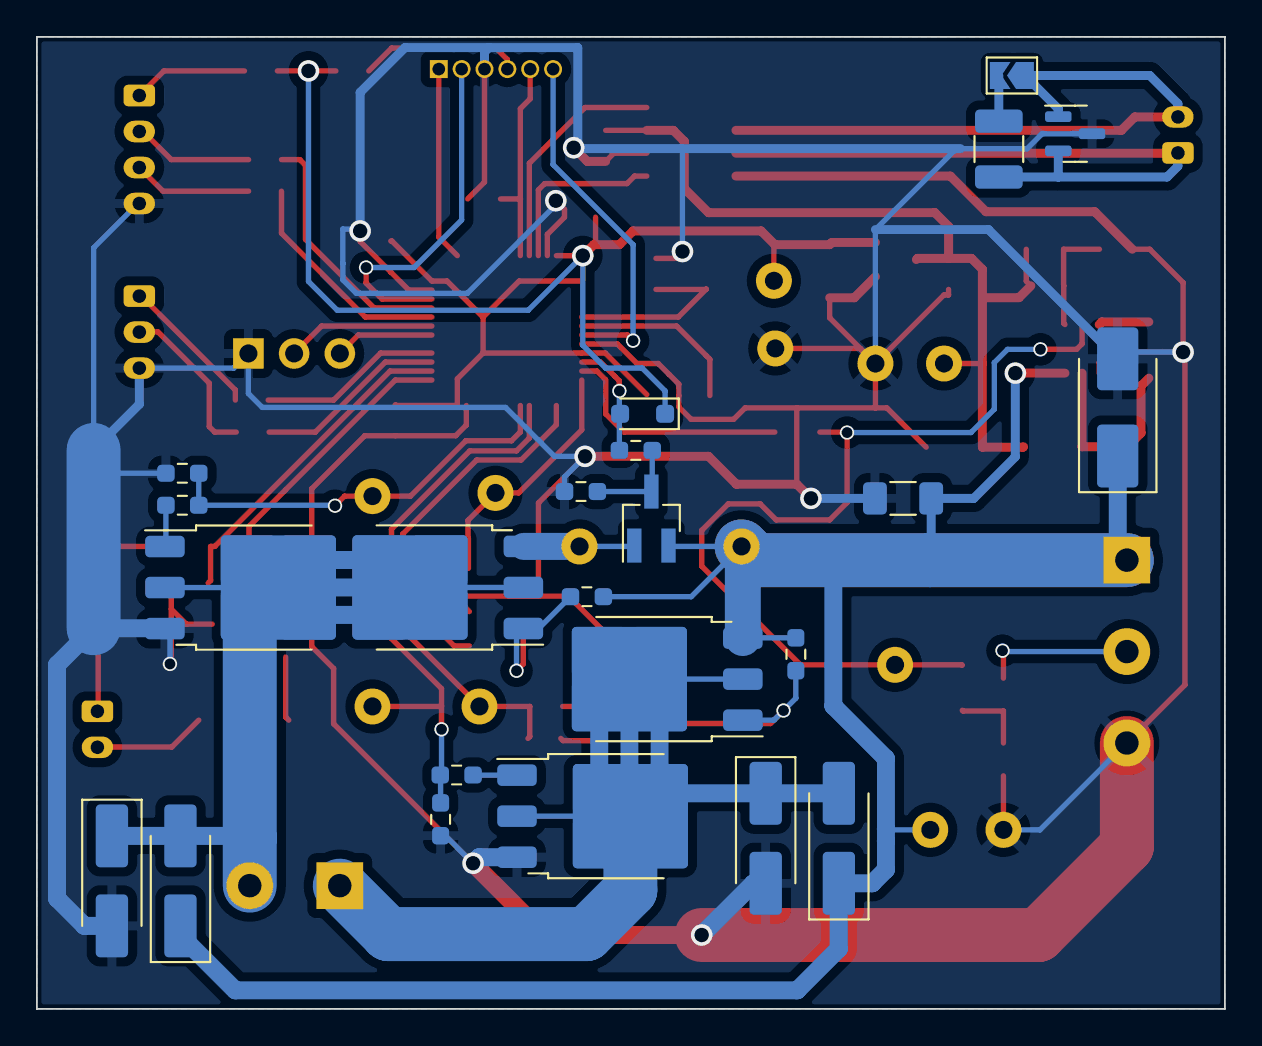
[picture p59: board windshield.kicad_pcb from below]

Board: 2 copper layers, 66.0 x 54.0 mm, 86 parts (23 on the bottom side), 55 nets.

Parts:
C1, C7, C9, C11, C12, C13: 0.1; C_0603_1608Metric_Pad1.08x0.95mm_HandSolder
C2: 10u; C_1206_3216Metric_Pad1.33x1.80mm_HandSolder
C3: 1u; C_1206_3216Metric_Pad1.33x1.80mm_HandSolder
C4: 47u; C_1206_3216Metric
C5: 47u; C_1206_3216Metric_Pad1.33x1.80mm_HandSolder
C6: 22; C_0805_2012Metric_Pad1.18x1.45mm_HandSolder
C8, C10: 6; C_0603_1608Metric_Pad1.08x0.95mm_HandSolder
D1, D2, D8: 1N5819; D_SOD-323_HandSoldering
D3: SMBJ18A; D_SMB_Handsoldering
D4, D5, D9, D10, D11, D12: 1N4007; D_SMA_Handsoldering
D6, D7: MM3Z3V3; D_0805_2012Metric_Pad1.15x1.40mm_HandSolder
D13: PESD1CAN; SOT-23
J1: Power; TerminalBlock_Phoenix_MKDS-1,5-3-5.08_1x03_P5.08mm_Horizont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
J2: Hall; JST_PH_B4B-PH-K_1x04_P2.00mm_Vertical
J3: Buttons; JST_PH_B3B-PH-K_1x03_P2.00mm_Vertical
J4: UART; PinSocket_1x03_P2.54mm_Vertical
J5: Prog; PinSocket_1x06_P1.27mm_Vertical
J6: EXT_MOT; JST_PH_B2B-PH-K_1x02_P2.00mm_Vertical
J7: Motor; TerminalBlock_Phoenix_MKDS-1,5-2_1x02_P5.00mm_Horizontal
J8: CAN; JST_PH_B2B-PH-K_1x02_P2.00mm_Vertical
JP1: Term; SolderJumper-2_P1.3mm_Open_TrianglePad1.0x1.5mm
L1: 10u; cd43
Q1, Q6: 2N7002; SOT-23_Handsoldering
Q2, Q4: AOD4185; TO-252-3_TabPin2
Q3, Q5: IRLR7807; TO-252-3_TabPin2
R1: 300k; R_0603_1608Metric_Pad0.98x0.95mm_HandSolder
R2, R7: 100k; R_0603_1608Metric_Pad0.98x0.95mm_HandSolder
R3: 47; R_0603_1608Metric_Pad0.98x0.95mm_HandSolder
R4, R5, R8, R9, R15, R16, R25: 100; R_0603_1608Metric_Pad0.98x0.95mm_HandSolder
R6: 19k; R_0603_1608Metric_Pad0.98x0.95mm_HandSolder
R10: 6.8; R_0603_1608Metric_Pad0.98x0.95mm_HandSolder
R11, R17, R19, R22, R23, R26, R27: 10k; R_0603_1608Metric_Pad0.98x0.95mm_HandSolder
R12, R13: 1k; R_0603_1608Metric_Pad0.98x0.95mm_HandSolder
R14: 330; R_0603_1608Metric_Pad0.98x0.95mm_HandSolder
R18, R24: 220; R_0603_1608Metric_Pad0.98x0.95mm_HandSolder
R20: 0.05; R_Box_L14.0mm_W5.0mm_P9.00mm
R21: 120; R_1210_3225Metric_Pad1.30x2.65mm_HandSolder
TP1, TP6, TP7: Gnd; TestPoint_Loop_D1.80mm_Drill1.0mm_Beaded
TP2: Ven; TestPoint_Loop_D1.80mm_Drill1.0mm_Beaded
TP3: 12V; TestPoint_Loop_D1.80mm_Drill1.0mm_Beaded
TP4: 5V; TestPoint_Loop_D1.80mm_Drill1.0mm_Beaded
TP5: 3V3; TestPoint_Loop_D1.80mm_Drill1.0mm_Beaded
TP8: L+; TestPoint_Loop_D1.80mm_Drill1.0mm_Beaded
TP9: L-; TestPoint_Loop_D1.80mm_Drill1.0mm_Beaded
TP10: R+; TestPoint_Loop_D1.80mm_Drill1.0mm_Beaded
TP11: R-; TestPoint_Loop_D1.80mm_Drill1.0mm_Beaded
U1: XC6206PxxxMR; SOT-23-3
U2: MT1470; SOT-23-6_Handsoldering
U3: STM32F103C6Tx; LQFP-48_7x7mm_P0.5mm
U4: ZXCT1009; SOT-23_Handsoldering
U5: TJA1050; SOIC-8_3.9x4.9mm_P1.27mm
Y1: NX5032GA-8MHz; Crystal_SMD_5032-2Pin_5.0x3.2mm

Connections:
+3V3: C4.1, C7.1, C9.1, C11.1, C12.1, D8.1 (K), R3.2, R10.1, TP5.1, U1.2 (VO), U3.1 (VBAT), U3.9 (VDDA), U3.24 (VDD), U3.36 (VDD), U3.48 (VDD)
+5V: C1.1, C5.1, C6.1, C13.2, L1.2, R7.1, TP4.1, U1.3 (VI), U5.3 (VDD)
+12V: C2.2, D3.1 (K), D10.1 (K), D11.1 (K), J1.1, Q4.3 (S), R17.2, R20.1, R23.2, TP3.1, U2.3 (VIN), U4.2 (+)
/BOOT0: J5.5, R11.2, U3.44 (BOOT0)
/CANH: D13.2 (K), J8.1, R21.1, U5.7 (CANH)
/CANL: D13.1 (K), J8.2, JP1.1 (A), U5.6 (CANL)
/CAN_Rx: U3.45 (PB8), U5.4 (RXD)
/CAN_Tx: U3.46 (PB9), U5.1 (TXD)
/DOWN_BTN: R8.2, U3.28 (PB15)
/DOWN_DIR: D7.1 (K), R13.1, U3.26 (PB13)
/DOWN_SW: R5.2, U3.32 (PA11)
/HOT@On: J1.2, R1.2
/L_DOWN: R18.1, R19.2, TP9.1, U3.17 (PA7)
/L_UP: R16.1, R26.2, TP8.1, U3.12 (PA2)
/NRST: J5.6, U3.7 (NRST)
/OSC_IN: C8.1, U3.5 (PD0), Y1.1
/OSC_OUT: C10.1, U3.6 (PD1), Y1.2
/Power_EN: D2.2 (A), U3.11 (PA1)
/R_DOWN: R22.1, R24.1, TP11.1, U3.16 (PA6)
/R_UP: R25.1, R27.1, TP10.1, U3.13 (PA3)
/Rx: J4.2, U3.31 (PA10)
/SWCLK: J5.1, U3.37 (PA14)
/SWDIO: J5.2, U3.34 (PA13)
/Tx: J4.3, U3.30 (PA9)
/UP_BTN: R9.2, U3.27 (PB14)
/UP_DIR: D6.1 (K), R12.1, U3.25 (PB12)
/UP_SW: R4.2, U3.33 (PA12)
/VEN: D1.1 (K), D2.1 (K), TP2.1, U2.5 (EN)
/Vsen: D8.2 (A), R14.2, U3.10 (PA0)
GND: C1.2, C2.1, C4.2, C5.2, C7.2, C8.2, C9.2, C10.2, C11.2, C12.2, C13.1, D3.2 (A), D6.2 (A), D7.2 (A), D9.2 (A), D12.2 (A), D13.3 (O), J1.3, J2.4, J3.3, J4.1, J5.3, Q1.2 (S), Q3.3 (S), Q5.3 (S), Q6.2 (S), R2.1, R6.2, R11.1, R15.2, R19.1, R22.2, R26.1, R27.2, TP1.1, TP6.1, TP7.1, U1.1 (GND), U2.1 (GND), U3.8 (VSSA), U3.23 (VSS), U3.35 (VSS), U3.47 (VSS), U5.2 (VSS), U5.8 (Rs)
unnamed: D1.2 (A), R1.1, R2.2
unnamed: D4.2 (A), J6.2
unnamed: D4.1 (K), R12.2
unnamed: D5.2 (A), J6.1
unnamed: D5.1 (K), R13.2
unnamed: D9.1 (K), D10.2 (A), J7.2, Q2.2 (D), Q3.2 (D)
unnamed: D11.2 (A), D12.1 (K), J7.1, Q4.2 (D), Q5.2 (D)
unnamed: J2.1, R3.1
unnamed: J2.2, R4.1
unnamed: J2.3, R5.1
unnamed: J3.1, R8.1
unnamed: J3.2, R9.1
unnamed: J5.4, R10.2
unnamed: JP1.2 (B), R21.2
unnamed: Q1.3 (D), Q2.1 (G), R17.1
unnamed: Q1.1 (G), R16.2
unnamed: Q2.3 (S), R20.2, U4.1 (-)
unnamed: Q3.1 (G), R18.2
unnamed: Q4.1 (G), Q6.3 (D), R23.1
unnamed: Q5.1 (G), R24.2
unnamed: Q6.1 (G), R25.2
unnamed: C3.2, U2.6 (BS)
unnamed: C6.2, R6.1, R7.2, U2.4 (FB)
unnamed: C3.1, L1.1, U2.2 (SW)
unnamed: R14.1, R15.1, U4.3 (sense)
