eddyem/stm32samples/F0:F030,F042,F072/CANbus_stepper/kicad/stm32.kicad_pcb

## KiCad design F0:F030,F042,F072/CANbus_stepper/kicad/stm32.kicad_pcb (2024-05-06)

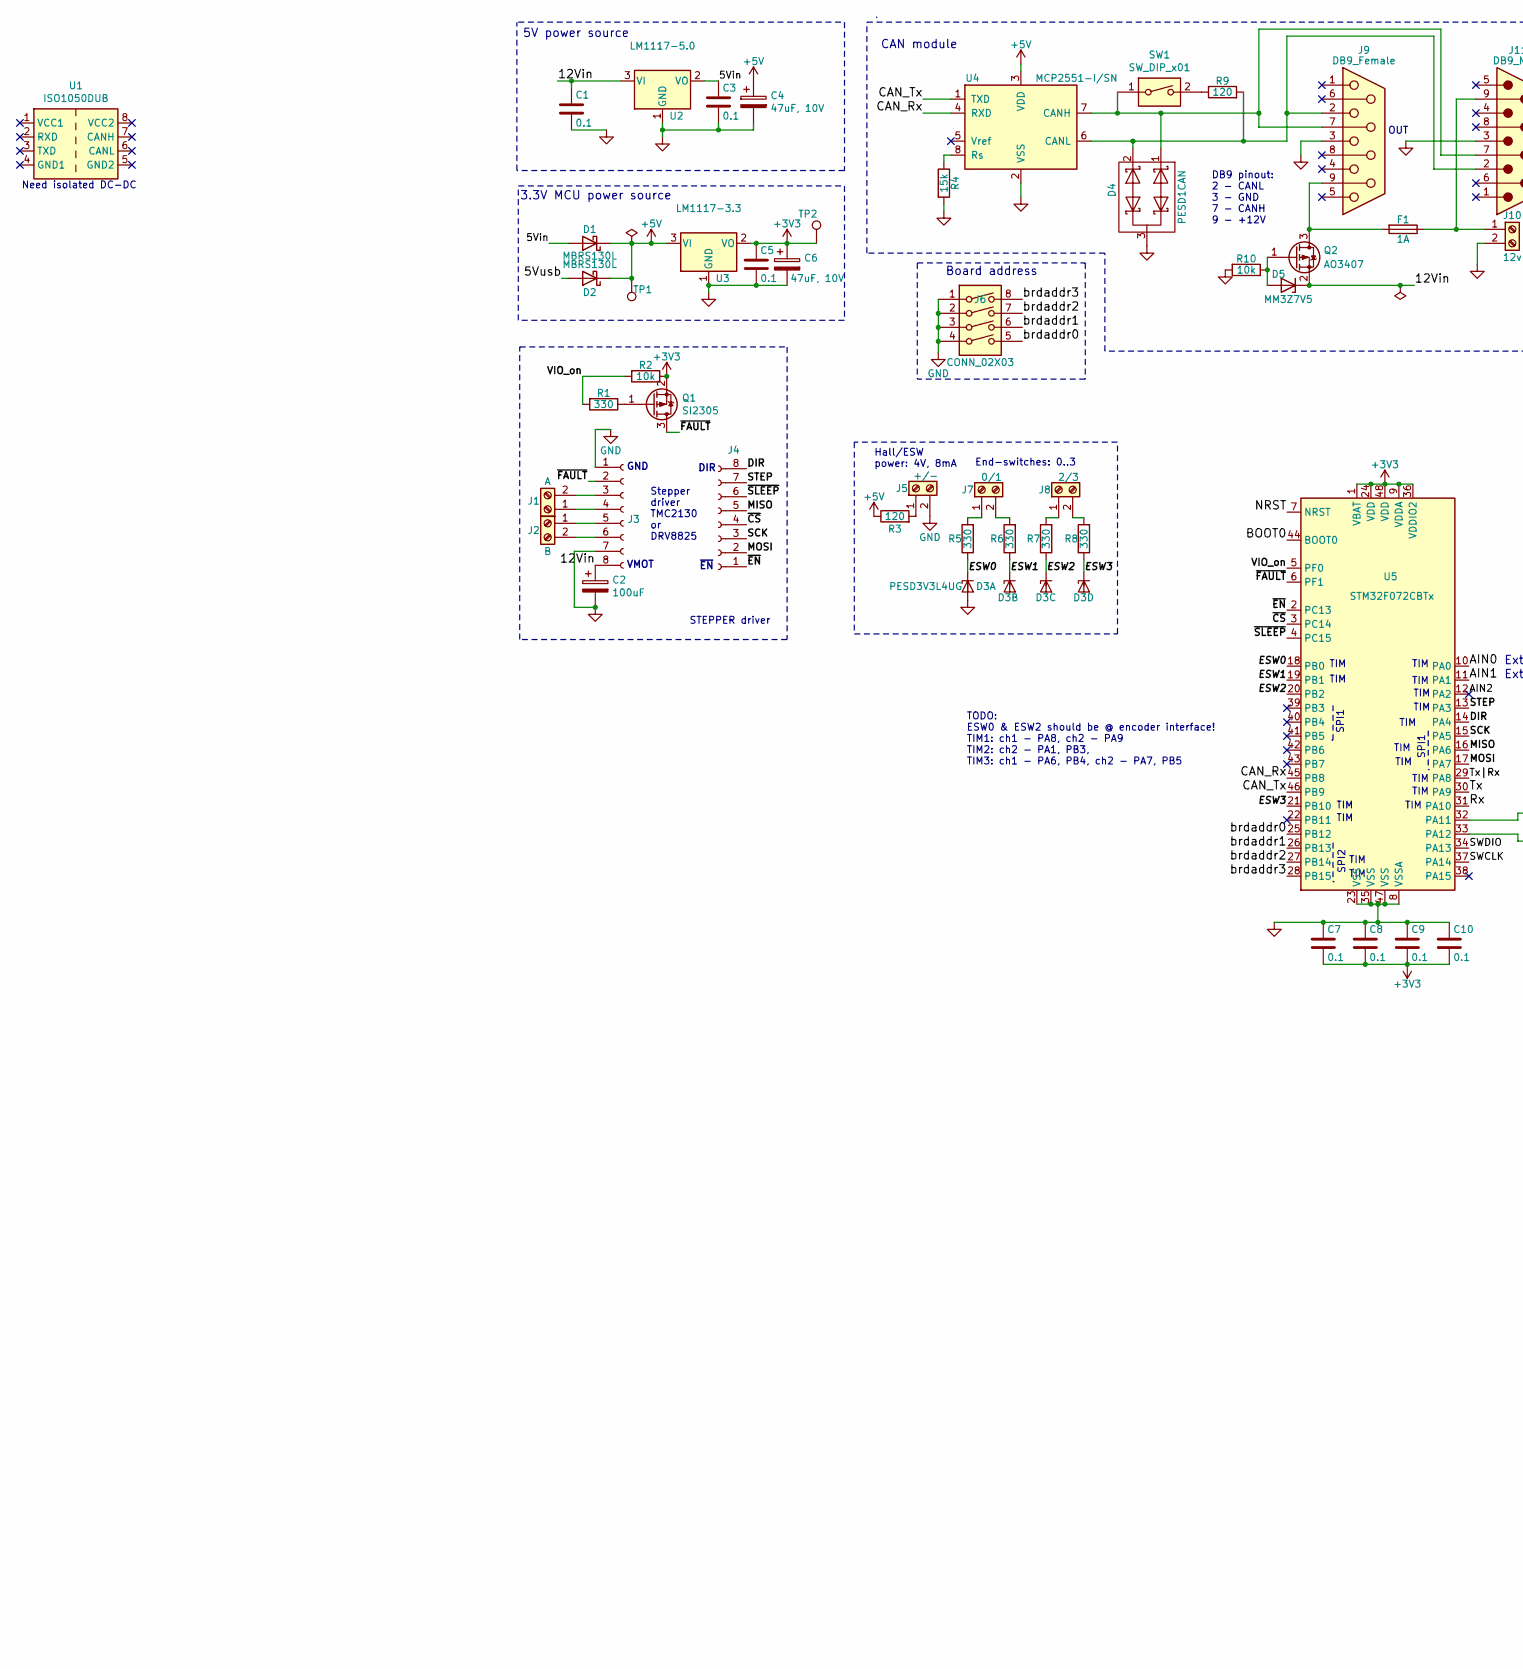
[picture p60: schematic stm32.kicad_sch, part in row 1, column 1]

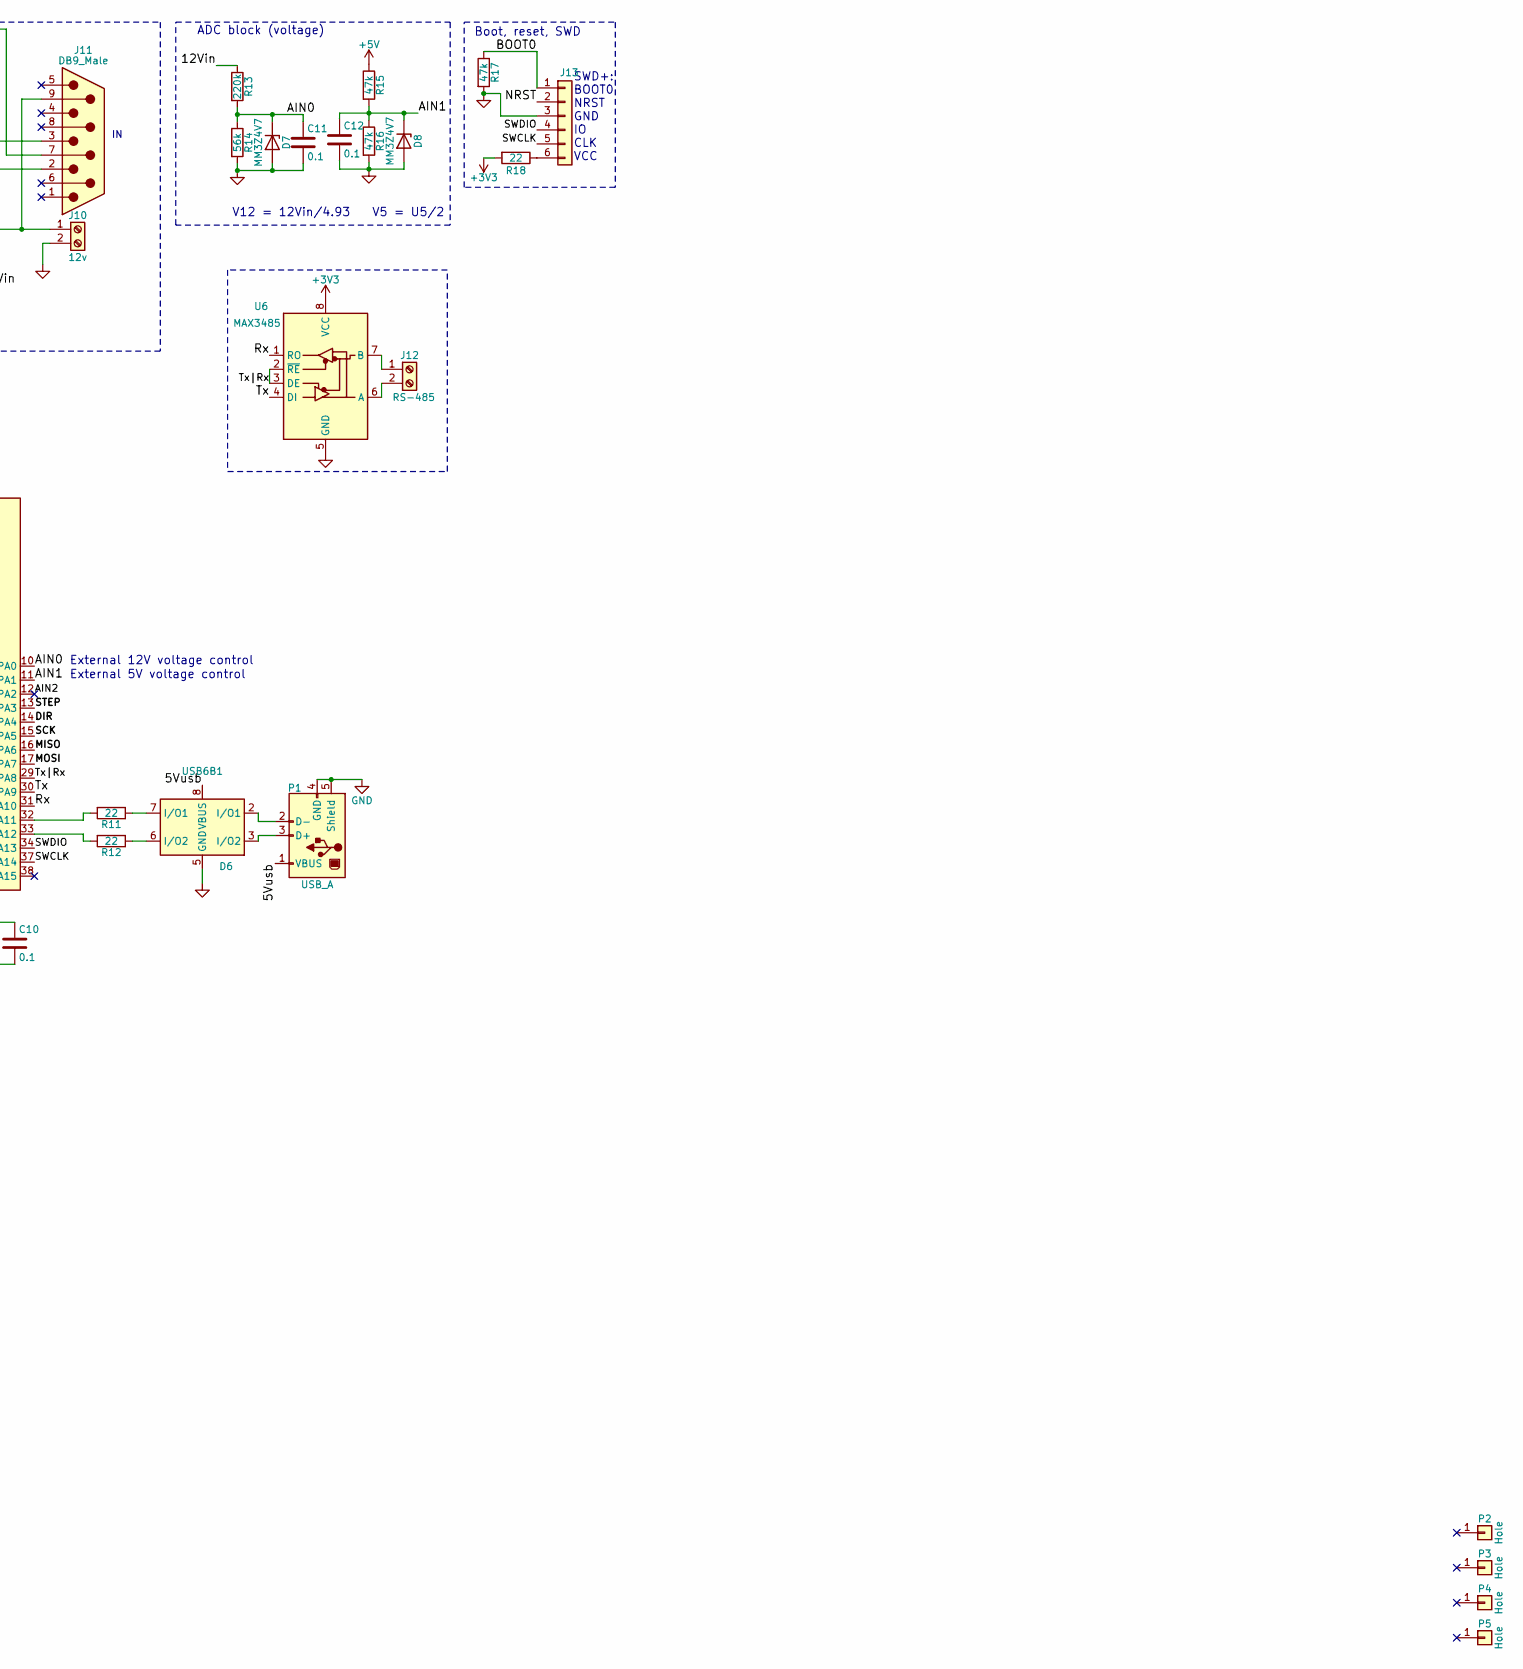
[picture p61: schematic stm32.kicad_sch, part in row 1, column 2]

Parts:
C1, C3, C5, C7, C8, C9, C10, C11, C12: 0.1; C_0603_1608Metric_Pad1.05x0.95mm_HandSolder
C2: 100uF; CP_Radial_D8.0mm_P3.50mm
C4, C6: 47uF, 10V; CP_EIA-6032-28_Kemet-C_Pad2.25x2.35mm_HandSolder
D1, D2: MBRS130L; D_SMB_Handsoldering
D3: PESD3V3L4UG; SOT-363_SC-70-6_Handsoldering
D4: PESD1CAN; SOT-23_Handsoldering
D5: MM3Z7V5; D_0805_2012Metric_Pad1.15x1.40mm_HandSolder
D6: USB6B1; SOIC-8_3.9x4.9mm_P1.27mm
D7, D8: MM3Z4V7; D_0805_2012Metric_Pad1.15x1.40mm_HandSolder
F1: 1A; FuseHolder
J1: A; TerminalBlock_Phoenix_MKDS-1,5-2_1x02_P5.00mm_Horizontal
J2: B; TerminalBlock_Phoenix_MKDS-1,5-2_1x02_P5.00mm_Horizontal
J3, J4: Conn_01x08_Female; PinSocket_1x08_P2.54mm_Vertical
J5: +/-; TerminalBlock_Phoenix_MKDS-1,5-2_1x02_P5.00mm_Horizontal
J6: CONN_02X03; SW_DIP_SPSTx04_Slide_9.78x12.34mm_W7.62mm_P2.54mm
J7: 0/1; TerminalBlock_Phoenix_MKDS-1,5-2_1x02_P5.00mm_Horizontal
J8: 2/3; TerminalBlock_Phoenix_MKDS-1,5-2_1x02_P5.00mm_Horizontal
J9: DB9_Female; DSUB-9_Female_Horizontal_P2.77x2.84mm_EdgePinOffset4.94mm_H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
J10: 12v; TerminalBlock_Phoenix_MKDS-1,5-2_1x02_P5.00mm_Horizontal
J11: DB9_Male; DSUB-9_Male_Horizontal_P2.77x2.84mm_EdgePinOffset4.94mm_Hou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
J12: RS-485; TerminalBlock_Phoenix_MKDS-1,5-2_1x02_P5.00mm_Horizontal
J13: Conn_01x06; PinSocket_1x06_P2.54mm_Vertical
P1: USB_A; USB_B_OST_USB-B1HSxx_Horizontal
P2, P3, P4, P5: Hole; MountingHole_3.2mm_M3
Q1: SI2305; SOT-23_Handsoldering
Q2: AO3407; SOT-23_Handsoldering
R1, R5, R6, R7, R8: 330; R_0603_1608Metric_Pad1.05x0.95mm_HandSolder
R2, R10: 10k; R_0603_1608Metric_Pad1.05x0.95mm_HandSolder
R3, R9: 120; R_0603_1608Metric_Pad1.05x0.95mm_HandSolder
R4: 15k; R_0603_1608Metric_Pad1.05x0.95mm_HandSolder
R11, R12, R18: 22; R_0603_1608Metric_Pad1.05x0.95mm_HandSolder
R13: 220k; R_0603_1608Metric_Pad1.05x0.95mm_HandSolder
R14: 56k; R_0603_1608Metric_Pad1.05x0.95mm_HandSolder
R15, R16, R17: 47k; R_0603_1608Metric_Pad1.05x0.95mm_HandSolder
SW1: SW_DIP_x01; SW_DIP_SPSTx01_Slide_6.7x4.1mm_W7.62mm_P2.54mm_LowProfile
TP1, TP2: TestPoint; PinHeader_1x01_P2.54mm_Vertical
U1: ISO1050DUB; SOP-8_6.62x9.15mm_P2.54mm
U2: LM1117-5.0; SOT-223-3_TabPin2
U3: LM1117-3.3; SOT-223-3_TabPin2
U4: MCP2551-I/SN; SOIC-8_3.9x4.9mm_P1.27mm
U5: STM32F072CBTx; LQFP-48_7x7mm_P0.5mm
U6: MAX3485; SO-8_3.9x4.9mm_P1.27mm

Connections:
+3V3: C5.1, C6.1, C7.2, C8.2, C9.2, C10.2, Q1.2 (S), R2.1, R18.2, TP2.1, U3.2 (VO), U5.1 (VBAT), U5.9 (VDDA), U5.24 (VDD), U5.36 (VDDIO2), U5.48 (VDD), U6.8 (VCC)
+5V: C4.1, D1.1 (K), D2.1 (K), R3.1, R15.1, TP1.1, U3.3 (VI), U4.3 (VDD)
/5Vin: C3.1, D1.2 (A), U2.2 (VO)
/5Vusb: D2.2 (A), D6.1 (VBUS), D6.8 (VBUS), P1.1 (VBUS)
/12Vin: C1.1, C2.1, D5.1 (K), J3.8, Q2.2 (S), R13.1, U2.3 (VI)
/AIN0: C11.1, D7.1 (K), R13.2, R14.1, U5.10 (PA0)
/AIN1: C12.1, D8.1 (K), R15.2, R16.1, U5.11 (PA1)
/BOOT0: J13.1, R17.1, U5.44 (BOOT0)
/CAN_Rx: U4.4 (RXD), U5.45 (PB8)
/CAN_Tx: U4.1 (TXD), U5.46 (PB9)
/DIR: J4.8, U5.14 (PA4)
/ESW0: D3.1 (K1), R5.1, U5.18 (PB0)
/ESW1: D3.3 (K2), R6.1, U5.19 (PB1)
/ESW2: D3.4 (K3), R7.1, U5.20 (PB2)
/ESW3: D3.6 (K4), R8.1, U5.21 (PB10)
/MISO: J4.5, U5.16 (PA6)
/MOSI: J4.2, U5.17 (PA7)
/NRST: J13.2, U5.7 (NRST)
/Rx: U5.31 (PA10), U6.1 (RO)
/SCK: J4.3, U5.15 (PA5)
/STEP: J4.7, U5.13 (PA3)
/SWCLK: J13.5, U5.37 (PA14)
/SWDIO: J13.4, U5.34 (PA13)
/Tx: U5.30 (PA9), U6.4 (DI)
/Tx|Rx: U5.29 (PA8), U6.2 (~RE), U6.3 (DE)
/VIO_on: R1.2, R2.2, U5.5 (PF0)
/brdaddr0: J6.5, U5.25 (PB12)
/brdaddr1: J6.6, U5.26 (PB13)
/brdaddr2: J6.7, U5.27 (PB14)
/brdaddr3: J6.8, U5.28 (PB15)
/~CS: J4.4, U5.3 (PC14)
/~EN: J4.1, U5.2 (PC13)
/~FAULT: J3.2, Q1.3 (D), U5.6 (PF1)
/~SLEEP: J4.6, U5.4 (PC15)
GND: C1.2, C2.2, C3.2, C4.2, C5.2, C6.2, C7.1, C8.1, C9.1, C10.1, C11.2, C12.2, D3.2 (A), D4.3 (O), D6.4 (GND), D6.5 (GND), D7.2 (A), D8.2 (A), J3.1, J3.7, J5.2, J6.1, J6.2, J6.3, J6.4, J9.3, J10.2, J11.3, J13.3, P1.4 (GND), P1.5 (Shield), R4.2, R10.2, R14.2, R16.2, R17.2, U2.1 (GND), U3.1 (GND), U4.2 (VSS), U5.8 (VSSA), U5.23 (VSS), U5.35 (VSS), U5.47 (VSS), U6.5 (GND)
unnamed: D4.1 (K), J9.7, J11.7, SW1.1, U4.7 (CANH)
unnamed: D4.2 (K), J9.2, J11.2, R9.2, U4.6 (CANL)
unnamed: D5.2 (A), Q2.1 (G), R10.1
unnamed: D6.2 (I/O1), P1.2 (D-)
unnamed: D6.3 (I/O2), P1.3 (D+)
unnamed: D6.6 (I/O2), R12.1
unnamed: D6.7 (I/O1), R11.1
unnamed: F1.1, J10.1, J11.9
unnamed: F1.2, J9.9, Q2.3 (D)
unnamed: J1.1, J3.4
unnamed: J1.2, J3.3
unnamed: J2.1, J3.5
unnamed: J2.2, J3.6
unnamed: J5.1, R3.2
unnamed: J7.1, R5.2
unnamed: J7.2, R6.2
unnamed: J8.1, R7.2
unnamed: J8.2, R8.2
unnamed: J12.1, U6.7 (B)
unnamed: J12.2, U6.6 (A)
unnamed: J13.6, R18.1
unnamed: Q1.1 (G), R1.1
unnamed: R4.1, U4.8 (Rs)
unnamed: R9.1, SW1.2
unnamed: R11.2, U5.32 (PA11)
unnamed: R12.2, U5.33 (PA12)

Notes on the sheet:
TIM
Hall/ESW power: 4V, 8mA
CAN module
End-switches: 0..3
5V power source
Need isolated DC-DC
OUT
GND
External 5V voltage control
Boot, reset, SWD
SPI2
Board address
Stepper driver TMC2130 or DRV8825
ADC block (voltage)
DIR
SPI1
~{EN}
STEPPER driver
V12 = 12Vin/4.93
DB9 pinout: 2 - CANL 3 - GND 7 - CANH 9 - +12V
TODO: ESW0 & ESW2 should be @ encoder interface! TIM1: ch1 - PA8, ch2 - PA9 TIM2: ch2 - PA1, PB3, TIM3: ch1 - PA6, PB4, ch2 - PA7, PB5
External 12V voltage control
V5 = U5/2
3.3V MCU power source
SWD+: BOOT0 NRST GND IO CLK VCC
VMOT

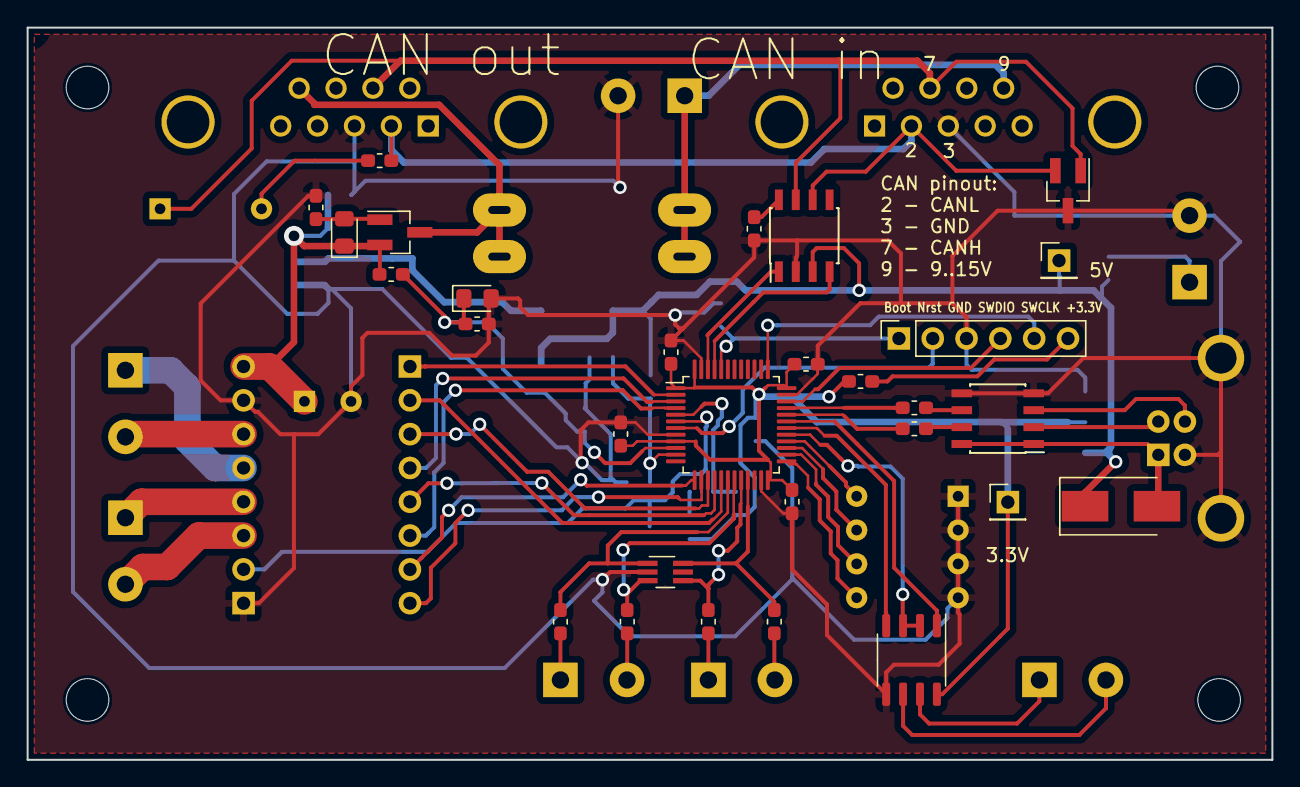
[picture p62: board F0:F030,F042,F072/CANbus_stepper/kicad/stm32.kicad_pcb from above]

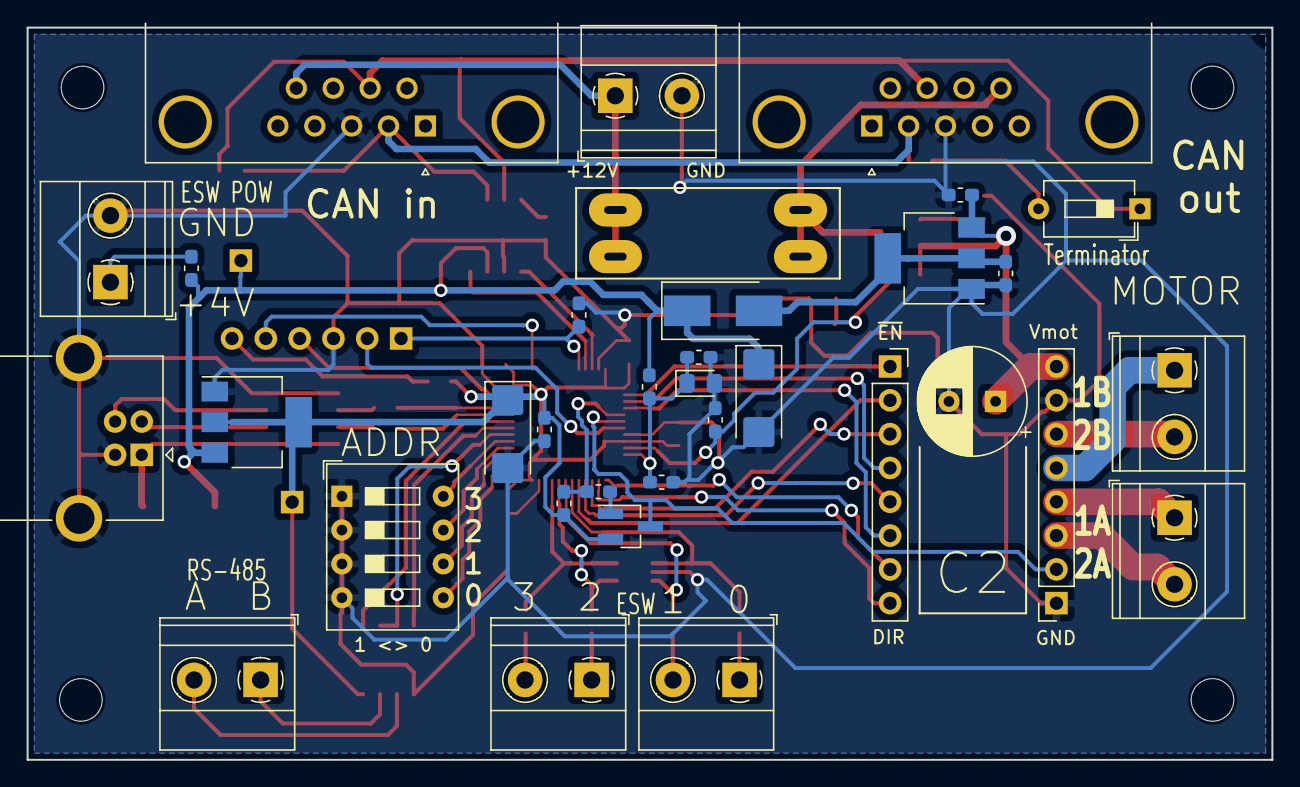
[picture p63: board F0:F030,F042,F072/CANbus_stepper/kicad/stm32.kicad_pcb from below]

Board: 2 copper layers, 93.5 x 55.0 mm, 67 parts (34 on the bottom side), 61 nets.
