eddyem/stm32samples/F0:F030,F042,F072/3steppersLB/kicad/stm32.kicad_pcb

## KiCad design F0:F030,F042,F072/3steppersLB/kicad/stm32.kicad_pcb (2024-05-06)

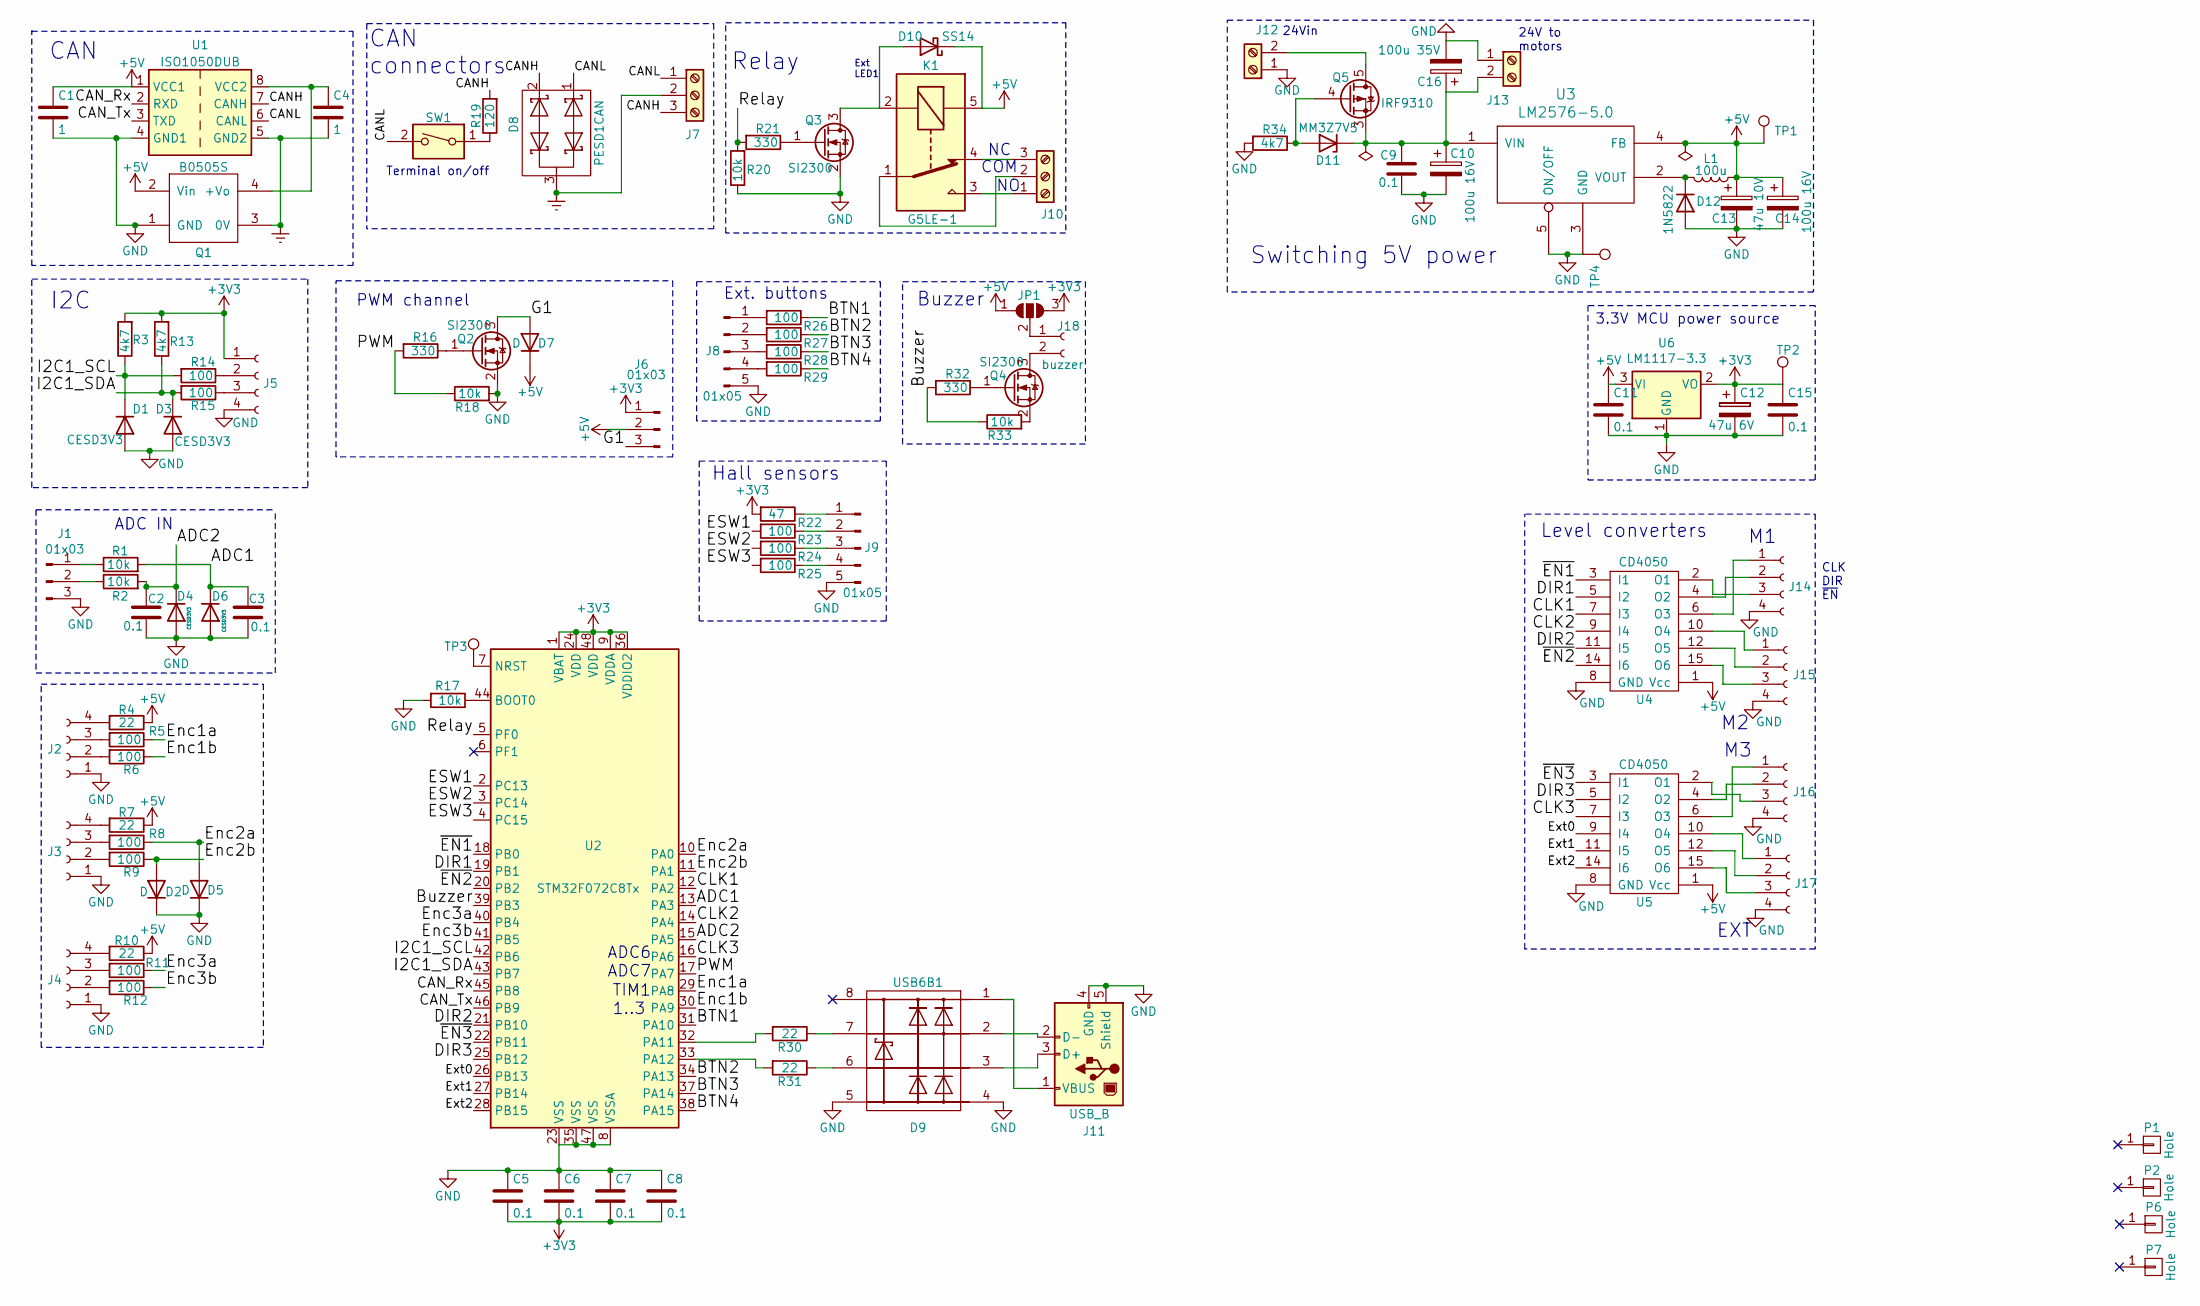
[picture p64: schematic stm32.kicad_sch, STM32F0x2 based USB<>CAN converter (isolated)]

Parts:
C1, C4: 1; C_0805_2012Metric_Pad1.15x1.40mm_HandSolder
C2, C3, C5, C6, C7, C8, C9, C11, C15: 0.1; C_0603_1608Metric_Pad1.05x0.95mm_HandSolder
C10, C14: 100u 16V; CP_Radial_D8.0mm_P3.50mm
C12: 47u 6V; CP_EIA-3216-18_Kemet-A_Pad1.58x1.35mm_HandSolder
C13: 47u 10V; CP_EIA-6032-28_Kemet-C_Pad2.25x2.35mm_HandSolder
C16: 100u 35V; CP_Radial_D8.0mm_P3.50mm
D1, D3, D4, D6: CESD3V3; D_0805_2012Metric_Pad1.15x1.40mm_HandSolder
D2, D5, D7: D; D_0805_2012Metric_Pad1.15x1.40mm_HandSolder
D8: PESD1CAN; SOT-23
D9: USB6B1; SOIC-8_3.9x4.9mm_P1.27mm
D10: SS14; D_SMA-SMB_Universal_Handsoldering
D11: MM3Z7V5; D_0805_2012Metric_Pad1.15x1.40mm_HandSolder
D12: 1N5822; D_DO-201_P3.81mm_Vertical_AnodeUp
J1, J6: 01x03; JST_PH_B3B-PH-K_1x03_P2.00mm_Vertical
J2, J3, J4, J5, J14, J15, J16, J17: Conn_01x04_Female; JST_PH_B4B-PH-K_1x04_P2.00mm_Vertical
J7, J10: Screw_Terminal_01x03; TerminalBlock_Phoenix_MKDS-1,5-3_1x03_P5.00mm_Horizontal
J8, J9: 01x05; JST_PH_B5B-PH-K_1x05_P2.00mm_Vertical
J11: USB_B; USB_B_OST_USB-B1HSxx_Horizontal
J12, J13: Screw_Terminal_01x02; TerminalBlock_Phoenix_MKDS-1,5-2_1x02_P5.00mm_Horizontal
J18: buzzer; JST_PH_B2B-PH-K_1x02_P2.00mm_Vertical
JP1: SolderJumper_3_Open; SolderJumper-3_P1.3mm_Open_Pad1.0x1.5mm
K1: G5LE-1; Relay_SPDT_Omron-G5LE-1
L1: 100u; L_Toroid_Horizontal_D6.5mm_P10.00mm_Diameter7-5mm_Amidon-T25
P1, P2, P6, P7: Hole; Hole_3mm
Q1: B0505S; B0x0xS
Q2, Q3, Q4: SI2300; SOT-23_Handsoldering
Q5: IRF9310; SO-8_3.9x4.9mm_P1.27mm
R1, R2, R17, R18, R20, R33: 10k; R_0603_1608Metric_Pad1.05x0.95mm_HandSolder
R3, R13, R34: 4k7; R_0603_1608Metric_Pad1.05x0.95mm_HandSolder
R4, R7, R10, R30, R31: 22; R_0603_1608Metric_Pad1.05x0.95mm_HandSolder
R5, R6, R8, R9, R11, R12, R14, R15, R23, R24, R25, R26, R27, R28, R29: 100; R_0603_1608Metric_Pad1.05x0.95mm_HandSolder
R16, R21, R32: 330; R_0603_1608Metric_Pad1.05x0.95mm_HandSolder
R19: 120; R_1210_3225Metric_Pad1.42x2.65mm_HandSolder
R22: 47; R_0603_1608Metric_Pad1.05x0.95mm_HandSolder
SW1: SW_DIP_x01; SW_DIP_SPSTx01_Slide_6.7x4.1mm_W7.62mm_P2.54mm_LowProfile
TP1: 5V; PinSocket_1x01_P2.54mm_Vertical
TP2: 3.3V; PinSocket_1x01_P2.54mm_Vertical
TP3: NRST; PinSocket_1x01_P2.54mm_Vertical
TP4: Gnd; PinSocket_1x01_P2.54mm_Vertical
U1: ISO1050DUB; SOP-8_6.62x9.15mm_P2.54mm
U2: STM32F072C8Tx; LQFP-48_7x7mm_P0.5mm
U3: LM2576-5.0; TO-220-5_P3.4x3.7mm_StaggerEven_Lead3.8mm_Vertical
U4, U5: CD4050; SOIC-16_3.9x9.9mm_P1.27mm
U6: LM1117-3.3; SOT-223-3_TabPin2

Connections:
+3V3: C5.2, C6.2, C7.2, C8.2, C12.1, C15.1, J5.1, J6.1, JP1.3 (B), R3.2, R13.2, R22.2, TP2.1, U2.1 (VBAT), U2.9 (VDDA), U2.24 (VDD), U2.36 (VDDIO2), U2.48 (VDD), U6.2 (VO)
+5V: C1.1, C11.1, C13.1, C14.1, D7.1 (K), D10.1 (K), J6.2, JP1.1 (A), K1.5, L1.1, Q1.2 (Vin), R4.1, R7.1, R10.1, TP1.1, U1.1 (VCC1), U3.4 (FB), U4.1 (Vcc), U5.1 (Vcc), U6.3 (VI)
/ADC1: C3.1, D6.1 (K), R1.2, U2.13 (PA3)
/ADC2: C2.1, D4.1 (K), R2.2, U2.15 (PA5)
/BTN1: R26.1, U2.31 (PA10)
/BTN2: R27.1, U2.34 (PA13)
/BTN3: R28.1, U2.37 (PA14)
/BTN4: R29.1, U2.38 (PA15)
/Buzzer: R32.2, R33.1, U2.39 (PB3)
/CANH: D8.2 (K), J7.3, R19.2, U1.7 (CANH)
/CANL: D8.1 (K), J7.1, SW1.2, U1.6 (CANL)
/CAN_Rx: U1.2 (RXD), U2.45 (PB8)
/CAN_Tx: U1.3 (TXD), U2.46 (PB9)
/CLK1: U2.12 (PA2), U4.7 (I3)
/CLK2: U2.14 (PA4), U4.9 (I4)
/CLK3: U2.16 (PA6), U5.7 (I3)
/DIR1: U2.19 (PB1), U4.5 (I2)
/DIR2: U2.21 (PB10), U4.11 (I5)
/DIR3: U2.25 (PB12), U5.5 (I2)
/ESW1: R23.2, U2.2 (PC13)
/ESW2: R24.2, U2.3 (PC14)
/ESW3: R25.2, U2.4 (PC15)
/Enc1a: R5.1, U2.29 (PA8)
/Enc1b: R6.1, U2.30 (PA9)
/Enc2a: D5.2 (A), R8.1, U2.10 (PA0)
/Enc2b: D2.2 (A), R9.1, U2.11 (PA1)
/Enc3a: R11.1, U2.40 (PB4)
/Enc3b: R12.1, U2.41 (PB5)
/Ext0: U2.26 (PB13), U5.9 (I4)
/Ext1: U2.27 (PB14), U5.11 (I5)
/Ext2: U2.28 (PB15), U5.14 (I6)
/G1: D7.2 (A), J6.3, Q2.3 (D)
/I2C1_SCL: D1.1 (K), R3.1, R14.2, U2.42 (PB6)
/I2C1_SDA: D3.1 (K), R13.1, R15.2, U2.43 (PB7)
/PWM: R16.2, R18.1, U2.17 (PA7)
/Relay: R20.2, R21.2, U2.5 (PF0)
/~EN1: U2.18 (PB0), U4.3 (I1)
/~EN2: U2.20 (PB2), U4.14 (I6)
/~EN3: U2.22 (PB11), U5.3 (I1)
Earth: C4.2, D8.3 (O), J7.2, Q1.3 (0V), U1.5 (GND2)
GND: C1.2, C2.2, C3.2, C5.1, C6.1, C7.1, C8.1, C9.2, C10.2, C11.2, C12.2, C13.2, C14.2, C15.2, C16.2, D1.2 (A), D2.1 (K), D3.2 (A), D4.2 (A), D5.1 (K), D6.2 (A), D9.4 (GND), D9.5 (GND), D12.2 (A), J1.3, J2.1, J3.1, J4.1, J5.4, J8.5, J9.5, J11.4 (GND), J11.5 (Shield), J12.1, J13.1, J14.4, J15.4, J16.4, J17.4, Q1.1 (GND), Q2.2 (S), Q3.2 (S), R17.2, R18.2, R20.1, R34.2, TP4.1, U1.4 (GND1), U2.8 (VSSA), U2.23 (VSS), U2.35 (VSS), U2.47 (VSS), U3.3 (GND), U3.5 (ON/OFF), U4.8 (GND), U5.8 (GND), U6.1 (GND)
unnamed: C4.1, Q1.4 (+Vo), U1.8 (VCC2)
unnamed: C9.1, C10.1, C16.1, D11.1 (K), J13.2, Q5.1 (S), Q5.2 (S), Q5.3 (S), U3.1 (VIN)
unnamed: D9.1 (VCC), J11.1 (VBUS)
unnamed: D9.2 (I/O1), J11.2 (D-)
unnamed: D9.3 (I/O2), J11.3 (D+)
unnamed: D9.6 (I/O2), R31.1
unnamed: D9.7 (I/O1), R30.1
unnamed: D10.2 (A), K1.2, Q3.3 (D)
unnamed: D11.2 (A), Q5.4 (G), R34.1
unnamed: D12.1 (K), L1.2, U3.2 (VOUT)
unnamed: J1.1, R1.1
unnamed: J1.2, R2.1
unnamed: J2.2, R6.2
unnamed: J2.3, R5.2
unnamed: J2.4, R4.2
unnamed: J3.2, R9.2
unnamed: J3.3, R8.2
unnamed: J3.4, R7.2
unnamed: J4.2, R12.2
unnamed: J4.3, R11.2
unnamed: J4.4, R10.2
unnamed: J5.2, R14.1
unnamed: J5.3, R15.1
unnamed: J8.1, R26.2
unnamed: J8.2, R27.2
unnamed: J8.3, R28.2
unnamed: J8.4, R29.2
unnamed: J9.1, R22.1
unnamed: J9.2, R23.1
unnamed: J9.3, R24.1
unnamed: J9.4, R25.1
unnamed: J10.1, K1.3
unnamed: J10.2, K1.1
unnamed: J10.3, K1.4
unnamed: J12.2, Q5.5 (D), Q5.6 (D), Q5.7 (D), Q5.8 (D)
unnamed: J14.1, U4.6 (O3)
unnamed: J14.2, U4.4 (O2)
unnamed: J14.3, U4.2 (O1)
unnamed: J15.1, U4.10 (O4)
unnamed: J15.2, U4.12 (O5)
unnamed: J15.3, U4.15 (O6)
unnamed: J16.1, U5.6 (O3)
unnamed: J16.2, U5.4 (O2)
unnamed: J16.3, U5.2 (O1)
unnamed: J17.1, U5.10 (O4)
unnamed: J17.2, U5.12 (O5)
unnamed: J17.3, U5.15 (O6)
unnamed: J18.1, JP1.2 (C)
unnamed: J18.2, Q4.3 (D)
unnamed: Q2.1 (G), R16.1
unnamed: Q3.1 (G), R21.1
unnamed: Q4.1 (G), R32.1
unnamed: Q4.2 (S), R33.2
unnamed: R17.1, U2.44 (BOOT0)
unnamed: R19.1, SW1.1
unnamed: R30.2, U2.32 (PA11)
unnamed: R31.2, U2.33 (PA12)
unnamed: TP3.1, U2.7 (NRST)

Notes on the sheet:
24V to motors
CLK DIR ~{EN}
Switching 5V power
PWM channel
Buzzer
TIM1 1..3
CAN
3.3V MCU power source
CAN connectors
Level converters
COM
Ext. buttons
24Vin
Ext LED1
I2C
ADC6 ADC7
ADC IN
Hall sensors
Terminal on/off
EXT
Relay
