eddyem/stm32samples/F0:F030,F042,F072/3steppersLB/kicad/stm32.kicad_pcb

## KiCad design F0:F030,F042,F072/3steppersLB/kicad/stm32.kicad_pcb (continued)

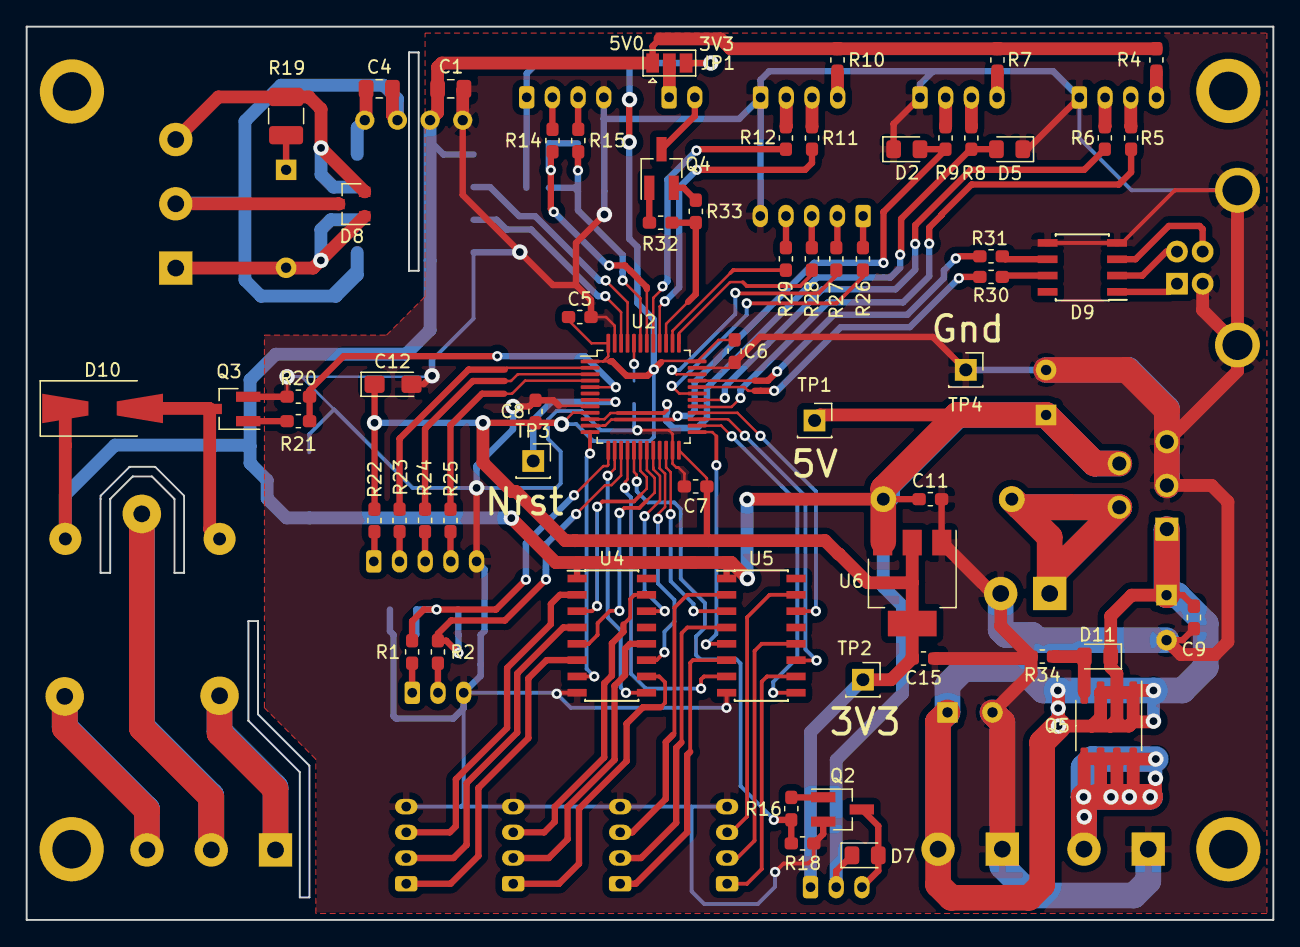
[picture p65: board F0:F030,F042,F072/3steppersLB/kicad/stm32.kicad_pcb from above]

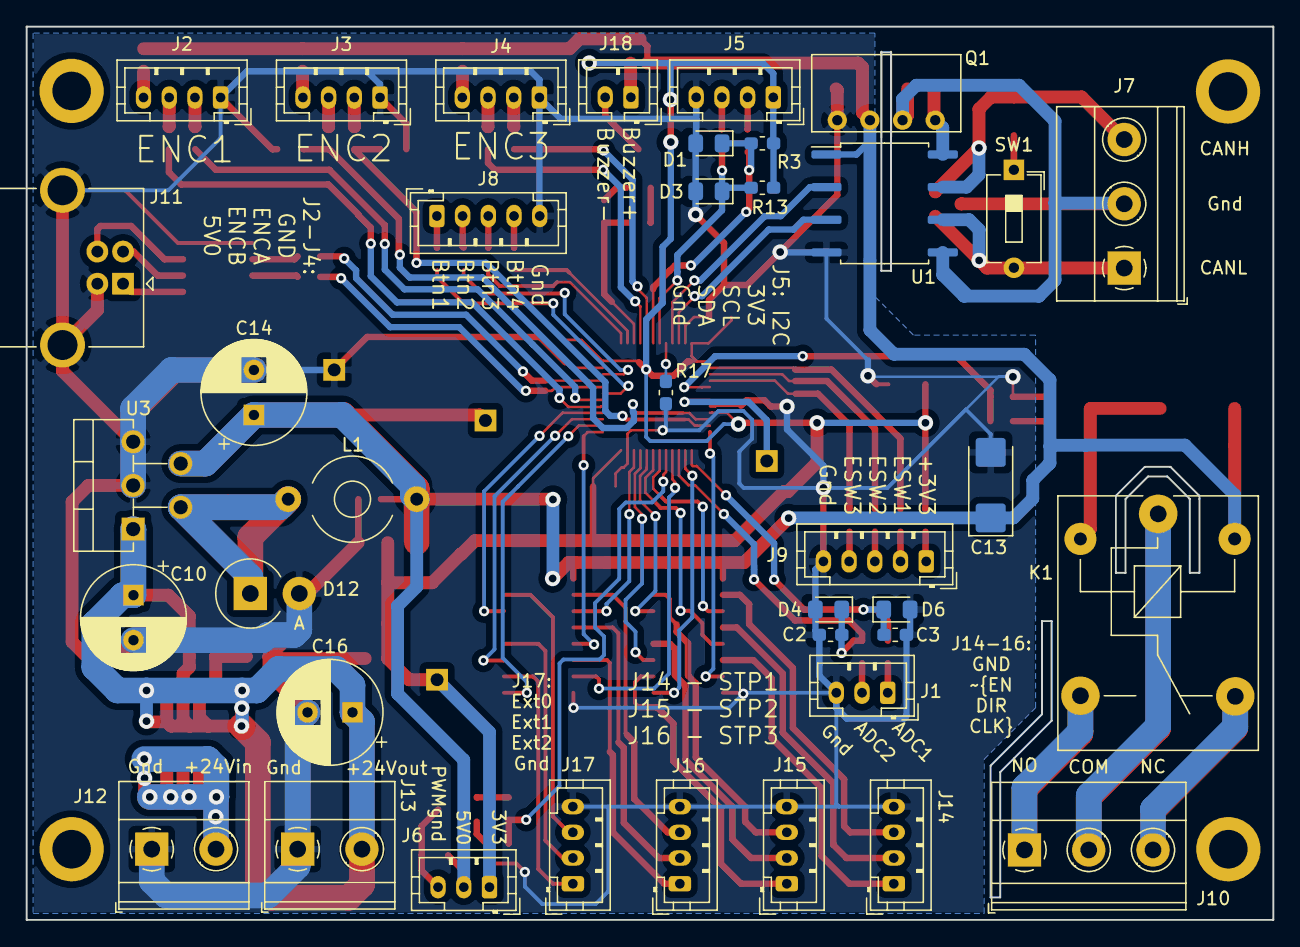
[picture p66: board F0:F030,F042,F072/3steppersLB/kicad/stm32.kicad_pcb from below]

Board: 2 copper layers, 97.0 x 69.5 mm, 103 parts (38 on the bottom side), 99 nets.
