eddyem/stm32samples/F1:F103/CAR_CANbus/Lamps/kicad/lamps.kicad_pcb

## KiCad design F1:F103/CAR_CANbus/Lamps/kicad/lamps.kicad_pcb (2024-05-06)

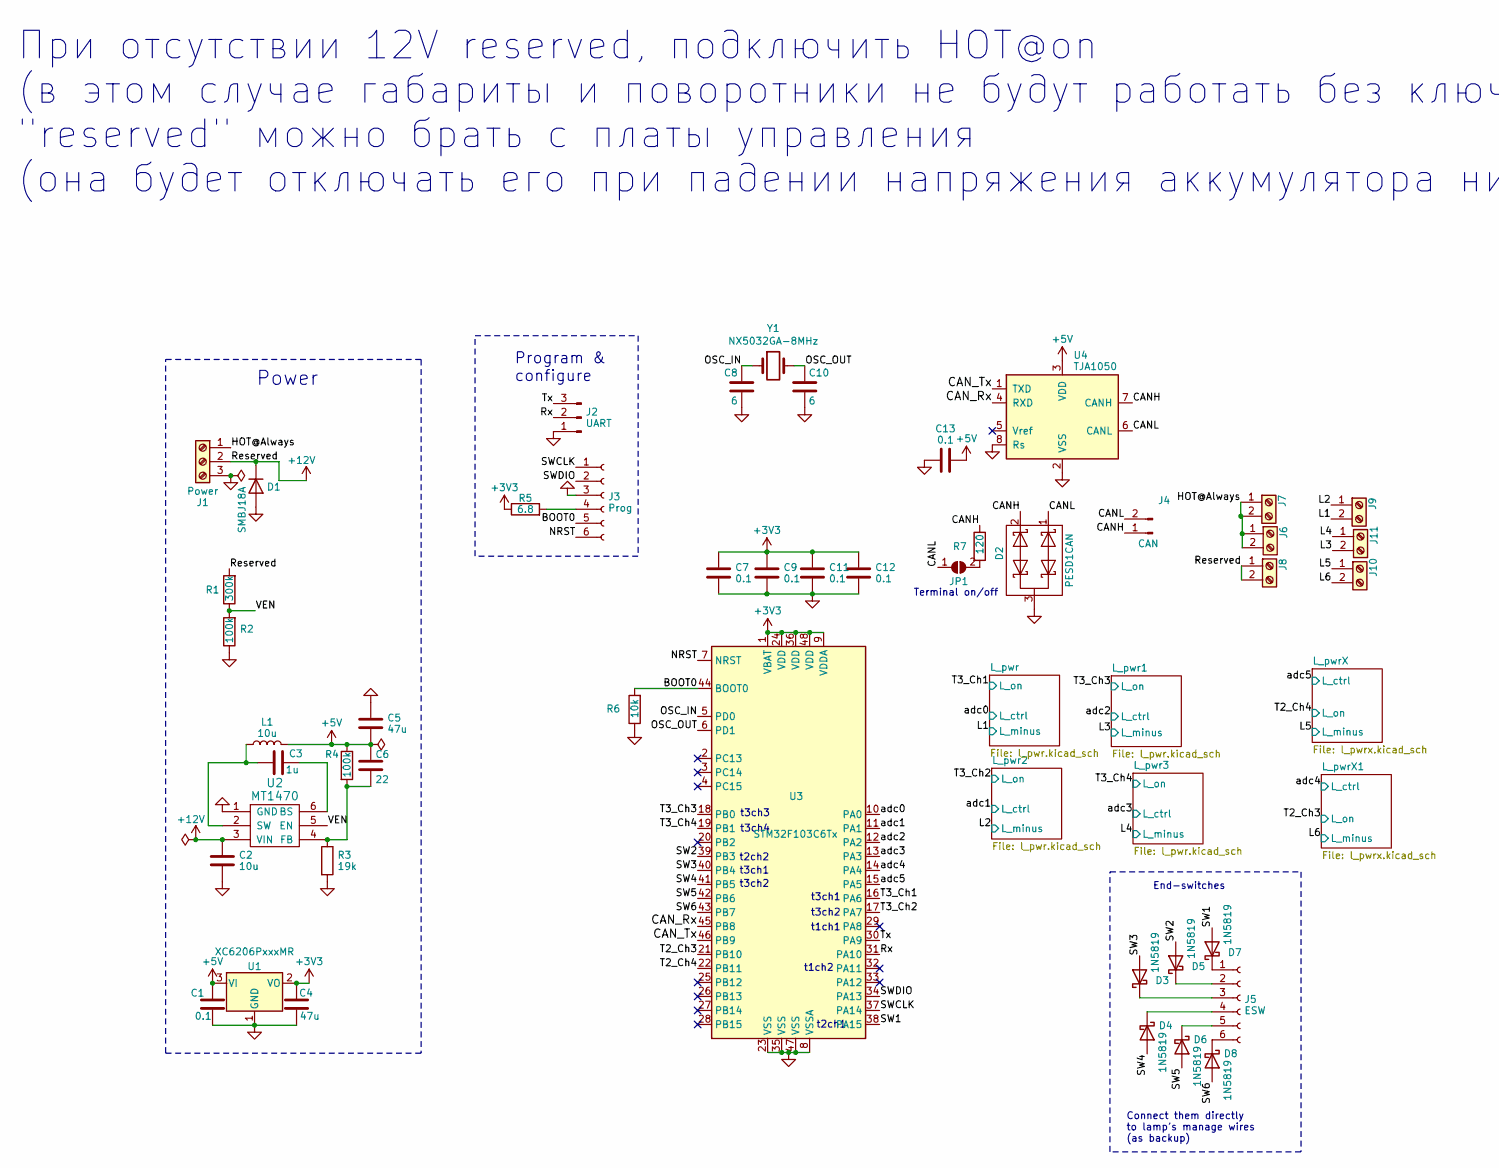
[picture p67: schematic lamps.kicad_sch, part in row 1, column 1]

Parts:
C1, C7, C9, C11, C12, C13: 0.1; C_0603_1608Metric_Pad1.08x0.95mm_HandSolder
C2: 10u; C_1206_3216Metric_Pad1.33x1.80mm_HandSolder
C3: 1u; C_1206_3216Metric_Pad1.33x1.80mm_HandSolder
C4: 47u; C_1206_3216Metric
C5: 47u; C_1206_3216Metric_Pad1.33x1.80mm_HandSolder
C6: 22; C_0805_2012Metric_Pad1.18x1.45mm_HandSolder
C8, C10: 6; C_0603_1608Metric_Pad1.08x0.95mm_HandSolder
D1: SMBJ18A; D_SMB_Handsoldering
D2: PESD1CAN; SOT-23
D3, D4, D5, D6, D7, D8: 1N5819; D_SOD-323_HandSoldering
J1: Power; TerminalBlock_Phoenix_MKDS-1,5-3-5.08_1x03_P5.08mm_Horizont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
J2: UART; PinSocket_1x03_P2.54mm_Vertical
J3: Prog; PinSocket_1x06_P1.27mm_Vertical
J4: CAN; JST_PH_B2B-PH-K_1x02_P2.00mm_Vertical
J5: ESW; PinSocket_1x06_P2.54mm_Vertical
J6, J7: ACC; TerminalBlock_Phoenix_MKDS-1,5-2_1x02_P5.00mm_Horizontal
J8: Reserved; TerminalBlock_Phoenix_MKDS-1,5-2_1x02_P5.00mm_Horizontal
J9, J10, J11: Lamp; TerminalBlock_Phoenix_MKDS-1,5-2_1x02_P5.00mm_Horizontal
JP1: Term; SolderJumper-2_P1.3mm_Open_TrianglePad1.0x1.5mm
L1: 10u; cd43
R1: 300k; R_0603_1608Metric_Pad0.98x0.95mm_HandSolder
R2, R4: 100k; R_0603_1608Metric_Pad0.98x0.95mm_HandSolder
R3: 19k; R_0603_1608Metric_Pad0.98x0.95mm_HandSolder
R5: 6.8; R_0603_1608Metric_Pad0.98x0.95mm_HandSolder
R6: 10k; R_0603_1608Metric_Pad0.98x0.95mm_HandSolder
R7: 120; R_1210_3225Metric_Pad1.30x2.65mm_HandSolder
U1: XC6206PxxxMR; SOT-23-3
U2: MT1470; SOT-23-6_Handsoldering
U3: STM32F103C6Tx; LQFP-48_7x7mm_P0.5mm
U4: TJA1050; SOIC-8_3.9x4.9mm_P1.27mm
Y1: NX5032GA-8MHz; Crystal_SMD_5032-2Pin_5.0x3.2mm

Connections:
+3V3: C4.1, C7.1, C9.1, C11.1, C12.1, R5.1, U1.2 (VO), U3.1 (VBAT), U3.9 (VDDA), U3.24 (VDD), U3.36 (VDD), U3.48 (VDD)
+5V: C1.1, C5.1, C6.1, C13.2, L1.2, R4.1, U1.3 (VI), U4.3 (VDD)
+12V: C2.2, D1.1 (K), J1.2, J8.1, J8.2, R1.2, U2.3 (VIN)
/BOOT0: J3.5, R6.2, U3.44 (BOOT0)
/CANH: D2.2 (K), J4.1, R7.1, U4.7 (CANH)
/CANL: D2.1 (K), J4.2, JP1.1 (A), U4.6 (CANL)
/CAN_Rx: U3.45 (PB8), U4.4 (RXD)
/CAN_Tx: U3.46 (PB9), U4.1 (TXD)
/HOT@Always: J1.1, J6.1, J6.2, J7.1, J7.2
/L1: J9.2; also elsewhere on the board
/L2: J9.1; also elsewhere on the board
/L3: J11.2; also elsewhere on the board
/L4: J11.1; also elsewhere on the board
/L5: J10.1; also elsewhere on the board
/L6: J10.2; also elsewhere on the board
/NRST: J3.6, U3.7 (NRST)
/OSC_IN: C8.1, U3.5 (PD0), Y1.1
/OSC_OUT: C10.1, U3.6 (PD1), Y1.2
/Rx: J2.2, U3.31 (PA10)
/SW1: D7.2 (A), U3.38 (PA15)
/SW2: D5.2 (A), U3.39 (PB3)
/SW3: D3.2 (A), U3.40 (PB4)
/SW4: D4.2 (A), U3.41 (PB5)
/SW5: D6.2 (A), U3.42 (PB6)
/SW6: D8.2 (A), U3.43 (PB7)
/SWCLK: J3.1, U3.37 (PA14)
/SWDIO: J3.2, U3.34 (PA13)
/T2_Ch3: U3.21 (PB10); also elsewhere on the board
/T2_Ch4: U3.22 (PB11); also elsewhere on the board
/T3_Ch1: U3.16 (PA6); also elsewhere on the board
/T3_Ch2: U3.17 (PA7); also elsewhere on the board
/T3_Ch3: U3.18 (PB0); also elsewhere on the board
/T3_Ch4: U3.19 (PB1); also elsewhere on the board
/Tx: J2.3, U3.30 (PA9)
/VEN: R1.1, R2.2, U2.5 (EN)
/adc0: U3.10 (PA0); also elsewhere on the board
/adc1: U3.11 (PA1); also elsewhere on the board
/adc2: U3.12 (PA2); also elsewhere on the board
/adc3: U3.13 (PA3); also elsewhere on the board
/adc4: U3.14 (PA4); also elsewhere on the board
/adc5: U3.15 (PA5); also elsewhere on the board
GND: C1.2, C2.1, C4.2, C5.2, C7.2, C8.2, C9.2, C10.2, C11.2, C12.2, C13.1, D1.2 (A), D2.3 (O), J1.3, J2.1, J3.3, R2.1, R3.2, R6.1, U1.1 (GND), U2.1 (GND), U3.8 (VSSA), U3.23 (VSS), U3.35 (VSS), U3.47 (VSS), U4.2 (VSS), U4.8 (Rs); also elsewhere on the board
unnamed: D3.1 (K), J5.3
unnamed: D4.1 (K), J5.4
unnamed: D5.1 (K), J5.2
unnamed: D6.1 (K), J5.5
unnamed: D7.1 (K), J5.1
unnamed: D8.1 (K), J5.6
unnamed: J3.4, R5.2
unnamed: JP1.2 (B), R7.2
unnamed: C3.2, U2.6 (BS)
unnamed: C6.2, R3.1, R4.2, U2.4 (FB)
unnamed: C3.1, L1.1, U2.2 (SW)

Notes on the sheet:
t3ch4
При отсутствии 12V reserved, подключить HOT@on (в этом случае габариты и поворотники не будут работать без ключа!) "reserved" можно брать с платы управления (она будет отключать его при падении напряжения аккумулятора ниже 10В).
t3ch2
Connect them directly to lamp's manage wires (as backup)
t1ch2
t2ch2
t2ch1
Terminal on/off
Program & configure
t3ch3
End-switches
t3ch1
Power
t1ch1

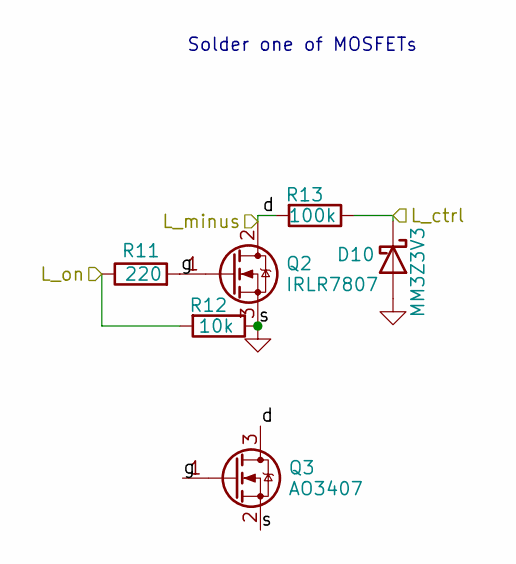
[picture p68: schematic l_pwrx.kicad_sch]

Parts:
D10: MM3Z3V3; D_0805_2012Metric_Pad1.15x1.40mm_HandSolder
Q2: IRLR7807; TO-252-3_TabPin2
Q3: AO3407; SOT-23_Handsoldering
R11: 220; R_0603_1608Metric_Pad0.98x0.95mm_HandSolder
R12: 10k; R_0603_1608Metric_Pad0.98x0.95mm_HandSolder
R13: 100k; R_0603_1608Metric_Pad0.98x0.95mm_HandSolder

Connections:
/L5: Q2.2 (D), Q3.3 (D), R13.2; also elsewhere on the board
/L_pwrX/g: Q2.1 (G), Q3.1 (G), R11.2
/T2_Ch4: R11.1, R12.2; also elsewhere on the board
/adc5: D10.1 (K), R13.1; also elsewhere on the board
GND: D10.2 (A), Q2.3 (S), Q3.2 (S), R12.1; also elsewhere on the board

Parts of its further copies:
D14: MM3Z3V3; D_0805_2012Metric_Pad1.15x1.40mm_HandSolder
Q7: IRLR7807; TO-252-3_TabPin2
Q8: AO3407; SOT-23_Handsoldering
R23: 220; R_0603_1608Metric_Pad0.98x0.95mm_HandSolder
R24: 10k; R_0603_1608Metric_Pad0.98x0.95mm_HandSolder
R25: 100k; R_0603_1608Metric_Pad0.98x0.95mm_HandSolder

Connections of its further copies:
/L6: Q7.2 (D), Q8.3 (D), R25.2; also elsewhere on the board
/L_pwrX1/g: Q7.1 (G), Q8.1 (G), R23.2
/T2_Ch3: R23.1, R24.2; also elsewhere on the board
/adc4: D14.1 (K), R25.1; also elsewhere on the board
GND: D14.2 (A), Q7.3 (S), Q8.2 (S), R24.1; also elsewhere on the board

Notes on the sheet:
Solder one of MOSFETs

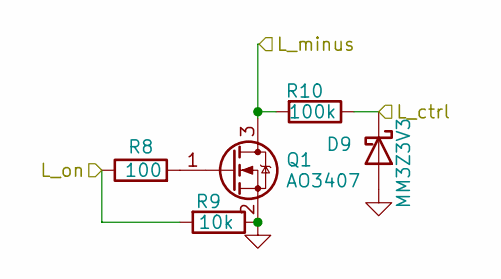
[picture p69: schematic l_pwr.kicad_sch]

Parts:
D9: MM3Z3V3; D_0805_2012Metric_Pad1.15x1.40mm_HandSolder
Q1: AO3407; SOT-23_Handsoldering
R8: 100; R_0603_1608Metric_Pad0.98x0.95mm_HandSolder
R9: 10k; R_0603_1608Metric_Pad0.98x0.95mm_HandSolder
R10: 100k; R_0603_1608Metric_Pad0.98x0.95mm_HandSolder

Connections:
/L1: Q1.3 (D), R10.2; also elsewhere on the board
/T3_Ch1: R8.1, R9.2; also elsewhere on the board
/adc0: D9.1 (K), R10.1; also elsewhere on the board
GND: D9.2 (A), Q1.2 (S), R9.1; also elsewhere on the board
unnamed: Q1.1 (G), R8.2

Parts of its further copies:
D11, D12, D13: MM3Z3V3; D_0805_2012Metric_Pad1.15x1.40mm_HandSolder
Q4, Q5, Q6: AO3407; SOT-23_Handsoldering
R14, R17, R20: 100; R_0603_1608Metric_Pad0.98x0.95mm_HandSolder
R15, R18, R21: 10k; R_0603_1608Metric_Pad0.98x0.95mm_HandSolder
R16, R19, R22: 100k; R_0603_1608Metric_Pad0.98x0.95mm_HandSolder

Connections of its further copies:
/L2: Q5.3 (D), R19.2; also elsewhere on the board
/L3: Q4.3 (D), R16.2; also elsewhere on the board
/L4: Q6.3 (D), R22.2; also elsewhere on the board
/T3_Ch2: R17.1, R18.2; also elsewhere on the board
/T3_Ch3: R14.1, R15.2; also elsewhere on the board
/T3_Ch4: R20.1, R21.2; also elsewhere on the board
/adc1: D12.1 (K), R19.1; also elsewhere on the board
/adc2: D11.1 (K), R16.1; also elsewhere on the board
/adc3: D13.1 (K), R22.1; also elsewhere on the board
GND: D11.2 (A), D12.2 (A), D13.2 (A), Q4.2 (S), Q5.2 (S), Q6.2 (S), R15.1, R18.1, R21.1; also elsewhere on the board
unnamed: Q4.1 (G), R14.2
unnamed: Q5.1 (G), R17.2
unnamed: Q6.1 (G), R20.2

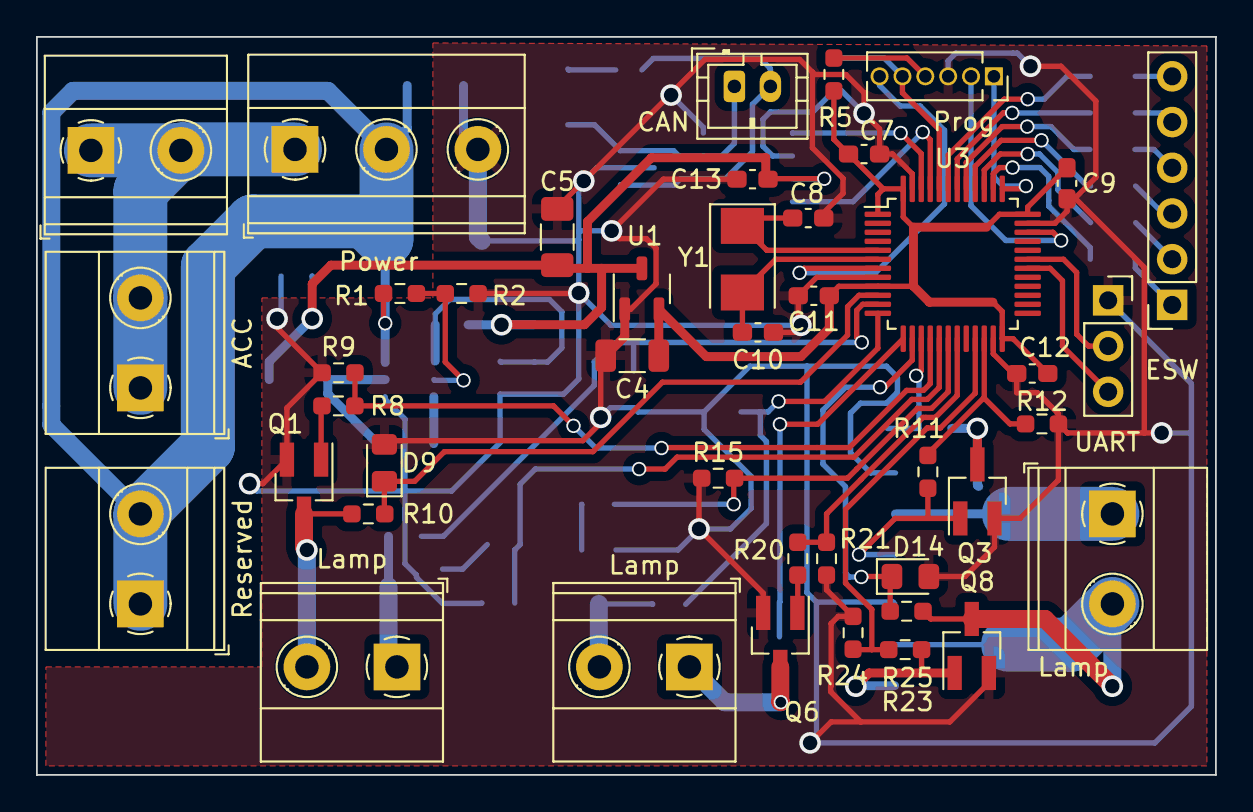
[picture p70: board lamps.kicad_pcb from above]

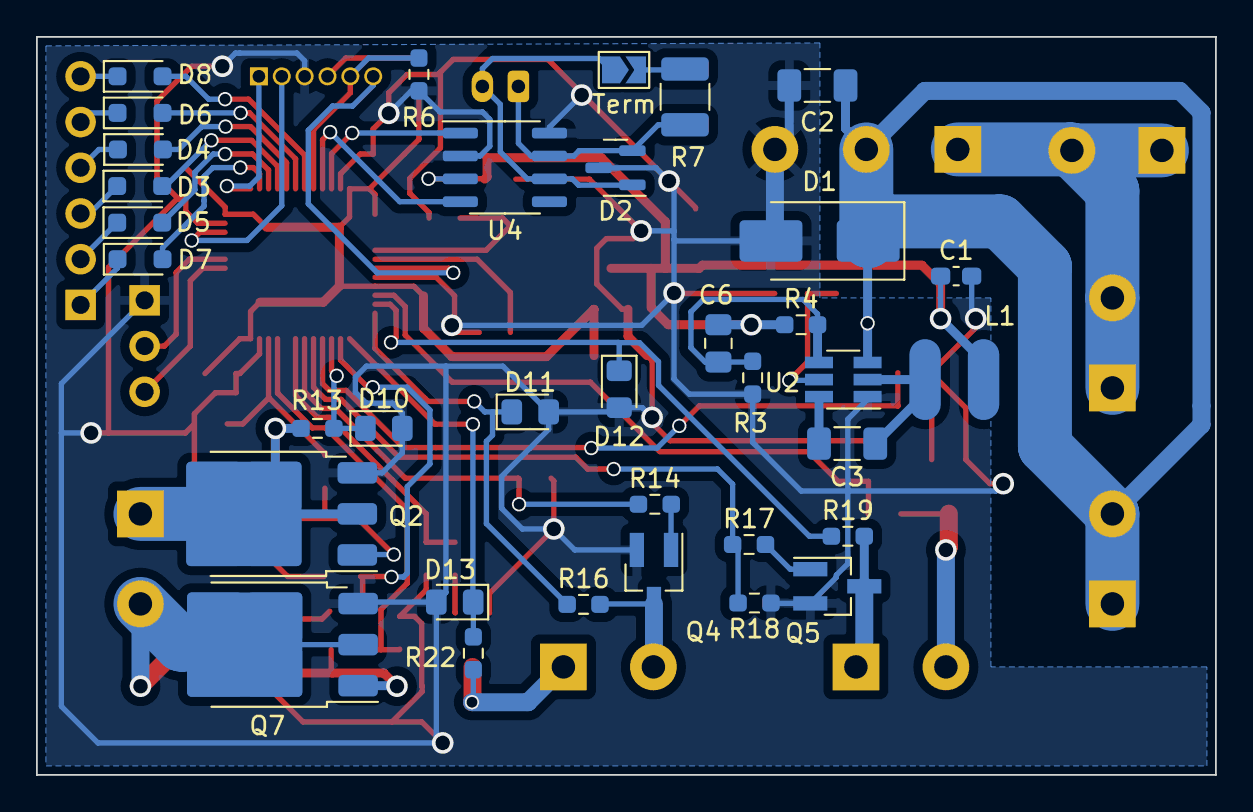
[picture p71: board lamps.kicad_pcb from below]

Board: 2 copper layers, 65.5 x 41.0 mm, 78 parts (35 on the bottom side), 59 nets.
