eddyem/stm32samples/F3:F303/Multistepper/kicad/multistepper.kicad_pcb

## KiCad design F3:F303/Multistepper/kicad/multistepper.kicad_pcb (2022-11-26)

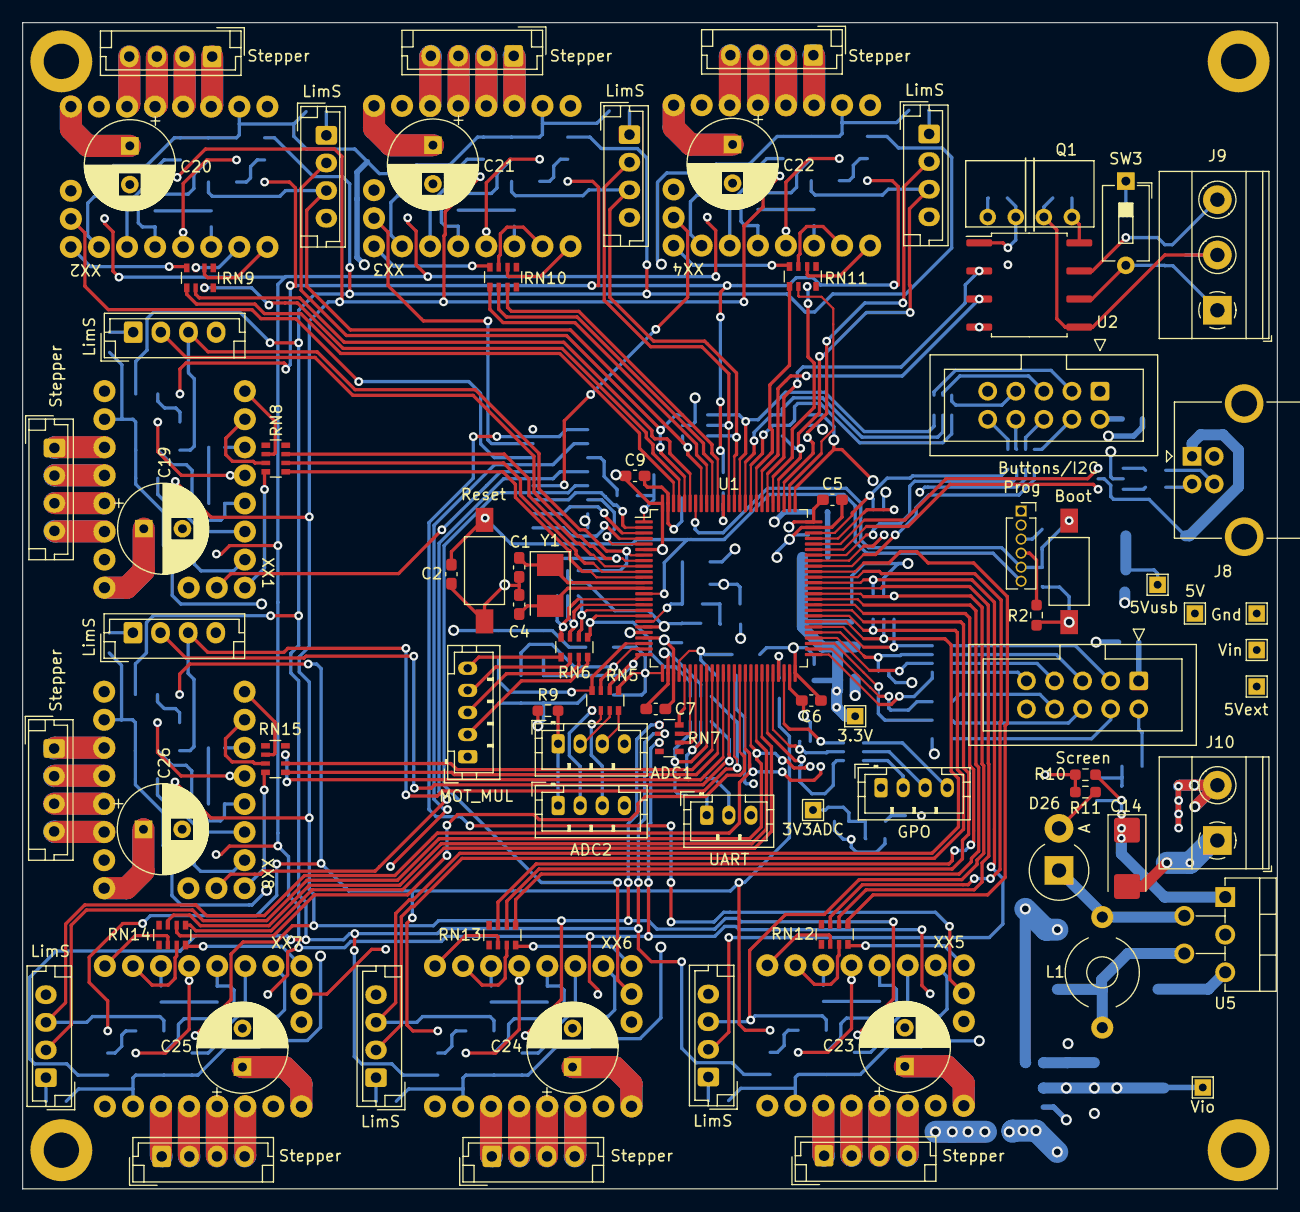
[picture p76: board multistepper.kicad_pcb from above]

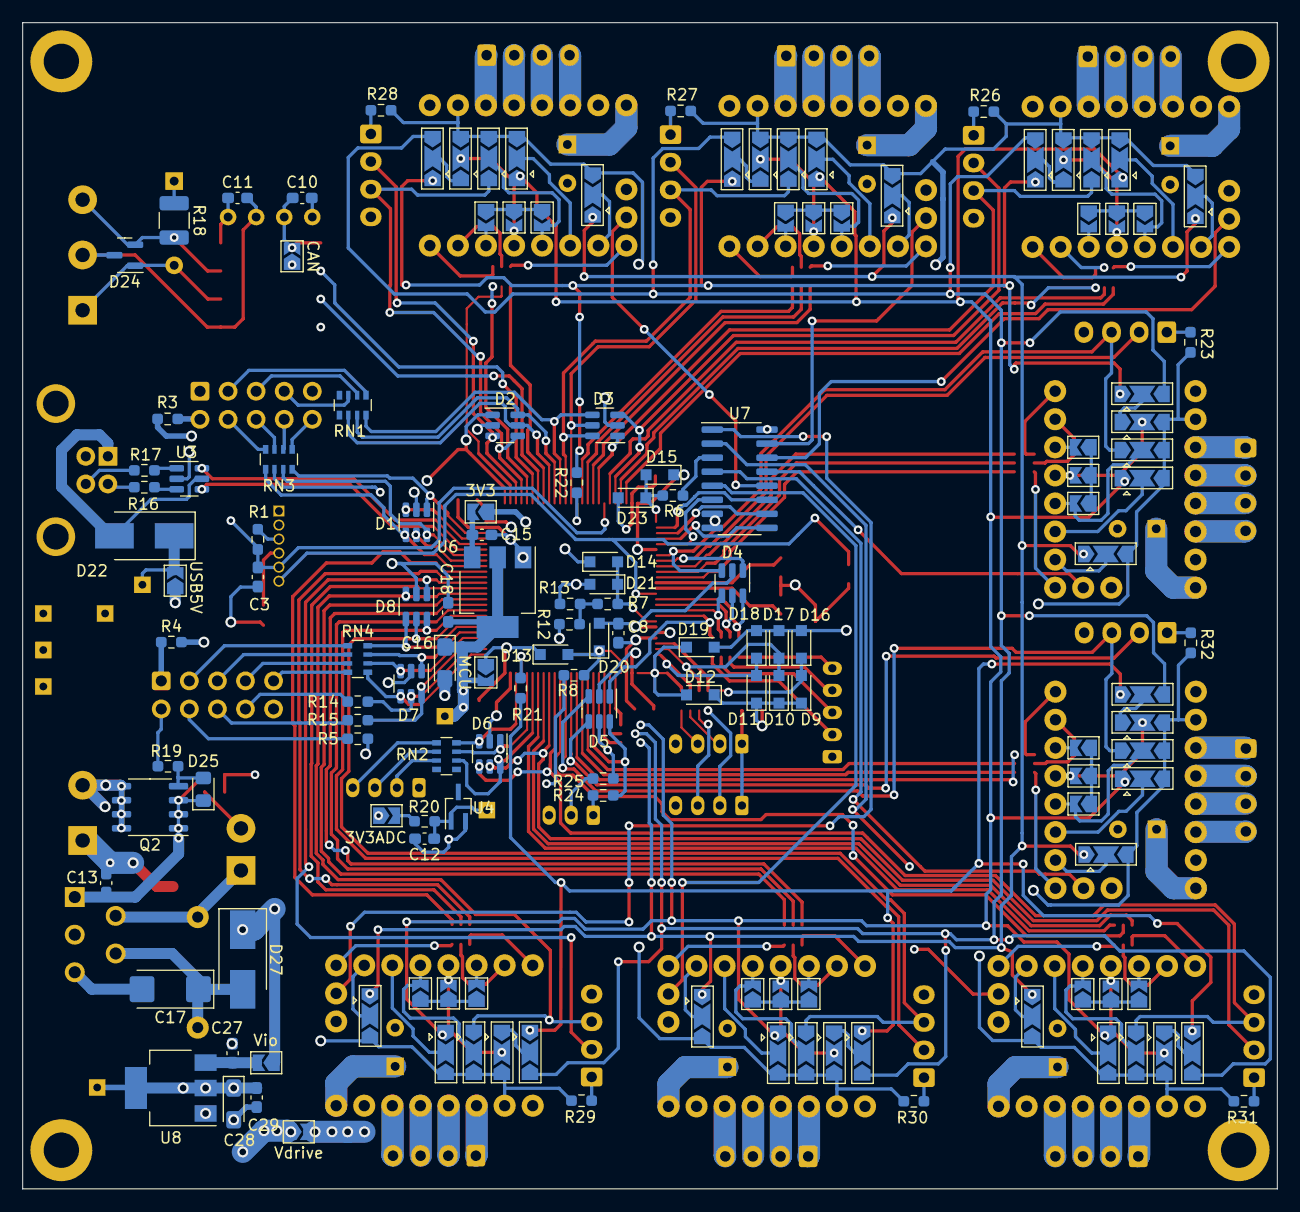
[picture p77: board multistepper.kicad_pcb from below]

Board: 4 copper layers, 113.5 x 105.5 mm, 236 parts (148 on the bottom side), 282 nets.

Parts:
C1, C4: 12; C_0603_1608Metric_Pad1.08x0.95mm_HandSolder
C2, C3, C5, C6, C7, C8, C9, C13, C15, C18, C27, C29: 0.1; C_0603_1608Metric_Pad1.08x0.95mm_HandSolder
C10, C11, C12: 1u; C_0603_1608Metric_Pad1.08x0.95mm_HandSolder
C14: 47u 35V; CP_EIA-6032-28_Kemet-C_Pad2.25x2.35mm_HandSolder
C16, C28: 47u 6V; CP_EIA-3216-18_Kemet-A_Pad1.58x1.35mm_HandSolder
C17: 47u 10V; CP_EIA-6032-28_Kemet-C_Pad2.25x2.35mm_HandSolder
C19, C20, C21, C22, C23, C24, C25, C26: 100u 35V; CP_Radial_D8.0mm_P3.50mm
D1, D2, D3, D4, D5, D6, D7, D8: SP0505BAHT; SOT-23-6
D9, D10, D11, D12, D13, D14, D15, D16, D17, D18, D19, D20, D21, D23: SS14; D_SOD-323_HandSoldering
D22, D27: MBRS130L; D_SMB_Handsoldering
D24: PESD1CAN; SOT-23
D25: MM3Z7V5; D_0805_2012Metric_Pad1.15x1.40mm_HandSolder
D26: 1N5822; D_DO-201_P3.81mm_Vertical_AnodeUp
H1, H2, H3, H4: MountingHole; MountingHole_3.2mm_M3_DIN965_Pad
J1: Prog; PinSocket_1x06_P1.27mm_Vertical
J2: Buttons/I2C; IDC-Header_2x05_P2.54mm_Vertical
J3: Screen; IDC-Header_2x05_P2.54mm_Vertical
J4: ADC2; JST_PH_B4B-PH-K_1x04_P2.00mm_Vertical
J5: ADC1; JST_PH_B4B-PH-K_1x04_P2.00mm_Vertical
J6: MOT_MUL; JST_PH_B5B-PH-K_1x05_P2.00mm_Vertical
J7: GPO; JST_PH_B4B-PH-K_1x04_P2.00mm_Vertical
J8: USB_B; USB_B_OST_USB-B1HSxx_Horizontal
J9: Screw_Terminal_01x03; TerminalBlock_Phoenix_MKDS-1,5-3_1x03_P5.00mm_Horizontal
J10: Screw_Terminal_01x02; TerminalBlock_Phoenix_MKDS-1,5-2_1x02_P5.00mm_Horizontal
J11, J14, J16, J18, J20, J22, J24, J26: LimS; JST_EH_B4B-EH-A_1x04_P2.50mm_Vertical
J12, J15, J17, J19, J21, J23, J25, J27: Stepper; JST_EH_B4B-EH-A_1x04_P2.50mm_Vertical
J13: UART; JST_PH_B3B-PH-K_1x03_P2.00mm_Vertical
JP1: CAN; SolderJumper-2_P1.3mm_Open_TrianglePad1.0x1.5mm
JP2: USB5V; SolderJumper-2_P1.3mm_Open_TrianglePad1.0x1.5mm
JP3: MCU; SolderJumper-2_P1.3mm_Open_TrianglePad1.0x1.5mm
JP4: 3V3ADC; SolderJumper-2_P1.3mm_Open_TrianglePad1.0x1.5mm
JP5: 3V3; SolderJumper-2_P1.3mm_Open_TrianglePad1.0x1.5mm
JP6: Vdrive; SolderJumper-2_P1.3mm_Open_TrianglePad1.0x1.5mm
JP7: Vio; SolderJumper-2_P1.3mm_Open_TrianglePad1.0x1.5mm
JP8, JP9, JP10, JP11, JP12, JP16, JP17, JP18, JP19, JP20, JP24, JP25, JP26, JP27, JP28, JP32, JP33, JP34, JP35, JP36, JP40, JP41, JP42, JP43, JP44, JP48, JP49, JP50, JP51, JP52, JP56, JP57, JP58, JP59, JP60, JP64, JP65, JP66, JP67, JP68: SolderJumper_3_Open; SolderJumper-3_P2.0mm_Open_TrianglePad1.0x1.5mm
JP13, JP14, JP15, JP21, JP22, JP23, JP29, JP30, JP31, JP37, JP38, JP39, JP45, JP46, JP47, JP53, JP54, JP55, JP61, JP62, JP63, JP69, JP70, JP71: SolderJumper_2_Bridged; SolderJumper-2_P1.3mm_Open_TrianglePad1.0x1.5mm
L1: 100u; L_Toroid_Horizontal_D6.5mm_P10.00mm_Diameter7-5mm_Amidon-T25
Q1: B0505S; B0x0xS
Q2: IRF9310; SO-8_3.9x4.9mm_P1.27mm
R1, R11: 10k; R_0603_1608Metric_Pad0.98x0.95mm_HandSolder
R2, R3, R9, R16, R17, R24, R25: 22; R_0603_1608Metric_Pad0.98x0.95mm_HandSolder
R4: 7.5; R_0603_1608Metric_Pad0.98x0.95mm_HandSolder
R5: 5.1; R_0603_1608Metric_Pad0.98x0.95mm_HandSolder
R6, R7, R8, R14, R15: 330; R_0603_1608Metric_Pad0.98x0.95mm_HandSolder
R10: 91k; R_0603_1608Metric_Pad0.98x0.95mm_HandSolder
R12, R13: 47k; R_0603_1608Metric_Pad0.98x0.95mm_HandSolder
R18: 120; R_1210_3225Metric_Pad1.30x2.65mm_HandSolder
R19, R20: 4k7; R_0603_1608Metric_Pad0.98x0.95mm_HandSolder
R21, R22, R23, R26, R27, R28, R29, R30, R31, R32: 100; R_0603_1608Metric_Pad0.98x0.95mm_HandSolder
RN1, RN2, RN3, RN4, RN5, RN6, RN7, RN8, RN9, RN10, RN11, RN12, RN13, RN14, RN15: 330; R_Array_Convex_4x0603
SW1: Reset; SW_SPST_FSMSM
SW2: Boot; SW_SPST_FSMSM
SW3: SW_DIP_x01; SW_DIP_SPSTx01_Slide_6.7x4.1mm_W7.62mm_P2.54mm_LowProfile
TP1: 5Vusb; TestPoint_THTPad_1.5x1.5mm_Drill0.7mm
TP2: Vin; TestPoint_THTPad_1.5x1.5mm_Drill0.7mm
TP3: Gnd; TestPoint_THTPad_1.5x1.5mm_Drill0.7mm
TP4: 5Vext; TestPoint_THTPad_1.5x1.5mm_Drill0.7mm
TP5: 3.3V; TestPoint_THTPad_1.5x1.5mm_Drill0.7mm
TP6: 3V3ADC; TestPoint_THTPad_1.5x1.5mm_Drill0.7mm
TP7: 5V; TestPoint_THTPad_1.5x1.5mm_Drill0.7mm
TP8: Vio; TestPoint_THTPad_1.5x1.5mm_Drill0.7mm
U1: STM32F303VDTx; LQFP-100_14x14mm_P0.5mm
U2: ISO1050DUB; SOP-8_6.62x9.15mm_P2.54mm
U3: USBLC6-2SC6; SOT-23-6
U4: LM4050A(b)EX3-3.3; SOT-323_SC-70_Handsoldering
U5: LM2576-5.0; TO-220-5_P3.4x3.7mm_StaggerEven_Lead3.8mm_Vertical
U6, U8: LM1117-3.3; SOT-223-3_TabPin2
U7: 74HC4051; SOIC-16_3.9x9.9mm_P1.27mm
XX1, XX2, XX3, XX4, XX5, XX6, XX7, XX8: stepper_module
Y1: NX5032GA-8MHz; Crystal_SMD_5032-2Pin_5.0x3.2mm

Connections:
+3.3VADC: C12.1, R20.1, TP6.1, U1.21 (VREF+), U4.1 (K)
+3V3: C16.1, C18.1, JP3.2 (B), R3.2, R4.2, TP5.1, U6.2 (VO)
+5V: D27.1 (K), JP1.1 (A), JP2.1 (A), JP4.1 (A), JP5.1 (A), JP7.1 (A), R5.1, R12.2, TP7.1
/CANH: D24.2 (K), J9.3, R18.2, U2.7 (CANH)
/CANL: D24.1 (K), J9.1, SW3.2, U2.6 (CANL)
/MCU base/A0: D9.2 (A), D16.1 (K), RN5.8 (R1.2), U1.23 (PA0)
/MCU base/A1: D10.2 (A), D17.1 (K), RN5.7 (R2.2), U1.24 (PA1)
/MCU base/A2: D11.2 (A), D18.1 (K), RN5.6 (R3.2), U1.25 (PA2)
/MCU base/A3: D12.2 (A), D19.1 (K), RN5.5 (R4.2), U1.26 (PA3)
/MCU base/A4: D13.2 (A), D20.1 (K), R8.1, U1.29 (PA4)
/MCU base/A5: D14.2 (A), D21.1 (K), R7.2, U1.19 (PF2)
/MCU base/BOOT0: C3.1, J1.5, R1.1, SW2.1, U1.94 (BOOT0)
/MCU base/BTN0: D1.4 (K), RN3.1 (R1.1), U1.67 (PA8)
/MCU base/BTN1: D1.5 (K), RN3.2 (R2.1), U1.68 (PA9)
/MCU base/BTN2_SDA: D1.6 (K), RN3.3 (R3.1), U1.69 (PA10)
/MCU base/BTN3_SCL: D1.1 (K), RN3.4 (R4.1), U1.73 (PF6)
/MCU base/BTN4: D2.5 (K), RN1.6 (R3.2), U1.84 (PD3)
/MCU base/BTN5: D2.6 (K), RN1.7 (R2.2), U1.85 (PD4)
/MCU base/BTN6: D3.4 (K), RN1.8 (R1.2), U1.86 (PD5)
/MCU base/Diagn: D15.2 (A), D23.1 (K), R6.2, U1.1 (PE2)
/MCU base/MOT_MUL0: D4.6 (K), RN6.8 (R1.2), U1.15 (PC0)
/MCU base/MOT_MUL1: D4.5 (K), RN6.7 (R2.2), U1.16 (PC1)
/MCU base/MOT_MUL2: D4.4 (K), RN6.6 (R3.2), U1.17 (PC2)
/MCU base/MOT_MUL_EN: D5.1 (K), RN6.5 (R4.2), U1.18 (PC3)
/MCU base/NRST: C2.1, J1.6, SW1.1, U1.14 (NRST)
/MCU base/OSC_IN: C1.1, U1.12 (PF0), Y1.1
/MCU base/OSC_OUT: C4.1, U1.13 (PF1), Y1.2
/MCU base/OUT0: D6.3 (K), RN2.8 (R1.2), U1.48 (PB11)
/MCU base/OUT1: D6.1 (K), RN2.7 (R2.2), U1.46 (PE15)
/MCU base/OUT2: D6.6 (K), RN2.6 (R3.2), U1.45 (PE14)
/MCU base/SCRN_CS: D8.4 (K), RN4.4 (R4.1), U1.56 (PD9)
/MCU base/SCRN_DCRS: D7.4 (K), RN4.1 (R1.1), U1.51 (PB12)
/MCU base/SCRN_MISO: D7.6 (K), R15.1, U1.53 (PB14)
/MCU base/SCRN_MOSI: D7.3 (K), RN4.2 (R2.1), U1.54 (PB15)
/MCU base/SCRN_RST: D7.1 (K), RN4.3 (R3.1), U1.55 (PD8)
/MCU base/SCRN_SCK: D7.5 (K), R14.1, U1.52 (PB13)
/MCU base/SWCLK: D2.1 (K), J1.1, U1.76 (PA14)
/MCU base/SWDIO: D1.3 (K), J1.2, U1.72 (PA13)
/MCU base/USART1_RX: D5.6 (K), R24.1, U1.34 (PC5)
/MCU base/USART1_TX: D5.5 (K), R25.1, U1.33 (PC4)
/Motors/DIAG0: U7.13 (Y0), XX1.17 (DIAG)
/Motors/DIAG1: U7.14 (Y1), XX2.17 (DIAG)
/Motors/DIAG2: U7.15 (Y2), XX3.17 (DIAG)
/Motors/DIAG3: U7.12 (Y3), XX4.17 (DIAG)
/Motors/DIAG4: U7.1 (Y4), XX5.17 (DIAG)
/Motors/DIAG5: U7.5 (Y5), XX6.17 (DIAG)
/Motors/DIAG6: U7.2 (Y6), XX7.17 (DIAG)
/Motors/DIAG7: U7.4 (Y7), XX8.17 (DIAG)
/Motors/MISO: JP9.3 (B), JP17.3 (B), JP25.3 (B), JP33.3 (B), JP41.3 (B), JP49.3 (B), JP57.3 (B), JP65.3 (B), RN7.2 (R2.1)
/Motors/MOSI: JP10.1 (A), JP18.1 (A), JP26.1 (A), JP34.1 (A), JP42.1 (A), JP50.1 (A), JP58.1 (A), JP66.1 (A), RN7.3 (R3.1)
/Motors/SCK: JP11.1 (A), JP19.1 (A), JP27.1 (A), JP35.1 (A), JP43.1 (A), JP51.1 (A), JP59.1 (A), JP67.1 (A), RN7.1 (R1.1)
/Motors/USART0-3: JP9.1 (A), JP17.1 (A), JP25.1 (A), JP33.1 (A), R22.2
/Motors/USART4-7: JP41.1 (A), JP49.1 (A), JP57.1 (A), JP65.1 (A), R21.2
/Motors/Vm: C19.1, C20.1, C21.1, C22.1, C23.1, C24.1, C25.1, C26.1, JP6.2 (B), XX1.16 (Vmot), XX2.16 (Vmot), XX3.16 (Vmot), XX4.16 (Vmot), XX5.16 (Vmot), XX6.16 (Vmot), XX7.16 (Vmot), XX8.16 (Vmot)
/Motors/stepper_M1/CLK: JP15.2 (B), XX1.6 (CLK)
/Motors/stepper_M1/DIRx: RN8.2 (R2.1), XX1.8 (DIR)
/Motors/stepper_M1/MS1: JP10.2 (C), XX1.2 (MS1)
/Motors/stepper_M1/MS2: JP11.2 (C), XX1.3 (MS2)
/Motors/stepper_M1/SPR: JP12.2 (C), JP13.2 (B), XX1.4 (SPREAD)
/Motors/stepper_M1/STEPx: RN8.3 (R3.1), XX1.7 (STEP)
/Motors/stepper_M1/U: JP8.2 (C), JP14.2 (B), XX1.5 (PDN_UART)
/Motors/stepper_M1/~ENx: RN8.4 (R4.1), XX1.1 (~EN)
/Motors/stepper_M2/CLK: JP23.2 (B), XX2.6 (CLK)
/Motors/stepper_M2/DIRx: RN9.2 (R2.1), XX2.8 (DIR)
/Motors/stepper_M2/MS1: JP18.2 (C), XX2.2 (MS1)
/Motors/stepper_M2/MS2: JP19.2 (C), XX2.3 (MS2)
/Motors/stepper_M2/SPR: JP20.2 (C), JP21.2 (B), XX2.4 (SPREAD)
/Motors/stepper_M2/STEPx: RN9.3 (R3.1), XX2.7 (STEP)
/Motors/stepper_M2/U: JP16.2 (C), JP22.2 (B), XX2.5 (PDN_UART)
/Motors/stepper_M2/~ENx: RN9.4 (R4.1), XX2.1 (~EN)
/Motors/stepper_M3/CLK: JP31.2 (B), XX3.6 (CLK)
/Motors/stepper_M3/DIRx: RN10.2 (R2.1), XX3.8 (DIR)
/Motors/stepper_M3/MS1: JP26.2 (C), XX3.2 (MS1)
/Motors/stepper_M3/MS2: JP27.2 (C), XX3.3 (MS2)
/Motors/stepper_M3/SPR: JP28.2 (C), JP29.2 (B), XX3.4 (SPREAD)
/Motors/stepper_M3/STEPx: RN10.3 (R3.1), XX3.7 (STEP)
/Motors/stepper_M3/U: JP24.2 (C), JP30.2 (B), XX3.5 (PDN_UART)
/Motors/stepper_M3/~ENx: RN10.4 (R4.1), XX3.1 (~EN)
/Motors/stepper_M4/CLK: JP39.2 (B), XX4.6 (CLK)
/Motors/stepper_M4/DIRx: RN11.2 (R2.1), XX4.8 (DIR)
/Motors/stepper_M4/MS1: JP34.2 (C), XX4.2 (MS1)
/Motors/stepper_M4/MS2: JP35.2 (C), XX4.3 (MS2)
/Motors/stepper_M4/SPR: JP36.2 (C), JP37.2 (B), XX4.4 (SPREAD)
/Motors/stepper_M4/STEPx: RN11.3 (R3.1), XX4.7 (STEP)
/Motors/stepper_M4/U: JP32.2 (C), JP38.2 (B), XX4.5 (PDN_UART)
/Motors/stepper_M4/~ENx: RN11.4 (R4.1), XX4.1 (~EN)
/Motors/stepper_M5/CLK: JP47.2 (B), XX5.6 (CLK)
/Motors/stepper_M5/DIRx: RN12.2 (R2.1), XX5.8 (DIR)
/Motors/stepper_M5/MS1: JP42.2 (C), XX5.2 (MS1)
/Motors/stepper_M5/MS2: JP43.2 (C), XX5.3 (MS2)
/Motors/stepper_M5/SPR: JP44.2 (C), JP45.2 (B), XX5.4 (SPREAD)
/Motors/stepper_M5/STEPx: RN12.3 (R3.1), XX5.7 (STEP)
/Motors/stepper_M5/U: JP40.2 (C), JP46.2 (B), XX5.5 (PDN_UART)
/Motors/stepper_M5/~ENx: RN12.4 (R4.1), XX5.1 (~EN)
/Motors/stepper_M6/CLK: JP55.2 (B), XX6.6 (CLK)
/Motors/stepper_M6/DIRx: RN13.2 (R2.1), XX6.8 (DIR)
/Motors/stepper_M6/MS1: JP50.2 (C), XX6.2 (MS1)
/Motors/stepper_M6/MS2: JP51.2 (C), XX6.3 (MS2)
/Motors/stepper_M6/SPR: JP52.2 (C), JP53.2 (B), XX6.4 (SPREAD)
/Motors/stepper_M6/STEPx: RN13.3 (R3.1), XX6.7 (STEP)
/Motors/stepper_M6/U: JP48.2 (C), JP54.2 (B), XX6.5 (PDN_UART)
/Motors/stepper_M6/~ENx: RN13.4 (R4.1), XX6.1 (~EN)
/Motors/stepper_M7/CLK: JP63.2 (B), XX7.6 (CLK)
/Motors/stepper_M7/DIRx: RN14.2 (R2.1), XX7.8 (DIR)
/Motors/stepper_M7/MS1: JP58.2 (C), XX7.2 (MS1)
/Motors/stepper_M7/MS2: JP59.2 (C), XX7.3 (MS2)
/Motors/stepper_M7/SPR: JP60.2 (C), JP61.2 (B), XX7.4 (SPREAD)
/Motors/stepper_M7/STEPx: RN14.3 (R3.1), XX7.7 (STEP)
/Motors/stepper_M7/U: JP56.2 (C), JP62.2 (B), XX7.5 (PDN_UART)
/Motors/stepper_M7/~ENx: RN14.4 (R4.1), XX7.1 (~EN)
/Motors/stepper_M8/CLK: JP71.2 (B), XX8.6 (CLK)
/Motors/stepper_M8/DIRx: RN15.2 (R2.1), XX8.8 (DIR)
/Motors/stepper_M8/MS1: JP66.2 (C), XX8.2 (MS1)
/Motors/stepper_M8/MS2: JP67.2 (C), XX8.3 (MS2)
/Motors/stepper_M8/SPR: JP68.2 (C), JP69.2 (B), XX8.4 (SPREAD)
/Motors/stepper_M8/STEPx: RN15.3 (R3.1), XX8.7 (STEP)
/Motors/stepper_M8/U: JP64.2 (C), JP70.2 (B), XX8.5 (PDN_UART)
/Motors/stepper_M8/~ENx: RN15.4 (R4.1), XX8.1 (~EN)
/VB: D22.2 (A), J8.1 (VBUS), U3.5 (VBUS)
ADC0: J4.2, RN5.1 (R1.1)
ADC1: J4.3, RN5.2 (R2.1)
ADC2: J5.2, RN5.3 (R3.1)
ADC3: J5.3, RN5.4 (R4.1)
ADC4: R8.2, R10.1, R11.2
ADC5: R7.1, R12.1, R13.2
CAN_RX: U1.81 (PD0), U2.2 (RXD)
CAN_TX: U1.82 (PD1), U2.3 (TXD)
DIAGNOST: R6.1, U7.3 (Z)
Earth: C11.2, D24.3 (O), J9.2, Q1.3 (0V), U2.5 (GND2)
GND: C1.2, C2.2, C4.2, C5.2, C6.2, C7.2, C8.2, C9.2, C10.2, C12.2, C13.2, C14.2, C15.2, C16.2, C17.2, C18.2, C19.2, C20.2, C21.2, C22.2, C23.2, C24.2, C25.2, C26.2, C27.2, C28.2, C29.2, D1.2 (A), D2.2 (A), D3.2 (A), D4.2 (A), D5.2 (A), D6.2 (A), D7.2 (A), D8.2 (A), D16.2 (A), D17.2 (A), D18.2 (A), D19.2 (A), D20.2 (A), D21.2 (A), D23.2 (A), D26.2 (A), J1.3, J2.1, J2.9, J3.2, J3.10, J4.4, J5.4, J6.1, J7.1, J8.4 (GND), J8.5 (Shield), J10.1, J11.4, J13.3, J14.4, J16.4, J18.4, J20.4, J22.4, J24.4, J26.4, Q1.1 (GND), R1.2, R11.1, R13.1, R19.2, SW1.2, TP3.1, U1.20 (VSSA), U1.27 (VSS), U1.49 (VSS), U1.74 (VSS), U1.99 (VSS), U2.4 (GND1), U3.2 (GND), U4.2 (A), U5.3 (GND), U5.5 (ON/OFF), U6.1 (GND), U7.7 (VEE), U7.8 (GND), U8.1 (GND), XX1.9 (GND), XX1.15 (GND), XX2.9 (GND), XX2.15 (GND), XX3.9 (GND), XX3.15 (GND), XX4.9 (GND), XX4.15 (GND), XX5.9 (GND), XX5.15 (GND), XX6.9 (GND), XX6.15 (GND), XX7.9 (GND), XX7.15 (GND), XX8.9 (GND), XX8.15 (GND)
M0_DIR: RN8.7 (R2.2), U1.9 (PC15)
M0_EN: RN8.5 (R4.2), U1.11 (PF10)
M0_L0: D4.1 (K), J11.2, U1.8 (PC14)
M0_L1: D4.3 (K), J11.3, JP12.1 (A), U1.7 (PC13)
M0_STEP: RN8.6 (R3.2), U1.10 (PF9)
M1_DIR: RN9.7 (R2.2), U1.97 (PE0)
M1_EN: RN9.5 (R4.2), U1.98 (PE1)
M1_L0: D3.3 (K), J14.2, U1.96 (PB9)
M1_L1: D3.1 (K), J14.3, JP20.1 (A), U1.93 (PB7)
M1_STEP: RN9.6 (R3.2), U1.95 (PB8)
M2_DIR: RN10.7 (R2.2), U1.90 (PB4)
M2_EN: RN10.5 (R4.2), U1.92 (PB6)
M2_L0: D3.5 (K), J16.2, U1.88 (PD7)
M2_L1: D3.6 (K), J16.3, JP28.1 (A), U1.87 (PD6)
M2_STEP: RN10.6 (R3.2), U1.91 (PB5)
M3_DIR: RN11.7 (R2.2), U1.80 (PC12)
M3_EN: RN11.5 (R4.2), U1.83 (PD2)
M3_L0: D2.3 (K), J18.2, U1.78 (PC10)
M3_L1: D2.4 (K), J18.3, JP36.1 (A), U1.79 (PC11)
M3_STEP: RN11.6 (R3.2), U1.77 (PA15)
M4_DIR: RN12.7 (R2.2), U1.65 (PC8)
M4_EN: RN12.5 (R4.2), U1.66 (PC9)
M4_L0: D8.1 (K), J20.2, U1.64 (PC7)
M4_L1: D8.3 (K), J20.3, JP44.1 (A), U1.62 (PD15)
M4_STEP: RN12.6 (R3.2), U1.63 (PC6)
M5_DIR: RN13.7 (R2.2), U1.60 (PD13)
M5_EN: RN13.5 (R4.2), U1.61 (PD14)
M5_L0: D8.6 (K), J22.2, U1.58 (PD11)
M5_L1: D8.5 (K), J22.3, JP52.1 (A), U1.57 (PD10)
M5_STEP: RN13.6 (R3.2), U1.59 (PD12)
M6_DIR: RN14.7 (R2.2), U1.43 (PE12)
M6_EN: RN14.5 (R4.2), U1.44 (PE13)
M6_L0: D6.5 (K), J24.2, U1.42 (PE11)
M6_L1: D6.4 (K), J24.3, JP60.1 (A), U1.41 (PE10)
M6_STEP: RN14.6 (R3.2), U1.40 (PE9)
M7_DIR: RN15.7 (R2.2), U1.37 (PB2)
M7_EN: RN15.5 (R4.2), U1.36 (PB1)
M7_L0: D5.4 (K), J26.2, U1.38 (PE7)
M7_L1: D5.3 (K), J26.3, JP68.1 (A), U1.39 (PE8)
M7_STEP: RN15.6 (R3.2), U1.35 (PB0)
MCU3v3: C3.2, C5.1, C6.1, C7.1, C8.1, C9.1, D9.1 (K), D10.1 (K), D11.1 (K), D12.1 (K), D13.1 (K), D14.1 (K), D15.1 (K), JP3.1 (A), R2.1, R9.1, SW2.2, U1.6 (VBAT), U1.22 (VDDA), U1.28 (VDD), U1.50 (VDD), U1.75 (VDD), U1.100 (VDD)
MUL0: U1.2 (PE3), U7.11 (S0)
MUL1: U1.3 (PE4), U7.10 (S1)
MUL2: U1.4 (PE5), U7.9 (S2)
MUL_EN: U1.5 (PE6), U7.6 (~E)
unnamed: C10.1, JP1.2 (B), Q1.2 (Vin), U2.1 (VCC1)
unnamed: C11.1, Q1.4 (+Vo), U2.8 (VCC2)
unnamed: C15.1, JP5.2 (B), U6.3 (VI)
unnamed: C17.1, D27.2 (A), L1.1, TP4.1, U5.4 (FB)
unnamed: C27.1, JP7.2 (B), U8.3 (VI)
unnamed: D22.1 (K), JP2.2 (B), TP1.1
unnamed: D25.2 (A), Q2.4 (G), R19.1
unnamed: D26.1 (K), L1.2, U5.2 (VOUT)
unnamed: J1.4, R2.2
unnamed: J2.2, R3.1
unnamed: J2.3, RN1.1 (R1.1)
unnamed: J2.4, RN3.8 (R1.2)
unnamed: J2.5, RN1.2 (R2.1)
unnamed: J2.6, RN3.7 (R2.2)
unnamed: J2.7, RN1.3 (R3.1)
unnamed: J2.8, RN3.6 (R3.2)
unnamed: J2.10, RN3.5 (R4.2)
unnamed: J3.1, R4.1
unnamed: J3.3, RN4.5 (R4.2)
unnamed: J3.4, R5.2
unnamed: J3.5, RN4.6 (R3.2)
unnamed: J3.6, R15.2
unnamed: J3.7, RN4.7 (R2.2)
unnamed: J3.8, R14.2
unnamed: J3.9, RN4.8 (R1.2)
unnamed: J4.1, J5.1, R9.2
unnamed: J6.2, RN6.4 (R4.1)
unnamed: J6.3, RN6.3 (R3.1)
unnamed: J6.4, RN6.2 (R2.1)
unnamed: J6.5, RN6.1 (R1.1)
unnamed: J7.2, RN2.3 (R3.1)
unnamed: J7.3, RN2.2 (R2.1)
unnamed: J7.4, RN2.1 (R1.1)
unnamed: J8.2 (D-), R16.1
unnamed: J8.3 (D+), R17.1
unnamed: J10.2, Q2.5 (D), Q2.6 (D), Q2.7 (D), Q2.8 (D)
unnamed: J11.1, R23.2
unnamed: J12.1, XX1.11 (M1B)
unnamed: J12.2, XX1.12 (M1A)
unnamed: J12.3, XX1.13 (M2A)
unnamed: J12.4, XX1.14 (M2B)
unnamed: J13.1, R24.2
unnamed: J13.2, R25.2
unnamed: J14.1, R26.2
unnamed: J15.1, XX2.11 (M1B)
unnamed: J15.2, XX2.12 (M1A)
unnamed: J15.3, XX2.13 (M2A)
unnamed: J15.4, XX2.14 (M2B)
unnamed: J16.1, R27.2
unnamed: J17.1, XX3.11 (M1B)
unnamed: J17.2, XX3.12 (M1A)
unnamed: J17.3, XX3.13 (M2A)
unnamed: J17.4, XX3.14 (M2B)
unnamed: J18.1, R28.2
unnamed: J19.1, XX4.11 (M1B)
unnamed: J19.2, XX4.12 (M1A)
unnamed: J19.3, XX4.13 (M2A)
unnamed: J19.4, XX4.14 (M2B)
unnamed: J20.1, R29.2
unnamed: J21.1, XX5.11 (M1B)
unnamed: J21.2, XX5.12 (M1A)
unnamed: J21.3, XX5.13 (M2A)
unnamed: J21.4, XX5.14 (M2B)
unnamed: J22.1, R30.2
unnamed: J23.1, XX6.11 (M1B)
unnamed: J23.2, XX6.12 (M1A)
unnamed: J23.3, XX6.13 (M2A)
unnamed: J23.4, XX6.14 (M2B)
unnamed: J24.1, R31.2
unnamed: J25.1, XX7.11 (M1B)
unnamed: J25.2, XX7.12 (M1A)
unnamed: J25.3, XX7.13 (M2A)
unnamed: J25.4, XX7.14 (M2B)
unnamed: J26.1, R32.2
unnamed: J27.1, XX8.11 (M1B)
unnamed: J27.2, XX8.12 (M1A)
unnamed: J27.3, XX8.13 (M2A)
unnamed: J27.4, XX8.14 (M2B)
unnamed: JP4.2 (B), R20.2
unnamed: JP8.1 (A), JP9.2 (C)
unnamed: JP13.1 (A), JP14.1 (A), JP15.1 (A)
unnamed: JP16.1 (A), JP17.2 (C)
unnamed: JP21.1 (A), JP22.1 (A), JP23.1 (A)
unnamed: JP24.1 (A), JP25.2 (C)
unnamed: JP29.1 (A), JP30.1 (A), JP31.1 (A)
unnamed: JP32.1 (A), JP33.2 (C)
unnamed: JP37.1 (A), JP38.1 (A), JP39.1 (A)
unnamed: JP40.1 (A), JP41.2 (C)
unnamed: JP45.1 (A), JP46.1 (A), JP47.1 (A)
unnamed: JP48.1 (A), JP49.2 (C)
unnamed: JP53.1 (A), JP54.1 (A), JP55.1 (A)
unnamed: JP56.1 (A), JP57.2 (C)
unnamed: JP61.1 (A), JP62.1 (A), JP63.1 (A)
unnamed: JP64.1 (A), JP65.2 (C)
unnamed: JP69.1 (A), JP70.1 (A), JP71.1 (A)
unnamed: R16.2, U3.3 (I/O2)
unnamed: R17.2, U3.1 (I/O1)
unnamed: R18.1, SW3.1
TMC_MISO: RN7.7 (R2.2), U1.31 (PA6)
TMC_MOSI: RN7.6 (R3.2), U1.32 (PA7)
TMC_SCK: RN7.8 (R1.2), U1.30 (PA5)
USART2_TX: R22.1, U1.89 (PB3)
USART3_TX: R21.1, U1.47 (PB10)
USB_DM: U1.70 (PA11), U3.4 (I/O2)
USB_DP: U1.71 (PA12), U3.6 (I/O1)
Vdrive: C13.1, C14.1, D25.1 (K), JP6.1 (A), Q2.1 (S), Q2.2 (S), Q2.3 (S), R10.2, TP2.1, U5.1 (VIN)
Vio: C28.1, C29.1, JP8.3 (B), JP10.3 (B), JP11.3 (B), JP12.3 (B), JP16.3 (B), JP18.3 (B), JP19.3 (B), JP20.3 (B), JP24.3 (B), JP26.3 (B), JP27.3 (B), JP28.3 (B), JP32.3 (B), JP34.3 (B), JP35.3 (B), JP36.3 (B), JP40.3 (B), JP42.3 (B), JP43.3 (B), JP44.3 (B), JP48.3 (B), JP50.3 (B), JP51.3 (B), JP52.3 (B), JP56.3 (B), JP58.3 (B), JP59.3 (B), JP60.3 (B), JP64.3 (B), JP66.3 (B), JP67.3 (B), JP68.3 (B), R23.1, R26.1, R27.1, R28.1, R29.1, R30.1, R31.1, R32.1, TP8.1, U7.16 (VCC), U8.2 (VO), XX1.10 (VIO), XX2.10 (VIO), XX3.10 (VIO), XX4.10 (VIO), XX5.10 (VIO), XX6.10 (VIO), XX7.10 (VIO), XX8.10 (VIO)
