eddyem/stm32samples/testboard/F0_F1-LQFP48_testboard/stm32.kicad_pcb

## KiCad design testboard/F0_F1-LQFP48_testboard/stm32.kicad_pcb (2019-05-18, an earlier design)

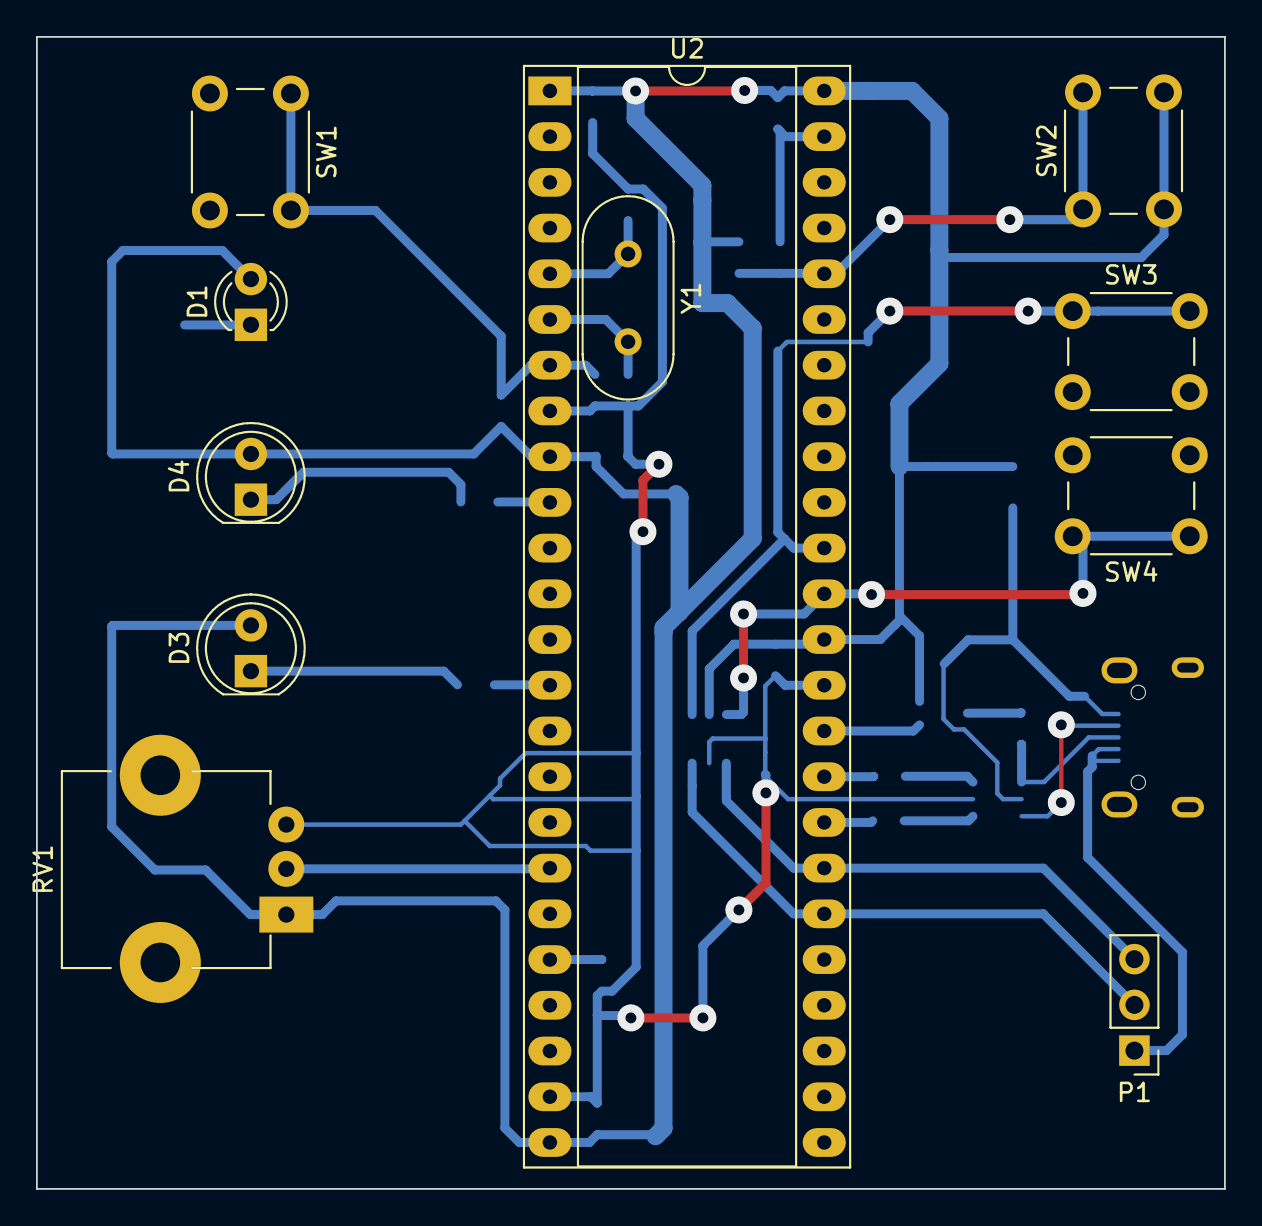
[picture p78: board testboard/F0_F1-LQFP48_testboard/stm32.kicad_pcb from above]

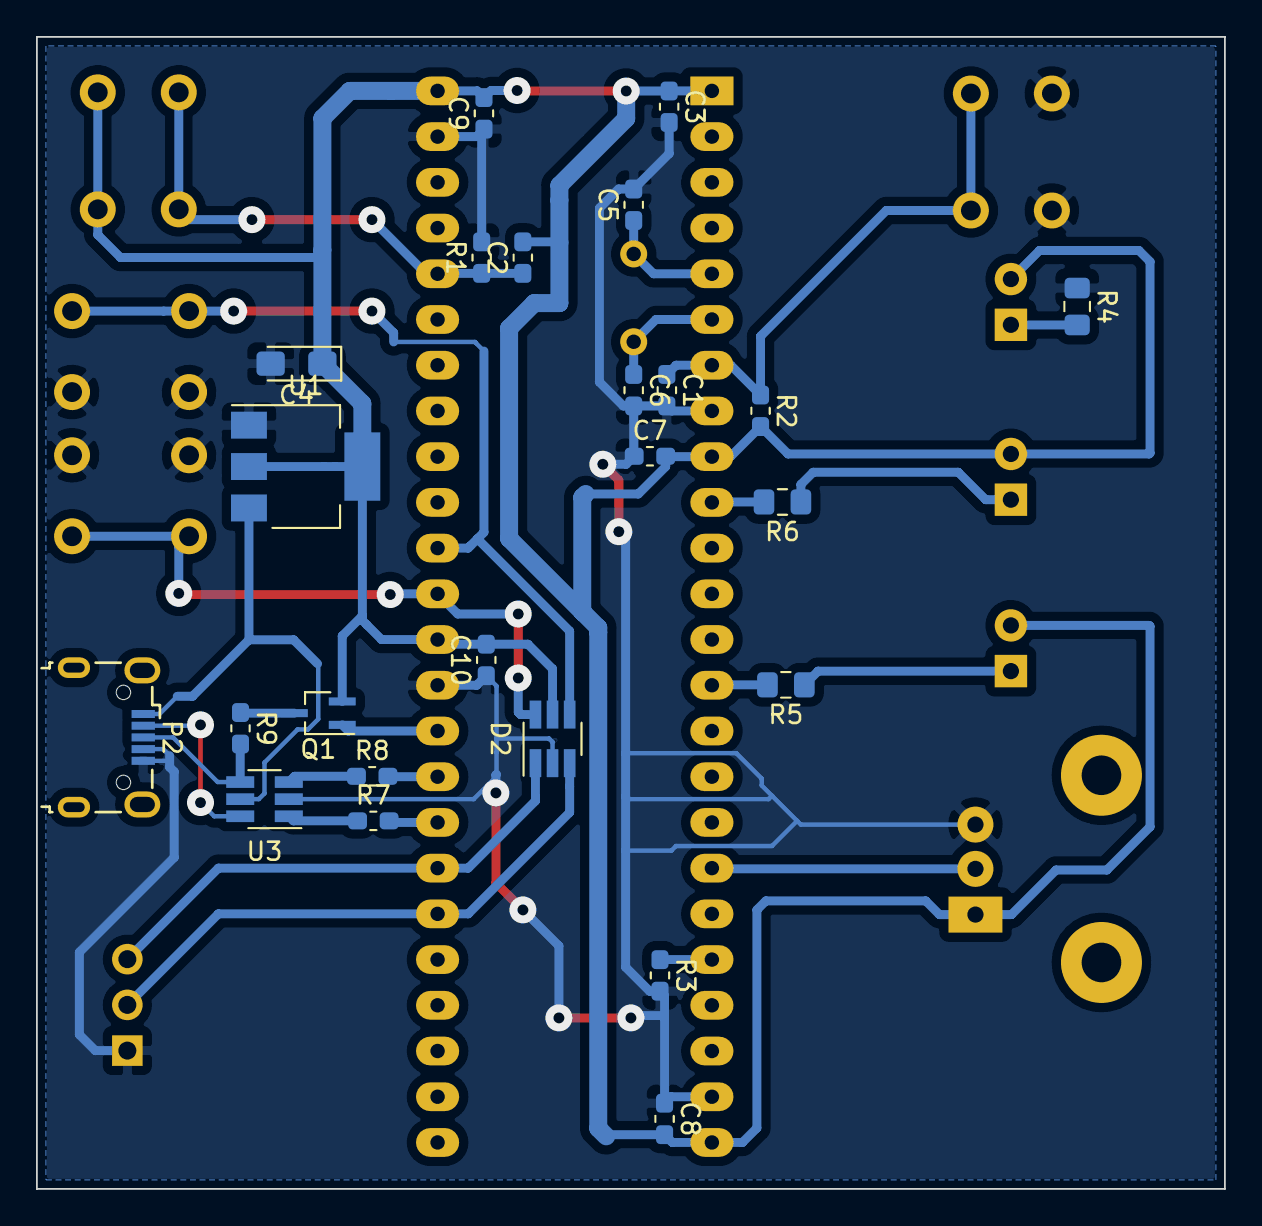
[picture p79: board testboard/F0_F1-LQFP48_testboard/stm32.kicad_pcb from below]

Board: 2 copper layers, 66.0 x 64.0 mm, 35 parts (24 on the bottom side), 26 nets.

Parts:
C1, C2, C3, C7, C8, C9, C10: 0.1; C_0603_1608Metric_Pad1.05x0.95mm_HandSolder
C4: 47u; CP_EIA-3216-18_Kemet-A_Pad1.58x1.35mm_HandSolder
C5, C6: 12; C_0603_1608Metric_Pad1.05x0.95mm_HandSolder
D1: LED; LED_D3.0mm
D2: IP4220CZ6; SOT-23-6_Handsoldering
D3, D4: LED; LED_D5.0mm
P1: USART1; PinHeader_1x03_P2.54mm_Vertical
P2: USB_B; USB_Micro-B_Wuerth_629105150521
Q1: DTA114Y; SOT-323_SC-70_Handsoldering
R1, R2: 10k; R_0603_1608Metric_Pad1.05x0.95mm_HandSolder
R3: 100k; R_0603_1608Metric_Pad1.05x0.95mm_HandSolder
R4, R5, R6: 220; R_0805_2012Metric_Pad1.15x1.40mm_HandSolder
R7, R8: 22; R_0603_1608Metric_Pad1.05x0.95mm_HandSolder
R9: 1k5; R_0603_1608Metric_Pad1.05x0.95mm_HandSolder
RV1: 10k; Potentiometer
SW1: Reset; SW_PUSH_6mm
SW2: Boot; SW_PUSH_6mm
SW3: Button0; SW_PUSH_6mm
SW4: Button1; SW_PUSH_6mm
U1: LM1117-3.3; SOT-223
U2: STM32F042C6Tx; DIP-48_W15.24mm_Socket_LongPads
U3: USBLC6-2SC6; SOT-23-6_Handsoldering
Y1: 8MHz; Crystal_HC49-U_Vertical

Connections:
+3V3: C2.2, C3.1, C4.1, C7.2, C8.2, C9.2, C10.2, D1.2, D2.5, D3.2, D4.2, Q1.2, R2.2, RV1.1, SW2.2, U1.2, U1.4, U2.1, U2.9, U2.24, U2.36, U2.48
+5V: P2.1, U1.3, U3.5
/BOOT0: C2.1, R1.1, SW2.1, U2.44
/Button0: D2.6, SW4.1, U2.37
/Button1: D2.4, SW3.1, U2.38
/LED0: R5.2, U2.14
/LED1: R6.2, U2.10
/NRST: C1.1, R2.1, SW1.1, U2.7
/OSC_IN: C5.1, U2.5, Y1.1
/OSC_OUT: C6.1, U2.6, Y1.2
/Rx: D2.1, P1.3, U2.31
/Tx: D2.3, P1.2, U2.30
/USB_PU: Q1.1, U2.34
GND: C1.2, C3.2, C4.2, C5.2, C6.2, C7.1, C8.1, C9.1, C10.1, D2.2, P1.1, P2.4, P2.5, R1.2, R3.2, R4.1, RV1.3, SW1.2, SW3.2, SW4.2, U1.1, U2.8, U2.23, U2.35, U2.47, U3.2
unnamed: D1.1, R4.2
unnamed: D3.1, R5.1
unnamed: D4.1, R6.1
unnamed: P2.2, U3.6
unnamed: P2.3, R9.2, U3.4
unnamed: Q1.3, R9.1
unnamed: R3.1, U2.20
unnamed: R7.1, U3.1
unnamed: R7.2, U2.32
unnamed: R8.1, U3.3
unnamed: R8.2, U2.33
unnamed: RV1.2, U2.18
