eddyem/stm32samples/F1/Timelapse_keyboard/kicad/diff_schematics.kicad_pcb

## KiCad design F1/Timelapse_keyboard/kicad/diff_schematics.kicad_pcb (2015-09-14)

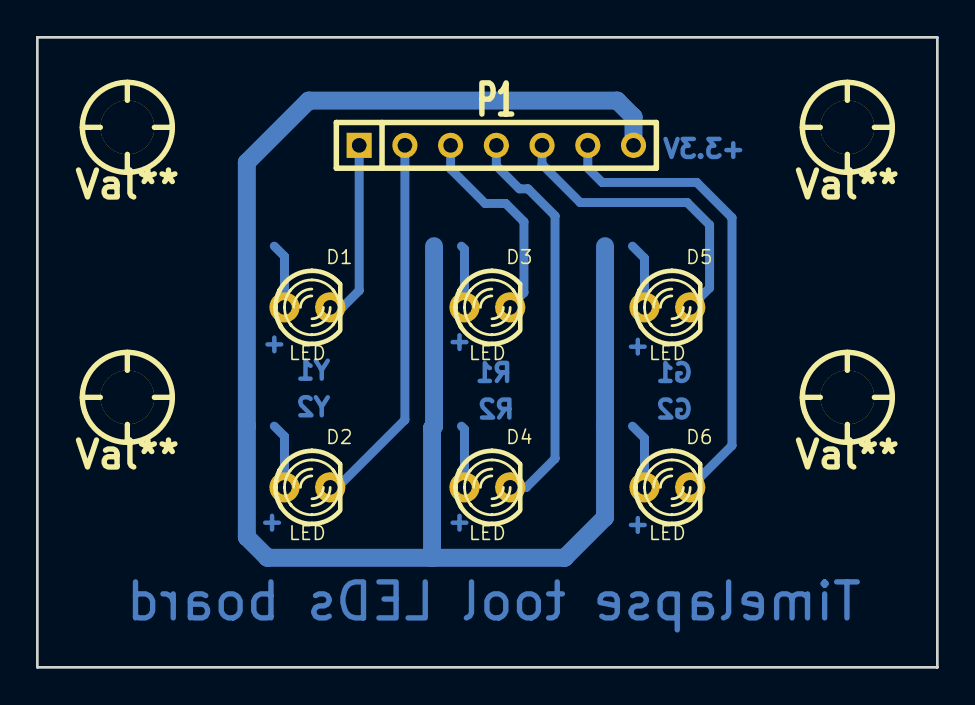
[picture p80: board diff_schematics.kicad_pcb from above]

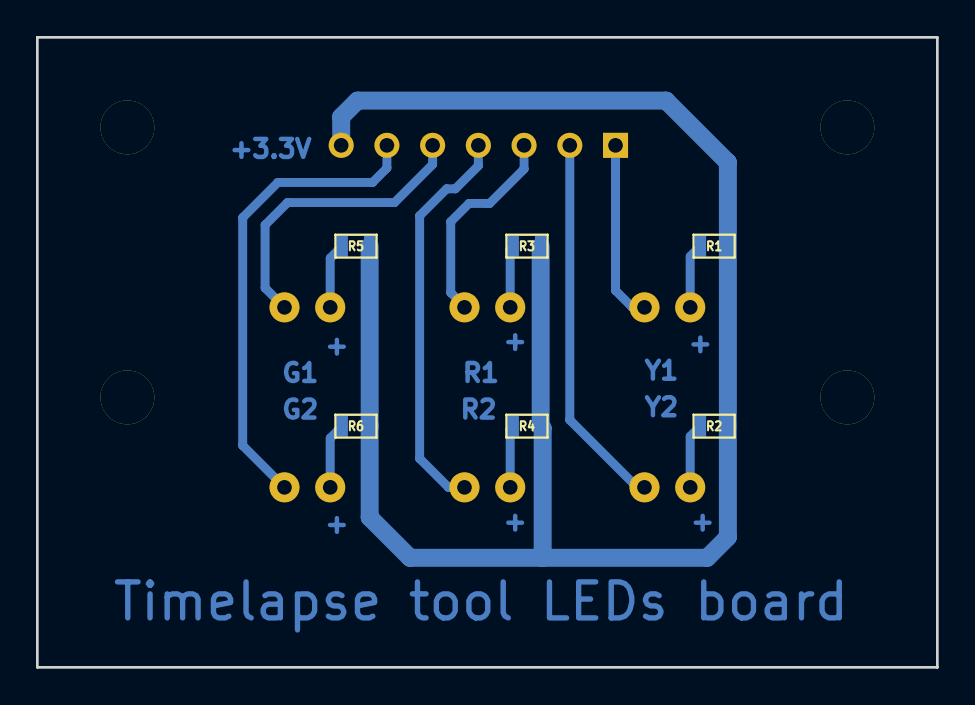
[picture p81: board diff_schematics.kicad_pcb from below]

Board: 2 copper layers, 50.0 x 35.0 mm, 17 parts (6 on the bottom side), 13 nets.

Parts:
D1, D2, D3, D4, D5, D6: LED; LED-3MM
P1: CONN_7; SIL-7
R1, R2, R3, R4, R5, R6: 100; SM0603
hole_3mm, hole_3mm#2, hole_3mm#3, hole_3mm#4: Val**; hole_3mm

Connections:
/+3.3V: P1.7, R1.1, R2.1, R3.1, R4.1, R5.1, R6.1
/G1: D5.2, P1.5
/G2: D6.2, P1.6
/R1: D3.2, P1.3
/R2: D4.2, P1.4
/Y1: D1.2, P1.1
/Y2: D2.2, P1.2
unnamed: D2.1, R2.2
unnamed: D3.1, R3.2
unnamed: D1.1, R1.2
unnamed: D4.1, R4.2
unnamed: D5.1, R5.2
unnamed: D6.1, R6.2
